vintagepc/MK404/SDCard/Readme.md

 Place gcode files in this folder and run the build_sd utility step in the CMake project to compile an SD card image for your printer!
