vintagepc/MK404/scripts/tests/snaps/parts/GFX3DVis01.png

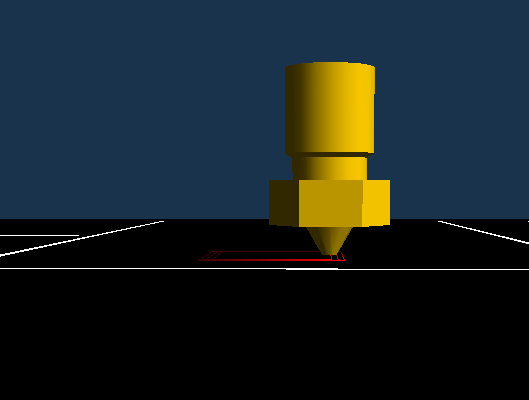
scripts/tests/snaps/parts/GFX3DVis01.png
