vintagepc/MK404/scripts/tests/snaps/parts/GFX3DVis04.png

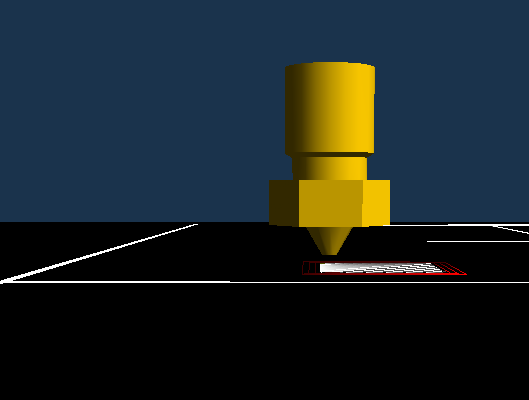
scripts/tests/snaps/parts/GFX3DVis04.png
