vintagepc/MK404/scripts/tests/snaps/parts/LCD01.png

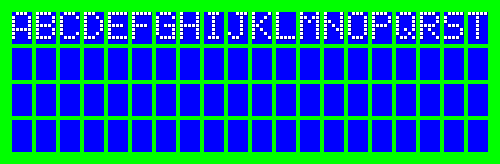
scripts/tests/snaps/parts/LCD01.png
