vintagepc/MK404/scripts/tests/snaps/parts/LCD02.png

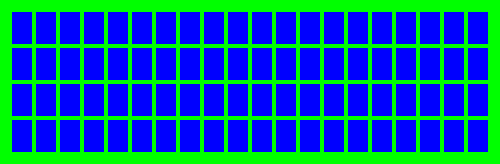
scripts/tests/snaps/parts/LCD02.png
