vintagepc/MK404/scripts/tests/snaps/parts/LCD03.png

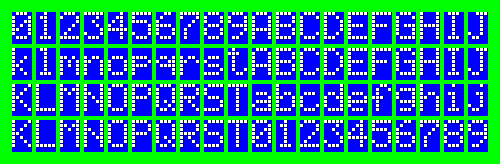
scripts/tests/snaps/parts/LCD03.png
