vintagepc/MK404/scripts/tests/snaps/parts/LCD04.png

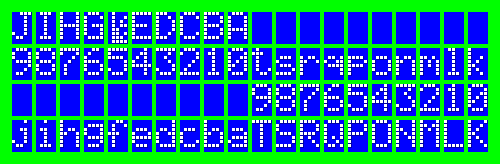
scripts/tests/snaps/parts/LCD04.png
