vintagepc/MK404/assets/Bear/bear21_mk3s_simulator_x-axis.obj

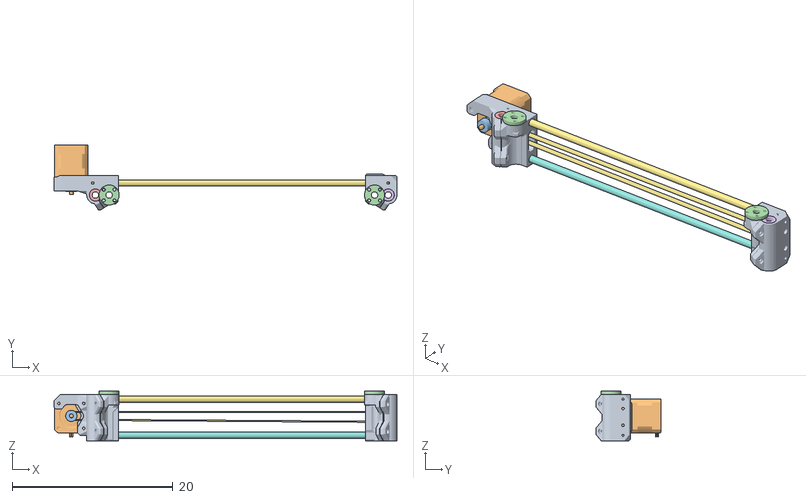
[picture p8: CAD file, 2020-08-02]
assets/Bear/bear21_mk3s_simulator_x-axis.obj
42.6 x 8.14 x 6.20
x_end_motor_mk3s:1
nema17_xye_ldo v1:1
2gt_pulley_16t v1:1
pom_nut v1:1
lm8uu v2:1
lm8uu v2:2
smooth_rod_x_axis v1:5
smooth_rod_x_axis v1:6
x_end_idler:1
x_end_idler_tensioner:1
2gt_idler_20t_6mmbelt v2:1
pom_nut v1:2
lm8uu v2:3
lm8uu v2:4
belt:1
