vintagepc/MK404/assets/CW1/CW1_Lid.obj

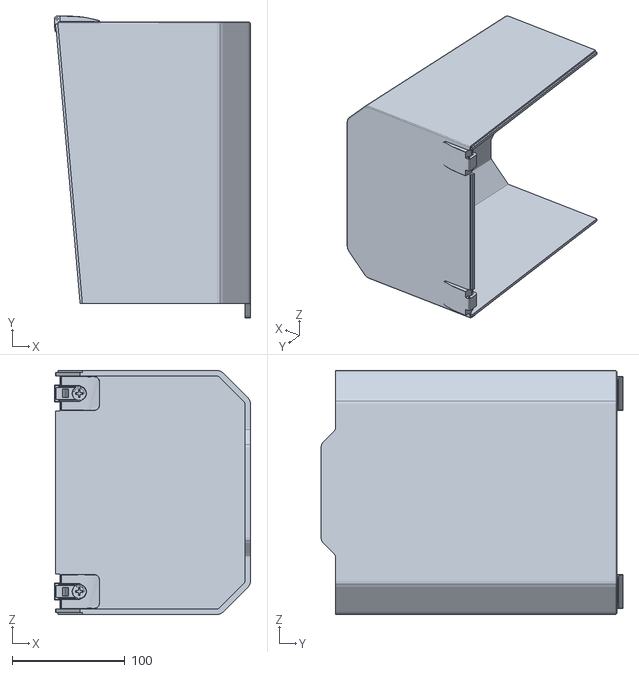
[picture p9: CAD file, 2021-11-05]
assets/CW1/CW1_Lid.obj
174.4 x 268.2 x 217.0
