vintagepc/MK404/assets/MK2/MK2_Y.obj

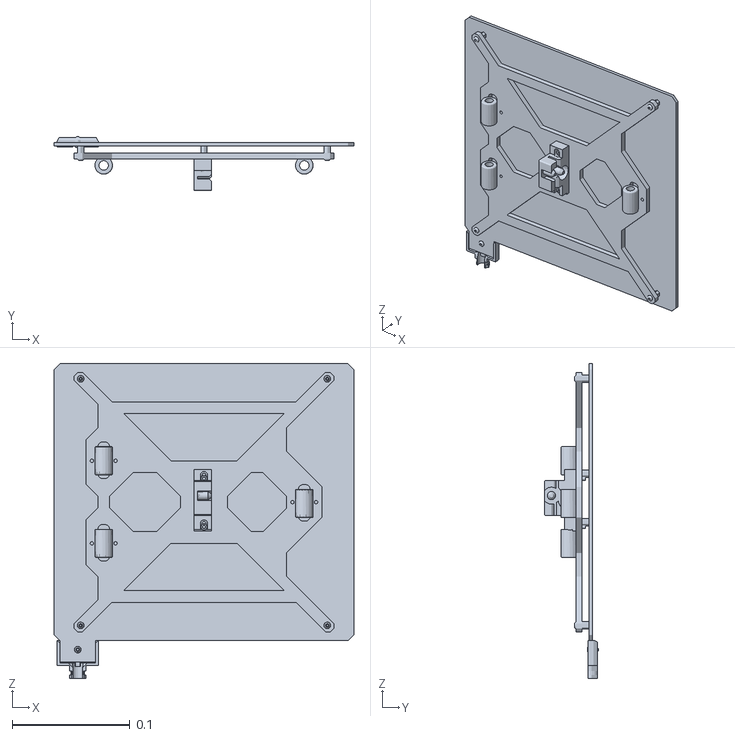
[picture p10: CAD file, 2020-10-29]
assets/MK2/MK2_Y.obj
0.254 x 0.046 x 0.267
