vintagepc/MK404/assets/Stock/Y_AXIS.obj

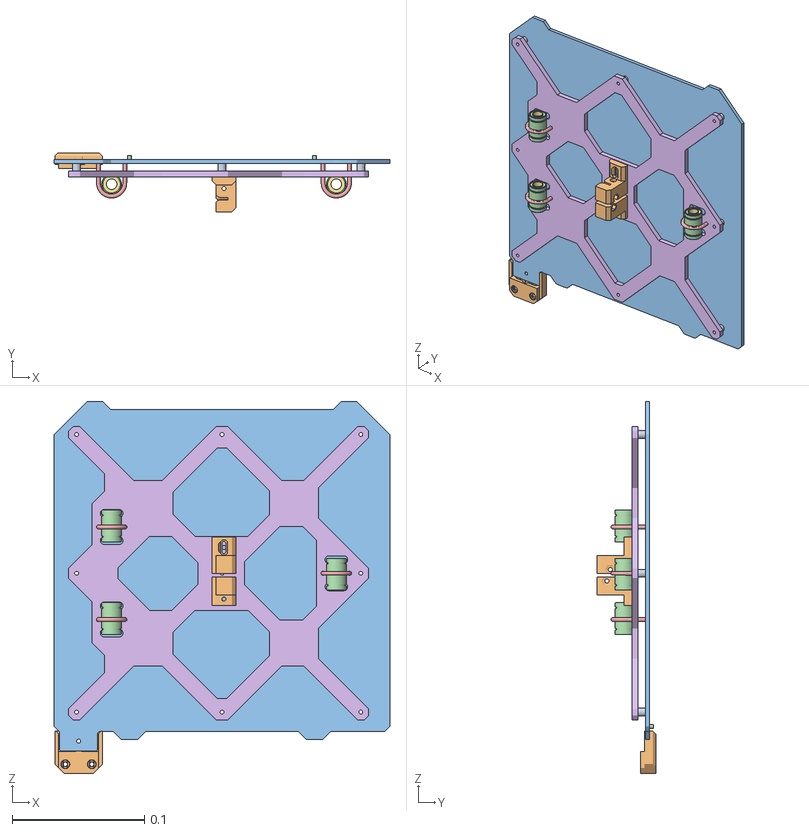
[picture p11: CAD file, 2020-05-23]
assets/Stock/Y_AXIS.obj
0.254 x 0.0443 x 0.281
mesh 1 Headbed Assembly-1/6x6x3t spacer-4
mesh 2 Headbed Assembly-1/6x6x3t spacer-1
mesh 3 Headbed Assembly-1/heatbed-cable-cover top-1
mesh 4 Headbed Assembly-1/6x6x3t spacer-3
mesh 5 Headbed Assembly-1/MK52 Bed-1
mesh 6 Boss-Extrude3
mesh 7 Headbed Assembly-1/6x6x3t spacer-2
