vintagepc/MK404/scripts/tests/snaps/parts/AvgT.ply

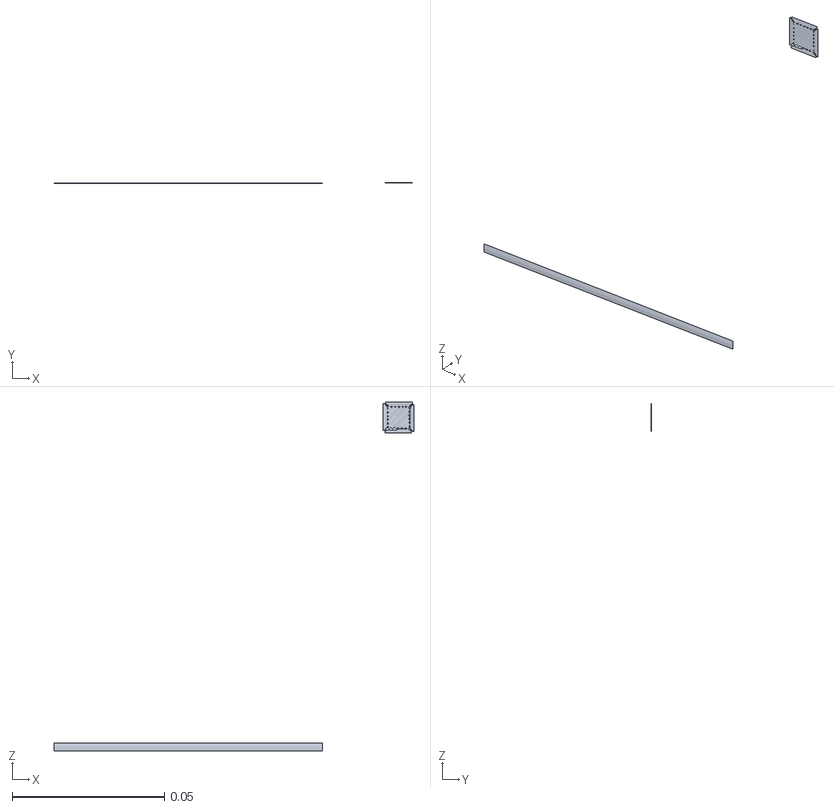
[picture p12: CAD file, 2020-10-20]
scripts/tests/snaps/parts/AvgT.ply
0.118 x 0.00025 x 0.114
