vintagepc/MK404/assets/Bear/bear21_mk3s_simulator_e-axis.obj

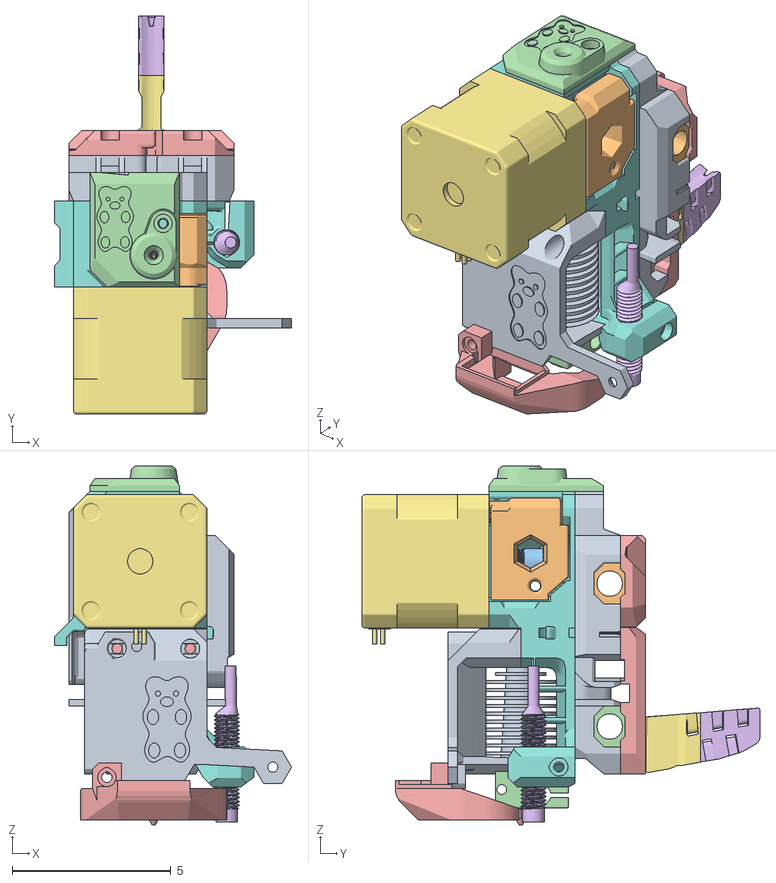
[picture p13: CAD file, 2020-08-02]
assets/Bear/bear21_mk3s_simulator_e-axis.obj
7.46 x 12.5 x 11.3
x_carriage:1
lm8uu v2:1
lm8uu v2:2
lm8uu v2:3
x_carriage_back_mk3s v2:1
cable_guide_back_b:1
cable_guide_back_a:1
sink:1
ptfe:1
break:1
block:1
nozzle:1
Spur Gear11:1
nema17_ldo_cool_power v1:1
hotend_collet_clip v1:1
cover:1
extruder_idler_bondtech:1
Spur Gear21:1
fs_cover v2:2
nozzle_fan_duct:1
pinda v1:2
