vintagepc/MK404/assets/CW1/CW1_RFan.obj

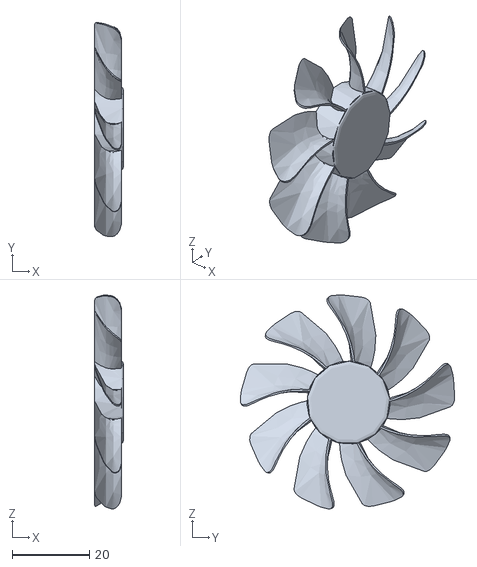
[picture p14: CAD file, 2021-11-05]
assets/CW1/CW1_RFan.obj
7.50 x 55.4 x 55.3
