vintagepc/MK404/assets/MK2/MK2MMU_E.obj

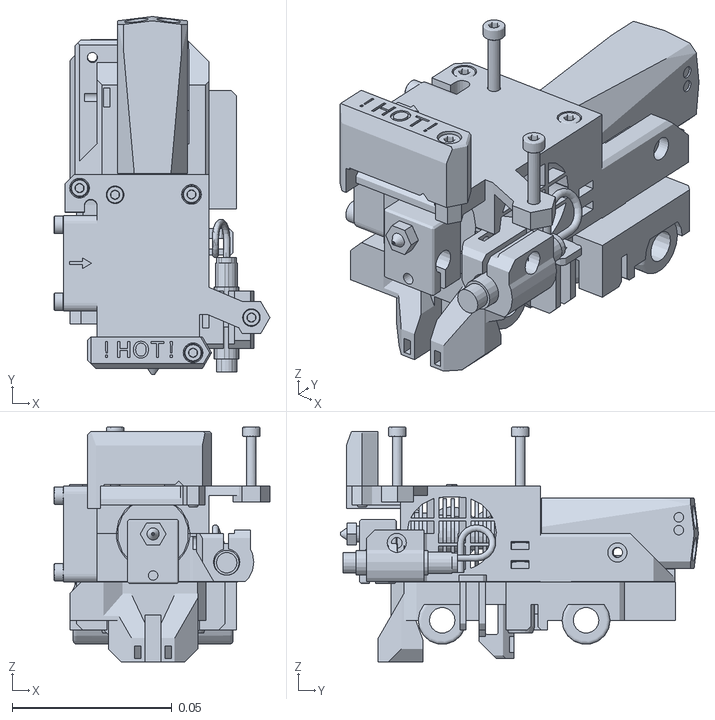
[picture p15: CAD file, 2020-10-29]
assets/MK2/MK2MMU_E.obj
0.0676 x 0.112 x 0.0734
