vintagepc/MK404/assets/Stock/E_STD.obj

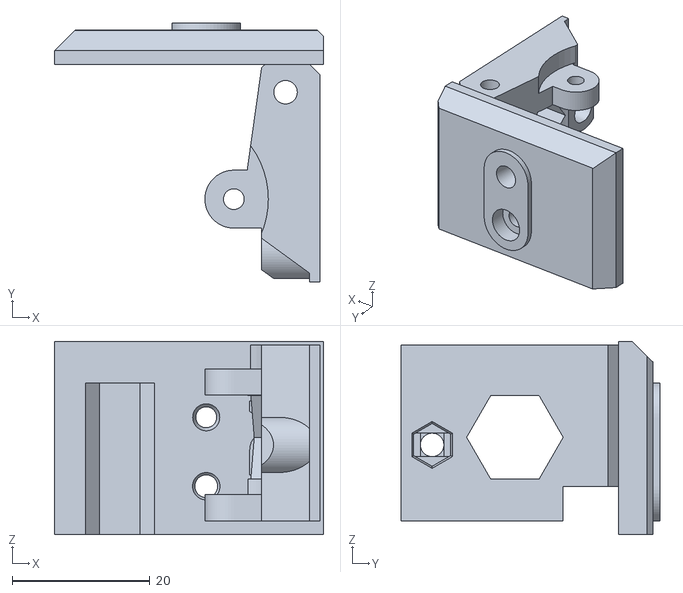
[picture p16: CAD file, 2020-05-23]
assets/Stock/E_STD.obj
39.0 x 37.5 x 28.0
