vintagepc/MK404/scripts/tests/snaps/parts/QuadHR.ply

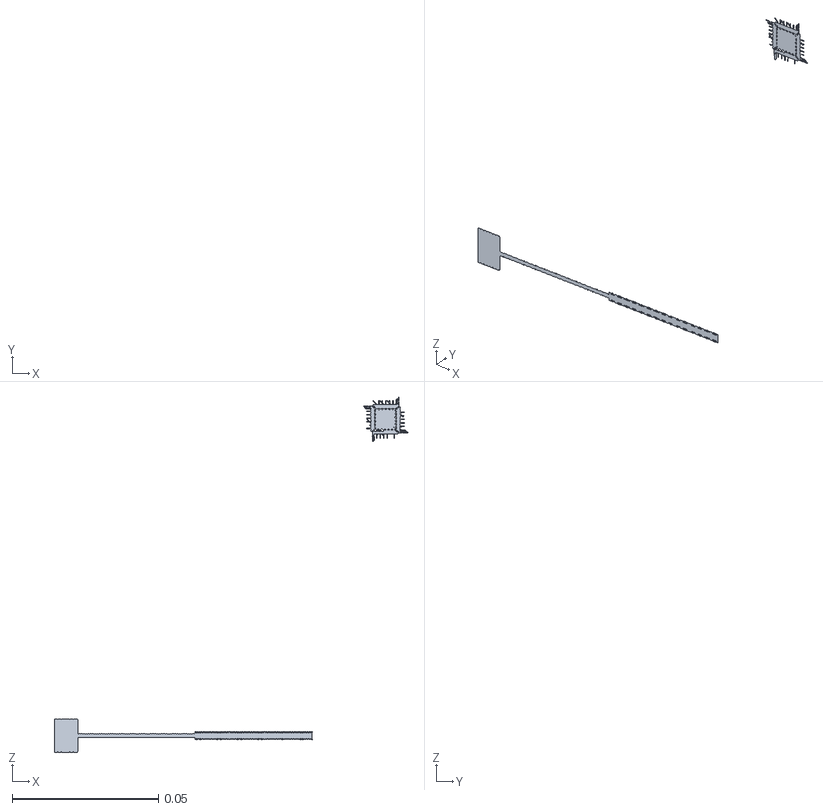
[picture p17: CAD file, 2020-10-20]
scripts/tests/snaps/parts/QuadHR.ply
0.121 x 5e-05 x 0.121
