vintagepc/MK404/assets/Bear/bear21_mk3s_simulator_lcd_knob.obj

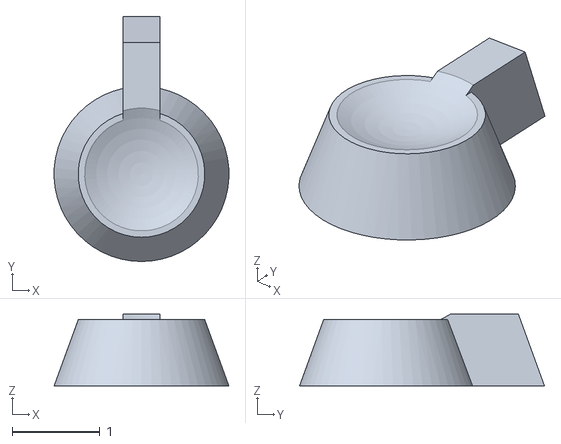
[picture p18: CAD file, 2020-08-02]
assets/Bear/bear21_mk3s_simulator_lcd_knob.obj
2.00 x 2.80 x 0.82
