vintagepc/MK404/assets/CW1/CW1_Tank.obj

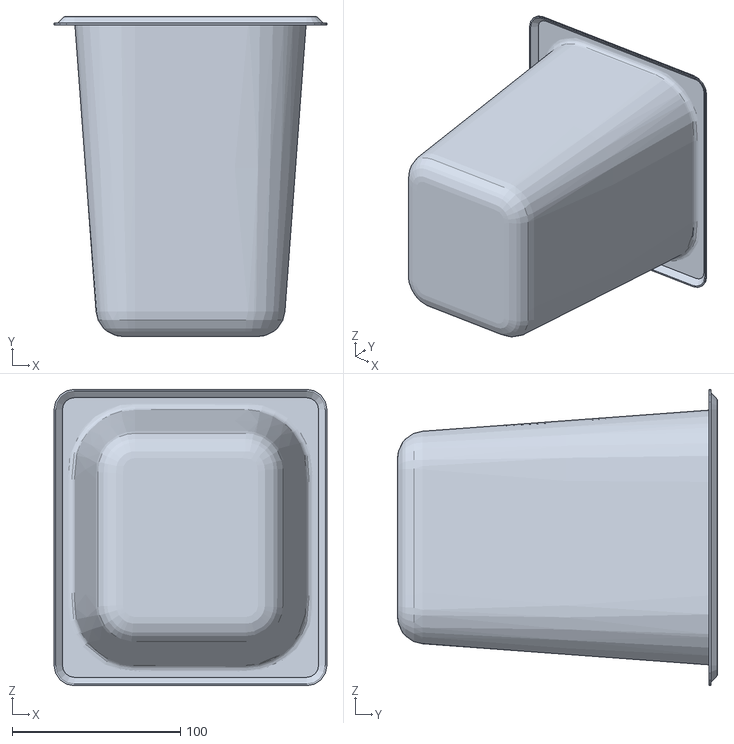
[picture p19: CAD file, 2021-11-05]
assets/CW1/CW1_Tank.obj
162.0 x 190.0 x 176.0
