vintagepc/MK404/assets/MK2/MK2_EFan.obj

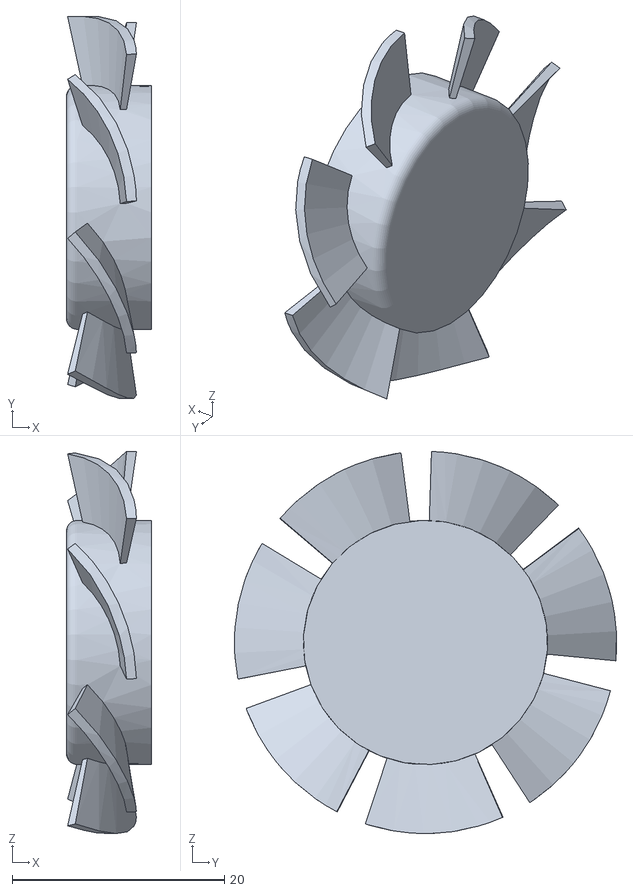
[picture p20: CAD file, 2020-10-29]
assets/MK2/MK2_EFan.obj
8.00 x 36.0 x 36.0
