vintagepc/MK404/assets/Stock/Triangles.obj

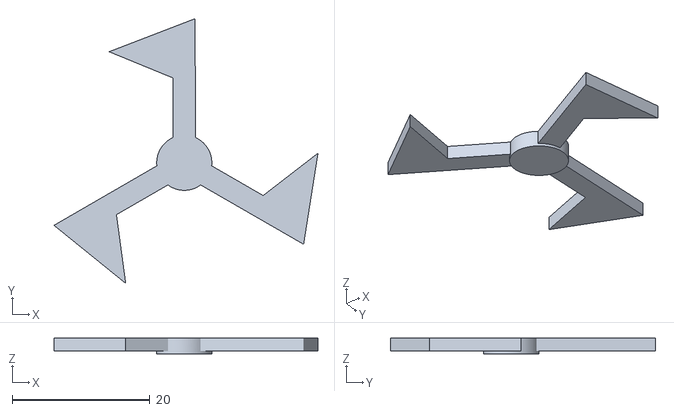
[picture p21: CAD file, 2020-05-23]
assets/Stock/Triangles.obj
38.3 x 38.4 x 2.30
