vintagepc/MK404/assets/MK2/MK2_Base.obj

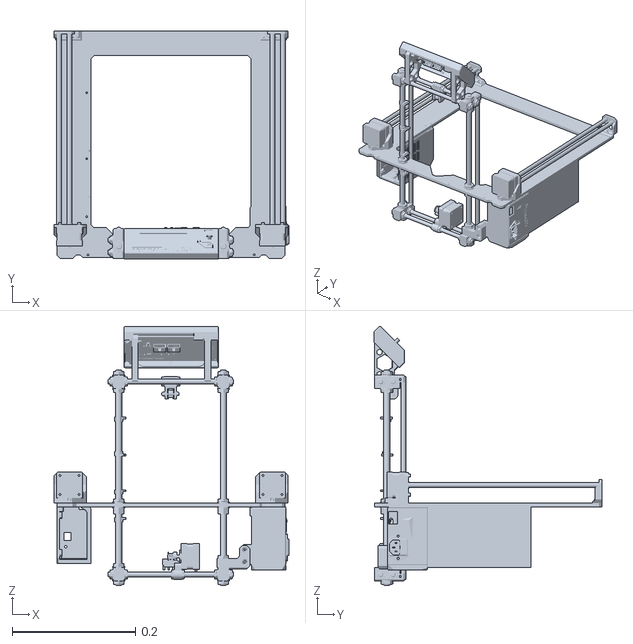
[picture p23: CAD file, 2020-10-29]
assets/MK2/MK2_Base.obj
0.382 x 0.371 x 0.421
