vintagepc/MK404/assets/Stock/SDCard.obj

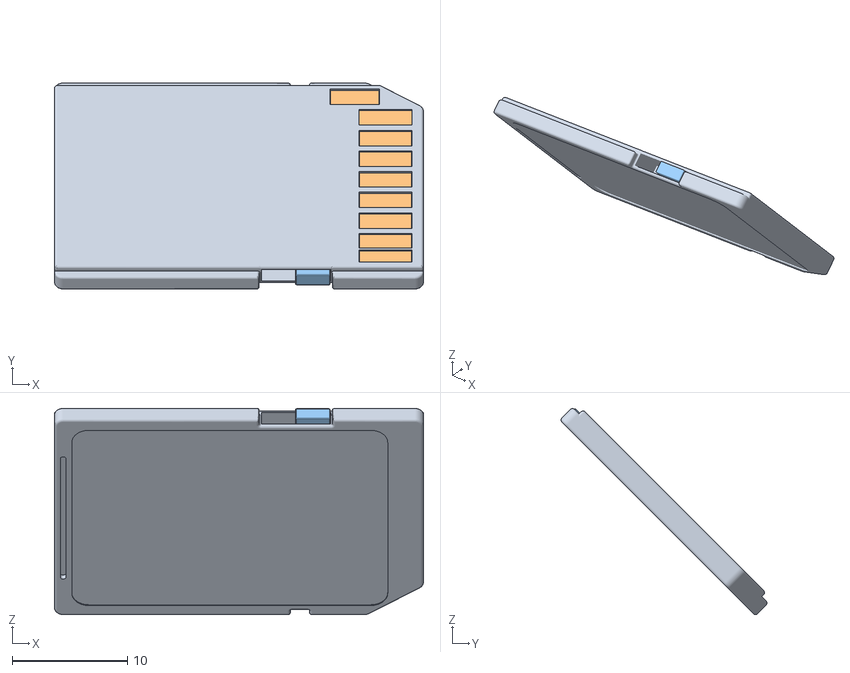
[picture p24: CAD file, 2020-05-23]
assets/Stock/SDCard.obj
32.0 x 17.9 x 17.9
patch0
patch1
patch2
