vintagepc/MK404/assets/Bear/bear21_mk3s_simulator_hotend-fan-blade.obj

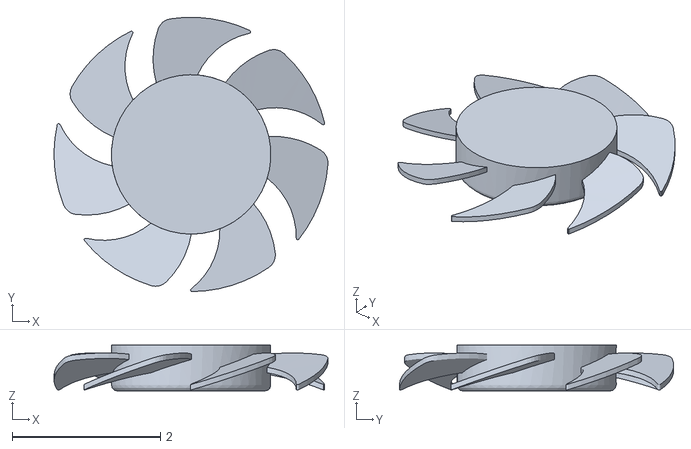
[picture p25: CAD file, 2020-08-02]
assets/Bear/bear21_mk3s_simulator_hotend-fan-blade.obj
3.70 x 3.70 x 0.62
