vintagepc/MK404/assets/CW1/CW1_LEDs.obj

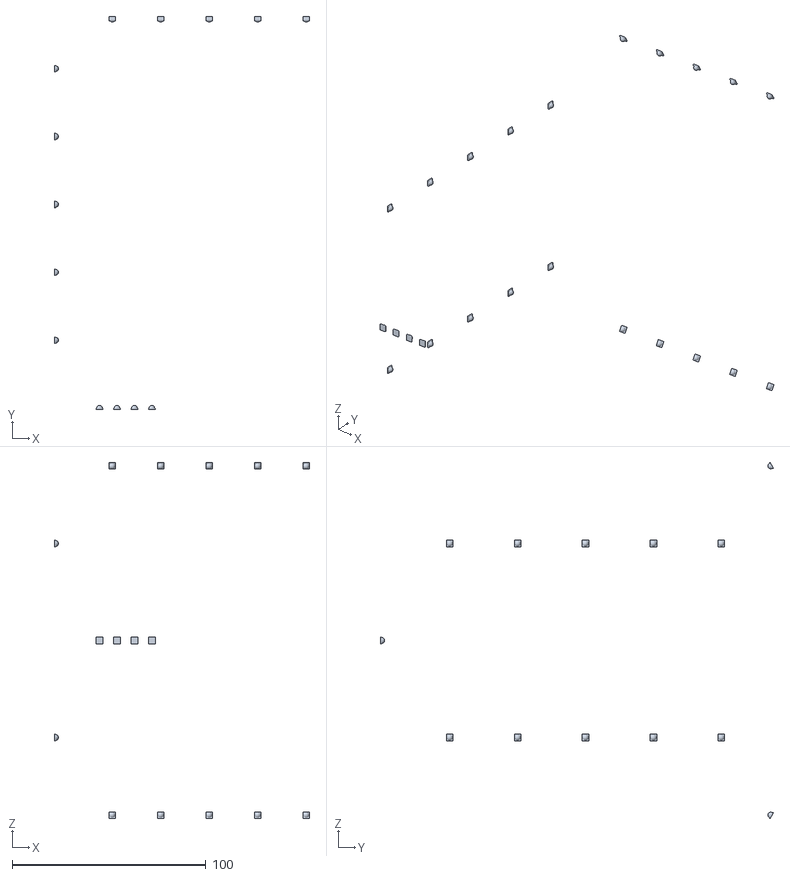
[picture p26: CAD file, 2021-11-05]
assets/CW1/CW1_LEDs.obj
131.6 x 202.6 x 183.5
