vintagepc/MK404/assets/MK2/MK2_E.obj

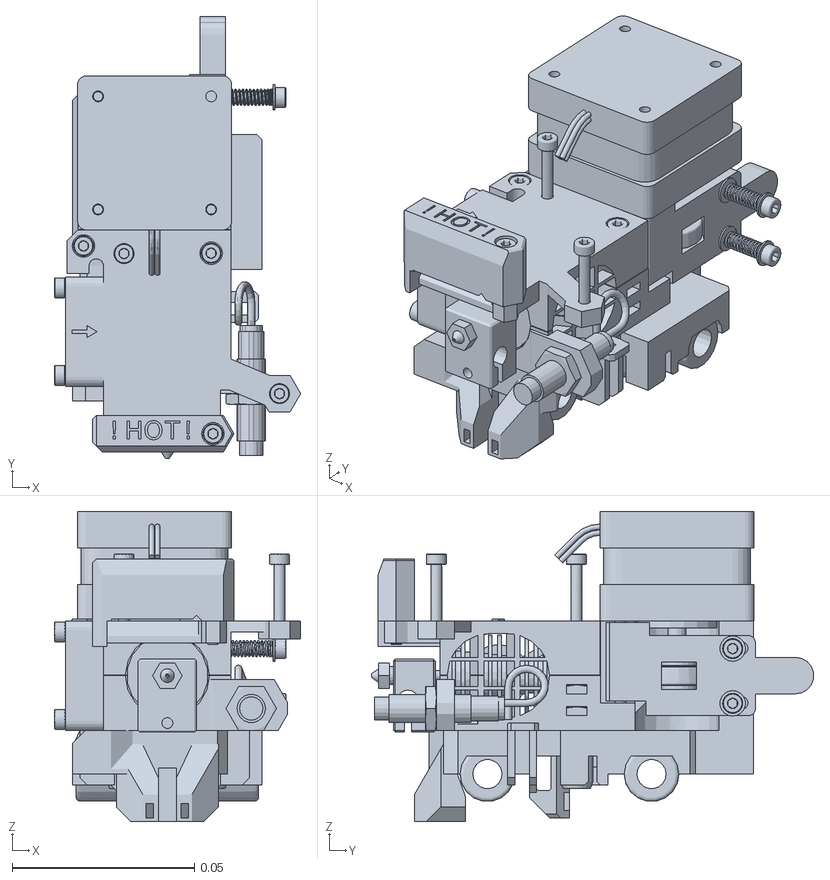
[picture p27: CAD file, 2020-10-29]
assets/MK2/MK2_E.obj
0.0676 x 0.121 x 0.085
