vintagepc/MK404/assets/Stock/Print-fan_rotor.obj

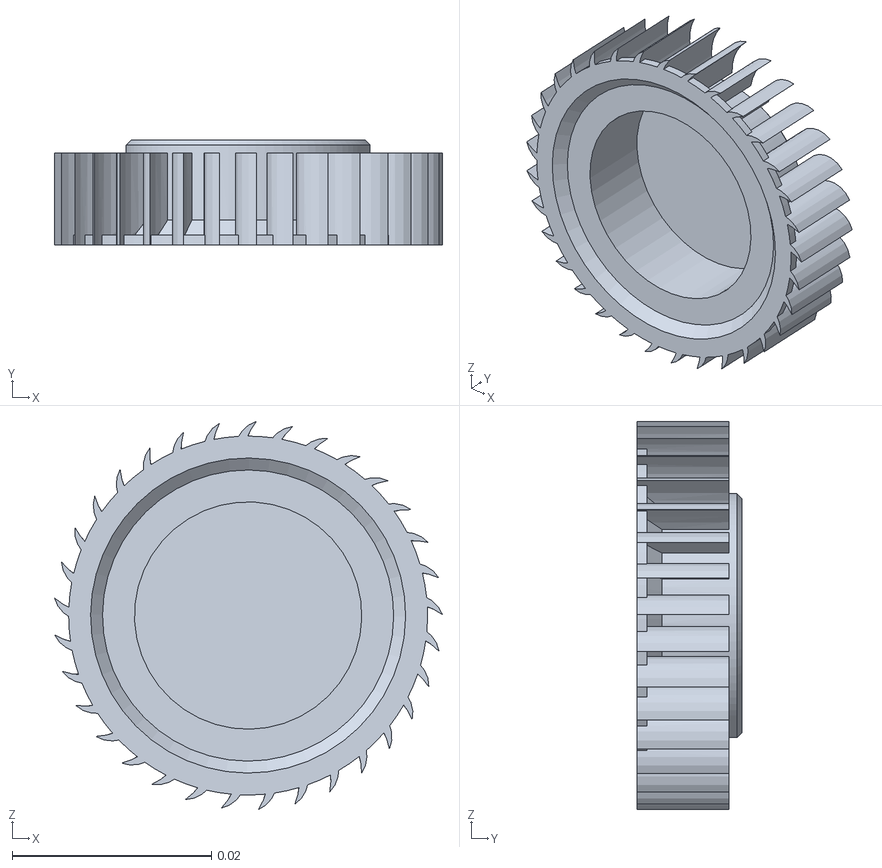
[picture p28: CAD file, 2020-05-23]
assets/Stock/Print-fan_rotor.obj
0.0389 x 0.0105 x 0.039
