vintagepc/MK404/assets/Bear/bear21_mk3s_simulator_y-axis.obj

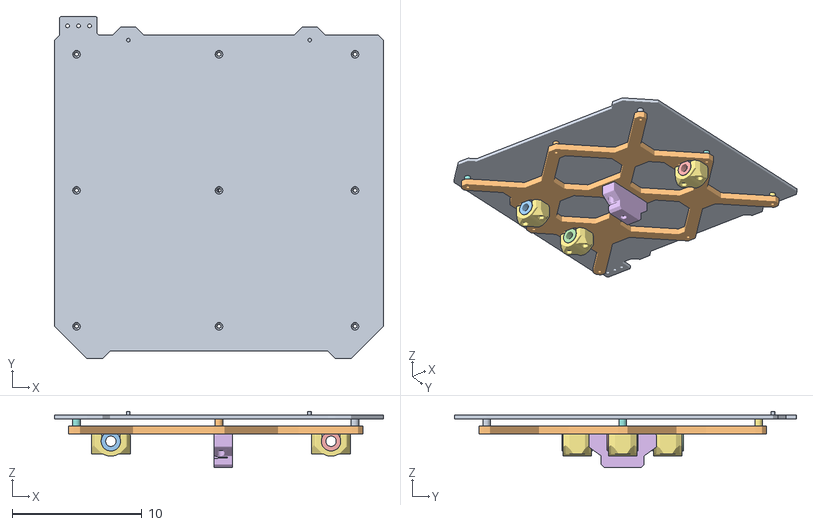
[picture p29: CAD file, 2020-08-02]
assets/Bear/bear21_mk3s_simulator_y-axis.obj
25.4 x 26.4 x 4.35
heatbed_mk52_24v v1:1
y_carriage_mk3 v2:1
lm8uu v2:1
lm8uu v2:2
lm8uu v2:3
y_belt_holder:1
y_bearing_holder:1
bed_standoff_mk3 v1:1
bed_standoff_mk3 v1:2
bed_standoff_mk3 v1:3
bed_standoff_mk3 v1:4
bed_standoff_mk3 v1:5
bed_standoff_mk3 v1:6
bed_standoff_mk3 v1:7
bed_standoff_mk3 v1:8
bed_standoff_mk3 v1:9
