vintagepc/MK404/assets/CW1/CW1S_Platform.obj

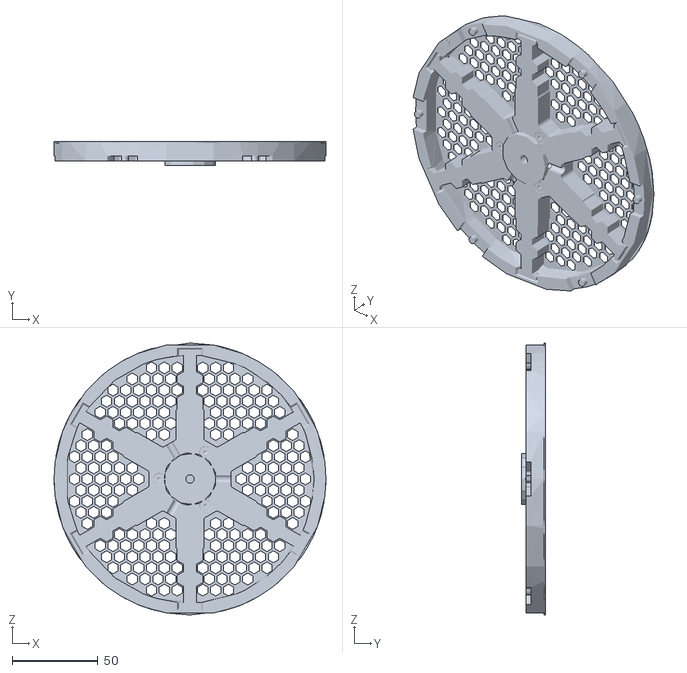
[picture p30: CAD file, 2021-11-05]
assets/CW1/CW1S_Platform.obj
159.0 x 14.0 x 159.0
