vintagepc/MK404/assets/MK2/MK2MMU_Base.obj

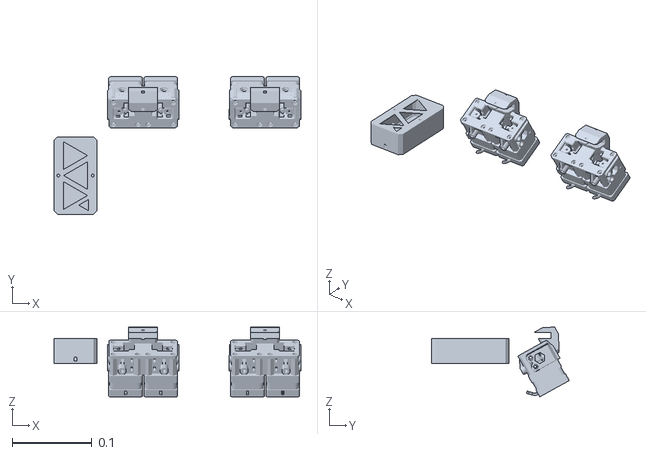
[picture p31: CAD file, 2020-10-29]
assets/MK2/MK2MMU_Base.obj
0.309 x 0.172 x 0.0873
