vintagepc/MK404/assets/Stock/E_MMU.obj

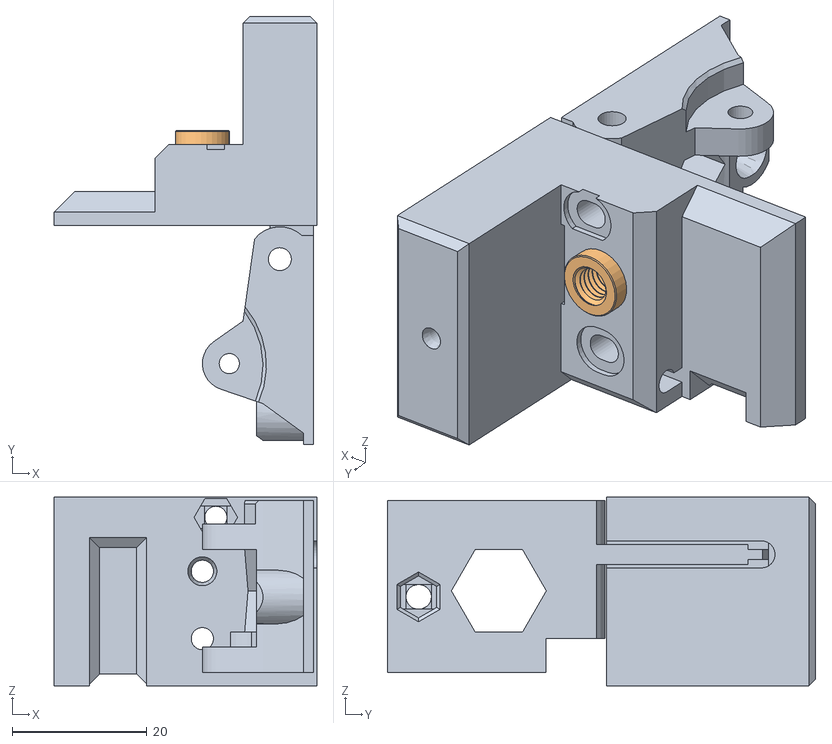
[picture p32: CAD file, 2020-05-23]
assets/Stock/E_MMU.obj
39.0 x 63.5 x 28.0
patch0
patch1
