vintagepc/MK404/assets/Bear/bear21_mk3s_simulator_print_fan.obj

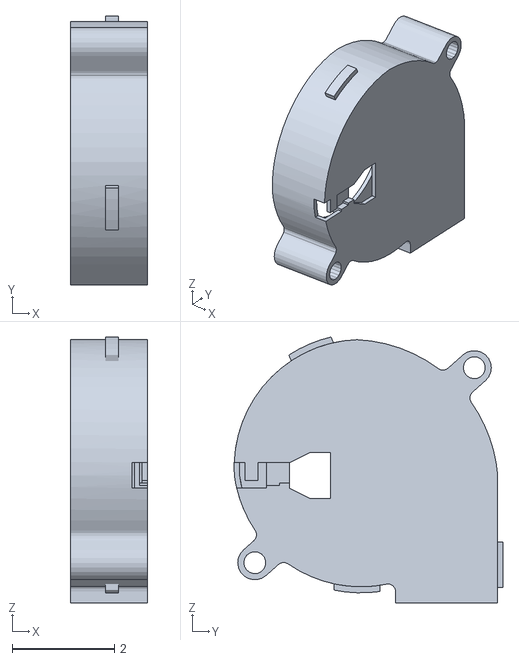
[picture p33: CAD file, 2020-08-02]
assets/Bear/bear21_mk3s_simulator_print_fan.obj
1.50 x 5.26 x 5.21
