vintagepc/MK404/assets/CW1/CW1_Knob.obj

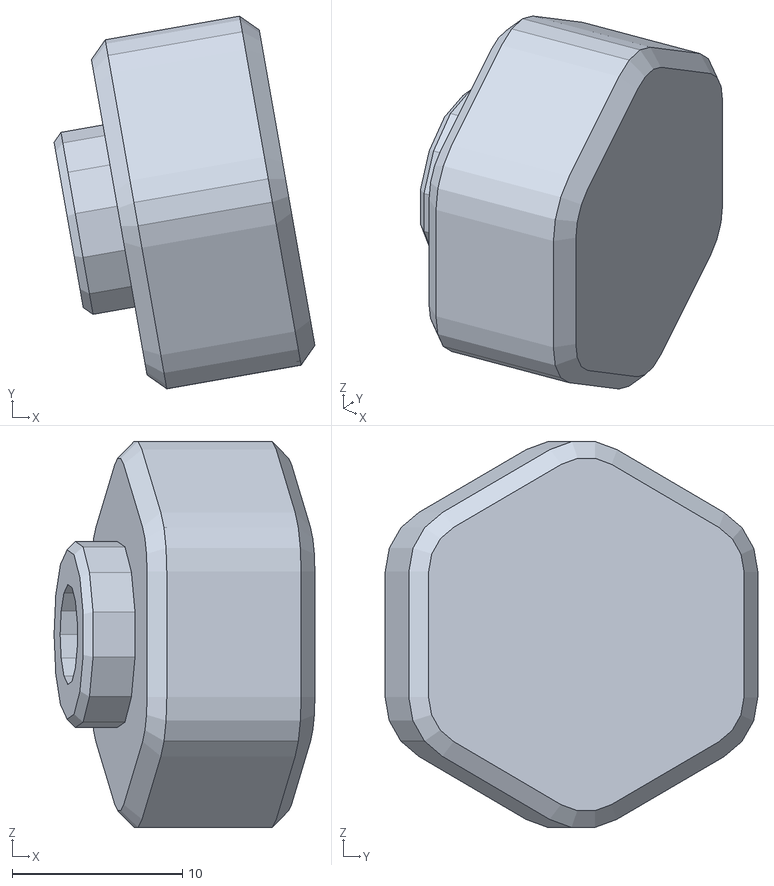
[picture p34: CAD file, 2021-11-05]
assets/CW1/CW1_Knob.obj
15.3 x 21.9 x 22.6
