vintagepc/MK404/assets/MK2/MK2_Z.obj

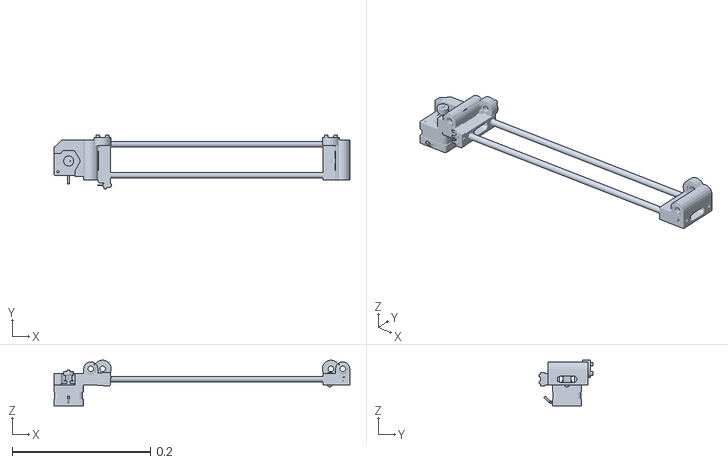
[picture p35: CAD file, 2020-10-29]
assets/MK2/MK2_Z.obj
0.428 x 0.0774 x 0.0661
