vintagepc/MK404/assets/Stock/LCD-knobR2.obj

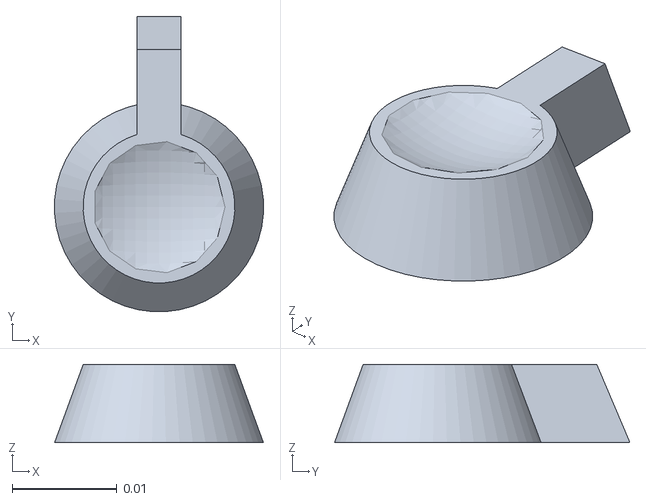
[picture p36: CAD file, 2020-05-23]
assets/Stock/LCD-knobR2.obj
0.02 x 0.0282 x 0.0075
