vintagepc/MK404/assets/Bear/bear21_mk3s_simulator_frame.obj

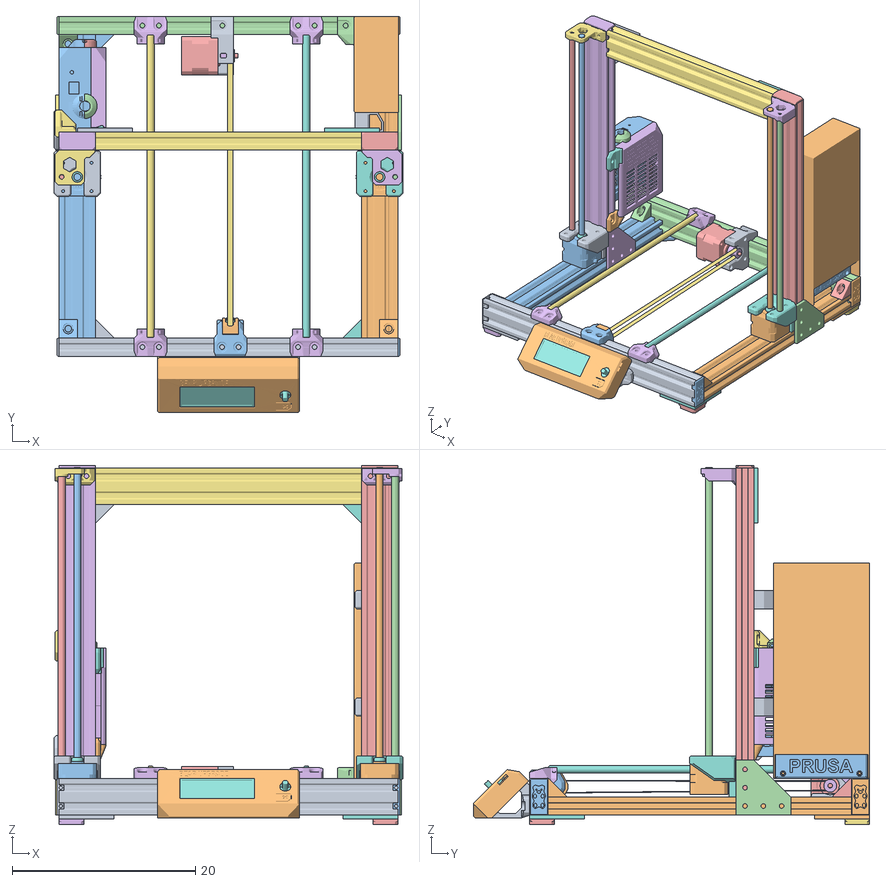
[picture p37: CAD file, 2020-08-02]
assets/Bear/bear21_mk3s_simulator_frame.obj
38.1 x 43.2 x 39.2
vslot_front_rear v2:1
vslot_y v2:1
vslot_y v2:2
vslot_front_rear v2:2
vslot_z v2:1
vslot_z v2:2
vslot_z_top v2:1
Joining Plate 90 Degree v2:1
Joining Plate 90 Degree v2:2
Joining Plate 90 Degree v2:3
Joining Plate 90 Degree v2:4
Joining Plate 90 Degree v2:5
Joining Plate 90 Degree v2:6
Joining Plate 90 Degree v2:7
Joining Plate 90 Degree v2:8
Joining Plate 90 Degree v2:9
Joining Plate 90 Degree v2:10
Black Angle Corner Connector v2:1
Black Angle Corner Connector v2:2
Black Angle Corner Connector v2:3
Black Angle Corner Connector v2:4
y_rod_holder:1
y_rod v1:1
y_rod v1:2
y_motor_mount:1
y_idler_tensioner:1
y_idler_mount:1
2gt_idler_20t_6mmbelt v2:1
nema17_ldo_xye v1:1
2gt_pulley_16t_6mmbelt v1:1
y_belt:1
z_motor_mount:1
z_motor_mount(Mirror) (1):1
nema17_ldo_z v1:1
nema17_ldo_z v1:2
z_rod v1:1
z_rod v1:2
z_top v1:1
z_top v1(Mirror):1
z_leadscrew_cap:1
rambo_base_lower_mount:1
rambo_hinge_lower:1
einsy-base v7:1
Extruder-cable-clip v2:1
Heatbed-cable-clip v2:1
rambo_door_mk3 v1:1
rambo_base_upper_mount:1
rambo_hinge_upper:1
psu_upper_mount_black:1
psu_mk3s_delta v1:1
psu-cover-DELTA v1:1
psu_lower_mount_black:1
foot v1:1
foot v1:2
foot v1:3
foot v1:4
y_end_cap v1:1
y_end_cap v1:2
end_cap v1(Mirror):1
end_cap v1(Mirror) (1):1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
