vintagepc/MK404/assets/Stock/SSSheet.obj

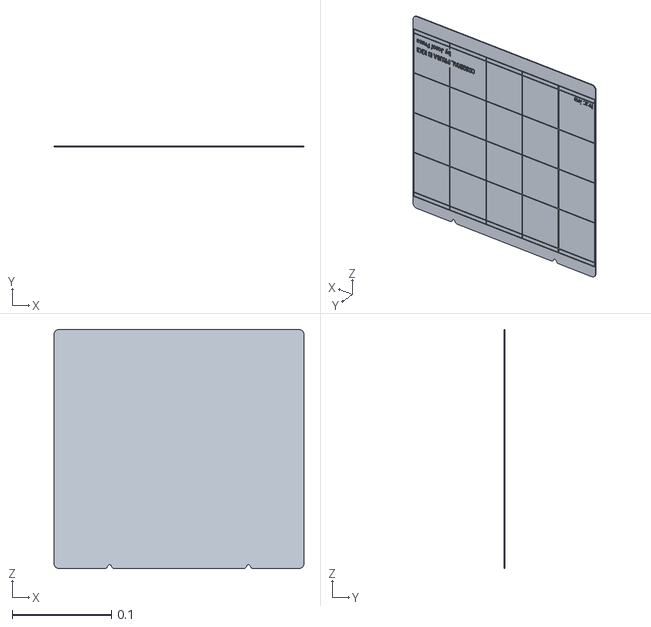
[picture p38: CAD file, 2020-05-23]
assets/Stock/SSSheet.obj
0.252 x 0.00101 x 0.241
mesh 1 SS Sheet
mesh 2 Boss-Extrude2
