vintagepc/MK404/(list of files, cad)

Other CAD files:
assets/CW1/CW1_HFan.obj
assets/Stock/E_Fan.obj
