vintagepc/MK404/scripts/test_E_maxtemp.txt

# This script tests the MAXTEMP error if a thermistor is shorted.
ScriptHost::SetQuitOnTimeout(1)
Board::WaitMs(5000)
ScriptHost::SetTimeoutMs(2000)
Thermistor::Short()
LCD::WaitForText(MAXTEMP,3)
Board::Quit()
