vintagepc/MK404/scripts/tests/snaps/ext1/CW1_cure.png

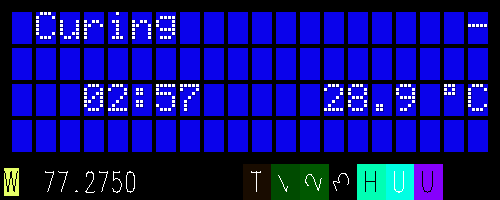
scripts/tests/snaps/ext1/CW1_cure.png
