vintagepc/MK404/scripts/tests/snaps/ext1/CW1_down.png

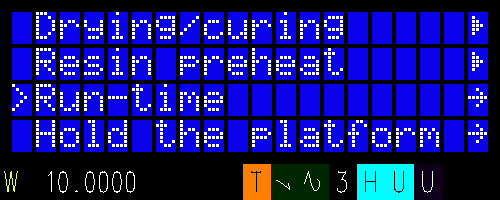
scripts/tests/snaps/ext1/CW1_down.png
