vintagepc/MK404/scripts/tests/snaps/ext1/CW1_full_led.png

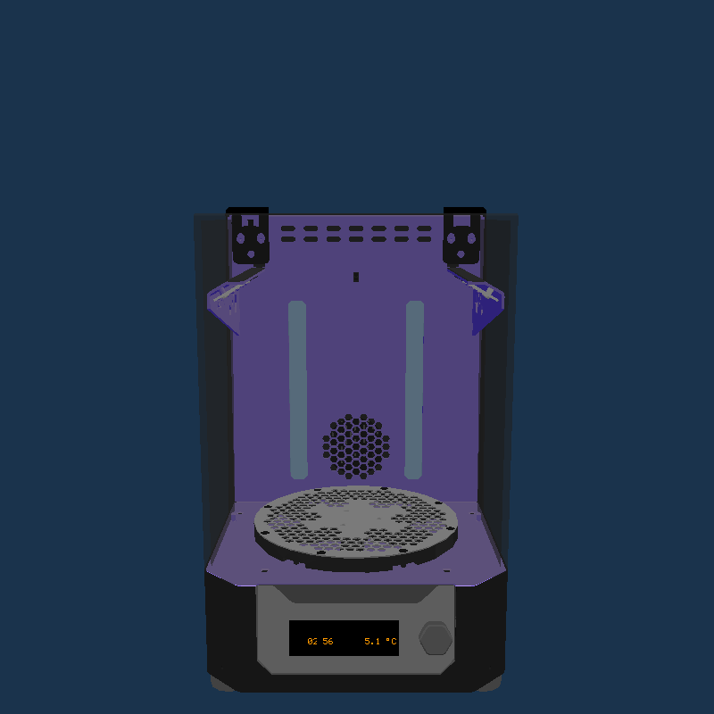
scripts/tests/snaps/ext1/CW1_full_led.png
