vintagepc/MK404/scripts/tests/snaps/ext1/CW1_full_start.png

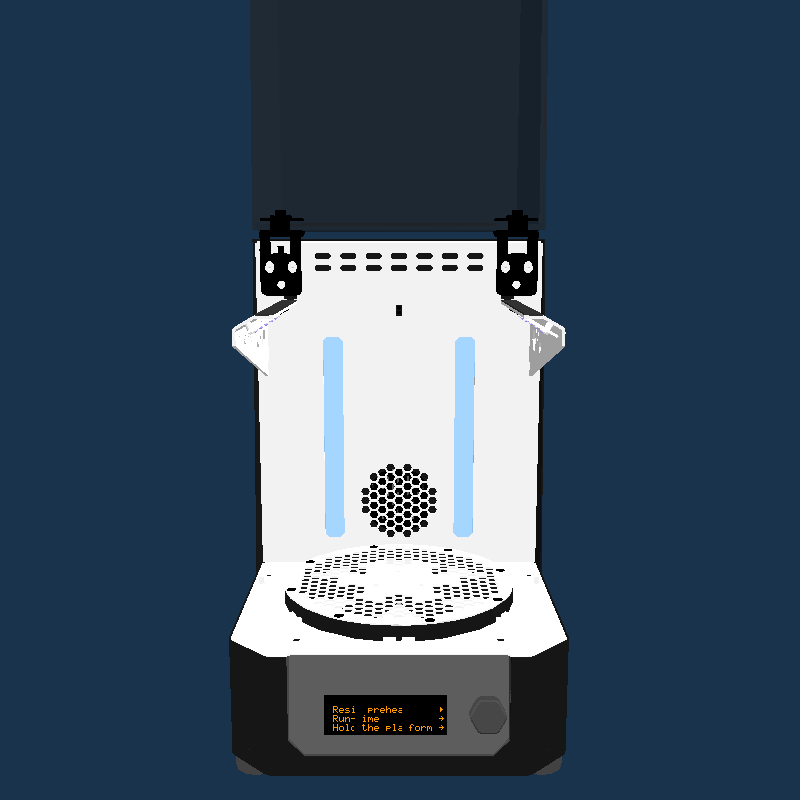
scripts/tests/snaps/ext1/CW1_full_start.png
