vintagepc/MK404/scripts/tests/snaps/ext1/CW1_lid.png

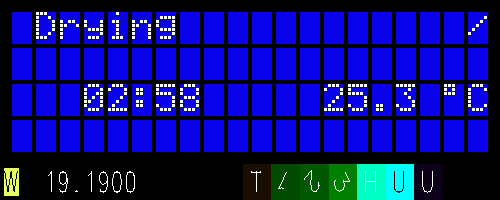
scripts/tests/snaps/ext1/CW1_lid.png
