vintagepc/MK404/scripts/tests/snaps/ext1/CW1_lite_knob1.png

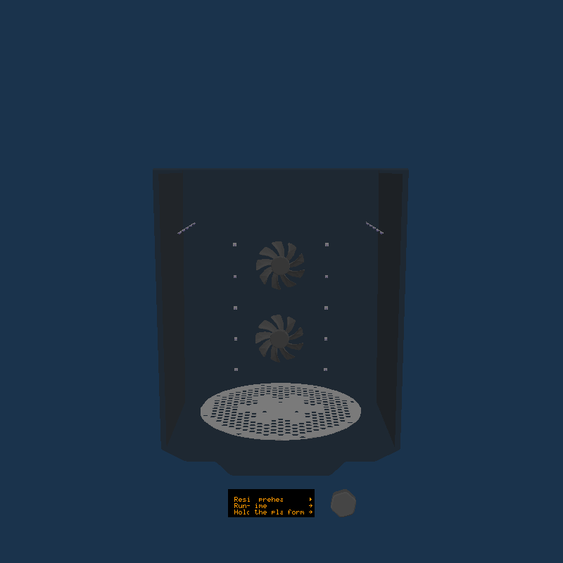
scripts/tests/snaps/ext1/CW1_lite_knob1.png
