vintagepc/MK404/scripts/tests/snaps/ext1/CW1_press.png

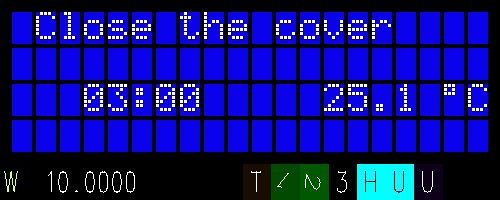
scripts/tests/snaps/ext1/CW1_press.png
