vintagepc/MK404/scripts/tests/snaps/ext1/CW1S_mouseup.png

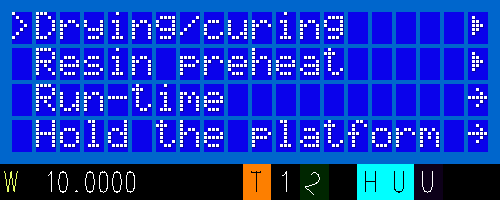
scripts/tests/snaps/ext1/CW1S_mouseup.png
