vintagepc/MK404/scripts/tests/snaps/ext1/GFXBear01.png

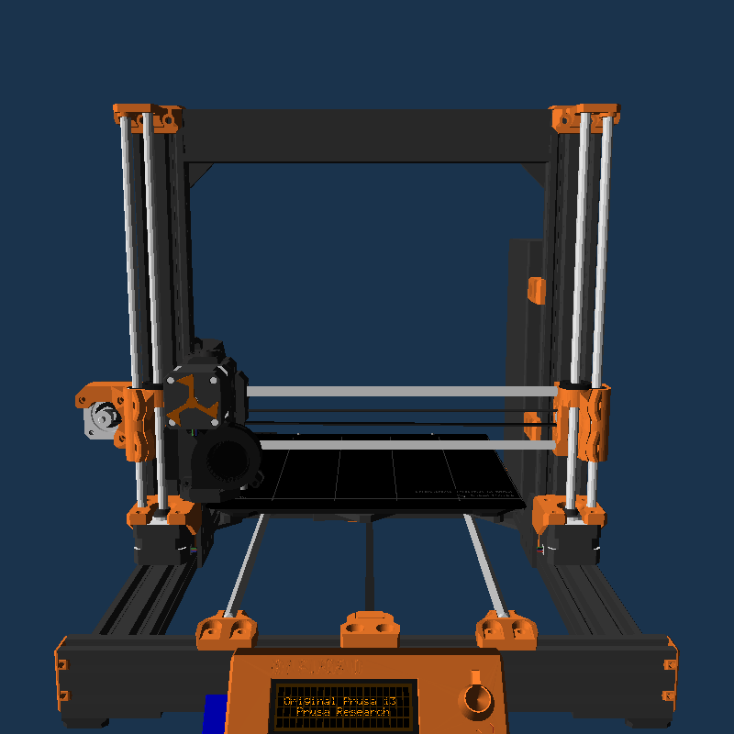
scripts/tests/snaps/ext1/GFXBear01.png
