vintagepc/MK404/scripts/tests/snaps/ext1/GFXBear02.png

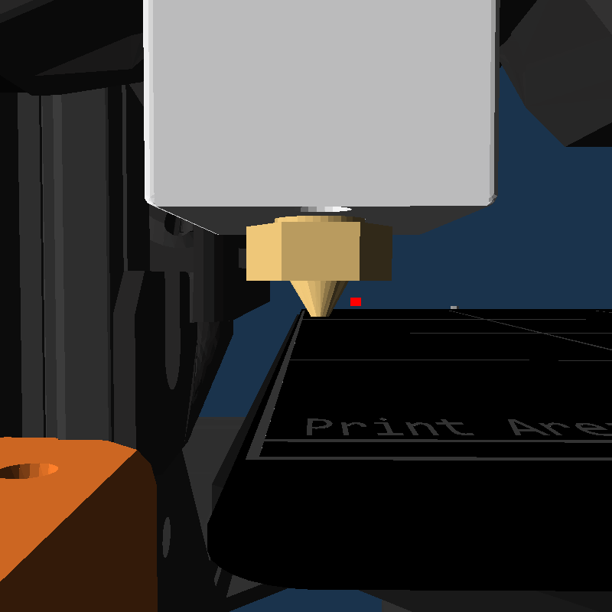
scripts/tests/snaps/ext1/GFXBear02.png
