vintagepc/MK404/scripts/tests/snaps/ext1/GFXFancy01.png

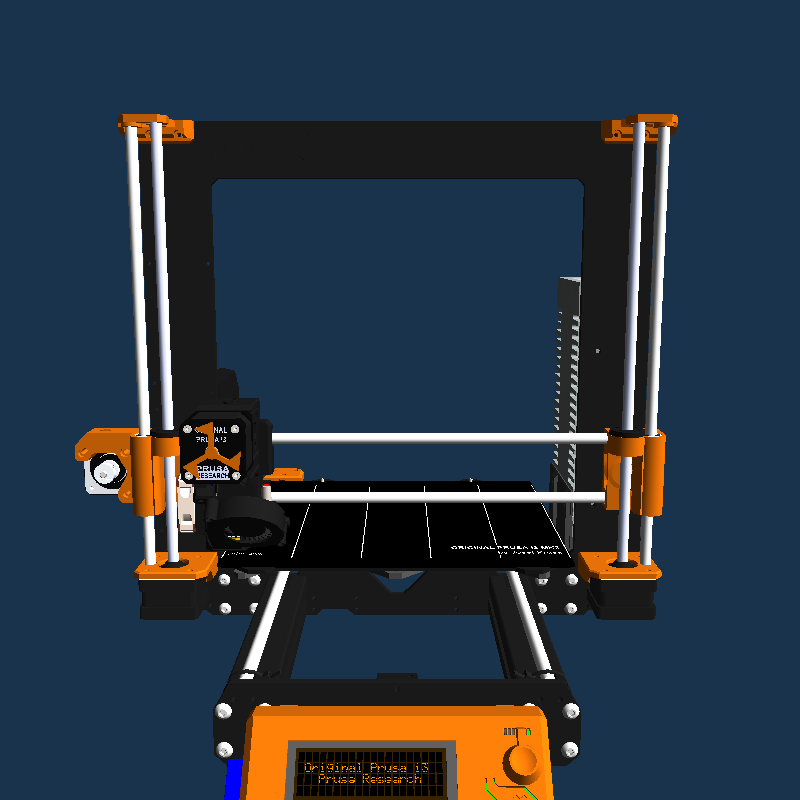
scripts/tests/snaps/ext1/GFXFancy01.png
