vintagepc/MK404/scripts/tests/snaps/ext1/GFXFancy03.png

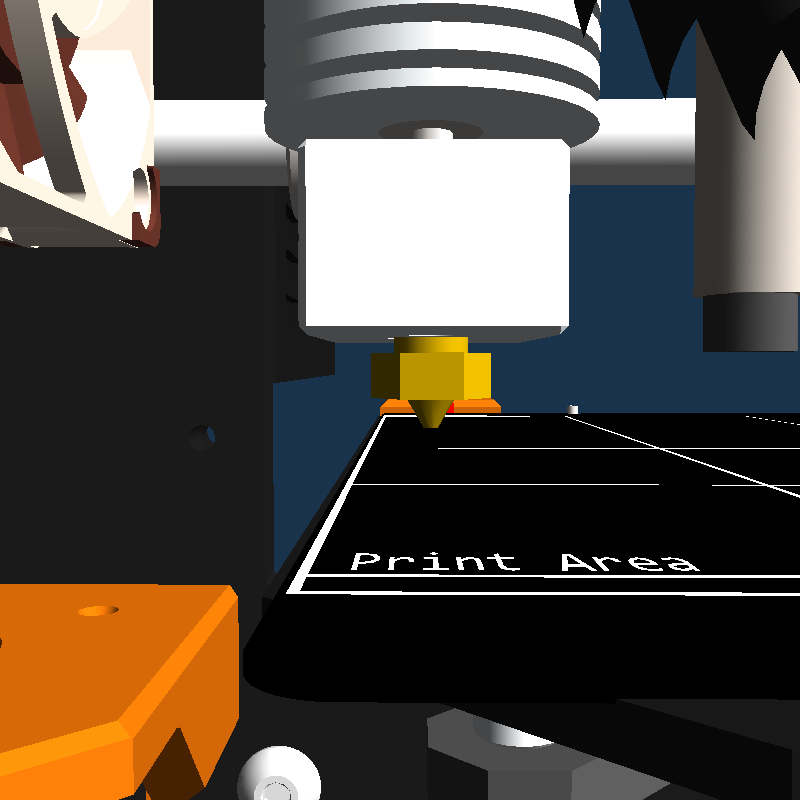
scripts/tests/snaps/ext1/GFXFancy03.png
