vintagepc/MK404/scripts/tests/snaps/ext1/GFXLite01.png

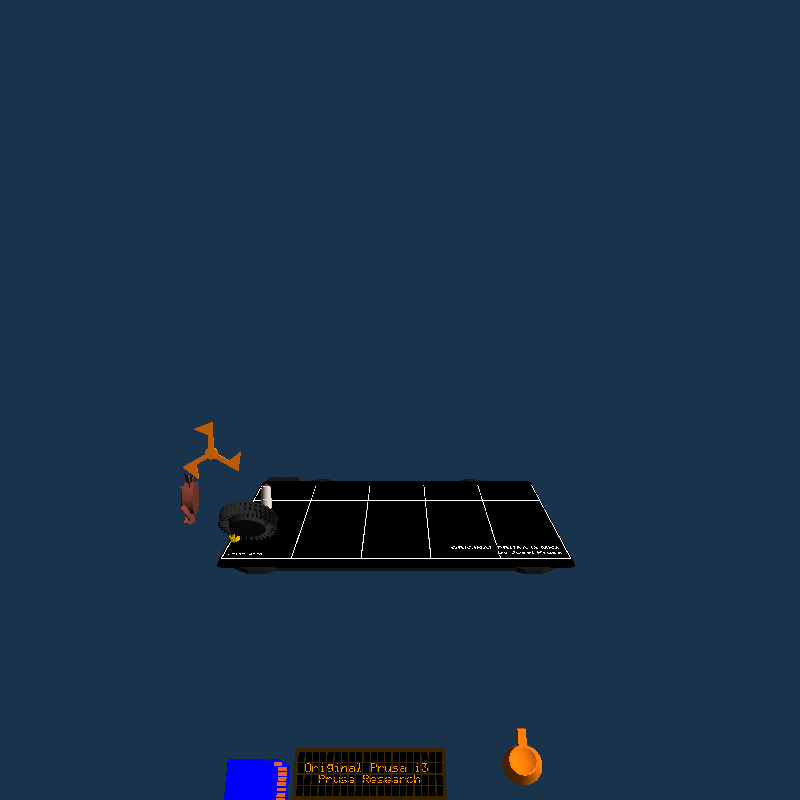
scripts/tests/snaps/ext1/GFXLite01.png
