vintagepc/MK404/scripts/tests/snaps/ext1/GFXLite03.png

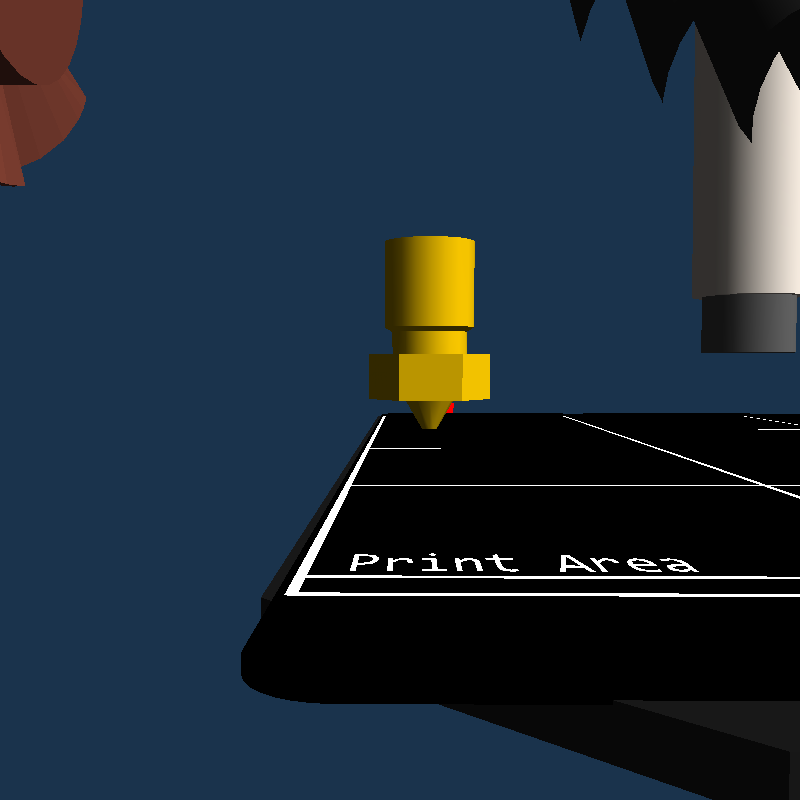
scripts/tests/snaps/ext1/GFXLite03.png
