vintagepc/MK404/scripts/tests/snaps/ext1/GFXLiteKey06.png

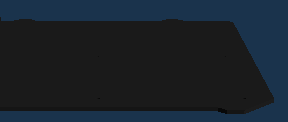
scripts/tests/snaps/ext1/GFXLiteKey06.png
