vintagepc/MK404/scripts/tests/snaps/ext1/GFXLiteKey08a.png

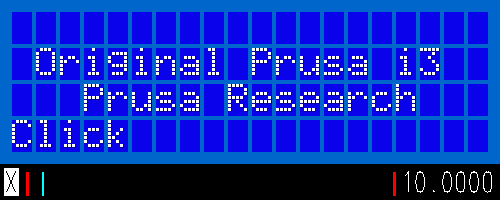
scripts/tests/snaps/ext1/GFXLiteKey08a.png
