vintagepc/MK404/scripts/tests/snaps/ext1/GFXLiteMouseCamOrb.png

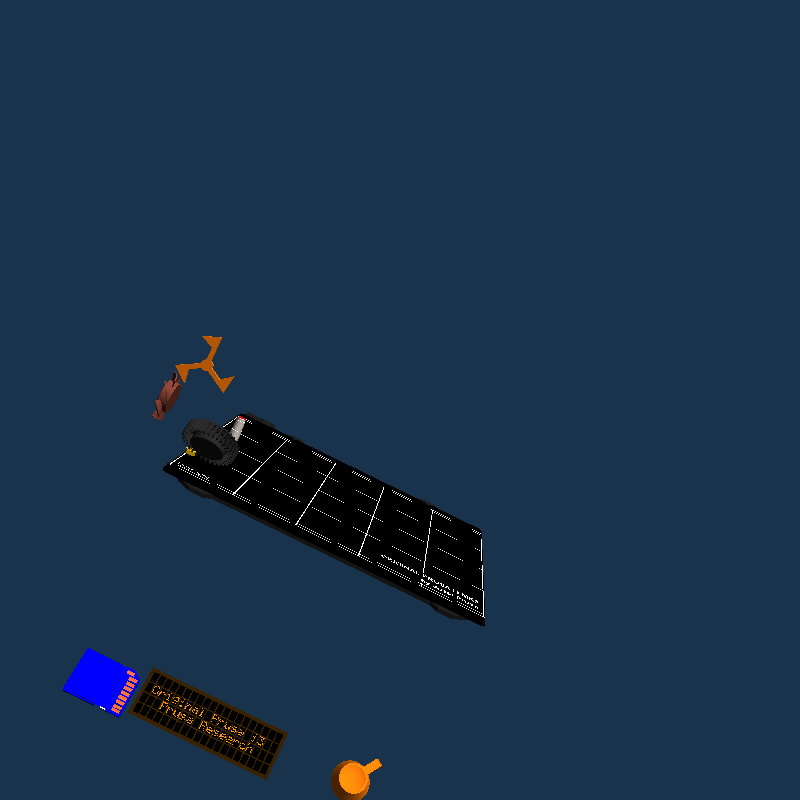
scripts/tests/snaps/ext1/GFXLiteMouseCamOrb.png
