vintagepc/MK404/scripts/tests/snaps/ext1/GFXLiteMouseCamPan.png

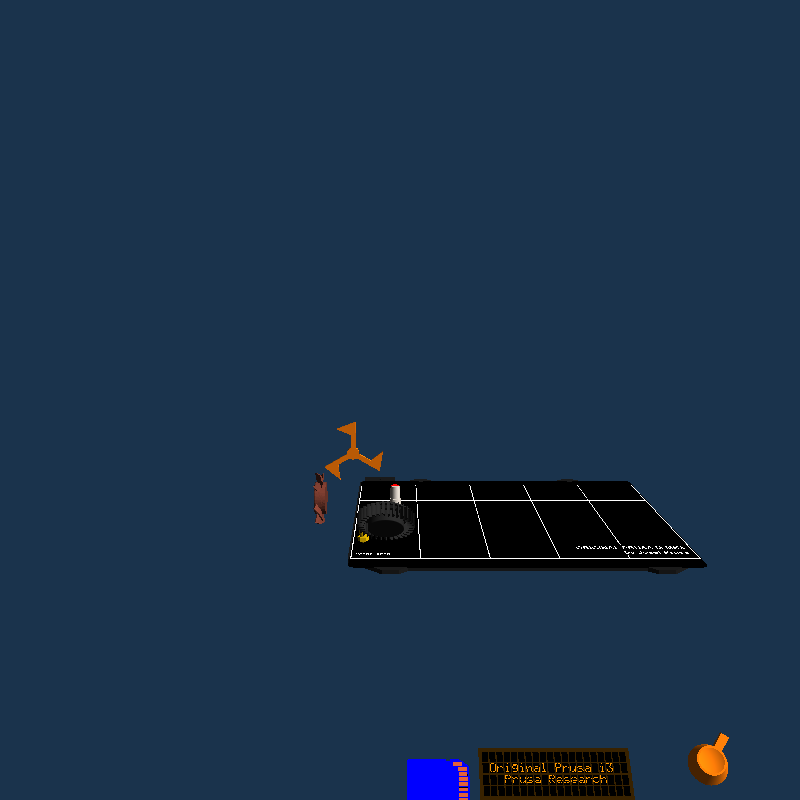
scripts/tests/snaps/ext1/GFXLiteMouseCamPan.png
