vintagepc/MK404/scripts/tests/snaps/ext1/IPCMMU2_lite.png

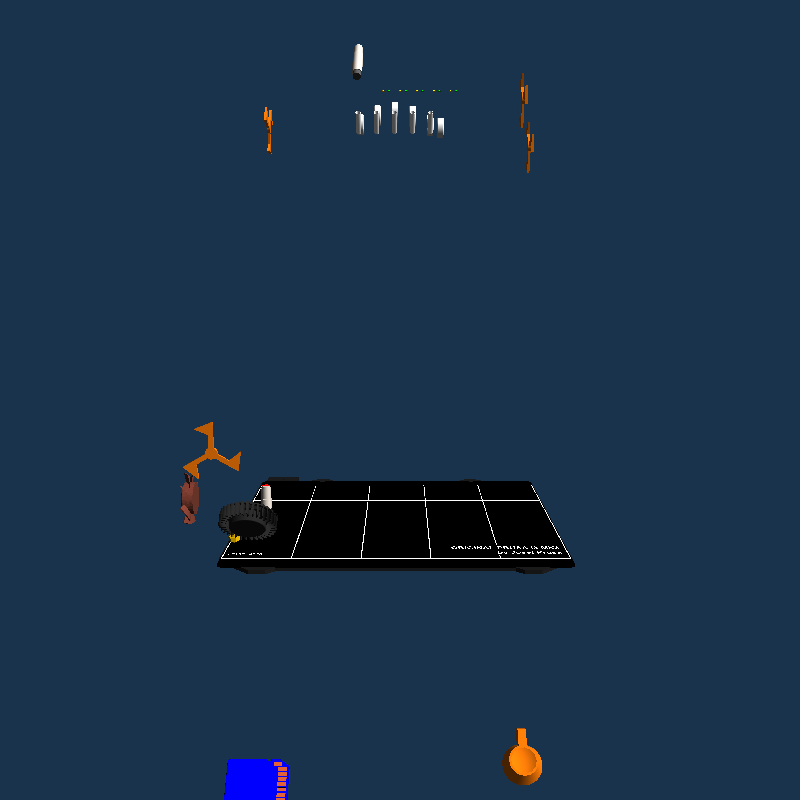
scripts/tests/snaps/ext1/IPCMMU2_lite.png
