vintagepc/MK404/scripts/tests/snaps/ext1/IPCMMU2_start.png

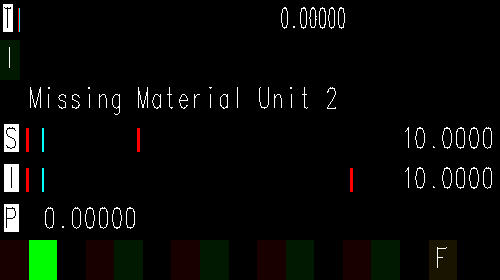
scripts/tests/snaps/ext1/IPCMMU2_start.png
