vintagepc/MK404/scripts/tests/snaps/ext1/MK2Fancy01.png

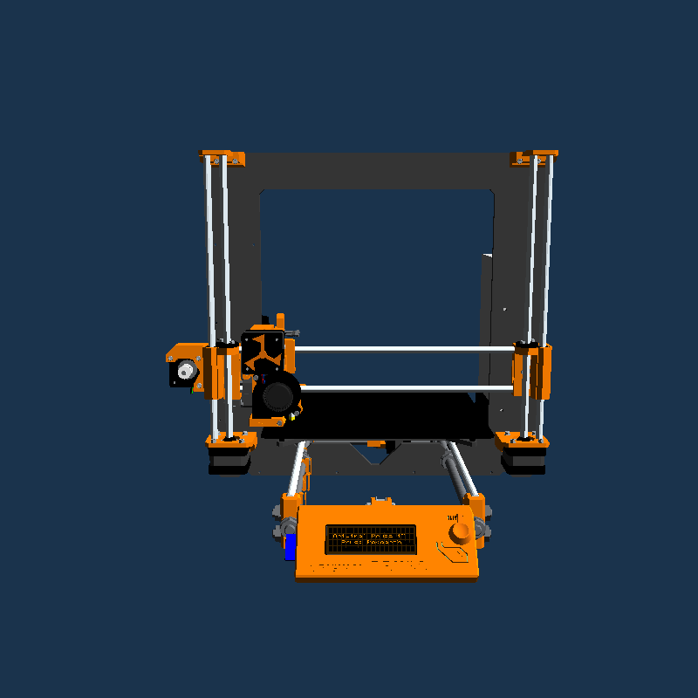
scripts/tests/snaps/ext1/MK2Fancy01.png
