vintagepc/MK404/scripts/tests/snaps/ext1/MK2Fancy02.png

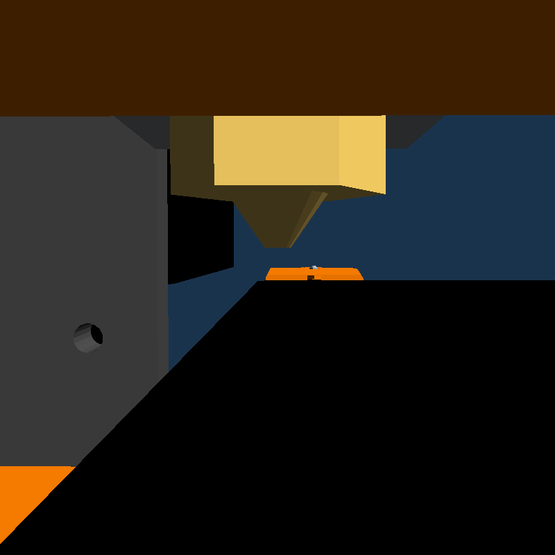
scripts/tests/snaps/ext1/MK2Fancy02.png
