vintagepc/MK404/scripts/tests/snaps/ext1/MK2LiteKeyT.png

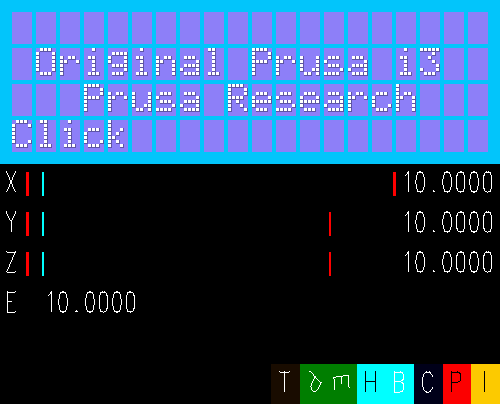
scripts/tests/snaps/ext1/MK2LiteKeyT.png
