vintagepc/MK404/scripts/tests/snaps/ext1/MK2MM02.png

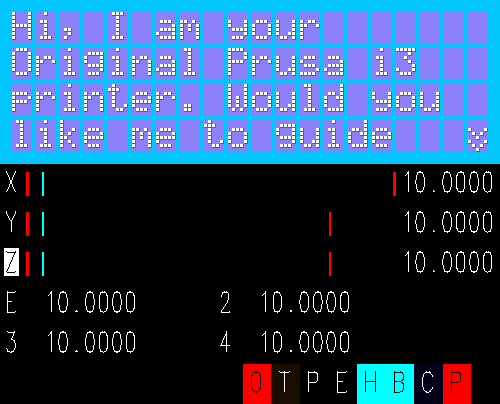
scripts/tests/snaps/ext1/MK2MM02.png
