vintagepc/MK404/scripts/tests/snaps/ext1/MK3MMU202.png

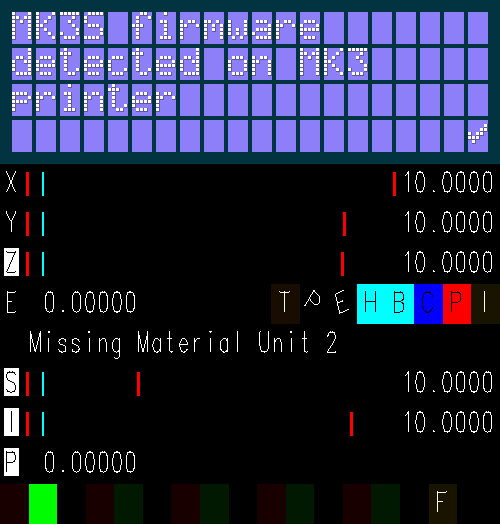
scripts/tests/snaps/ext1/MK3MMU202.png
