vintagepc/MK404/scripts/tests/snaps/ext1/MK3S01.png

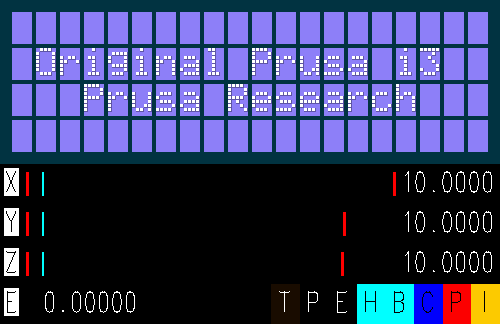
scripts/tests/snaps/ext1/MK3S01.png
