vintagepc/MK404/scripts/tests/snaps/ext1/MK3S02.png

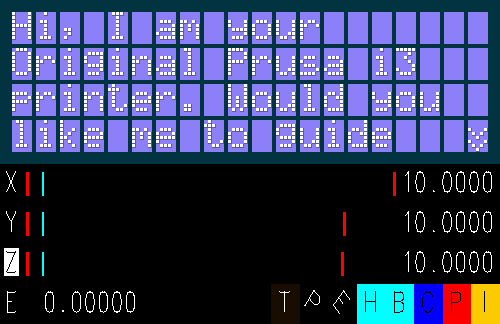
scripts/tests/snaps/ext1/MK3S02.png
