vintagepc/MK404/scripts/tests/snaps/ext1/MK3SMMU203.png

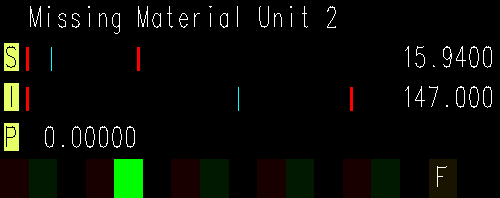
scripts/tests/snaps/ext1/MK3SMMU203.png
