vintagepc/MK404/scripts/tests/snaps/ext1/MK3SMMU204.png

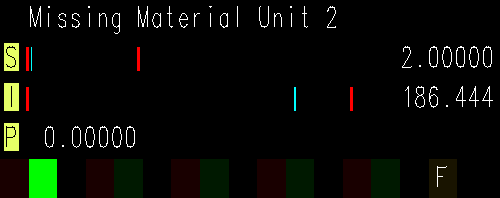
scripts/tests/snaps/ext1/MK3SMMU204.png
