vintagepc/MK404/scripts/tests/snaps/ext1/MK25Fancy02.png

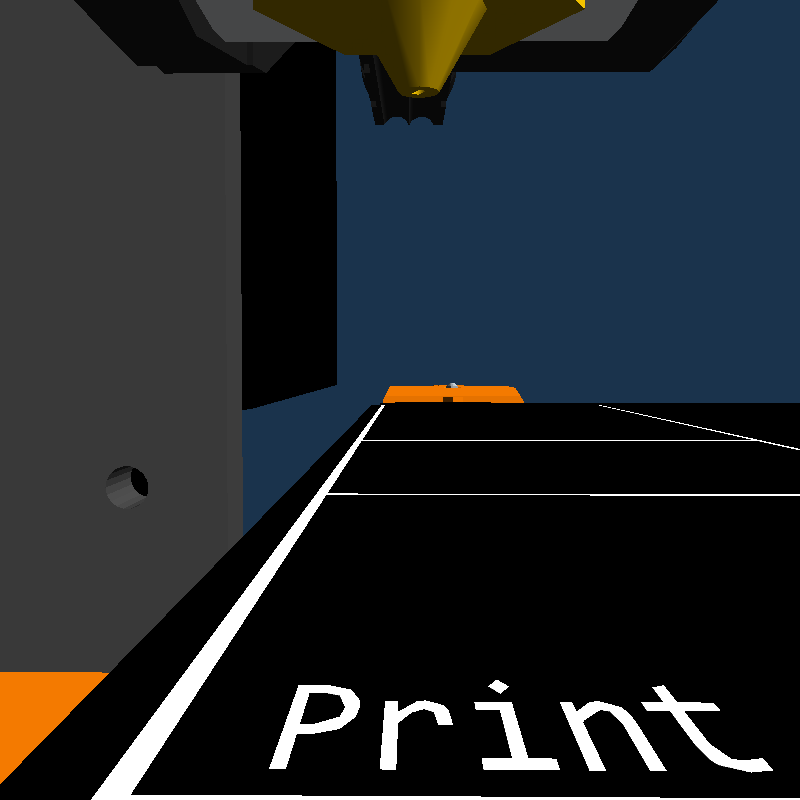
scripts/tests/snaps/ext1/MK25Fancy02.png
