vintagepc/MK404/scripts/tests/snaps/ext1/MK101.png

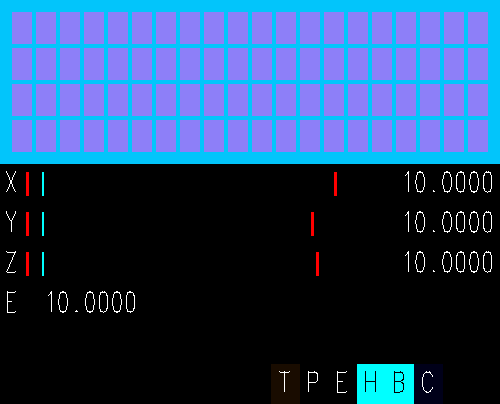
scripts/tests/snaps/ext1/MK101.png
