vintagepc/MK404/scripts/tests/snaps/ext1/MK102.png

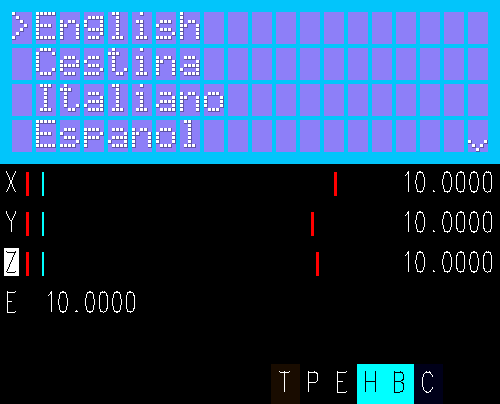
scripts/tests/snaps/ext1/MK102.png
