vintagepc/MK404/scripts/tests/snaps/ext1/MK103.png

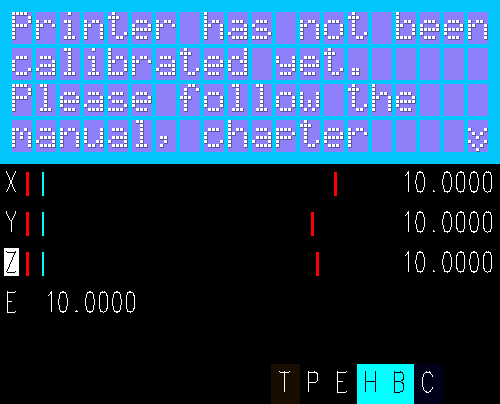
scripts/tests/snaps/ext1/MK103.png
