vintagepc/MK404/scripts/tests/snaps/ext1/MK201.png

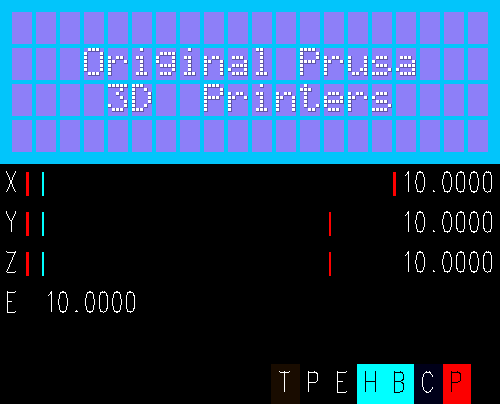
scripts/tests/snaps/ext1/MK201.png
