vintagepc/MK404/scripts/tests/snaps/ext1/MMU2_start.png

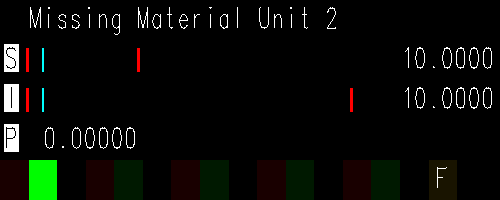
scripts/tests/snaps/ext1/MMU2_start.png
