vintagepc/MK404/(threads)

Thread 12 (2020-04-07):

Questions and chit-chat

leptun, 2020-04-07:
Hi @vintagepc
Thank you for inviting me to this project. I've read what you wrote so far in readme.md. I have a few questions:
How do you propose that we communicate after you push the first usable source code?
Are there others involved in the project?

vintagepc, 2020-07-25:
We are public!

Note this decoupled the previous fork(s) you may have had to private repos, so you will need to create a new fork and/or rebase your changes onto the current repo.

leptun, 2020-07-25:
Wonderful news! Where are you planning to make a post about the project?

vintagepc, 2020-07-25:
I haven't thought that far ahead, I figure I might just let it gain its own momentum. I might post about it in the PR forums.

(I don't do social media like reddit etc, so my exposure avenues are somewhat limited).

Who knows, maybe someday we'll get featured on a Prusa livestream or blog post... :rofl:

DRracer, 2020-07-26:
@vintagepc great news! I'll talk to our Content team about the (now public) MK3SIM, in fact I already got some questions about its state and whether it will get public one day.
The best timing to promote your huge effort is with FW 3.9.1 and largely repaired Linear Advance 1.5, which wouldn't be possible without the SIM and direct insight into what is going on in the algorithms during printing. @wavexx , what do you think?

DRracer, 2020-07-26:
@vintagepc - a short notice:
- cloned with submodules
- apt install libelf-dev libsdl-dev freeglut3-dev
- opened CMakeLists.txt in QtCreator 4.13b1
- compiled like a charm with gcc-10.1.0 ;)
It runs, however I'm still having problems with the boot process taking about a minute. The "P" and "E" letters are rotating, but nothing is happening. It is standing at `pBoard->WaitForFinish();` and some other threads are possibly waiting for UART. At least I can debug it nicely with full comfort in QtCreator ;) . I'll let you know if I discover something (if @leptun isn't faster as always :) ).

vintagepc, 2020-07-26:
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

Interesting, please feel free to start a separate issue thread so we can debug this without other messages getting interleaved.

(You did load a firmware to flash at least once with a -f flag or PS/avrdude, right? Otherwise you might just be bootlooping the bootloader.)

The wait state sounds about as expected, WaitForFinish() is basically a thread_join that returns when the AVR shuts down. Most of the other threads are indeed just serial helpers.

It might be useful in this case to inspect the avr->pc value while it's bootlooping and reference that back to an objdump of the .afx file to see in what function it's stuck.

DRracer, 2020-07-26:
@vintagepc sorry, my bad, no firmware (parameter -f). Now it runs well, thanks for your hint.

vintagepc, 2020-07-26:
No worries. I added a note to the README to that extent, you weren't the first, and won't be the last ;)

wavexx, 2020-07-27:
On Sun, Jul 26 2020, DRracer wrote:
> @wavexx , what do you think?

I think it would be awesome if possible!

3d-gussner, 2020-07-27:
https://twitter.com/MarlinFirmware/status/1287259911303442432

vintagepc, 2020-07-27:
Heh, that explains the giant spike in traffic yesterday 😁

vintagepc, 2020-07-30:
I've enabled a wiki for the project, seems like a useful addition as a place to document technical info as required.

Feel free to add/edit as you see fit, hopefully it will morph into something with a clearer direction as we find uses for it. :)

vintagepc, 2020-09-13:
Welp, I posted about it in the forums.
Time to brace for the masses :rofl:

Closed 2021-03-07.

Thread 75 (2020-04-24):

Actually implement phase correct pwm

vintagepc, 2020-04-24:
The reason that the system is clocking at about 2x the speed it should on delays is that we are cheating and running "frequency correct" pwm on timer2.

Fix this, I suspect doing so will also resolve the need for the TIMSK2 hack.

Closed 2020-08-05.

Thread 114 (2020-05-23):

Feature request: visualize extrusion

3d-gussner, 2020-05-23:
Do you think it could be possible to visualize an extrusion?
Here an idea with magnifying x10
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
Constant extruder move while hotend begins slow and get faster and slow again.

3d-gussner, 2020-09-17:
It would be great if we could also simulate the extrusion width like gcode.ws or PrusaSlicer 2.3-devel does.
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

@DRracer quote:
yes please do and make it work after 0.1mm segments - I'm sure we are causing the ghosting effect in the FW in the acceleration segments.
Be sure to add a multiplier to visualize the thickness e.g. 10x thicker so that we can see on single lines if the FW is computing the acceleration and deceleration correctly

3d-gussner, 2020-09-17:
Here a link https://github.com/hudbrog/gCodeViewer

vintagepc, 2020-09-17:
Yes, that's the entire reason this issue is still open. I definitely want to do it and the time is probably soon now that most other major functional development has slowed.

It's not a straightforward openGL thing to draw a "pipe" to create a 3d line. I think the best option for doing this is a geometry shader of some kind to turn raw line segments into a 3D entity.

DRracer, 2020-09-21:
@vintagepc as a first approach, even if you do it like PrusaSlicer - draw a 8-triangle piece of tube simulating the mass of filament being extracted - would greatly help. We do not need to render millions of triangles for debugging, we need just a few.

vintagepc, 2020-09-21:
@DRracer I'll see what I can do.... :+1: :smile:

vintagepc, 2020-09-23:
oof.. my head hurts from the geometry calculations for this. gcode.ws doesn't have a functional example, it only uses line widths. But linewidths>1 pixel are not guaranteed in openGL, and of course we want "virtual mm" not pixels.
So I need to offset the line in the XY plane.

Seems trivial... but it's not.

I tried poking through the PS gcode but there's too much noise. Perhaps someone familiar with the code could point me to the functions of interest that turn gcode line segments into square tubes.

vintagepc, 2020-09-23:
https://github.com/linas/glextrusion might be useful

DRracer, 2020-09-23:
@vintagepc if I had to solve this problem, I'd take the line segment as a normal vector for planes at each of its ends. In these planes I'd compute the positions of 4 points which will serve as the box/cylinder's base/top. And then just render the 8 triangles inbetween...
I know there will be cracks - i.e. the cylinders/boxes's points will not follow each other in case of turn segments etc. But for our purposes this is enough ... tbh may be even better than a smooth surface, because we would like to find the inconsistencies of extrusion if there are any.

vintagepc, 2020-09-23:
Yes - though I'm trying to find a way to do a continuous tesselation rather than having to start/stop triangle strips for every extrusion. I'd actually gotten something working with an existing pipe extrusion sample, but it didn't handle the winding changes well; you'd get places where the default normal would flip to the other side of the polyline and the exrusion would go hourglass-shaped.

I have no idea as to the performance penalty, hopefully this implementation won't run like crap.

vintagepc, 2020-09-24:
Making progress... Now I just need to sort out the width calculations based on E movements...

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

vintagepc, 2020-09-25:
Starting to look pretty good!

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

Remaining TODOs:

- [ ] Known issue with corners and very short extrusions with high E impulses causing spikes.
- [ ] Variable width co-linear extrusions are not shown; they're treated as a single extrusion. (just need to include E rate as part of the co-linearity calculation to detect an E volume change mid-line.
- [ ] No automatic Z height detection. TBD, will have to make a guess based on previous layer Z. Currently hard-coded at 0.2mm
- [] No idea how this will perform with large prints in terms of performance

DRracer, 2020-09-25:
TODO issue #2 is the most important one - ideally chop the single extrusion segment into 0.1mm slices and visualize extrusion thickness in each piece separately. With enough scale (probably including some coloring) this will enable us to see, if the firmware stepping is correct. If yes, the vertical fine artefacts must be caused by the TMC and or HW.

If caused by TMC, we could simulate its behavior and tweak the timing in FW in such a way, that the print surface gets improved.

vintagepc, 2020-09-25:
That's one way; I'd planned to just add the E distance as a second triangle area calculation to determine if the volume:distance was changing. I don't think it'd be too hard to try both to see which is better.

Re: VFAs, I assume you're referring to the salmon-skin texture we see on the MK3 and discussed in that 50-page megathread? From what I recall the origin was concluded to be non-uniformity of the motor's step cycle; I can personally confirm they do go away if you change the motor. (but of course that doesn't mean it might not be possible to configure the driver in a way to mitigate it with the stock motors).

I agree it would be interesting to see if the problem exists here (or, if not) whether we could simulate and reproduce it by introducing a cyclic non-uniformity in the simulated motor.

DRracer, 2020-09-25:
@vintagepc EXACTLY ... if we even simulate a bad motor and see similar salmon-skin effect in the simulation, we can start preparing counter measures.

vintagepc, 2020-09-25:
That would be icing on a cake indeed!

Somewhat related: Funnily enough I've started seeing one on the E-cycle again on my own printer; I suspect it's because the 3d-printed gear in my extruder is actually flexing and off-center.... One of these days I'll get around to reprinting it out of ABS or something less flexible...

DRracer, 2020-09-25:
I'm really looking forward to this visualization, there have been so many theories around, but no-one (AFAIK) ever tried to verify, that the FW is sending the pulses correctly. If we can rule out FW, we may start tackling the TMC and the potentially bad motors.
Moreover - with LA15, the acceleration artefacts are stronger - that must be visible as well.

vintagepc, 2020-09-25:
Yes, it's easy to latch on to a plausible explanation with relatively minimal supporting evidence. A prime example was the common adage that the MK3's Einsy was "overloaded" and could not handle higher X/Y stepping rates and result in lost steps. And we know how that turned out with https://github.com/prusa3d/Prusa-Firmware/pull/2792 completely invalidating that. (I'm rocking 0.9 degree steppers at the default 16 XY microsteps now)

DRracer, 2020-09-25:
There is also a video showing a motor from MINI being driven by a Duet board - and while the motor is purring in the MINI, it is rotation absolutely smoothly with the Duet board ... we are doing something wrong and I'd love to find out what it is.

vintagepc, 2020-09-25:
Fascinating!

I think we'll be able to make good use of @wavexx 's colour interpolation to colour by E-width...

vintagepc, 2020-09-25:
well that was .... interesting. I think we may be hitting the discretization limit of the motion tracking though. And my framrate absolutely tanked after a single layer of a 25x25 square :rofl:

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

DRracer, 2020-09-25:
@vintagepc great progress - make longer segments (or configurable length of individual segments). For this to work we don't need a 20cm high object, a single line with acceleration and deceleration would be enough - just make sure the extrusion per millimeter is exact. I see some repeating patterns even now, but that's probably too early to judge.

vintagepc, 2020-09-26:
So after rewriting much of the print visualizer to work in absolute motor step units rather than floats, it turns out that pattern is not discretization of the positions/float error on my part. It's the actual stepper resolution we're seeing:

```
fERate:119.000000 dXY:3.000000 dE:357
fERate:178.500000 dXY:2.000000 dE:357
fERate:119.000000 dXY:3.000000 dE:357
fERate:178.500000 dXY:2.000000 dE:357
```

In other words, sometimes X gets in 3 steps, other times 2 for the same E volume.

_Arbitrary musings on the subject:_

That actually makes a lot of sense in the context of higher resolution steppers reducing VFAs (assuming this is the cause) since with a higher steps/mm you inherently get a better interleaving of operations.

The physics of the molten plastic helps smooth this out in reality, but if the pattern is regular enough or there are clumps of higher-volume steps then of course you're going to see it in the right lighting conditions.

In theory one could mitigate this more with advanced planning - you could vary the travel speed (within a small window so as not to invalidate LA and molten plastic physics) such that you get even interleaving of E steps to X/Y steps....

I'm cleaning up the code a bit and getting ready to push it up as a preview. High-res E mode is enabled with a new command line argument, `--highres-extrusion`. (Off by default, it just averages the entire E volume over the total length of the segment otherwise.)

It occurs to me that this sim can also potentially be useful for investigating if the same step handling is related to the infamous 602 "inconsistent extrusion".

Current TODOs:
- Z layer height detection for layer heights other than 0.2. I think this will be a wishlist item, MBL is going to mess with trying to get this straight from the Z value at which we're extruding and at this level we don't have access to the raw gcode to ID it from the settings.
- Colour-based width visualization.
- Fix positioning of the print in XY, it's off slightly.

wavexx, 2020-09-26:
Yeah, these are implicit with bresenham. The "correctly sampled" axis is always the fastest moving during the current move.

You can simulate the effect of higher sampling rates using higher microstep counts now that they work correctly (essentially giving you the same effect as ADAPTIVE_STEP_SMOOTHING) which will reduce the difference between the effective and real pulse speed.

I didn't see the same effect you get though by actually going with a 0.9 stepper :(

vintagepc, 2020-09-26:
> I didn't see the same effect you get though by actually going with a 0.9 stepper :(

Interesting... what motors did you go with?

wavexx, 2020-09-26:
On Sat, Sep 26 2020, vintagepc wrote:
>> I didn't see the same effect you get though by actually going with a 0.9 stepper :(
>
> Interesting... what motors did you go with?

I still kept stock 1.8 everywhere for greater torque/speed. I was using
a 0.9 (an LDO coolstep mounted on a BMG) on the extruder for a while,
but I also reverted that a month ago to the stock BMG with a random 1.8
(so from 824 to 412 e-steps) to get greater acceleration when I noticed
that retractions were a limiting factor. E-jerk is also something I need
to retest, but I couldn't get beyond 3.5 with the old setup and that is
also to consider as it's a big limit in speed when using LA.

I was never able so far to get my hands on a low-inductance motor like
the fabled "Moons" or the newer LDO ones...

leptun, 2020-09-26:
Why would you want a low inductance motor? Doesn’t it have lower torque (especially at speed)?
I also noticed that lower inductance motors play better with the tmc2209 drivers compared to the stock prusa ones, but it’s still not great.

wavexx, 2020-09-26:
The idea was really to get rid of the banding ignoring everything else. It's definitely not a choice I would do today ;)

vintagepc, 2020-09-26:
Interesting. I've got my 0.9s on X/Y. Stock firmware, no changes to limits/speeds. I have mostly run in power mode but as of the "high speed deceleration fix" I've done a few prints in stealth mode and also no longer had the layer shifting I observed there before. But it's a small sample size so not conclusive.

wavexx, 2020-09-26:
Now that we fixed the deceleration bug we can go pretty fast, but acceleration (torque) is everything to actually save some printing time. I'll plop this here:

https://www.thregr.org/~wavexx/tmp/VID_20200920_191805_r.mp4

vintagepc, 2020-09-26:
those poor stepper drivers :rofl:

Colour-by-width is live!
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

vintagepc, 2020-09-26:
I've pushed it all up to https://github.com/vintagepc/MK404/tree/114-Extrusion-visualization-take-2

I think the only thing still missing is the Z layer height detection.

vintagepc, 2020-09-26:
Added - Extreme MBL is likely to mess with it but it appears to get a reasonable guess of the layer Z height based on the segment average Z.

Also set the minimum segment size to 0.4mm for non-highres mode.

DRracer, 2020-09-27:
@vintagepc very interesting results! I'm thinking about plugging-in some microstepping curve like explained in this article:
https://hackaday.com/2016/08/29/how-accurate-is-microstepping-really/

Probably we can then see similar larger scale artefacts like we observe on physical prints.

vintagepc, 2020-09-27:
Interesting. We don't simulate/see sub-step positional changes since we operate at the native printer "step" resolution. But there should be ways to work around that either through modification of the values received or altering how things are drawn slightly to approximate such a curve.

DRracer, 2020-09-27:
@vintagepc we now can simply recompute the real movement through that curve, I wouldn't complicate it too much. Right now you assume the motor and stepper are behaving linearly and compute the extrusion amount based on the. Just plug in some curve like that and recalculate the extrusion amount (and/or real x-y position).

vintagepc, 2020-09-27:
I think we're saying the same thing, or at least something that has the same net effect :)

vintagepc, 2020-10-02:
Just pushed a "flat-quad" extrusion visual mode that's not has hard on the GPU... Two triangles per segment instead of 8.

Next-up: non-uniform E-cycles....

vintagepc, 2020-10-02:
Ummm. So. I think this takes true-to-life simulation to a whole new level. :rofl:

Non-uniform X cycle, with a non uniformity around the half-step position:
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

That pattern looks awfully familiar...

DRracer, 2020-10-03:
Damn, I hate being right.
@vintagepc excellent result, keep it up. As I can see, we have 2 types of artefacts - stepper interleave and non-linear curve of the TMC/motor.
@wavexx how can we fight stepper interleave?

DRracer, 2020-10-03:
@vintagepc "flat-quad" extrusion visual mode is completely sufficient - for our analytic purposes it looks even better than full 8-face "body" of the filament (the investigated effect is much more apparent).

wavexx, 2020-10-03:
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

I'd like to try this. Is it already in 112-*-take-2?
I guess I need to use --3d-extrusion along with --extrusion Quad_*?

vintagepc, 2020-10-03:
The only downside to flat quad being that it's completely invisible from the bottom :rofl:

I'm thinking that doing something about the interleave could be tricky since it's basically discretization at the resolution of the motion system. Geared extruders and smaller angle steppers (at higher microstep counts) will of course help with the problem since it gives you more choice as to when each tick needs to happen. The Einsy is certainly capable of 16 microsteps at 200 steps/mm on my 0.9s, so perhaps just a nudge to 32 microsteps on the stock motors could make that less prominent... or perhaps just the extruder.

I'm curious about what's been tried internally with X/Y linearity correction to deal with motor nonlinearity though - the feature is in the firmware and some people have found success with it for their VFAs and others have not. Was it actually added as a means to try to combat the problem previously, or is it just inherited from something else and we've never really done much with it?

Whether that means the range of adjustment isn't sufficient, or whether there's a large variability in motor characteristics (ew, I hope not!) remains to be seen. Perhaps the first thing to do there is find a way to characterize this nonlinearity under typical load. I wonder if one could somehow attach a high-resolution CNC axis scale to the bed and/or X carriage to take digital position measurements throughout the steps of the motor cycle.

> On Sat, Oct 03 2020, vintagepc wrote: Non-uniform X cycle, with a non uniformity around the half-step position:
> I'd like to try this. Is it already in 112-*-take-2? I guess I need to use --3d-extrusion along with --extrusion Quad_*?

`--3d-extrusion` is deprecated once I added flat-quad mode, the draw style (line/quad/tube) is now controlled purely by `--extrusion`. Quad-HR is what you want, regular Quad averages things for a lower triangle count.
My command-line was `./MK404 --extrusion Quad_HR -g lite --colour-extrusion`

The non-linearity on X is controlled by:

```
uint32_t GLPrint::GetAdjustedStep(uint32_t uiStep)
{

	return uiStep;

	auto cyclePos = uiStep%256;
	if (cyclePos<112 || cyclePos > 160) return uiStep;

	if (cyclePos>=144 || cyclePos<=128)
	{
		return uiStep-32; // lag behind 2 microstep;
	}
	else
	{
		return uiStep-64; // Lag 2 microsteps right at the midpoint.
	}
}
```

Right now it's disabled again - remove the instant return to re-enable it; and you can change this function to suit the nonlinearity you're trying to represent.  It's still present at -16 and -32, I just inflated the values for the images to distinguish it from the step interleave.

The TMC operates at "full" resolution (256 steps) internally, when the resolution changes we adjust how many of these we increment by (so the MK3S, at 16 microsteps) will increment/decrement by 16 as its normal "step" size.

I also pushed up my single-wall test G-code, VFA-Test.gcode. Cold extrusion and no MBL so less waiting to see the result.

3d-gussner, 2020-10-04:
Playing around and here an example of Marlin206_einsy printing VFA-Test.gcode
- lower part no changes in flow or LA K value
- mid section go with flow to 40
- Upper part changing flow and LA k value
- Top layers are printed with flow 100 and LA K0.00
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

It looks most consistent with flow 95%

3d-gussner, 2020-10-04:
@vintagepc What are these lines are showing?
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

3d-gussner, 2020-10-04:
It is still hard to navigate with the mouse to get a good shot. Any change we can use keys to navigate the camera, or out/input coordination?

vintagepc, 2020-10-04:
> @vintagepc What are these lines are showing?
> 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

Those are the initial de-retractions. They show up that way because they are a high extrusion delta but with very little horizontal movement.

> It is still hard to navigate with the mouse to get a good shot. Any chance we can use keys to navigate the camera, or out/input coordinates?
Yeah, the camera library is better than what we first had but still not great (or just misconfigured). I'll have another go at it.

vintagepc, 2020-10-04:
@3d-gussner Just pushed up a small tweak to camera handling. seems to be better and no longer "snaps back" to the starting position every time you try to do a move. Let me know if that's better.

3d-gussner, 2020-10-04:
Print 100x50x50 cube with 1 perimeter with Marlin206 Einsy firmware

- first layers stock flow 95 and LA K K0.5 pla
- 2nd part flow 90
- 3rd part flow 85
- 4th part flow 80

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

vintagepc, 2020-10-04:
Excellent - since this seems to be working nicely I'm going to prep some tests and merge this up to mater.

vintagepc, 2020-10-04:
Just an observation - I've noticed that the VFAs seem to show up much more strongly during an LA lead-in and then disappear once the extruder is up to speed on X. (This is not ringing as the frequency is too high for the mass of the Y axis) Will post a pic once the print completes.

wavexx, 2020-10-04:
Yup. Acceleration is especially bad (or let's say, less clean!) with LA. The acceleration frequency is shifted up with a fixed factor, but all additional E-steps are spread inbetween regular XYZ steps. This causes the E frequency to change continuously during acceleration _around_ the target speed, since we sum the regular stepper aliasing with E aliasing as well.

This also existed with LA1.0, but given it was a quadratic decay, the length of which it was visible was much shorter.

Sadly, to remove this issue we would need to decouple the E stepper movement from the XYZ (that is, step using a separate acceleration curve for E).  Ironically this would also reduce aliasing overall. For the AVR though this is probably an overreach :/

vintagepc, 2020-10-04:
At that point you'd probably start getting task interleaving artifacts instead... who knows. Probably about all you could do to work around that is have some sort of external motion planner you could direct rather than controlling the steps directly.

vintagepc, 2020-10-05:
Picture, as promised. :-)
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

DRracer, 2020-10-05:
@vintagepc how did you manage to make such a clean print? My stock MK3S does awful straight lines just as @3d-gussner showed in the sim. I'm shocked how exact the simulation corresponds to reality (i.e. how the printer's HW replicates the errors in driving the motors).
I do see the tiny acceleration artefacts though, that was our primary idea/motivation for visualizing extrusion.

wavexx, 2020-10-05:
On Mon, Oct 05 2020, DRracer wrote:
> @vintagepc how did you manage to make such a clean print?

If I'm not mistaken he's using .9 steppers on XY

vintagepc, 2020-10-05:
> On Mon, Oct 05 2020, DRracer wrote: @vintagepc how did you manage to make such a clean print?
> If I'm not mistaken he's using .9 steppers on XY

Yep, that's one of 'em. It's a somewhat modified 3S with the following being the major mods relating to print quality:

OMC 0.9 degree steppers on X/Y, 16 microsteps @ 200 steps/mm
https://www.amazon.com/gp/product/B00W98OYE4/ref=ppx_yo_dt_b_search_asin_title?ie=UTF8&psc=1
They were drop in replacements, though I did add heatsinks to the TMC drivers out of caution. No customized firmware required, and sensorless homing works as expected. Last I checked the crash detection was flaky, but I haven't checked since the high-speed deceleration fix; my suspicion was that the skipped steps there could have been triggering it.

3.5:1 geared extruder (Skelestruder) with a pancake stepper (1.8 degree) - 490 steps/mm, 16 microsteps
https://www.amazon.com/gp/product/B01LESPDCQ/ref=ppx_yo_dt_b_search_asin_title?ie=UTF8&psc=1

Vesconite bushings on X/Y (Doesn't help VFAs but helps with bearing noise and artifacts)

Solid mounting on a marble slab to cut down on vibration artifacts, sturdier X/Y axis printed parts for better belt tensioning.

It occurs to me it'd be interesting to plug those steps/mm and microstep values into the simulator to see what the pattern looks like...

vintagepc, 2020-10-05:
It's also worth noting that print is a 0.3mm layer height. Layer volume also plays a role in how visible the step discretization artifacts are.

vintagepc, 2020-10-05:
Just tried it and the artifacts are (of course) still present but they are much finer - and I think on this scale they start to be "absorbed" into the flow characteristics of the molten plastic, which will have a natural smoothing effect:

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

That suggests that even without hardware modifiications, if we can manage to make the interleaving a little bit finer it might be possible to make them visually negligible. Maybe a combo of DEDGE and higher microstep counts could do it.

wavexx, 2020-10-05:
I've been running with the BMG with a .9 stepper (830 e-steps), and now half of that (mostly due to the speed limit). But you can just step faster (thus reducing XY error) by increasing e-microsteps up to 64.

The BMG extrudes much smoother overall, and this becomes much more obvious at low speeds, but I can't say I noticed a decrease of VFA in prints compared to a plain MK3.

vintagepc, 2020-10-05:
Keep in mind it depends which type of artifact you're seeing - additional microsteps doesn't help combat motor nonlinearity - only those artifacts caused by stepper interleave.

wavexx, 2020-10-05:
Yes, but stepper interleave is what we're seeing here. My point is that the motor and/or motion of the axis as a whole is what causes most of the problem sadly.

wavexx, 2020-10-05:
Ummh, sorry. Saw the edit too late :+1:

wavexx, 2020-10-05:
> Picture, as promised. :-)
> 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

Btw, .3 layers, with a .4 nozzle or bigger?

vintagepc, 2020-10-05:
Yes, 0.4 nozzle. 0.55 extrusion width to avoid gap fill and its print time penalty on certain features in that particular part. Don't know if it matters but I also have a plated copper heat block and a plated copper nozzle.

wavexx, 2020-10-05:
Ok, the 0.55 extrusion explains why I'm not seeing gaps between the layers. I consider .3 too high for a .4 nozzle with the default extrusion width. I'm also trying a copper block currently.

vintagepc, 2020-10-05:
This object was a wipe block for an MMU print, but the main part was done at the default width (0.45)

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

wavexx, 2020-10-05:
MMh, that looks quite ok. I don't have any .3 prints right here, but I generally have occasional imperfections (thin layer gaps) in long straight sections, something you definitely see immediately. It's also not unique to the MK3 (same issue with a .4 MK8 nozzle on a tevo).

vintagepc, 2020-10-05:
I think it requires well tuned extruder tension and temperatures; I could see it easily causing issues if you're not extruding hot enough or slightly under at the flow rates/volume you get with 0.3 layer height.

vintagepc, 2020-10-05:
Yes, I was using PLA (+-0.03mm if it matters). I normally print this stuff at 195 but had bumped it to 210 for MMU tip shaping.

vintagepc, 2020-10-06:
Merged. Nonlinearity is disabled by default but can be enabled by swapping comments on the X Position change calls in `util/GLPrint.h`

Closed 2020-10-06.

Thread 134 (2020-06-09):

Printer Factory cleanup

vintagepc, 2020-06-09:
As a result of #49, there is a printer factory object, but it is not very clean.

Fix it so printers can register themselves.

Also, it's probably going to be horribly broken if you try to instance multiple printers... I'm pretty sure it's going to leak memory.

It should be fine for single instances and I don't want to get bogged down making it perfect right now to the detriment of the other stuff it is blocking - but I'm leaving this ticket here for reference if we start doing more complex stuff involving multiple printers or dynamic load/close without quitting the main program.

Closed 2020-08-29.

Thread 182 (2020-07-24):

Print from SD WDR, take 2

vintagepc, 2020-07-24:
Seems this is still an issue with the file checking causing a WDR on certain files.

Once more into the breach... (Re-visit of #115)

vintagepc, 2020-08-03:
Interesting find... despite various attempts and debugging efforts, the command processing seems to stall at a certain point and not process (dequeue) any more lines from the command buffer - even if I extend the WDR cycle count.

For some reason, disabling the WDR, it will hang until after the WDR fires, and then resume processing the queue:
```
G1 .
G1 .
M10.
G1 .
M70.
<< waits for 2-3 seconds as I extended the WDR timer by 50% (4s -> 6s) >>
Would have WDRed
G4 .
M22.
M90.
M10.
M14.
M10.
G1 .
G0 .
M84.
G4 .
M30.
M73.
M73.
echo:enqueing "M23 5cubes~1.gco"..
echo:enqueing "M24"..
OnCmdReady activating 4 bits mode
```

I wonder if there's an issue somewhere in retrieving the last block of a file from the card or something...
Any immediate thoughts on this or areas I should look at extra carefully, @leptun?

Alas I don't have an SPI capable DSO, or I could sniff and compare the SD traffic to the VCD trace for the same file...

leptun, 2020-08-03:
@vintagepc As luck would have it, I've recently played with a hardware implementation of the SD emulation. I've used an STM32F4 at a reduced SPI clock frequency and I was able to "Print from USB" with small modifications to the SD automaton. There was only one edge case where the simulator had an impossible advantage as it was able to instantly respond with the right message on the same clock cycle (it should only be able to respond on the second request by the master).

This honestly stinks a lot like a firmware bug with the cmdqueue. I've recently found a gcode which seems to make the printer reset when printing it at a certain line. Maybe you can do a bit of debugging in the cmdqueue and maybe find out what happens. I tested it on:
- MK3 firmware + TMC2209 drivers
- MK2.5S firmware - test bench
- MK2.5S firmware - STM32 USB
- MK404 MK3S - SD print - resulted in random Inactivity shutdown
In all of these cases it crashed at some point. Maybe it would be a good starting point for an eventual cmdqueue corruption issue.
[imperial.zip](https://github.com/vintagepc/MK404/files/5017539/imperial.zip)

vintagepc, 2020-08-03:
iiiiiiiinteresting.I do know the queue is (somewhat) easily corruptbile - pronterface's temperature requests (M107) can get entered as M1s and make the printer pause if they come in just at the right time during MBL or another "busy" state.
This particular issue is also very sensitive to what line it is on, if you shorten the gcode slightly or extend it so M84 is in a different position in the SD block, it comes and goes away

vintagepc, 2020-08-03:
OK, I got somewhere further. Seems that the "delay" is not a pause, rather, the printer is busy chewing through the block of comments at the end of the gcode file while trying to refill the command queue - pre-empting it finding the already-enqueued M84 until it's too late.

vintagepc, 2020-08-03:
Leaving a breadcrumb... seems to be a large chunk of time between the final data byte from the file and the CRC being sent.
That could be adding up...
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

vintagepc, 2020-08-03:
I think we have a winner...
`		avr_cycle_timer_register_usec(avr, 100, avr_spi_raise, p); // should be speed dependent`
That's artificially throttling the SPI bus output to something slower than the board is used to - simavr ignores SPCR and SPSR entirely.

vintagepc, 2020-08-03:
Closing and creating a separate issue for the SPI sim.

vintagepc, 2020-08-04:
I did look at your file. Looks like something is causing an overflow and corrupting memory - note the output at the very end:
```
+G01 X105.5379954438 Y40.1633950622 F2540.8002046466..
-G01.
+G01 X96.3072354438 Y47.0786515787 F2540.8002046466..
-G01.
+G01 X87.0764754438 Y53.9939080952 F2540.8002046466..
-G01.
-G01.
-G01.
-G01.
-G01.
Done printing file..
echo:0 hours 1 minutes..
Done printing file..
echo:0 hours 1 minutes..
Done printing file..
echo:0 hours 1 minutes..
Done printing file..
echo:0 hours 1 minutes..
Done printing file..
echo:0 hours 1 minutes..
Done printing file..
echo:0 hours 1 minutes..
Done printing file..
echo:0 hours 1 minutes..
Done printing file..
echo:0 hours 1 minutes..
Done printing file..
echo:0 hours 1 minutes..
Done printing file..
echo:0 hours 1 minutes..
Done printing file..
echo:0 hours 1 minutes..
Done printing file..
echo:0 hours 1 minutes..
Done printing file..
echo:0 hours 1 minutes..
Done printing file..
echo:0 hours 1 minutes..
Done printing file..
echo:0 hours 1 minutes..
Done printing file..
echo:0 hours 1 minutes..
Done printing file..
echo:0 hours 1 minutes..
Done printing file..
echo:0 hours 1 minutes..
Done printing file..
echo:0 hours 1 minutes..
Done printing file..
echo:0 hours 1 minutes..
Done printing file..
echo:0 hours 1 minutes..
Done printing file..
echo:0 hours 1 minutes.....=��..
Done printing file..
echo:0 hours 1 miqvtes..
MCUSR: 08
RESET
```

vintagepc, 2020-08-04:
It is dequeueing every line in the file, so something weird is happening at the end when it runs past the last line.

leptun, 2020-08-04:
I’ll look into this file this week. I’m glad that the SD card implementation works correctly now. The only thing I might look into (not really decided at this point) is fixing the impossible advantage I saw in the real hardware. But that’s for later.

vintagepc, 2020-08-06:
Yes, it's relatively straightforward to toss a couple of  "hang on, busy" commands before the card is ready to supply data. (Research suggests the read latency for a typical SD card can be ~1ms. (I researched this when I was exploring the same, i.e. whether our card was "too good" and preempting the regular processing because it always had data ready)

Closed 2020-08-03.

Thread 187 (2020-07-27):

[FEATURE] Alternate visual options

vintagepc, 2020-07-27:
@gregsaun,expressed interest in alternate (:bear: ) visuals. Probably a feature we'll want to have in order to support other models of printer.

Start thinking about ways we can do this, maybe a model table with offsets rather than reimplementing the entire MK3SGL class for every model.

Maybe acquire a set of Bear visuals in order to facilitate this and see what problems come out of the woodwork during the process...

gregsaun, 2020-07-28:
Thank you for have noted my interested :)

I'll be happy to provide everything I can make to help you. You can already download the Bear 2.1 frame in Fusion 360 and STEP format from here: https://github.com/gregsaun/prusa_i3_bear_upgrade/tree/dev/src . The Bear extruder is available from here (same file formats): https://github.com/gregsaun/bear_extruder_and_x_axis/tree/master/source . Note the Bear frame repo does not contain the extruder because you can use the Prusa extruder on the Bear frame or Prusa frame with the Bear extruder.

leptun, 2020-07-28:
@vintagepc do you want me to make new OBJ files?

gregsaun, 2020-07-28:
If you use the STEP file to make OBJ files make sure to remove the "build helpers". There is one for Y axis and one for Z axis:
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

If building OBJ files is just an export from an STL (Meshmixer?) I can make those for you, no problem.

leptun, 2020-07-28:
For the time being I used Solidworks and a plugin to export as that is my main CAD software. I’m doing it like this just so that the output file is consistent.
Also, I had an assembly of the MK3 in Solidworks format and it was easier than using steps. Also, I could split the printer into subassemblies.

gregsaun, 2020-07-28:
Okay I see. Unfortunately I use Fusion 360 so STEP is probably best if you want to import to Solidworks.

However, I have just checked and Fusion 360 can export an OBJ. It takes a bit of time but I test it and share it here in case it looks to be good.

vintagepc, 2020-07-28:
Unfortunately we've been there before. Maybe you'll have better luck with a paid version if that's what you're using, but when I tried it with the maker license, the OBJs I got did not export materials, and you could not export multiple objects into one.

FreeCAD does support MTL exports but the resulting appearance of the export was dissapointing given the number of triangles. There is a discussion on this in #50 with plenty of screenshots; in the end we concluded that Solidworks was the final export tool of choice.

- You can use "GLC player" to examine the existing OBJs in the assets/ folder to see what I mean - each one contains multiple objects and materials, we've mostly broken them down by sub assemblies to swap them in/out as needed.

gregsaun, 2020-07-28:
I have the paid license but it looks like the material isn't exported.
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

vintagepc, 2020-07-28:
Darn - if you look at the 'Model' button on the left panel, are they all distinct components, or is it just one giant mesh? If the former, it may be possible to manually apply materials. But if it's all the same surface that's not possible. :disappointed:

gregsaun, 2020-07-28:
I have individual components yes. I cna share the OBJ and a prepared STEP file. The step file has the material (at least color).

vintagepc, 2020-07-28:
That's good - since it's just a text format I could just extract materials from the existing mtl files we have rather than manually migrate the data from the STEP. - the OBJ alone should be enough.

We'll have to see how it goes as a complete assembly, I think it's possible to rework things to handle that. But we might need to split things up into the separate moving components (X, Y, Z) for ease of handling within GL; depends how the object itself is structured.

We had to split them for the other models because SW joins objects with the same material together - so if you tried to move the extruder, all other black parts would move left and right as well :rofl: (There was also lite mode which saved a lot of file loading overhead by doing that. But there's not much point in a Bear lite mode as it'd look about the same as the regular lite.)

gregsaun, 2020-07-28:
Looks like he has grouped some stuffs together so not sure how it goes. If you like I can create an OBJ for each axis + frame. If that could make things easier.

vintagepc, 2020-07-28:
Ah, OK. Lets do that then.

Here are the assemblies we have for the existing model:
- Extruder, minus the two moving inner fan parts (already have separate objs for those to animate them)
- X axis (Z gantry)
- Y axis (minus steel sheet, already separate obj)
- Frame (minus LCD knob, separate obj already).

In order to cut down on the triangle count and file size, you can also hide any internal objects that are not visible - for example the internal IR sensor ball, lever mechanism, some screws, the balls, if the LM8UUs have them modeled, etc)

I'm sure we'll find more things as we go along, this is usually an iterative process to get right.

gregsaun, 2020-07-28:
Awesome, I'll prepare that. What about belts (mine have no teeth)?

vintagepc, 2020-07-28:
We don't have any for the existing model but if it has no teeth it would look fine just leaving it on in the fixed parent assembly.

gregsaun, 2020-07-28:
Here it is :)
[bear21_mk3s_simulator.zip](https://github.com/vintagepc/MK404/files/4988499/bear21_mk3s_simulator.zip)

Thanks for all the hard work, very much appreciated.

vintagepc, 2020-07-28:
Thanks, I'll poke at it a bit after work tonight.

vintagepc, 2020-07-28:
This is interesting, the objs do have MTL references:

`mtllib d2b749dc-85a2-4cde-b3fc-98cb260eb702.mtl`

...
`usemtl Aluminum_-_Satin`

Do you perhaps need to download or retrieve them separately? I can't imagine they'd go through all the trouble of handling it and not exposing the materials file.

3d-gussner, 2020-07-29:
I may have found a way to "export" Fusion 360 to obj + mtl.
1. Disable history
2. Convert Body "BRep to Mesh"
3. Save as OBJ

Result:
<name>.obj + <name>.mtl
[Cubes.zip](https://github.com/vintagepc/MK404/files/4993175/Cubes.zip)

Now have to try an assembly.

gregsaun, 2020-07-29:
@vintagepc Very happy you like the Bear. Contact me first if you like to build a Bear from scratch ;)

@vintagepc @3d-gussner Oh that is nice, let me redo the export then!

3d-gussner, 2020-07-29:
https://apps.autodesk.com/FUSION/en/Detail/Index?id=161925079138285899&appLang=en&os=Win64 Seams to work. Here an example of a Zaribo:
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

gregsaun, 2020-07-29:
Here are the OBJ, I used the proposed @3d-gussner plugin, it
[bear21_mk3s_simulator_02.zip](https://github.com/vintagepc/MK404/files/4994669/bear21_mk3s_simulator_02.zip)
seems to work well.

I made a complete assembly OBJ and also separated axis OBJs.

3d-gussner, 2020-07-29:
> I made a complete assembly OBJ and also separated axis OBJs.

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
Looks like some components don't have the correct material ;-)

gregsaun, 2020-07-29:
Yeah I save some time with not setting all the material. I have a print settings and BOM for that ;)

vintagepc, 2020-07-29:
Let's not get too caught up - the materials are trivial to manipulate, so it's relatively easy to swap one for the other. I can work with what we have, I think, so the time spent trying to get it to export perfectly is probably more than the time for me to just edit the file.  :+1:

I'm working on the model-swapping framework now, once that's in hopefully it's pretty trivial to add the models and take it from there.

gregsaun, 2020-07-29:
If I could avoid to change all materials and redoing a exports, pushing to github source files and so on I would appreciate :D . But if this become a too big work I can figure it out. Why is the type of material important? I mean what is important is to have different material, isn't it?

vintagepc, 2020-07-29:
The mtl files that are paired with the OBJ define how the object renders - that is why the material as a whole matters, not just the name. If you look in the .mtl file with a text editor, then you can see that each material has a set of properties that define things like colour, reflectiveness, etc. and these are used directly to set the appearance of the polygons during the render.

It would have been very nice to be able to export the obj+mtl together and use as-is without extra work, but as it is we'd either need to spend a bunch of time fiddling with the source CAD files to get it to export correctly via some ill-defined pathway, or I can spend an hour or so changing material names in the .obj/mtl file by hand. That only gets unpleasant if models have to be updated regularly.

Results are viewable with GLC_player. so if you'd like to try your hand at it, it is relatively straightforward, if a little tedious:
- Open the .obj file with a good text editor that can handle large files.
- If changing the .mtl file, edit the `mtllib` line to match the name of the new .mtl file. May or may not be needed depending on what we got from the export, I haven't looked at the new files yet. Materials can be transplanted from one .mtl file to another by copy-pasting their text blocks.
- Find the `usemtl` command for the body you wish to change, and edit the material name to the new one.
- Reload the obj in glc_player and observe the changes.
- Repeat. the previous two steps until satisfied. :grin:

gregsaun, 2020-07-29:
Okay that make sense, in this case I prefer to set properly everything in CAD (I don't like to redo stuffs). However, my parameters might be different than the other Prusa you already have in your simulator (but probably closer).

In Fusion 360 there is the appearance and the physical material. Looks like MTL take only the appearance into account, am I correct?

vintagepc, 2020-07-29:
Perhaps that is it - unfortunately I cannot say for sure as I haven't dived into the MTL exports from Fusion after our initial failure with the 3S model. We found it just worked from Solidworks so went with that, also since it was the format of the original source we used.

Should be easy to identify though with a simple test model that has two cubes, one with a material and one with an appearance set, and seeing which one comes out correctly.

It doesn't help that the term "material" is being used in different contexts in the different tools :roll_eyes:

gregsaun, 2020-07-29:
Okay after more testing it does not seem to have trace of physical material from Fusion 360, it only uses appearance. That makes my job a little easier then. Do you still want separated OBJ for all axis or doing a single one is enough for you now that I know how to set things correctly?

vintagepc, 2020-07-29:
That's excellent!

I would still prefer separate objects for each axis (essentially, collection of bodies that need to move together, independent of other bodies). It's probably possible to do it with a single OBJ, but I don't think that's very maintainable longer term - it would fall apart pretty quickly if the models changed.

vintagepc, 2020-07-30:
Lighting weirdness aside, making progress!

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

gregsaun, 2020-07-30:
Hu that is some progress! I should share the OBJ with proper material soon ;)

vintagepc, 2020-07-30:
I may end up editing the materials slightly at the end, it looks like Fusion only exports a Kd (diffuse) parameter.
This results in a very muted appearance in the object. For example, the knob and SD card (which also have ambient and specular parameters) vs the display housing:

I'll have to dive into the lighting again to see if that's truly the case since it doesn't render as poorly in GLC player. We'll see.

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

gregsaun, 2020-07-30:
Okay let me know if I can help you in a way. I used the plugin maybe I can try again from Fusion 360 directly if you like.

Here is the export:
[bear21_mk3s_simulator_03.zip](https://github.com/vintagepc/MK404/files/5002396/bear21_mk3s_simulator_03.zip)

I have included a full export in case you need some other parts like the know and fans. Note that the hotend fan in the full assembly has been designed by myself and looks like a Sunon. The LCD knob is a little different but very close. The print fan is also my own model and should be close.

gregsaun, 2020-07-30:
Wait, it looks like the extrusion does not have the correct rendering. Let me export it again.

vintagepc, 2020-07-30:
Ah, OK - if you are using different fan models/knobs, then feel free to export those models separately too. The outer "shell" of the fan can remain part of the E assembly, I would just need the rotor as a standalone piece because we spin it if the fan is on.

gregsaun, 2020-07-30:
Okay I will do that!

gregsaun, 2020-07-30:
Okay here you have everything:
[bear21_mk3s_simulator_04.zip](https://github.com/vintagepc/MK404/files/5002564/bear21_mk3s_simulator_04.zip)

I have included two version of the extruder, with and without the hotend fan "outer shell". If it is too much work for you go with the fan and knob you already use.

vintagepc, 2020-07-30:
Great. The added work to swap out the model is minimal, the bulk of it just comes from setting up the positioning relative to the model - and that's also fairly minor.

The real bear (heh) is the backend framework, but that's not really an impediment, we need it anyway since the intent is that we'll ultimately support completely different printer "models" which may not even look anything like a MK3, so a layer of abstraction between the drawing and the actual model components is a good thing to have. :+1:

gregsaun, 2020-07-30:
That all sounds very nice, looking forward to test this :)

vintagepc, 2020-07-30:
Whoops- looks like you left the print fan shroud hidden by accident in the E export.

gregsaun, 2020-07-31:
This is normal, the shroud is completely different than the Prusa one.

vintagepc, 2020-07-31:
Sorry, maybe I'm misunderstanding - I'm referring to the outer housing of the part cooling fan, the 5150 blower.

The hot-end cooling fan shroud is present and accounted for :+1:

Getting close, I now just need to fix the lighting and un-break all the things I broke in the "standard" 3d models 😁

gregsaun, 2020-07-31:
Ha sorry, you can reuse the complete print fan you have for Original Prusa for that :). Looking forward to see it!

vintagepc, 2020-08-01:
Getting closer, I think I've sorted the lighting.

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

The motors looking weird is a WIP, I've filed a bug/info request with https://github.com/tinyobjloader/tinyobjloader/issues/279

Part fan shroud is still missing, I need to extract the model from the 3S extruder first.

Hopefully I can wrap this up tomorrow!

gregsaun, 2020-08-01:
It start to look good! I was wondering how the motors would render due to the material set on faces...

Do you want the print fan shroud without the blades? Mine is one piece normally and has no blade but I can try to remove them for you if you like.

Quick question, I saw you are using a different color for the LCD screen, is there a reason for that? I am asking because I have made an Inkscape SVG project for writing the menu in my assembly guides so it would be nice to use the simulator for that. Just a nice to have, nothing urgent or mandatory ;)

vintagepc, 2020-08-01:
That particular color combo is easier to read in the 3d graphics. the 2D display/control panel view is blue and white by default:

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

Also, I'm partial because that's what my real display looks like... :grin:

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

gregsaun, 2020-08-01:
Ok I see, hard to read I agree. I was suspecting you did upgrade the real LCD screen haha :D

vintagepc, 2020-08-01:
If you can easily export the shroud sans the center blade, that would save me some time - thanks.

gregsaun, 2020-08-01:
I'll do it now

vintagepc, 2020-08-01:
I posted a guide on the display mod here:
https://forum.prusaprinters.org/forum/original-prusa-i3-mk3s-mk3-user-mods-octoprint-enclosures-nozzles-.../a-very-much-needed-improvement/

It's not an off-the shelf part or LCD module.

gregsaun, 2020-08-01:
Oh that was you, nice!

gregsaun, 2020-08-01:
I know I have seen your nickname few times :D

Here is the print fan:
[bear21_mk3s_simulator_print_fan.zip](https://github.com/vintagepc/MK404/files/5010518/bear21_mk3s_simulator_print_fan.zip)

vintagepc, 2020-08-01:
It is dangerous to be a man of many skills and with far too much free time... :rofl:

Thanks, will get that shroud in at some point.

gregsaun, 2020-08-01:
Oh yeah I know very well what you mean hahaha

vintagepc, 2020-08-01:
I think I've got all the issues ironed out, though I turned the per-face material issue into a separate bug.
`./MK404 -g bear`

gregsaun, 2020-08-02:
Thank you very much!

I tried to launch your latest release and I get this error:
```
$ ./MK404 -h
./MK404: error while loading shared libraries: libGLEW.so.2.0: cannot open shared object file: No such file or directory
```

I have compiled master branch and I can launch it. To compile it successfully I had to add few libraries including the one linked in the error message. However, I have a "printer not found" message on the LCD emulator window.

For information, I am on a VM through virtualbox with fresh Ubuntu installation (minimal).

vintagepc, 2020-08-02:
hmm... what glew version does the system have? I'm using 2.1.0

gregsaun, 2020-08-02:
I have 2.1.0 as well. The symbolic links worked: `ln -s /usr/lib/x86_64-linux-gnu/libGLEW.so.2.1.0 /usr/lib/libGLEW.so.2.0` .

vintagepc, 2020-08-02:
awesome! :tada:

vintagepc, 2020-08-05:
Just an FYI @gregsaun - no affiliation/association with Marlin (re your tweet). We were just fortunate to get featured because we'd invited one of the Marlin devs as an early beta tester. :+1:

gregsaun, 2020-08-05:
I was thinking that I was wrong so thanks for clarification, will add a note to the tweet. 👍

Closed 2020-08-02.

Thread 188 (2020-07-27):

[BUG] Does not render with nVidia GL drivers.

sl1pkn07, 2020-07-27:
**Describe the bug**
A clear and concise description of what the bug is. Please make sure you've searched for existing bug reports before creating a new one.

run fail when launch MK404

**To Reproduce**
Steps to reproduce the behavior:
1. Go to '...'
2. Click on '....'
3. Scroll down to '....'
4. See error

Build project with:

cmake 3.18.0
gcc 10.1.0
glew 2.2.0
glu 9.0.1
sdl 1.2.15 (i'm not sure if use this one or sdl2)
sdl2 2.0.12 (i'm not sure if use this one or sdl1)
xorg 1.20.8
2060RTX (Nvidia vulkan drivers 440.66.17)
KDE 5.19.3
picocom 3.1

**Expected behavior**
run

**Screenshots**

~~~
┌─┤[$]|[sl1pkn07]|[sL1pKn07]|[/tmp/makepkg/mk404-git/src/MK404/build]|
└───╼  ./MK404
ScriptHost: NOTE: Duplicate context name (Thermistor) with different pointer. Incrementing ID...
ScriptHost: NOTE: Duplicate context name (Thermistor) with different pointer. Incrementing ID...
ScriptHost: NOTE: Duplicate context name (Thermistor) with different pointer. Incrementing ID...
ScriptHost: NOTE: Duplicate context name (Fan) with different pointer. Incrementing ID...
Creating pinspec for atmega2560
Loading 262144 bytes of XFLASH
Read 262145 bytes
Loading 4096 bytes of EEPROM
Read 4096 bytes
NOTE: No firmware load requested, Einsy executing purely from flash memory.
read_ihex_chunks: stk500boot_v2_mega2560.hex, unsupported check type 03
Loaded 4202 bytes from HEX file: stk500boot_v2_mega2560.hex
Initialized VCD file Einsy_atmega2560_VCD.vcd
uart_pty_init bridge on port *** /dev/pts/4 ***
Connect: /tmp/simavr-uart2 now points to /dev/pts/4
note: export SIMAVR_UART_XTERM=1 and install picocom to get a terminal
uart_pty_init bridge on port *** /dev/pts/5 ***
Autodetected SD image size as 256 Mb
Init on ADC 0 start 25.00
Init on ADC 2 start 25.00
Init on ADC 3 start 25.00
Init on ADC 6 start 25.00
LCD: 37uS is 592 cycles for your AVR
LCD: 1uS is 16 cycles for your AVR
MK3S - adding IR sensor.
Validating script...
Script validation finished.
Starting atmega2560 execution...
MCUSR: 01
RESET
Button released after 16 usec
MCUSR: 00
OnCmdReady activating 4 bits mode
X Error of failed request:  GLXBadContextTag
  Major opcode of failed request:  151 (GLX)
  Minor opcode of failed request:  26 (X_GLXMakeContextCurrent)
  Serial number of failed request:  623
  Current serial number in output stream:  623
~~~

**Desktop (please complete the following information):**
 - OS: [e.g. iOS]
 - Version [e.g. 22]

Archlinux

**Additional context**
Add any other context about the problem here - printer model, what firmware file you are running, etc.

build with:

~~~
  cmake -S MK404 -B MK404/build \
    -DCMAKE_BUILD_TYPE=None \
    -DCMAKE_INSTALL_PREFIX=/usr

  make -C MK404/build VERBOSE=1 Einsy_atmega2560_SDcard.bin UpdateDocs
~~~

the gcode file in SDCard is a simply 3DBenchi gcoded by prusa-slicer

vintagepc, 2020-07-27:
Hm, this looks like an issue with NV-GLX.  I get weirdness using primus/optirun on my hybrid machine too, but mesa is fine.

sl1pkn07, 2020-07-27:
same with 450.56.02

vintagepc, 2020-07-27:
🤔 Unfortunately I don't get GLXBadContext, but I get a black window for the LCD section and a weirdly scaled one for the 3d visuals. But the underlying cause is probably the same. I'll dig in tonight.

vintagepc, 2020-07-27:
I'm still not sure what's going on here. I'm by no means a GL person, so my best guess is something about the nvidia GL extension or drivers is unhappy. Unfortunately that means figuring this out is going to likely take a good chunk of time

I can't reproduce your exact problem even on a machine with a dedicated 1050 (430) the closest I get is black/blank windows under the nvidia driver. I'm hopeful if I resolve one it will resolve the other.

Does it start working correctly if you temporarily change to nouveau as your video driver?

sl1pkn07, 2020-07-27:
nouveau is no-op for me. i preefer wait

greetings

vintagepc, 2020-07-28:
@leptun @3d-gussner @wavexx could you chime in with what video drivers are on the system you've been using with MK404? Curious to see what data points we have and whether anyone has tried ATI/fglrx or a working nvidia setup.

3d-gussner, 2020-07-28:
I run hyper-v Ubuntu VM not sure what gpu is used. Have a look tomorrow

vintagepc, 2020-07-28:
OK, most likely Mesa/software GL then.

wavexx, 2020-07-28:
I'm using linux on the iHD Kabylake Intel drivers (kms). This is mesa with dri3 acceleration.

But truth be told, I remember early on I also had similar issues when starting without the fancy graphics triggering a bad context too. There's some timing issue IMHO.

vintagepc, 2020-07-28:
OK, sounds like you're probably also using the Mesa stack.

Yeah, in the early stages there was definitely a bad init/setup that got fixed after I did a GL cleanup merge.

But you have a good suggestion that may offer some insight - @sl1pkn07 what happens if you launch with `MK404 -f <firmware file> -g fancy`? Does it still choke?

sl1pkn07, 2020-07-28:
do more things, but finaly crash with same error

~~~
└───╼  ./MK404 -f MK3S.afx -g fancy
ScriptHost: NOTE: Duplicate context name (Thermistor) with different pointer. Incrementing ID...
ScriptHost: NOTE: Duplicate context name (Thermistor) with different pointer. Incrementing ID...
ScriptHost: NOTE: Duplicate context name (Thermistor) with different pointer. Incrementing ID...
ScriptHost: NOTE: Duplicate context name (Fan) with different pointer. Incrementing ID...
Creating pinspec for atmega2560
Loading 262144 bytes of XFLASH
Read 262145 bytes
Loading 4096 bytes of EEPROM
Read 4096 bytes
Loaded 227176 .text at address 0x0
Loaded 1120 .data
Loaded 228296 bytes from ELF file: MK3S.afx
read_ihex_chunks: stk500boot_v2_mega2560.hex, unsupported check type 03
Loaded 4202 bytes from HEX file: stk500boot_v2_mega2560.hex
Initialized VCD file Einsy_atmega2560_VCD.vcd
uart_pty_init bridge on port *** /dev/pts/3 ***
Connect: /tmp/simavr-uart2 now points to /dev/pts/3
note: export SIMAVR_UART_XTERM=1 and install picocom to get a terminal
uart_pty_init bridge on port *** /dev/pts/4 ***
Autodetected SD image size as 256 Mb
Init on ADC 0 start 25.00
Init on ADC 2 start 25.00
Init on ADC 3 start 25.00
Init on ADC 6 start 25.00
LCD: 37uS is 592 cycles for your AVR
LCD: 1uS is 16 cycles for your AVR
MK3S - adding IR sensor.
# of vertices  = 19840
# of normals   = 19840
# of texcoords = 19840
# of materials = 7
# of shapes    = 7
shape[0] # of triangles = 3780
shape[1] # of triangles = 3456
shape[2] # of triangles = 1158
shape[3] # of triangles = 4110
shape[4] # of triangles = 3654
shape[5] # of triangles = 2724
shape[6] # of triangles = 1446
m_extMin = 0.023854, 0.043530, 0.155235
m_extMax = 0.277659, 0.087820, 0.436635
# of vertices  = 5188
# of normals   = 10226
# of texcoords = 0
# of materials = 3
# of shapes    = 3
shape[0] # of triangles = 9212
shape[1] # of triangles = 82
shape[2] # of triangles = 932
m_extMin = 65.015419, 26.029099, 482.844208
m_extMax = 97.015419, 43.888569, 500.724396
# of vertices  = 6163
# of normals   = 6163
# of texcoords = 6163
# of materials = 2
# of shapes    = 2
shape[0] # of triangles = 1724
shape[1] # of triangles = 3208
m_extMin = 0.000146, 0.000000, -0.241146
m_extMax = 0.252145, 0.001010, -0.000145
# of vertices  = 1047
# of normals   = 1047
# of texcoords = 1047
# of materials = 1
# of shapes    = 1
shape[0] # of triangles = 1112
m_extMin = -0.009985, -0.009978, -0.000000
m_extMax = 0.009985, 0.018222, 0.007500
# of vertices  = 200
# of normals   = 396
# of texcoords = 0
# of materials = 1
# of shapes    = 1
shape[0] # of triangles = 396
m_extMin = 46.079296, 354.172272, 329.399445
m_extMax = 84.364838, 392.561951, 331.699463
# of vertices  = 523
# of normals   = 1042
# of texcoords = 0
# of materials = 22
# of shapes    = 1
shape[0] # of triangles = 1042
m_extMin = 35.197029, 310.214874, 263.804108
m_extMax = 43.197029, 346.190918, 299.794464
# of vertices  = 3418
# of normals   = 3418
# of texcoords = 3418
# of materials = 1
# of shapes    = 1
shape[0] # of triangles = 3020
m_extMin = -0.019420, 0.003200, -0.019473
m_extMax = 0.019500, 0.013700, 0.019482
# of vertices  = 61547
# of normals   = 61547
# of texcoords = 61547
# of materials = 22
# of shapes    = 22
shape[0] # of triangles = 29370
shape[1] # of triangles = 355
shape[2] # of triangles = 81
shape[3] # of triangles = 6032
shape[4] # of triangles = 3229
shape[5] # of triangles = 84
shape[6] # of triangles = 2
shape[7] # of triangles = 1709
shape[8] # of triangles = 688
shape[9] # of triangles = 915
shape[10] # of triangles = 38
shape[11] # of triangles = 33
shape[12] # of triangles = 33
shape[13] # of triangles = 33
shape[14] # of triangles = 72
shape[15] # of triangles = 232
shape[16] # of triangles = 4822
shape[17] # of triangles = 672
shape[18] # of triangles = 4026
shape[19] # of triangles = 408
shape[20] # of triangles = 4592
shape[21] # of triangles = 568
m_extMin = 0.034474, 0.294235, 0.199199
m_extMax = 0.111464, 0.396185, 0.344493
# of vertices  = 33710
# of normals   = 33710
# of texcoords = 33710
# of materials = 19
# of shapes    = 19
shape[0] # of triangles = 5368
shape[1] # of triangles = 4636
shape[2] # of triangles = 2470
shape[3] # of triangles = 672
shape[4] # of triangles = 5682
shape[5] # of triangles = 6032
shape[6] # of triangles = 3229
shape[7] # of triangles = 84
shape[8] # of triangles = 2
shape[9] # of triangles = 1709
shape[10] # of triangles = 688
shape[11] # of triangles = 915
shape[12] # of triangles = 38
shape[13] # of triangles = 33
shape[14] # of triangles = 33
shape[15] # of triangles = 33
shape[16] # of triangles = 72
shape[17] # of triangles = 232
shape[18] # of triangles = 704
m_extMin = -0.082891, 0.310235, 0.201549
m_extMax = 0.344759, 0.374685, 0.277674
# of vertices  = 151575
# of normals   = 151575
# of texcoords = 151575
# of materials = 54
# of shapes    = 54
shape[0] # of triangles = 13603
shape[1] # of triangles = 1248
shape[2] # of triangles = 8204
shape[3] # of triangles = 14726
shape[4] # of triangles = 2722
shape[5] # of triangles = 9512
shape[6] # of triangles = 25728
shape[7] # of triangles = 704
shape[8] # of triangles = 6032
shape[9] # of triangles = 3229
shape[10] # of triangles = 84
shape[11] # of triangles = 2
shape[12] # of triangles = 688
shape[13] # of triangles = 915
shape[14] # of triangles = 38
shape[15] # of triangles = 33
shape[16] # of triangles = 33
shape[17] # of triangles = 33
shape[18] # of triangles = 72
shape[19] # of triangles = 232
shape[20] # of triangles = 1328
shape[21] # of triangles = 3779
shape[22] # of triangles = 3307
shape[23] # of triangles = 122
shape[24] # of triangles = 380
shape[25] # of triangles = 2678
shape[26] # of triangles = 228
shape[27] # of triangles = 2325
shape[28] # of triangles = 1261
shape[29] # of triangles = 803
shape[30] # of triangles = 2874
shape[31] # of triangles = 726
shape[32] # of triangles = 124
shape[33] # of triangles = 8206
shape[34] # of triangles = 5067
shape[35] # of triangles = 118
shape[36] # of triangles = 1165
shape[37] # of triangles = 44
shape[38] # of triangles = 556
shape[39] # of triangles = 34
shape[40] # of triangles = 194
shape[41] # of triangles = 308
shape[42] # of triangles = 767
shape[43] # of triangles = 344
shape[44] # of triangles = 142
shape[45] # of triangles = 100
shape[46] # of triangles = 74
shape[47] # of triangles = 38
shape[48] # of triangles = 778
shape[49] # of triangles = 12
shape[50] # of triangles = 24
shape[51] # of triangles = 5212
shape[52] # of triangles = 54
shape[53] # of triangles = 6490
m_extMin = -0.037741, 0.015460, 0.102499
m_extMax = 0.345554, 0.392379, 0.524248
# of vertices  = 2280
# of normals   = 4588
# of texcoords = 0
# of materials = 2
# of shapes    = 1
shape[0] # of triangles = 4588
m_extMin = 46.971825, 359.662842, 261.699463
m_extMax = 85.971825, 397.184845, 289.699463
Validating script...
Script validation finished.
Starting atmega2560 execution...
MCUSR: 01
RESET
Button released after 16 usec
X Error of failed request:  GLXBadContextTag
  Major opcode of failed request:  151 (GLX)
  Minor opcode of failed request:  26 (X_GLXMakeContextCurrent)
  Serial number of failed request:  729
  Current serial number in output stream:  729
~~~

vintagepc, 2020-08-02:
For my own reference, MVE with the same issue. Works with MESA, black screen with nvidia.
(rename to .cpp)
[example.txt](https://github.com/vintagepc/MK404/files/5012432/example.txt)

vintagepc, 2020-08-02:
I think I may have found the cause. Apparently freeglut does not like being pushed to a background thread, and doing so causes all kinds of interesting issues.

@sl1pkn07  can you check out and try this branch?
https://github.com/vintagepc/MK404/tree/188-freeglut-threading

if it fixes the issue for you I'll clean it up and merge.

sl1pkn07, 2020-08-02:
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

weee

sl1pkn07, 2020-08-02:
also, i have some changes in the CMake Scripts for use SDL2 instead SDL(1) and chech GL, GLUT and GLEW througth CMake
(also use speces instead of tabs)

~~~patch
diff --git a/CMakeLists.txt b/CMakeLists.txt
index 15e6929..28c2897 100644
--- a/CMakeLists.txt
+++ b/CMakeLists.txt
@@ -22,115 +24,115 @@ set (FIRMWARE
     )

 set(H_FILES
-	parts/ADCPeripheral.h
-	parts/PinNames.h
-	parts/BasePeripheral.h
-	parts/boards/EinsyRambo.h
-	parts/boards/MM_Control_01.h
-	parts/PrinterFactory.h
-	parts/wiring/Einsy_1_1a.h
-	parts/wiring/MM_Control_01.h
-	parts/wiring/Einsy_1_0a.h
-	parts/ScriptHost.h
-	parts/pinspecs/PinSpec_2560.h
-	parts/pinspecs/PinSpec_32u4.h
-	parts/PinSpec.h
-	parts/SoftPWMable.h
-	parts/TelemetryHost.h
-	parts/Printer.h
-	parts/SPIPeripheral.h
-	parts/Scriptable.h
-	parts/Board.h
-	parts/components/LED.h
-	parts/components/PINDA.h
-	parts/components/HD44780GL.h
-	parts/components/SDCard.h
-	parts/components/uart_pty.h
-	parts/components/hd44780_charROM.h
-	parts/components/UART_Logger.h
-	parts/components/RotaryEncoder.h
-	parts/components/EEPROM.h
-	parts/components/Thermistor.h
-	parts/components/Fan.h
-	parts/components/ADC_Buttons.h
-	parts/components/VoltageSrc.h
-	parts/components/w25x20cl.h
-	parts/components/Beeper.h
-	parts/components/HD44780.h
-	parts/components/SerialLineMonitor.h
-	parts/components/HC595.h
-	parts/components/Button.h
-	parts/components/MMU2.h
-	parts/components/PAT9125.h
-	parts/components/GCodeSniffer.h
-	parts/components/TMC2130.h
-	parts/components/IRSensor.h
-	parts/components/Heater.h
-	parts/IScriptable.h
-	parts/PinSpec_Helper.h
-	parts/Wiring.h
-#	parts/IRQHelper.h  Can't be checked/used standalone.
-	parts/printers/Prusa_MK3S.h
-	parts/printers/Prusa_MK3SMMU2.h
-	parts/printers/Prusa_MK3MMU2.h
-	utility/Color.h
-	utility/GLPrint.h
-	utility/FatImage.h
-	utility/MK3SGL.h
-	utility/GLObj.h
-	utility/OBJCollection.h
-	utility/SerialPipe.h
-	utility/Macros.h
-	utility/thermistortables.h
-	utility/MK3/Configuration_prusa.h
-	utility/MK3/eeprom.h
-	utility/Util.h
-	3rdParty/arcball/Camera.hpp
-	3rdParty/arcball/Matrix.hpp
-	3rdParty/arcball/Vectors.hpp
-	3rdParty/arcball/ArcBall.hpp
-	3rdParty/arcball/Quaternion.hpp
+    parts/ADCPeripheral.h
+    parts/PinNames.h
+    parts/BasePeripheral.h
+    parts/boards/EinsyRambo.h
+    parts/boards/MM_Control_01.h
+    parts/PrinterFactory.h
+    parts/wiring/Einsy_1_1a.h
+    parts/wiring/MM_Control_01.h
+    parts/wiring/Einsy_1_0a.h
+    parts/ScriptHost.h
+    parts/pinspecs/PinSpec_2560.h
+    parts/pinspecs/PinSpec_32u4.h
+    parts/PinSpec.h
+    parts/SoftPWMable.h
+    parts/TelemetryHost.h
+    parts/Printer.h
+    parts/SPIPeripheral.h
+    parts/Scriptable.h
+    parts/Board.h
+    parts/components/LED.h
+    parts/components/PINDA.h
+    parts/components/HD44780GL.h
+    parts/components/SDCard.h
+    parts/components/uart_pty.h
+    parts/components/hd44780_charROM.h
+    parts/components/UART_Logger.h
+    parts/components/RotaryEncoder.h
+    parts/components/EEPROM.h
+    parts/components/Thermistor.h
+    parts/components/Fan.h
+    parts/components/ADC_Buttons.h
+    parts/components/VoltageSrc.h
+    parts/components/w25x20cl.h
+    parts/components/Beeper.h
+    parts/components/HD44780.h
+    parts/components/SerialLineMonitor.h
+    parts/components/HC595.h
+    parts/components/Button.h
+    parts/components/MMU2.h
+    parts/components/PAT9125.h
+    parts/components/GCodeSniffer.h
+    parts/components/TMC2130.h
+    parts/components/IRSensor.h
+    parts/components/Heater.h
+    parts/IScriptable.h
+    parts/PinSpec_Helper.h
+    parts/Wiring.h
+#    parts/IRQHelper.h  Can't be checked/used standalone.
+    parts/printers/Prusa_MK3S.h
+    parts/printers/Prusa_MK3SMMU2.h
+    parts/printers/Prusa_MK3MMU2.h
+    utility/Color.h
+    utility/GLPrint.h
+    utility/FatImage.h
+    utility/MK3SGL.h
+    utility/GLObj.h
+    utility/OBJCollection.h
+    utility/SerialPipe.h
+    utility/Macros.h
+    utility/thermistortables.h
+    utility/MK3/Configuration_prusa.h
+    utility/MK3/eeprom.h
+    utility/Util.h
+    3rdParty/arcball/Camera.hpp
+    3rdParty/arcball/Matrix.hpp
+    3rdParty/arcball/Vectors.hpp
+    3rdParty/arcball/ArcBall.hpp
+    3rdParty/arcball/Quaternion.hpp
 )

 set(MK404_SOURCES
-	parts/Board.cpp
-	parts/boards/MM_Control_01.cpp
-	parts/boards/EinsyRambo.cpp
-	parts/ScriptHost.cpp
-	parts/TelemetryHost.cpp
-	parts/components/GCodeSniffer.cpp
-	parts/components/Beeper.cpp
-	parts/components/HD44780GL.cpp
-	parts/components/VoltageSrc.cpp
-	parts/components/ADC_Buttons.cpp
-	parts/components/Heater.cpp
-	parts/components/EEPROM.cpp
-	parts/components/IRSensor.cpp
-	parts/components/w25x20cl.cpp
-	parts/components/HD44780.cpp
-	parts/components/UART_Logger.cpp
-	parts/components/SDCard.cpp
-	parts/components/MMU2.cpp
-	parts/components/PINDA.cpp
-	parts/components/TMC2130.cpp
-	parts/components/SerialLineMonitor.cpp
-	parts/components/LED.cpp
-	parts/components/HC595.cpp
-	parts/components/RotaryEncoder.cpp
-	parts/components/uart_pty.cpp
-	parts/components/Thermistor.cpp
-	parts/components/Fan.cpp
-	parts/components/Button.cpp
-	parts/printers/Prusa_MK3S.cpp
-	parts/printers/Prusa_MK3SMMU2.cpp
-	utility/MK3SGL.cpp
-	utility/GLObj.cpp
-	utility/FatImage.cpp
-	utility/GLPrint.cpp
-	utility/Color.cpp
-	utility/SerialPipe.cpp
-	3rdParty/arcball/Camera.cpp
+    parts/Board.cpp
+    parts/boards/MM_Control_01.cpp
+    parts/boards/EinsyRambo.cpp
+    parts/ScriptHost.cpp
+    parts/TelemetryHost.cpp
+    parts/components/GCodeSniffer.cpp
+    parts/components/Beeper.cpp
+    parts/components/HD44780GL.cpp
+    parts/components/VoltageSrc.cpp
+    parts/components/ADC_Buttons.cpp
+    parts/components/Heater.cpp
+    parts/components/EEPROM.cpp
+    parts/components/IRSensor.cpp
+    parts/components/w25x20cl.cpp
+    parts/components/HD44780.cpp
+    parts/components/UART_Logger.cpp
+    parts/components/SDCard.cpp
+    parts/components/MMU2.cpp
+    parts/components/PINDA.cpp
+    parts/components/TMC2130.cpp
+    parts/components/SerialLineMonitor.cpp
+    parts/components/LED.cpp
+    parts/components/HC595.cpp
+    parts/components/RotaryEncoder.cpp
+    parts/components/uart_pty.cpp
+    parts/components/Thermistor.cpp
+    parts/components/Fan.cpp
+    parts/components/Button.cpp
+    parts/printers/Prusa_MK3S.cpp
+    parts/printers/Prusa_MK3SMMU2.cpp
+    utility/MK3SGL.cpp
+    utility/GLObj.cpp
+    utility/FatImage.cpp
+    utility/GLPrint.cpp
+    utility/Color.cpp
+    utility/SerialPipe.cpp
+    3rdParty/arcball/Camera.cpp
 )

 add_executable(MK404 MK404.cpp ${MK404_SOURCES} ${H_FILES} ${FIRMWARE})
@@ -141,11 +143,11 @@ target_compile_options(MK404 PRIVATE -Wall)
 option(BUILD_WERROR "Build with Warnings as Errors" 1)

 if (BUILD_WERROR)
-	target_compile_options(MK404 PRIVATE -Werror)
+    target_compile_options(MK404 PRIVATE -Werror)
 endif()

 if (ENABLE_THREAD_SANITY)
-	target_compile_options(MK404 PRIVATE -fsanitize=thread)
+    target_compile_options(MK404 PRIVATE -fsanitize=thread)
 endif()

 execute_process(COMMAND ${CMAKE_C_COMPILER} -dumpmachine OUTPUT_VARIABLE SIMAVR_BIN_DIR OUTPUT_STRIP_TRAILING_WHITESPACE)
@@ -173,9 +175,9 @@ message("Defining simavr location as ${LIBSIMAVR}")
 target_include_directories (MK404 PUBLIC
                             "${PROJECT_BINARY_DIR}"
                             "${PROJECT_SOURCE_DIR}/3rdParty/simavr/simavr/sim/"
-							"${PROJECT_SOURCE_DIR}/3rdParty/TCLAP/include/"
+                            "${PROJECT_SOURCE_DIR}/3rdParty/TCLAP/include/"
                             "${PROJECT_SOURCE_DIR}/include"
-							"${PROJECT_SOURCE_DIR}/"
+                            "${PROJECT_SOURCE_DIR}/"
                             "${PROJECT_SOURCE_DIR}/parts"
                             "${PROJECT_SOURCE_DIR}/parts/boards"
                             "${PROJECT_SOURCE_DIR}/parts/components"
@@ -190,13 +192,18 @@ include_directories("${PROJECT_SOURCE_DIR}/3rdParty/tinyobjloader/")

 find_package(LibElf REQUIRED)
-include_directories(${LIBELF_INCLUDE_DIRS})
+find_package(OpenGL REQUIRED)
+find_package(GLUT REQUIRED)
+find_package(GLEW REQUIRED)
+include(FindPkgConfig)
+PKG_SEARCH_MODULE(SDL2 REQUIRED sdl2)
+include_directories(${LIBELF_INCLUDE_DIRS} ${OPENGL_INCLUDE_DIRS} ${GLUT_INCLUDE_DIRS} ${GLEW_INCLUDE_DIRS} ${SDL2_INCLUDE_DIRS})

 if (ENABLE_THREAD_SANITY)
-	target_link_libraries(MK404 -fsanitize=thread)
+    target_link_libraries(MK404 -fsanitize=thread)
 endif()

-target_link_libraries(MK404 pthread util glut GL GLU GLEW m SDL tinyobjloader ${LIBSIMAVR} ${LIBELF_LIBRARIES})
+target_link_libraries(MK404 pthread util ${OPENGL_LIBRARIES} ${GLUT_LIBRARIES} ${GLEW_LIBRARIES} m ${SDL2_LIBRARIES} tinyobjloader ${LIBSIMAVR} ${LIBELF_LIBRARIES})

 add_custom_command(TARGET MK404 POST_BUILD
                     COMMAND ${CMAKE_COMMAND} -E copy_if_different
@@ -214,8 +221,8 @@ add_custom_command(TARGET MK404 POST_BUILD
 # Copies the models/materials:

 file(GLOB_RECURSE MODEL_FILES
-	"assets/*.obj"
-	"assets/*.mtl"
+    "assets/*.obj"
+    "assets/*.mtl"
 )

 add_custom_command(TARGET MK404 POST_BUILD
@@ -227,7 +234,7 @@ add_custom_command(TARGET MK404 POST_BUILD

 add_custom_target(CPPCheck COMMAND cppcheck --error-exitcode=2 --std=c++11 --language=c++ ${MK404_SOURCES} ${H_FILES}
-	WORKING_DIRECTORY ${PROJECT_SOURCE_DIR})
+    WORKING_DIRECTORY ${PROJECT_SOURCE_DIR})

 add_custom_target(Build_Run COMMAND cd ${PROJECT_BINARY_DIR} && ./MK404 &)
 add_dependencies(Build_Run MK404)
@@ -245,34 +252,34 @@ add_custom_target(Einsy_atmega2560_SDcard.bin COMMAND mcopy -vsi FAT32.img ${PRO
 add_dependencies(Einsy_atmega2560_SDcard.bin FAT32.img)

 add_custom_target(UpdateDocs
-	COMMAND cd ${PROJECT_BINARY_DIR} && ./MK404 -g none --scripthelp --markdown | grep -A500 "Scripting options" > ${PROJECT_SOURCE_DIR}/ref/Scripting_MK3S.md
-	COMMAND cd ${PROJECT_BINARY_DIR} && ./MK404 -g none --scripthelp --markdown Prusa_MK3SMMU2 | grep -A500 "Scripting options" > ${PROJECT_SOURCE_DIR}/ref/Scripting_MK3SMMU2.md
-	COMMAND cd ${PROJECT_BINARY_DIR} && ./MK404 -g none --scripthelp --markdown Prusa_MK3MMU2 | grep -A500 "Scripting options" > ${PROJECT_SOURCE_DIR}/ref/Scripting_MK3MMU2.md
-	COMMAND cd ${PROJECT_BINARY_DIR} && ./MK404 -g none --scripthelp --markdown Prusa_MK3 | grep -A500 "Scripting options" > ${PROJECT_SOURCE_DIR}/ref/Scripting_MK3.md
-	COMMAND echo '```' > ${PROJECT_SOURCE_DIR}/ref/CommandLine.md
-	COMMAND cd ${PROJECT_BINARY_DIR} && ./MK404 --help >> ${PROJECT_SOURCE_DIR}/ref/CommandLine.md
-	COMMAND echo '```' >> ${PROJECT_SOURCE_DIR}/ref/CommandLine.md
-	COMMAND cd ${PROJECT_BINARY_DIR} && ./MK404 -g none --markdown --trace ? | grep -A500 "telemetry" > ${PROJECT_SOURCE_DIR}/ref/TraceOptions_MK3S.md
-	COMMAND cd ${PROJECT_BINARY_DIR} && ./MK404 -g none --markdown --trace ? Prusa_MK3SMMU2| grep -A500 "telemetry" > ${PROJECT_SOURCE_DIR}/ref/TraceOptions_MK3SMMU2.md
-	COMMAND cd ${PROJECT_BINARY_DIR} && ./MK404 -g none --markdown --trace ? Prusa_MK3MMU2| grep -A500 "telemetry" > ${PROJECT_SOURCE_DIR}/ref/TraceOptions_MK3MMU2.md
-	COMMAND cd ${PROJECT_BINARY_DIR} && ./MK404 -g none --markdown --trace ? Prusa_MK3| grep -A500 "telemetry" > ${PROJECT_SOURCE_DIR}/ref/TraceOptions_MK3.md
-	COMMAND cd ${PROJECT_SOURCE_DIR}/ref && sh ./updateTOC.sh
-	)
+    COMMAND cd ${PROJECT_BINARY_DIR} && ./MK404 -g none --scripthelp --markdown | grep -A500 "Scripting options" > ${PROJECT_SOURCE_DIR}/ref/Scripting_MK3S.md
+    COMMAND cd ${PROJECT_BINARY_DIR} && ./MK404 -g none --scripthelp --markdown Prusa_MK3SMMU2 | grep -A500 "Scripting options" > ${PROJECT_SOURCE_DIR}/ref/Scripting_MK3SMMU2.md
+    COMMAND cd ${PROJECT_BINARY_DIR} && ./MK404 -g none --scripthelp --markdown Prusa_MK3MMU2 | grep -A500 "Scripting options" > ${PROJECT_SOURCE_DIR}/ref/Scripting_MK3MMU2.md
+    COMMAND cd ${PROJECT_BINARY_DIR} && ./MK404 -g none --scripthelp --markdown Prusa_MK3 | grep -A500 "Scripting options" > ${PROJECT_SOURCE_DIR}/ref/Scripting_MK3.md
+    COMMAND echo '```' > ${PROJECT_SOURCE_DIR}/ref/CommandLine.md
+    COMMAND cd ${PROJECT_BINARY_DIR} && ./MK404 --help >> ${PROJECT_SOURCE_DIR}/ref/CommandLine.md
+    COMMAND echo '```' >> ${PROJECT_SOURCE_DIR}/ref/CommandLine.md
+    COMMAND cd ${PROJECT_BINARY_DIR} && ./MK404 -g none --markdown --trace ? | grep -A500 "telemetry" > ${PROJECT_SOURCE_DIR}/ref/TraceOptions_MK3S.md
+    COMMAND cd ${PROJECT_BINARY_DIR} && ./MK404 -g none --markdown --trace ? Prusa_MK3SMMU2| grep -A500 "telemetry" > ${PROJECT_SOURCE_DIR}/ref/TraceOptions_MK3SMMU2.md
+    COMMAND cd ${PROJECT_BINARY_DIR} && ./MK404 -g none --markdown --trace ? Prusa_MK3MMU2| grep -A500 "telemetry" > ${PROJECT_SOURCE_DIR}/ref/TraceOptions_MK3MMU2.md
+    COMMAND cd ${PROJECT_BINARY_DIR} && ./MK404 -g none --markdown --trace ? Prusa_MK3| grep -A500 "telemetry" > ${PROJECT_SOURCE_DIR}/ref/TraceOptions_MK3.md
+    COMMAND cd ${PROJECT_SOURCE_DIR}/ref && sh ./updateTOC.sh
+    )
 add_dependencies(UpdateDocs MK404)

 add_custom_target(Release_Package

-	COMMAND ${CMAKE_COMMAND} -E make_directory "${PROJECT_BINARY_DIR}/MK404-dev"
-	COMMAND ${CMAKE_COMMAND} -E copy_if_different MK404 "${PROJECT_BINARY_DIR}/MK404-dev/"
-	COMMAND ${CMAKE_COMMAND} -E make_directory "${PROJECT_BINARY_DIR}/MK404-dev/assets"
-	COMMAND ${CMAKE_COMMAND} -E copy_if_different "${PROJECT_BINARY_DIR}/assets/*.mtl" "${PROJECT_BINARY_DIR}/MK404-dev/assets/"
-	COMMAND ${CMAKE_COMMAND} -E copy_if_different "${PROJECT_BINARY_DIR}/assets/*.obj" "${PROJECT_BINARY_DIR}/MK404-dev/assets/"
-	COMMAND ${CMAKE_COMMAND} -E copy_if_different "${PROJECT_SOURCE_DIR}/README.md" "${PROJECT_BINARY_DIR}/MK404-dev/"
-	COMMAND ${CMAKE_COMMAND} -E copy_if_different "${PROJECT_SOURCE_DIR}/COPYING" "${PROJECT_BINARY_DIR}/MK404-dev/"
-	COMMAND ${CMAKE_COMMAND} -E make_directory "${PROJECT_BINARY_DIR}/MK404-dev/ref"
-	COMMAND ${CMAKE_COMMAND} -E copy_if_different "${PROJECT_SOURCE_DIR}/ref/*" "${PROJECT_BINARY_DIR}/MK404-dev/ref/"
-	COMMAND cd ${PROJECT_BINARY_DIR}
-	COMMAND tar -jcvf "${PROJECT_BINARY_DIR}/MK404-development-build.tar.bz2" "MK404-dev"
-	)
+    COMMAND ${CMAKE_COMMAND} -E make_directory "${PROJECT_BINARY_DIR}/MK404-dev"
+    COMMAND ${CMAKE_COMMAND} -E copy_if_different MK404 "${PROJECT_BINARY_DIR}/MK404-dev/"
+    COMMAND ${CMAKE_COMMAND} -E make_directory "${PROJECT_BINARY_DIR}/MK404-dev/assets"
+    COMMAND ${CMAKE_COMMAND} -E copy_if_different "${PROJECT_BINARY_DIR}/assets/*.mtl" "${PROJECT_BINARY_DIR}/MK404-dev/assets/"
+    COMMAND ${CMAKE_COMMAND} -E copy_if_different "${PROJECT_BINARY_DIR}/assets/*.obj" "${PROJECT_BINARY_DIR}/MK404-dev/assets/"
+    COMMAND ${CMAKE_COMMAND} -E copy_if_different "${PROJECT_SOURCE_DIR}/README.md" "${PROJECT_BINARY_DIR}/MK404-dev/"
+    COMMAND ${CMAKE_COMMAND} -E copy_if_different "${PROJECT_SOURCE_DIR}/COPYING" "${PROJECT_BINARY_DIR}/MK404-dev/"
+    COMMAND ${CMAKE_COMMAND} -E make_directory "${PROJECT_BINARY_DIR}/MK404-dev/ref"
+    COMMAND ${CMAKE_COMMAND} -E copy_if_different "${PROJECT_SOURCE_DIR}/ref/*" "${PROJECT_BINARY_DIR}/MK404-dev/ref/"
+    COMMAND cd ${PROJECT_BINARY_DIR}
+    COMMAND tar -jcvf "${PROJECT_BINARY_DIR}/MK404-development-build.tar.bz2" "MK404-dev"
+    )
 add_dependencies(Release_Package MK404)
diff --git a/parts/components/Beeper.cpp b/parts/components/Beeper.cpp
index dcf90f0..4a2f962 100644
--- a/parts/components/Beeper.cpp
+++ b/parts/components/Beeper.cpp
@@ -22,10 +22,10 @@
 #include "Beeper.h"
 #include <GL/freeglut_std.h>  // for glutStrokeCharacter, GLUT_STROKE_MONO_R...
 #include <GL/gl.h>            // for glVertex2f, glPopMatrix, glPushMatrix
-#include <SDL/SDL.h>          // for SDL_Init, SDL_INIT_AUDIO
-#include <SDL/SDL_audio.h>    // for SDL_PauseAudio, SDL_AudioSpec, SDL_Clos...
-#include <SDL/SDL_error.h>    // for SDL_GetError
-#include <SDL/SDL_stdinc.h>   // for Sint16
+#include <SDL2/SDL.h>         // for SDL_Init, SDL_INIT_AUDIO
+#include <SDL2/SDL_audio.h>   // for SDL_PauseAudio, SDL_AudioSpec, SDL_Clos...
+#include <SDL2/SDL_error.h>   // for SDL_GetError
+#include <SDL2/SDL_stdinc.h>  // for Sint16
 #include <stdio.h>            // for fprintf, printf, stderr
 #include "BasePeripheral.h"   // for MAKE_C_CALLBACK
 #include "TelemetryHost.h"
diff --git a/parts/components/Beeper.h
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

Thread 190 (2020-08-01):

[BUG]  OBJ loader does not handle per face materials

vintagepc, 2020-08-01:
**Describe the bug**
Since we use lighting and not vertex colours, per-face materials are not working in the 3d visuals.

**To Reproduce**
Look at the bear stepper motors in GLC player vs MK404.

**Screenshots**
see #187

Closed 2020-08-02.

Thread 193 (2020-08-02):

[FEATURE] Handle window resizing properly

vintagepc, 2020-08-02:
Yeah... currently it just stretches... either prevent resize or do an aspect ratio scale.

Closed 2020-08-02.

Thread 199 (2020-08-03):

[BUG]  Simulated SPI ignores SPSR and SPCR

vintagepc, 2020-08-03:
**Describe the bug**
Per title. This means the SPI runs slower than expected, and therefore we get WDRs on some SD card reads...
#182 #115

**Additional context**
Fix in SimAVR and submit a pull request to upstream.

vintagepc, 2020-08-04:
Upstream PR filed:
https://github.com/buserror/simavr/pull/392

Closed 2020-08-04.

Thread 201 (2020-08-04):

[BUG] Vanilla Marlin for Einsy Rambo not working in MK404 sim.

3d-gussner, 2020-08-04:
**Describe the bug**
Got vanilla Marlin for Einsy Rambo kind of working and it can be flashed on a physical printer.
Trying to load the same `hex` file in MK404 doesn't do anything.

**To Reproduce**
Steps to reproduce the behavior:
1. Compile https://github.com/3d-gussner/Marlin/tree/MK3s_2.0.x
2. Copy `\.pio\build\rambo\firmware.hex` to your MK404 build folder
3. Start MK404 `/build/MK404 -f firmware.hex`
4. MK404 starts but no output on LCD on terminal

**Expected behavior**
It would behave like the real Einsy board.

**Desktop (please complete the following information):**
- Hyper-V VM
 - OS: [Ubuntu]
 - Version [18.04.1]

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

vintagepc, 2020-08-04:
Have you tried running with `-n` (aka `--no-hacks`)? This is necessary because the TIMSK tweak we need to get the firmware to boot has the opposite effect on stock Marlin.

3d-gussner, 2020-08-04:
Sorry didn't find this issue #117

Solved

vintagepc, 2020-08-04:
Not a problem :)

Maybe when I figure out #75 this workaround can go away and both work without it

vintagepc, 2020-08-05:
Good news (also @leptun ) - `--no-hacks` is no longer necessary for Marlin thanks to closing #75.

Closed 2020-08-04.

Thread 202 (2020-08-05):

[BUG] Altfan uses unsupported timer mode

vintagepc, 2020-08-05:
**Describe the bug**
Altfan uses mode 9 on timer 4. This is unsupported by SimAVR.

**To Reproduce**
Steps to reproduce the behavior:
Run altfan firmware with `-vvv`
Observe: `TIMER: avr_timer_write_ocr-4 mode 0 UNSUPPORTED`

**Expected behavior**
A functional mode 9

**Additional context**
Maybe roll this in with a fix for the missing PC PWM mode...?? (#75 )

vintagepc, 2020-08-06:
Casually poking at this, it looks like the implementation should be fairly straightforward with existing timer code as reference.
The only thing I'm struggling to understand is how the specific updating of TOV or OCRs is controlled. It's a little clearer in the external clocking function but I can't make heads nor tails of the internal clock configuration for a timer.

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

Thread 212 (2020-08-08):

Fix tag builds

vintagepc, 2020-08-08:
Tag builds currently check out master instead of the tag. (Oops). Fix that.

Closed 2020-08-08.

Thread 218 (2020-08-10):

[BUG] Broken graphics

leptun, 2020-08-10:
**Describe the bug**
The graphics seem to be broken in the latest master branch. I'm using Prusa_MK3SMMU2 fancy graphics.
Stuff that I can see is broken:
- The bed LED is floating mid-air, but it's working
- One of the MMU motors seems to blink with green graphics on startup sometimes
- The extruder visualizer is turning much too little.

**To Reproduce**
Steps to reproduce the behavior:
`./MK404 -s Prusa_MK3SMMU2 -g fancy -m`

**Expected behavior**
It should work :)

**Screenshots**
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

**Desktop (please complete the following information):**
Ubuntu 18.04.4 LTS - VMware

vintagepc, 2020-08-10:
whoops! probably some side effects from the Bear visuals rework.

leptun, 2020-08-10:
Also, just noticed this as well: The backlight is stuck on 100% brightness

vintagepc, 2020-08-10:
oh, good. I thought I broke that during my cleanup in #217 ... was scratching my head why.

vintagepc, 2020-08-10:
I didn't think the MK3 OBJ files had any per-face colours, but what probably happened is #190 changed the indexing for the objects we show and hide.

vintagepc, 2020-08-12:
Just noticed we're also no longer showing the correct E variant (MMU/std)

vintagepc, 2020-08-12:
Looks like the brightness was broken by https://github.com/vintagepc/simavr/commit/e838af1472e8402f4260e6432cbbe6d6a6fe6a85

Investigating...

Closed 2020-08-13.

Thread 219 (2020-08-11):

[Q+A] How to add new printer with new board?

3d-gussner, 2020-08-11:
I would like to add the Prusa MK2, MK2.5 and MK2.5S to MK404.
Here is what I think i have to do:

- [x] - add miniRAMBo10a to parts/wiring
- [x] - add miniRAMBo13a with overwrites to parts/wiring
- [x] - add miniRAMBO to parts/boards
- [x] - add A4982 to parts parts/components
- [x] - add Prusa MK2, MK2.5 and MK2.5s to parts/printers
- [ ] - add MK2 frame as obj
- [ ] - add MK2 extruder as obj
- [ ] - add MK2.5/s extruder as obj
- [ ] - add other MK2/MK2.5/s objs
- [x] - add MK2... to CMakeLists.txt
- [x] - add MK2... to MK404.cpp
- [x] - add MK2... to PrinterFactory.h
- [ ] - add MK2... to launch.json
- [x] - add MK2... to CommandLine.md

I am not sure how to get the A4982 working correctly, the rest I can try.

Do we need extra endstop switches in components? Very similar to IR except analog voltage reading.

How would you begin with this to create a PR?

Also saw that the parts/wiring/Einsy_1_?a.h files don't use the schematics pin names instead the connected component or in printer defined names.
Example:
Einsy schematics PJ2 on P2 pin8 is called BTN_EN1 pin 72
For the Prusa MK3/s makes sense, but what if somebody decides to use an I2C display or something else on EXT2/P2 connector?

vintagepc, 2020-08-11:
I think you have  most of the outline right (no need to update the various .md files - those are autogenerated. You only need to add entries to the document generation section to have it create any printer-specific telemetry or scripting documentation.

- You should not need to add anything to MK404.cpp, printer type is all abstracted away into other classes.
- Endstops: I think you could probably even get away with re-using either ADCButtons or the standard Button component.
- Wiring is an abstraction layer between the AVR pins and the board's outputs/convenience names. It's arbitrary, you could easily add a new (`MY_LCD_MISO`) pinname entry  and map it to a P2 pin for use in a custom board.

Since you're a collaborator you should have write access to the repo - feel free to create a branch and push it up so we can collaborate easily and incrementally.

Let's walk through it step-by-step in the following order. I am happy to contribute or review at each step. (I'm hoping to get #216 wrapped soon, but it's a lot of work... ;))
1.  Add pinspec for the AVR, if necessary.  (Likely not needed, miniRambo is a 2560)
2. Define a wiring with accessory names to MCU pin numbers.
3. Define a board with the given wiring/pinspec.
4. Add hardware to the board.
5. Create the printer object.
6. Add to PrinterFactory
7. 3D assets and visual work. (Defining an Obj collection with the appropriate OBJs, wiring up to the printer).

Does that help clear up the process?

3d-gussner, 2020-08-15:
Created new branch https://github.com/vintagepc/MK404/tree/miniRAMBo_MK2_MK25_S

vintagepc, 2020-08-15:
I had a peek at the A4982 datasheet, seems pretty straightforward to implement. Would you like me to do that? I can start templating out the board and printer too.

3d-gussner, 2020-08-15:
It would be great if you could do the stepper driver.

vintagepc, 2020-08-15:
Sure thing!
I pushed up a barebones 2.5 1.3 MiniRambo printer, it boots but of course there's not much else in the way of hardware yet:

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

but that should serve as a starting point for additional variants and expanding the hardware.

vintagepc, 2020-08-15:
BTW- I'll add endstop outputs to the driver sim, makes the most sense to have them there.

3d-gussner, 2020-08-15:
Wow you are fast

3d-gussner, 2020-08-15:
I use muniRAMBo_1_0a instead of 1.1b as this is the base in Prusa Firmware.
I couldn't find any schematics for the 1.0a version so I stuck with the Prusa Firmware pins file.

3d-gussner, 2020-08-15:
Does it makes sense to add the MK42 and MK52 beds as components as these are different.
- MK42 is 12V and has 9 calibration points at slightly different locations compared to the MK52
- MK52 is available in 12 and 24V

vintagepc, 2020-08-15:
> I use muniRAMBo_1_0a instead of 1.1b as this is the base in Prusa Firmware.
> I couldn't find any schematics for the 1.0a version so I stuck with the Prusa Firmware pins file.

Ah, ok. I just renamed the header because the internal class name differed from the filename, and d I saw the notes about 1.0 not having LCD headers. (so I assumed the filename was what was incorrect). Feel free to correct.

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

I don't think the bed voltages impact the simulation and necessitates separate parts - but we would want to account for this in the PINDA, where the calibration magic happens. I believe it already has over-loadable functions and input arguments to configure how the calibration mapping happens. Only change is that for these beds, the sheet is permanently "off", since they are just PEI straight on the PCB.

Working on the stepper driver now :+1:  This thing is so much simpler than the TMC :rofl:

vintagepc, 2020-08-15:
One driver sim pushed :tada:

vintagepc, 2020-08-15:
... Or not, just added the thermistors and it doesn't step. womp womp :rofl:

3d-gussner, 2020-08-15:
The existing PINDA could be renamed to PINDAv2 and for the MK2 PINDAv1 we just exclude the thermistor, or not?

vintagepc, 2020-08-15:
You could just use the existing one as-is, the thermistor isn't built into the fake PINDA

3d-gussner, 2020-08-15:
SIM PINDA is better than fake😉

vintagepc, 2020-08-15:
sounds like you've had to deal with some fake ones in the wild :smile:

vintagepc, 2020-08-15:
d'oh... I have the pins backwards... driver inputs were connected as outputs.

You're right, fake parts are terrible! :stuck_out_tongue_closed_eyes:

vintagepc, 2020-08-29:
I've pulled in improvements from master.

... How does the mk2.5 fan check work? The fans are two wire, yet the firmware has a TACH pin defined that runs to pin 30 (X MAX)

3d-gussner, 2020-08-30:
Sorry, was busy with other things and you found it.

vintagepc, 2020-08-30:
Seems to work for the most part but XYZ cal fails with no obvious error (progresses through all 4 points)

vintagepc, 2020-09-14:
Fixed XY cal, added buzzer and PINDA thermistor.

I believe the updates/models are as follows, correct?

MK2/S->MK2.5: Heatbed, noctua fans, PAT laser sensor, PINDA upgrade.
MK2.5->S: Extruder parts + IR sensor

Alas there doesn't seem to be historical info as to the MK2->/S variant.

leptun, 2020-09-15:
Mk2 to S upgrade I think was just with better rods and U-bolts for the bed instead of zip-ties

vintagepc, 2020-09-15:
That would explain why I couldn't find anything on the electronics changes :)

vintagepc, 2020-09-15:
Apparently the 360 views on the site can be exported to F360 (and from there to obj/mtl). I don't think it's the case, but were there ever such pages for the MK2 line?

vintagepc, 2020-09-16:
I got a little too deep into this last night... :rofl:

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

Pushed up initial files for the full compliment of miniRambo 1.3a based printers. Yes, that includes the MK1 and MK2MMU.

I know the MMU is not quite right because it doesn't handle the E motors turning in opposite directions; I think everything else is at least wired correctly (in theory). MK2 XY cal is also still janky (fails correction) but it finds all the points.

From the virtual hardware perspective:
- MK1 Z steps/mm = 4000
- MK2 = MK1 but with proper leadscrew motors. 9-point bed, no sheet.
- MK2.5 -> Connects PAT, E-fan tach, PINDA temp, sheet, 4 point bed.
- MK2.5S -> Swaps PAT for IR sensor.

leptun, 2020-09-16:
I think the MK1 has the old red bed with glass on top. Not sure about dimensions, but they might be different

vintagepc, 2020-09-16:
They are, I just didn't note that above :+1:

vintagepc, 2020-09-17:
MK2 XYcal fixed, MMU1 implemented better.

vintagepc, 2020-09-19:
I think I'm going to merge these printers in as-is and leave the 3D visuals for a separate issue, they're far enough along I don't think we want to hold them back for that.

Going to start working on tests for the new components and printers with a draft PR to follow.

vintagepc, 2020-09-26:
New follow-on issue for the 3d components is #243

Closed 2020-09-26.

Thread 223 (2020-08-12):

[BUG] MMU motors moving too fast

vintagepc, 2020-08-12:
**Describe the bug**

The selector (and possibly other motors) on the MMU are moving too fast. Git bisect shows this is result of changes for #198

```
git bisect bad
d3f6cc44fcb10f93e671f52c30d03b0d614195da is the first bad commit
```

commit d3f6cc44fcb10f93e671f52c30d03b0d614195da
Author: @wavexx
Date:   Tue Aug 4 13:28:49 2020 +0200

    Implement TMC2130 variable resolution support (#198)

    - Also handle CHOPCONF.mres.
    - Introduce helpers to convert from/to step/position
    - Update limits as CHOPCONF is updated.

**To Reproduce**

1. Run with MMU
2. Choose 'load all filaments to make it home the selector
3. Observe selector motion

**Expected behavior**
Selector should not move nearly as quickly (looks like it's taking steps/mm as lower than it should be)

wavexx, 2020-08-13:
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

I assigned the default resolution to 16 usteps to match xyz on the MK3,
which is probably wrong for the others.

I'll have a look later on.

leptun, 2020-08-13:
@wavexx
```
	case AX_PUL: return tmc2130_usteps2mres((uint16_t)2);
	case AX_SEL: return tmc2130_usteps2mres((uint16_t)2);
	case AX_IDL: return tmc2130_usteps2mres((uint16_t)16);
```

vintagepc, 2020-08-13:
yep, looks like that would explain it ;) Idler behaves fine, Id suspect the pulley also feeds super quickly now too :rofl:
I guess that's one way to speed up your toolchanges....

wavexx, 2020-08-29:
On Sat, Aug 29 2020, vintagepc wrote:
> Closed #223 via #228.

Damn, feel bad for not having worked on this!
But the fix is better than what I had in mind =)

vintagepc, 2020-08-29:
NP, it happens :)

I took some inspiration from the way we handle this for the A4982s.

Closed 2020-08-29.

Thread 227 (2020-08-21):

[BUG] PWM2 on OCxC is janky

vintagepc, 2020-08-21:
**Describe the bug**
Setting PWM on a PWM2 IRQ (OCxC) seems to cause the digital pin to constantly get toggled instead of just the PWM value being reported from OCRx.

**To Reproduce**
Steps to reproduce the behavior:
Use the fan tests in the automated test branch, and wire it to OC4C (Pin 8). Update test code accordingly.
Enable debug output for the fan and observe when PWM is set to 128:

```

New PWM(2000)/RPM/cyc: 255 / 2000 / 7500
New PWM(2000)/RPM/cyc: 255 / 2000 / 7500
New PWM(2000)/RPM/cyc: 128 / 1003 / 14955
New PWM(2000)/RPM/cyc: 0 / 0 / 0
New PWM(2000)/RPM/cyc: 255 / 2000 / 7500
New PWM(2000)/RPM/cyc: 0 / 0 / 0
New PWM(2000)/RPM/cyc: 255 / 2000 / 7500
```
This does not happen with OCxA/B.

**Expected behavior**
Should behave the same as PWMA/B- just trigger the PWM IRQ, and don't flip the  DIRQ like a mad-lad.

**Additional context**
- This is probably why the soft-pwm hack was necessary for one of the fans on the Einsy board.
- Clean that up when it's fixed!

vintagepc, 2020-08-29:
Non-issue, there was a stray SBI call that configured the timer to set/clear on compare causing this.

Closed 2020-08-29.

Thread 233 (2020-09-07):

Failing XYZ calibration[BUG?]

pkg2000, 2020-09-07:
Good day, and thank you for reading. Awesome project, but I am having some issues. After getting it up and running, clearing the Selftest, the XYZ calibrations are consistently failing on the 1 of 4. After a little bit of spiraling, I get the following lines (screenshot below) saying something about the buffer, and then it starts feeding me very specific nonsense (4848484848484848.....). Been looking around the wiki if there is some config for buffer or whatever, but can't find anything regarding this.

Steps to reproduce the behavior:
Clean VM install of MXLinux or Ubuntu
Find them deps.
compile
run

**Expected behavior**
Successful calibration.

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

**Machine:**
 - Windows 10 running both MXlinux and Ubuntu through VMware Player 15, non-commercial.
 - Intel core i5 laptop and fx-8350 R9-270 rig.

Tried different ways of starting it, but this is basically what I execute with. Nohack (-n) just in that case.
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

Following your instructions and the struggle I had doing so, tells me that you guys are a few levels beyond me, but I am not a complete noob. I think you guys have done an amazing job with this and I would greatly appreciate any feedback you could provide on this issue. I imagine (and hoping) that there is something obvious I am missing here. I'd also be happy to write something up for your documentation, once I get going properly.

Thank you!

vintagepc, 2020-09-07:
Hi here!

Sounds like a simple oversight - it looks like you forgot to "remove" the virtual steel sheet before doing the calibration.

You can do this by pushing the `y` key, or using the middle-click context menu.

(The wall of `48`s is a visual representation of what the PINDA is seeing, when the sheet is on it's going to be mostly level, but if the sheet is off, it should be mostly zeros with a circular group of higher values in the center that represent the bed's calibration point).

Hope that helps!

leptun, 2020-09-07:
The `sizeof()` are not important. It's simply debug info that in my opinion is absolutely useless...

As for the 484848484848.... That is the level at which the probe triggered when it was scanning for the bed point.
It can mean 2 things:
- You forgot to "remove the sheet from the bed", hence why it's so level and without the point to find. Keybind is `Y`
- Some regression in code

vintagepc, 2020-09-07:
Not ruling out a regression entirely, but I do know it was working recently while I was busy on the MK2.5 implementation :)

leptun, 2020-09-07:
That's why I put the "forgot to remove sheet" first. :)
The timing of your comment was perfect. I commented and then yours appeared on top of mine

vintagepc, 2020-09-07:
And now you know why my avatar is a ninja tux :rofl:

pkg2000, 2020-09-07:
Aaah. Thank you for all of your responses. That makes very much sense from my experience with the IRL machine. Hit "no" when it asked, but I of course have to take it off as well;) Currently not using the fancy graphics either as it ate the little cpu I could give the VM. Thank you. Will confirm in a bit.

vintagepc, 2020-09-07:
You might have more luck with `-g lite` which renders only the minimal functional parts - bed + sheet, nozzle, fans,  and a few other components.
It shouldn't perform too badly with even minimal software rendering - but you might want to double check the graphics settings. Many VM tools offer the ability to assign graphics memory and limited 3d acceleration support.

While not actively maintained, it should compile and run on cygwin, which would get you the ability to run on your native graphics hardware.

pkg2000, 2020-09-07:
Yeah, was indeed the sheet. Thank you! I will give -g lite a go, and also try to tick of 3d hardware (was an option), but this laptop is part potato anyhow. Will give cygwin a try, but wanted to run it in what you guys were running and read your disclaimer regarding other platforms. Again, thanks a bunch!

vintagepc, 2020-09-07:
Excellent, good to hear you're all set.

(FWIW I'm on a laptop from 2013 and using the integrated graphics for my dev activities)

Closed 2020-09-07.

Thread 234 (2020-09-11):

[BUG] Serial is broken

leptun, 2020-09-11:
In the latest master branch you can't use the -s option anymore. It starts the /dev/pts/2|3 as usual, but the /tmp/simavr-uart* symlink is incorrect.
Differences I noticed: Instead of simavr-uart0|2, you get simavr-uart48|50. These symlinks also are not deleted after the ports are closed. Reverting to v0.9.3 fixed the issue.

vintagepc, 2020-09-11:
crap, I'll take a look after work.

vintagepc, 2020-09-11:
There was a malformed link name. Looking at the code, it's never cleaned it up after quitting.

Fixing the symlink name appears to have fixed the communication, I can connect to /tmp/simavr-uart0 without issue.

Closed 2020-09-11.

Thread 236 (2020-09-13):

[BUG] Backlight regression

leptun, 2020-09-13:
**Describe the bug**
The backlight colouring is broken. Not sure if it is a rendering issue or if the wrong values are extracted from the timer output.
Was there any recent change to the timers? I think you added an unsupported mode recently.

**To Reproduce**
Steps to reproduce the behavior:
Set backlight in firmware to different values and enhoy the show

**Screenshots**
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
video with many more values: https://photos.app.goo.gl/4K3ra2awqQ7THUhs7

**Desktop (please complete the following information):**
 - OS: Ubuntu desktop 20.04 - amd64
- MK404: latest master as of writing (commit fa555a28d72390399381b9508c2db46ac0a0b08f)

**Additional context**
Not sure if it is firmware, but I'm confident it should never be a shade of green :)

vintagepc, 2020-09-13:
Huh, that's a weird one. This backlight breaking seems to be becoming rather trite in this project :laughing:

I remember seeing something similar but with red after I had been changing the glClearColor to debug the "black screen on nVidia cards" issue. So I think it's a transparency/alpha problem and we're just showing whatever happens to be behind the display.

leptun, 2020-09-13:
This is on a different computer than with my previous setup. It’s very possible to be an nvidia only issue. This is the only card in the system.
On the other one I have both integrted graphics (main) and dedicated nvidia.

Not sure if it influences anything, but I also use a different ubuntu version than on the other setup.

vintagepc, 2020-09-13:
Nope, I found the issue, I messed up the colour scaling calculation and was dividing by the PWM (0-1.0f) instead of multiplying by it to get the new RGBA quad.

You get a very interesting occurrence if you increment it by values of one and it changes drastically from screen to screen XD

Closed 2020-09-13.

Thread 237 (2020-09-14):

[IMPROVEMENT] No more code in .h files

vintagepc, 2020-09-14:
**Is your feature request related to a problem? Please describe.**

Move code out of .h files

**Describe the solution you'd like**
Some base class .h files have grown and have a lot of actual code in them, which means  everything recompiles when you edit them. Move all the functions into proper .cpp files.

This will probably also increase compile speed slightly.

- [x] parts/I2CPeripheral.h
- [x] parts/ADCPeripheral.h
- [x] parts/TelemetryHost.h
- [x] parts/PinNames.h
- [x] parts/BasePeripheral.h
- [x] parts/boards/EinsyRambo.h
- [x] parts/boards/MM_Control_01.h
- [x] parts/boards/MiniRambo.h
- [x] parts/boards/Test_Board.h
- [x] parts/PrinterFactory.h
- [x] parts/wiring/miniRAMBo_1_3a.h
- [x] parts/wiring/miniRAMBo_1_1b.h
- [x] parts/wiring/Test_Wiring.h
- [x] parts/wiring/Einsy_1_1a.h
- [x] parts/wiring/MM_Control_01.h
- [x] parts/wiring/Einsy_1_0a.h
- [x] parts/ScriptHost.h
- [x] parts/pinspecs/PinSpec_2560.h
- [x] parts/pinspecs/PinSpec_32u4.h
- [x] parts/PinSpec.h
- [x] parts/IKeyClient.h
- [x] parts/SoftPWMable.h
- [x] parts/Printer.h
- [x] parts/SPIPeripheral.h
- [x] parts/Scriptable.h
- [x] parts/Board.h
- [x] parts/components/LED.h
- [x] parts/components/PINDA.h
- [x] parts/components/HD44780GL.h
- [x] parts/components/SDCard.h
- [x] parts/components/uart_pty.h
- [x] parts/components/hd44780_charROM.h
- [x] parts/components/GLHelper.h
- [x] parts/components/UART_Logger.h
- [x] parts/components/PAT9125.h
- [x] parts/components/MMU2.h
- [x] parts/components/MMU1.h
- [x] parts/components/RotaryEncoder.h
- [x] parts/components/EEPROM.h
- [x] parts/components/Thermistor.h
- [x] parts/components/Fan.h
- [x] parts/components/ADC_Buttons.h
- [x] parts/components/VoltageSrc.h
- [x] parts/components/w25x20cl.h
- [x] parts/components/Beeper.h
- [x] parts/components/HD44780.h
- [x] parts/components/SerialLineMonitor.h
- [x] parts/components/A4982.h
- [x] parts/components/HC595.h
- [x] parts/components/Button.h
- [x] parts/components/GCodeSniffer.h
- [x] parts/components/TMC2130.h
- [x] parts/components/IRSensor.h
- [x] parts/components/Heater.h
- [x] parts/IScriptable.h
- [x] parts/PinSpec_Helper.h
- [x] parts/Wiring.h
- [x] parts/KeyController.h
- [x] parts/IRQHelper.h
- [x] parts/printers/Test_Printer.h
- [x] parts/printers/Prusa_MK3S.h
- [x] parts/printers/Prusa_MK25S_13.h
- [x] parts/printers/Prusa_MK3.h
- [x] parts/printers/Prusa_MK1_13.h
- [x] parts/printers/Prusa_MK2_13.h
- [x] parts/printers/Prusa_MK3SMMU2.h
- [x] parts/printers/Prusa_MK25_13.h
- [x] parts/printers/Prusa_MK2MMU_13.h
- [x] parts/printers/Prusa_MK3MMU2.h
- [x] utility/SerialPipe.h
- [x] utility/Color.h
- [x] utility/GLPrint.h
- [x] utility/Macros.h
- [x] utility/FatImage.h
- [x] utility/MK3SGL.h
- [x] utility/MK3S_Full.h
- [x] utility/GLObj.h
- [x] utility/MK3S_Lite.h
- [x] utility/Util.h
- [x] utility/OBJCollection.h
- [x] utility/MK3S_Bear.h

Closed 2020-09-28.

Thread 238 (2020-09-16):

[IMPROVEMENT] Key handler registration

vintagepc, 2020-09-16:
**Is your feature request related to a problem? Please describe.**
Allow components to register a key handler with the board or printer. This will eliminate a lot of copy-paste code and branching due to e.g. toggling fsensors - each printer will automatically get the key interactions from the components it has, much like the way the context menu works.

**Additional notes:**
Add doc generation for the printers so that we can autogen the available keys for each printer.

Closed 2020-09-19.

Thread 239 (2020-09-17):

[FEATURE] Make the filament loaded on startup

leptun, 2020-09-17:
**Is your feature request related to a problem? Please describe.**
I always forget to load the filament on startup before starting a test print and more often than not I end up doing a filament swap at the beginning of the print.

**Describe the solution you'd like**
Please make the filament to be loaded on startup or add an extra flag for that.

vintagepc, 2020-09-17:
Can definitely do that.

leptun, 2020-09-17:
@vintagepc Thanks!

vintagepc, 2020-09-17:
You're welcome... it's bitten me a few time before too but I just never got around to doing something about it... ;-)

Closed 2020-09-17.

Thread 243 (2020-09-26):

[ENHANCEMENT] 3D visuals for miniRambo printers

vintagepc, 2020-09-26:
This is a continuation of #219.

Now that the base printers are in, we will need to source and add some models for them. We might end up needing to model them ourselves in a CAD Program using the part STLs and other components.

3d-gussner, 2020-10-18:
What do we need to get this finished?
As we are investigating the VFA it might be interesting to compare it to MK2 and MK2.5/s.

3d-gussner, 2020-10-18:
I have been trying to run the Wizard on:
- MK2 works fine and finishes
- MK2.5+S failed at XYZ cal ... have to to retest it again

vintagepc, 2020-10-18:
For the models we'd need something we can convert to OBJ via known tools. Essentially some sort of CAD assembly. I did not see any public ones out there like the one we used for the MK3.

We'd either need to build one ourselves from the part STLs and hardware or maybe Prusa has some assembly models they'd be willing to share - but I am not sure since the earlier ones were heavily designed in OpenSCAD and they only moved to Autodesk later.

I suppose there's no reason we couldn't use the MK3 models for the same if we just want the 3d visuals, it'd just look a little strange.

I did push up a fix for the 2.5S - the Z height hadn't been corrected to allow for the extra 5mm over the 2.5.

3d-gussner, 2020-10-18:
I have a look if I still have a MK2 and MK2.5/S in fusion

3d-gussner, 2020-10-19:
First test looking good. Thanks

vintagepc, 2020-10-20:
BTW if you post the STEP files or email them to me I may have some time to knock this out.

vintagepc, 2020-10-24:
FWIW I did find a MK2 STEP file online and can work with that instead if necessary.

vintagepc, 2020-10-27:
Just pushed up an initial commit.

TODOs:

- [ ] Add print bed for 2.5 & S variants
- [ ] Add MMU parts for MK2MMU variant.

vintagepc, 2020-10-27:
additional push for two of three. Doing the MMU parts is going to be trickier, I have the STLs, I just need to learn more about SolidEdge to manipulate them as parts and get them placed in the STEP file. I may make that a separate issue.

3d-gussner, 2020-10-28:
I will have at look for the MMUv1 parts.
BTW the MK2 fancy looks great.
The MK2.5 needs a different Extruder.

vintagepc, 2020-10-28:
Whoops, yes. I forgot about that >_<

TODO list edited ;)

3d-gussner, 2020-10-28:
Started to convert MMUv1 from SCAD to STEP and OBJ, MTL using FreeCad 0.19 and 3d-builder.
https://github.com/3d-gussner/Original-Prusa-i3/tree/Multi-Material-Upgrade/Printed-Parts
Please let me know if these are okay or I have to clean these a bit?
In the past the conversion from SCAD to STEP via FreeCad 0.1? and Fusion360 needed some cosmetic cleanup.

vintagepc, 2020-10-28:
Thanks! I'll have a look today.

vintagepc, 2020-10-28:
Yes, if you could do the switchbox v2 and cover v2 I think it'll be a nice touch.

STEP alone is fine, I can manipulate them into place and export as a single group rather than having to handle the individual OBJs in MK404 😄

This is forcing me to learn SolidEdge, and I'm starting to like it more and more, apart from the fact it doesn't run in Wine/Crossover.

3d-gussner, 2020-10-28:
Done https://github.com/3d-gussner/Original-Prusa-i3/tree/Multi-Material-Upgrade/Printed-Parts/STEP
Cleanest is the fusion step file

vintagepc, 2020-10-28:
Getting there! I have the MMU models in. I will still need to think about how to do visualizations for the E motors and prints though; the current MMU is somewhat baked in at a lower level so I'll have to decouple that somehow and route connections appropriately.

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

vintagepc, 2020-10-29:
Well that was a pleasant surprise! Just connecting up the motors (and fixing a colour bug with the additional virtual prints)... it seems to be working!

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

I think I'll get some tests written, and then merge this work in and leave the E visualizers for another day when someone actually needs them to debug something :smile:

Closed 2020-10-29.

Thread 246 (2020-09-27):

[FEATURE] GL Performance

vintagepc, 2020-09-27:
**Is your feature request related to a problem? Please describe.**

GL performance is acceptable, but I feel it could probably be better. Look into the framerate and see what could be done to improve it.

vintagepc, 2020-09-27:
This is a fairly complex issue. There are a few places we can eliminate unneeded glBegin/glEnd calls for performance (LCD is a big culprit...) but longer term these direct mode calls have been deprecated and we'd need to look towards more modern GL implementations using shaders, which is a complete drawing architecture redesign.

Closed 2020-10-18.

Thread 248 (2020-09-27):

[BUG] PAT9125 not detected in hardware I2C mode

wavexx, 2020-09-27:
**Describe the bug**
The SCL/SDA irqs do not seem to be generated when the PAT9125 is used with the HW TWI, causing the simulated PAT9125 to be non-responsive.

**To Reproduce**
Attaching an MK3 FW with https://github.com/prusa3d/Prusa-Firmware/pull/2814 merged:

[Firmware.ino.zip](https://github.com/vintagepc/MK404/files/5288227/Firmware.ino.zip)

vintagepc, 2020-09-27:
Derp. Someone even left me a nice TODO... :rofl:
```

	void _OnI2CTx(avr_irq_t */*irq*/, I2CMsg_t /*msg*/)
		{
			// TODO(vintagepc) - I don't have any real "hardware" i2c items to simulate at the moment.
		}
```

wavexx, 2020-09-27:
I noticed that, but I'm curious now. shouldn't the SDA/SCL pins still trigger an irq irregardless?
I guess the TWI module doesn't do that.

vintagepc, 2020-09-27:
Yeah, SimAVR doesn't do that for most cases - for example, the digital pin IRQ does not toggle if it is in PWM mode.

I just need to wire up the official I2C IRQs to the message receiver and call the shared get/set reg value methods.

vintagepc, 2020-09-27:
Hmm... not quite so simple. I've prototyped it in and get the message/send an ACK but it doesn't appear to make it through to the firmware - it never attempts to read the device register to get the PID/VID.

wavexx, 2020-09-27:
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

Is there something I can build for testing too?

vintagepc, 2020-09-27:
So far I see the TWI library in the Prusa FW is expecting to see TW_MT_SLA_ACK (0x18) but based on code inspection/stepping the status register is ending up at 0x28 (TW_MT_DATA_ACK). Not sure why yet. A build that dumps TWI status over serial might be useful to figure out what the firmware is seeing vs what it expects.

If you'd like to take a look or poke at this, I pushed up https://github.com/vintagepc/MK404/tree/248-Hardware-TWI that has the basic framework outlined in SPIPerpihheral.h for "real" hardware SPI.
Once we get the ACK to work and the firmware to actually query with a `TWI_COND_READ` or address set it should be just a matter of adding in some code to call the Set or GetRegVal functions.

Just let me know if you're interested in taking a crack; then I can focus on other tasks so we're not both doing the same work :+1:

wavexx, 2020-09-27:
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

So this stops already at the first read of the PID1 register when the FW
is about to transmit the register address.

> Just let me know if you're interested in taking a crack; then I can
> focus on other tasks so we're not both doing the same work :+1:

Although I'm running this on the real thing, I don't exclude FW quirks
here as well which is why I'm all ears :P

I don't think I can do this today anymore though

vintagepc, 2020-09-27:
Of course; I know we all have different amounts of time we can commit to the project.

I'll keep looking.

wavexx, 2020-09-27:
On Sun, Sep 27 2020, vintagepc wrote:
> Of course; I know we all have different amounts of time we can commit
> to the project.

Mostly because I'm chasing another bug already =)

vintagepc, 2020-09-27:
aha, it's a similar issue to what we had with the SD card's SPI bus.
The simulation doesn't handle faster clock rates, so by the time the status register is updated, we've already checked it in `pat_probe` and it's too late.

```
/*
 * This is supposed to trigger a timer whose duration is a multiple
 * of 'twi' clock cycles, which should be derived from the prescaler
 * (100khz, 400khz etc).
 * Right now it cheats and uses one twi cycle == one usec.
 */
```

wavexx, 2020-09-27:
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

Ha. So it should work if I reduce the twi clock speed to 100khz for
example? That's easy to test.

vintagepc, 2020-09-27:
In theory - but there also seems to be a read/write handling problem in the ACK types. I have some local modifications to do the same and while it now communicates something is still wrong with the writes.

vintagepc, 2020-09-27:
... so this doesn't make sense.
in PAT9125.c when doing a write:

```
#elif defined(PAT9125_I2C)
	if (twi_rw8(PAT9125_I2C_ADDR,TW_WRITE,&addr) ||
        twi_rw8(PAT9125_I2C_ADDR,TW_READ,&data))
```

.. you're not actually providing any data to be written.

vintagepc, 2020-09-28:
Can confirm HW TWI works if hacked around, but blocked pending a clean resolution in https://github.com/buserror/simavr/issues/137

(and the associated upstream PR, https://github.com/buserror/simavr/pull/401

vintagepc, 2020-09-29:
I'm picking in the changes that work for us; will re-visit once the upstream discussion is resolved or we have additional hardware TWI components that indicate the fix is flawed.

Closed 2020-09-30.

Thread 249 (2020-09-28):

[BUG] SD target broken

leptun, 2020-09-28:
I think the sd card target is currently broken in the latest master (or at the very least the latest master this morning). It generates an outdated output filename for the sd card image file.
Instead of Prusa_MK3S_SDcard.bin it generates Einsy_mega2560_sdcard.bin (or something like that. Writing these names from memory). I have to manually rename the generated file for the specific printer hardware config I’m using.

vintagepc, 2020-09-28:
Oops, yeah... forgot about that when I changed it so each printer has its own SD card and storage files.

vintagepc, 2020-09-29:
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

PR pending, I've got it auto-generating a list of printer SD card targets in CMake now.

3d-gussner, 2020-09-30:
Still broken as it builds the SD cards but with wrong name:
`SD card image (Prusa_MK25S_13_SDcard.bin) could not be mounted (error -1 ).`
but it created `Prusa_MK25S_mR13_SDcard.bin`

vintagepc, 2020-09-30:
shoot, the minirambo naming throws a wrench in the works there since the printer name does not reflect the c++ class name used to get the storage filenames.

I'll fix tonight.

leptun, 2020-10-05:
The saga continues.
Added a gcode file to SDCard named `Buton_umbrela_Florica_MKB_FAST.gcode`, ran the Prusa_MK3S_SDcard.bin target and got this in the build log:
```
[build] Wrote 134217728 bytes to SD image.Wrote /home/alex/Desktop/MK404/build/Prusa_MK3S_SDcard.bin. You can now use mcopy to copy gcode files into the image.
[build] Copying Test.gcode
[build] [100%] Built target Prusa_MK3S_SDcard.bin
[build] Build finished with exit code 0
```
As can be seen, only Test.gcode was copied.

leptun, 2020-10-05:
Ok. Good to know. Just did this and it works.
One more issue, though. Files that have "()" break the generated makefile. Something to look into.
```
[build] Wrote 134217728 bytes to SD image.Wrote /home/alex/Desktop/MK404/build/Prusa_MK3S_SDcard.bin. You can now use mcopy to copy gcode files into the image.
[build] /bin/sh: 1: Syntax error: "(" unexpected
[build] make[3]: *** [SDCard/CMakeFiles/Prusa_MK3S_SDcard.bin.dir/build.make:58: SDCard/CMakeFiles/Prusa_MK3S_SDcard.bin] Error 2
[build] make[2]: *** [CMakeFiles/Makefile2:2265: SDCard/CMakeFiles/Prusa_MK3S_SDcard.bin.dir/all] Error 2
[build] make[1]: *** [CMakeFiles/Makefile2:2272: SDCard/CMakeFiles/Prusa_MK3S_SDcard.bin.dir/rule] Error 2
[build] make: *** [Makefile:1137: Prusa_MK3S_SDcard.bin] Error 2
[build] Build finished with exit code 2
```
Used filename was `Test (2).gcode`

vintagepc, 2020-10-05:
Good find. I probably just missed putting quotes around a filename variable somewhere.

vintagepc, 2020-10-05:
OK, I have a fix for both of these, I think. I managed to make the wildcard for `*.gcode` work, which both pulls in the current state of the directory and fixes the issue with special chars in the filename.

Cmake convenience entries for gcode files are still dependent on re-running cmake to pick up new ones to list under a target though.

vintagepc, 2020-10-05:
Third time's the charm, I hope.

Closed 2020-10-05.

Thread 252 (2020-09-30):

[BUG] Prusa_MK25 and Prusa_MK25S bed temp rises without any reason

3d-gussner, 2020-09-30:
**Describe the bug**
After starting the MK25 or MK25S the bed temp starts rising without any reason.

**To Reproduce**
Steps to reproduce the behavior:
1. start./ MK404 Prusa_MK25_mR13 -f (3.9.1 hex file)
2. Watch the Bed temp on LCD
3. Starting the base model MK2 doesn't do that.

**Expected behavior**
Behave like the base MK2 or MK3/s

**Desktop (please complete the following information):**
 - OS: [Ubuntu VM]
 - Version [18.04]

**Additional context**
Tried to find the issue but can't find it.
Did `git reset --hard` and rebuild everything.

vintagepc, 2020-09-30:
This is the soft PWM bed code causing this. looks like the 2.5 variants need the bIsBed argument set to true to indicate we're doing softPWM trickery.

Closed 2020-10-01.

Thread 253 (2020-09-30):

[BUG] MK2 PINDA doesn't trigger

3d-gussner, 2020-09-30:
**Describe the bug**
Started Prusa_MK2 with latest official firmware and tried to run the wizard, but i fails in the selftest at z.
Tried G28W to home and the PINDA doesn't trigger.

**To Reproduce**
Steps to reproduce the behavior:
1. Start ./MK404 Prusa_MK2_mR13 -s -f (MK2 hex file)
2. Run selftest or `G28W`
3. Selftest fails and PINDA doesn't trigger

**Expected behavior**
Should trigger above the MK42 cal points.

**Desktop (please complete the following information):**
 - OS: [Ubuntu VM]
 - Version [18.04]

**Additional context**
Saw that you added the MK42 cal points but looks like it doesn't work.

vintagepc, 2020-09-30:
Interesting; I know I had the self test completing at one point. I wonder what changed...

vintagepc, 2020-09-30:
This is a weird one,  the microstep count (and therefore position tracking) doesn't seem to be working right.

I can see the firmware is setting the driver MS1/2 to H/H (MS 16), correct according to the source.

But when I try a move axis/step, it's only stepping about 1/16th of what it should. Are the MS outputs inverted? Doesn't look that way on the schematic.

vintagepc, 2020-10-02:
Any chance @wavexx  or @leptun has some insight on the miniRambo line with regards to this? From what I can see it looks like the FW is stepping as though it's in full-step mode but the driver is configured for 16ths.

Steps/mm should be configured correctly as well.

wavexx, 2020-10-02:
No direct experience with the miniRambo

Closed 2020-10-09.

Thread 256 (2020-10-04):

[FEATURE] Save-states

wavexx, 2020-10-04:
Just throwing this absurd idea in here =)

It would be nice to implement save-states, with Ctrl+[index] saving the state to slot [i] and Alt+[i] to restore it (btw, this is *not* inspired *at all* by console emulators ;)).

simavr doesn't implement a way to serialize the avr structure out of the box, but you definitely played now with simavr internals quite a bit so maybe it's not completely out of reach. I guess the internal AVR state is not that hard to save, but the interface to the timers might be tricky to restore.

It doesn't even need to be persistent on disk to be useful either. My main idea was to save the current state, issue a gcode command, restore the original state, try another one to compare the result.

vintagepc, 2020-10-04:
Interesting idea... though I am not sure how well this would work in practice. Part of the issue is the way SimAVR handles the callbacks. It's not impossible, but probably even more complex than PrusaSlicer undo/redo to get right ;-). There are a lot of independent stateful parts, each of which would need to be serialized correctly.

That said... GDB might natively support doing this through its snapshots feature, perhaps that's worth a try - and if it works I don't have to do anything :rofl: :

https://sourceware.org/gdb/current/onlinedocs/gdb/Checkpoint_002fRestart.html

especially considering it is in a much better position to grab the program state than we are down in the execution code.

wavexx, 2020-10-04:
On Sun, Oct 04 2020, vintagepc wrote:
> That said... GDB might natively support doing this through its
> snapshots feature, perhaps that's worth a try - and if it works I
> don't have to do anything :rofl: :

I somehow doubt, gdb support in simavr is pretty decent, but not ultra
comprehensive :).

It doesn't support reverse execution for example, along with several
forms of hw breakpoints/watchpoints (don't remember which ones right
now). But at least those can be worked around with sw ones.

avr-gdb 8 in debian doesn't have "checkpoint" yet (but maybe I just need
to see if gdb 9 supports avr out of the box already).

Checkpoints also probably need the same kind of support required for
saved states to work in a somewhat useful way. One simple example, you'd
need to restore the axis positions according to the checkpointed
position.

vintagepc, 2020-10-04:
Well, you wouldn't be able to use AVR-gdb, you'd need to use regular GDB on the full MK404 executable. (this wouldn't work trying to snapshot just the running AVR code).

I'd imagine the way it works is just snapshotting the entire program register and memory state - which, in theory, should work just fine. Alas, I just tried it and it doesn't work because we have multiple threads. (AVR, GUI, serial...). There's no real way to make this a single-threaded application if we want any sort of external input or UI... so there goes that idea.

wavexx, 2020-10-04:
On Sun, Oct 04 2020, vintagepc wrote:
> Well, you wouldn't be able to use AVR-gdb, you'd need to use regular
> GDB on the full MK404 executable. (this wouldn't work trying to
> snapshot just the running AVR code).

Uuuh ok, I didn't think of doing _that_ ;)

> threads. (AVR, GUI, serial...). There's no real way to make this a
> single-threaded application if we want any sort of external input or
> UI... so there goes that idea.

Even "plain" reverse execution has such a limited use-case scenario that
I can count on my fingers the number of times I could make use of it :)

vintagepc, 2020-10-04:
Fair enough - I only did think of it because I probably spend more time debugging the simulator code, whereas you use avr-gdb to debug the firmware :wink:

vintagepc, 2020-10-07:
I've contemplated this a bit; I think the right (and lowest-overhead) way to do it (in addition to the SimAVR core state) is to define stream operators for the various components.

It would be session-only; I'm not going to deal with storing this to file and reading back an arbitrary version in the future when the stored contents might no longer represent the contents of the fake device, or storing the state of all the callbacks and connections.

Then we can just `<<` the object into a temporary buffer, and `>>` it when we want to restore.

I have no idea how well this will work in practice, but I suppose I'll take a crack at it.

Thread 263 (2020-10-08):

[FEATURE] Klipper support

leptun, 2020-10-08:
@vintagepc I'd like to get Klipper working in the SIM as I need to do some comparison to PrusaFirmware. Only problem is that it currently doesn't quite work. The connection to the host software times out. I checked in uart_pty.cpp and data is received and sometimes even read by the code, but at some point the XOFF hook is engaged and the firmware gives up entirely. I'm quite unsure where to start looking at this issue. I suspect that there might be some unimplemented function that Klipper uses and Marlin/Prusa-Firmware doesn't, but I would expect some kind of warning for that. There might also be a deadlock in the firmware, but I don't know how to test for that. Before we had the "D" key for getting the PC, but now that option is gone and you have to use GDB (no idea how to do this) to get the position in the code where it locks up.

To get klipper running I followed the following tutorial: https://github.com/KevinOConnor/klipper/blob/master/docs/Installation.md
I also had to do some python2 trickery since I was using Ubuntu 20.04 and had to use some renamed packages.

MK404 run command: `./MK404 Prusa_MK3S -m -s -f ~/klipper/out/klipper.elf.hex`. `-n` didn't help.
Configuration file that I use on my MK3S: [printer.cfg.zip](https://github.com/vintagepc/MK404/files/5348626/printer.cfg.zip)

I hope that you will find some free time to help me with this issue/request

vintagepc, 2020-10-08:
I can take a look at this - can you post the ELF you built? That will potentially save me some initial setup time figuring out how to build it.

I'll trade you - if you have some time to look at #253 and verify the Allegro behaviour against hardware behaviour for me it would be much appreciated and I can close out that too - I seem to remember you do have a MK2.

vintagepc, 2020-10-08:
Also, I drafted this quick how-to on debugging AVR firmware with gdb:
https://github.com/vintagepc/MK404/wiki/Debugging-Printer-Firmware-with-MK404

leptun, 2020-10-08:
Here you go. Not sure how helpful this will be since you also need the host software for it to work properly (and maybe octoprint as well if you actually want to test anything). Building it is quite easy especially since the host software and avr firmware are bundled together. Fot the AVR firmware, the default configuration in `make menuconfig` is ok.
[klipper.elf.zip](https://github.com/vintagepc/MK404/files/5348772/klipper.elf.zip)

Eh... I do have a mostly stock MK2.5S on which I can do some testing, but it will take a bit till I have access to it since my high school got closed for 2 weeks because of corona. I can look at what went wrong though and maybe I'll find the issue.

I'll try to follow the Debugging instructions and maybe I'll find something interesting/useful

vintagepc, 2020-10-08:
Looks like the Klipper FW is stuck in a WDR loop for me - If you run MK404 with `-vvv` you get endless
```
WATCHDOG: timer fired.
WATCHDOG: timer fired.
WATCHDOG: timer fired.
WATCHDOG: timer fired.
WATCHDOG: timer fired.
WATCHDOG: timer fired.
```

That might explain why it won't start... :)

vintagepc, 2020-10-09:
I did some more digging... looks like klipper isn't responding properly. I don't see any "uart_pty_in_hook" log messages that indicate the AVR is sending serial data. Only incoming data from the host.

leptun, 2020-10-09:
It’s not sending data back, but at least it’s reading it up to some point.
Doesn’t klipper actually use the wdt? That would be interesting.

leptun, 2020-10-09:
@vintagepc Interesting detail that might help you: klipper actually uses also the ReadyToSend interrupt, not only the DataReceived interrupt. Maybe that one is broken.

vintagepc, 2020-10-09:
unfortunately that may doom this from the start.

I'm hoping it might be possible to just bypass that (since the PTY is essentially always able to receive data) but that won't work if klipper expects to be able to use that signal as a means of controlling the device.

RTS/CTS are hardware control lines, and much like DTR cannot be simulated with a PTY.  We'd have to write a fake serial
port device driver with those IOCTL calls, and that would immediately break our compatibility with anything but Linux.

Another possibility would be to find a way to bind the sim to a real serial port and set up some sort of serial loopback connection (which would require two ports and physical hardware)

Option 3 is hacking up both projects to implement some sort of out-of-band flow control to mimic RTS/CTS.

leptun, 2020-10-09:
Wait... I think I sent you on a wrong path. I accidentally used the Serial equivalent names instead of the actual interrupt vector names.
`USARTx_RX_vect` is used for receiving data.
`USARTx_UDRE_vect` is used for transmitting data.
Sorry for causing confusion. The atmega2560 doesn't even have RTS/CTS support. The only chip I know that supports this is the atmega32u4 and similar.

vintagepc, 2020-10-09:
hmmm.. I may need to look at that in depth then. I know for the MK3 I had to implement a workaround because the UDRE bit was not cleared after changing the serial port config - and it would hang on boot. I wonder if there is a similar occurrence here and it gets stuck high too.

The other thing I noticed is it expects the baud rate to  be much higher than default. It shouldn't cause any issues with PTYs, but could be that it's not handled correctly somewhere.

leptun, 2020-10-09:
Klipper has a workaround for this UDRE issue:
```
// Tx interrupt - data can be written to serial.
ISR(USARTx_UDRE_vect)
{
    uint8_t data;
    int ret = serial_get_tx_byte(&data);
    if (ret)
        UCSRxB &= ~(1<<UDRIEx);
    else
        UDRx = data;
}
```
Btw, the MK3 firmware doesn't actually use the UDRE interrupt. Instead it just does the polling method and blocks the main loop

vintagepc, 2020-10-09:
Makes sense - though whether we are polling or using the interrupt to wait for it to go low... the problem is the same if it never does :rofl:

leptun, 2020-10-09:
[printer.cfg.zip](https://github.com/vintagepc/MK404/files/5355109/printer.cfg.zip)
Updated config that adds the ambient sensor on the einsy (according to latest push to master)

leptun, 2020-10-09:
Just tried writing some basic arduino code with which I could test the serial.c from klipper.
I am disappointed to report back that it works as it should, so there might be something else that breaks the firmware.

vintagepc, 2020-10-09:
yes, that's both good news and bad news.

When I inspected it yesterday, the place the firmware was looping was in sched.c

```
                do {
                    irq_wait();
                } while (tasks_status != TS_REQUESTED);
```

vintagepc, 2020-10-09:
I recall reading something about there being a built-in 2 instruction delay surrounding interrupt enable/disable.... The other thing that comes to mind is the way SimAVR terminates; there's a special case where if you sleep with interrupts disabled, it will exit the AVR run routine. So perhaps this is in some way falling afoul of that.

The crash sounds like we hit an assertion failure and/or an over/underflow somewhere. But definitely a starting point for figuring out what is up.

Sounds like there might be an opportunity for an upstream simavr patch out of this too.

vintagepc, 2020-10-09:
found it
https://github.com/buserror/simavr/issues/376

leptun, 2020-10-09:
Btw, simavr crashes after the connection is established. The LCD is initialized and the steppers are disabled and the fans spin a bit. I suspect that the simulator crashes while enabling some functionality of the MCU. The elf file provided is more or less generic. The firmware only knows it's pinout once the connection is established

vintagepc, 2020-10-09:
:+1:

the `-vvvv` argument may prove useful there; that will print some internal logging channels that can indicate whether it's on our end or a SimAVR thing.

leptun, 2020-10-09:
[klippy.log](https://github.com/vintagepc/MK404/files/5355896/klippy.log)
Just for reference

leptun, 2020-10-09:
@vintagepc How can I make the GL information stop being reported when using -vvvv? Even if I ignore the GL stuff, nothing extra is printed when simavr crashes

vintagepc, 2020-10-09:
There's an if() in MK404.cpp that checks for the verbosity and calls GLDebugcallback to get notified on GL logging events. You can just comment that out temporarily.

leptun, 2020-10-09:
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
I was not expecting that this will be an error in the LCD code. I'll try disabling the LCD in klipper and see if it fixes itself

vintagepc, 2020-10-09:
That looks like an OOB on the vRAM on the LCD.

`m_vRam[m_uiCursor] = ...` -> m_uiCursor seems to have been set to a value > 104.

leptun, 2020-10-09:
And we have another issue...
```
Send: Status
Recv: // MCU 'mcu' shutdown: Rescheduled timer in the past
Recv: // This generally occurs when the micro-controller has been
Recv: // requested to step at a rate higher than it is capable of
Recv: // obtaining.
Recv: // Once the underlying issue is corrected, use the
Recv: // "FIRMWARE_RESTART" command to reset the firmware, reload the
Recv: // config, and restart the host software.
Recv: // Printer is shutdown
Recv: // Klipper state: Not ready
Recv: !! MCU 'mcu' shutdown: Rescheduled timer in the past
Recv: ok
```

leptun, 2020-10-09:
Initializing code for timer1
```
// Activate timer dispatch as soon as possible
void timer_kick(void)
{
    timer_set(timer_get() + 50);
    TIFR1 = 1<<OCF1A;
}

static inline void timer_repeat_set(uint16_t next)
{
    // Timer1B is used to limit the number of timers run from a timer1A irq
    OCR1B = next;
    // This is "TIFR1 = 1<<OCF1B" - gcc handles that poorly, so it's hand coded
    uint8_t dummy;
    asm volatile("ldi %0, %2\n    out %1, %0"
                 : "=d"(dummy) : "i"(&TIFR1 - 0x20), "i"(1<<OCF1B));
}

static inline uint16_t timer_get(void)
{
    return TCNT1;
}

void timer_init(void)
{
    irqstatus_t flag = irq_save();
    // no outputs
    TCCR1A = 0;
    // Normal Mode
    TCCR1B = 1<<CS10;
    // Setup for first irq
    TCNT1 = 0;
    timer_kick();
    timer_repeat_set(timer_get() + 50);
    timer_reset();
    TIFR1 = 1<<TOV1;
    // enable interrupt
    TIMSK1 = 1<<OCIE1A;
    irq_restore(flag);
}
```

I'm actually a bit confused why they don't use the CTC mode, but I digress.

leptun, 2020-10-09:
Aaaand the cursor position where it attempts to write is 117 decimal. So outside the screen. The commands it sends to the LCD are very suspicious. Wondering if the timer issue is linked to this (no idea how the lcd is implemented in klipper).
This looks suspicious:
```
ProcessWrite command 0write when still BUSY
```

vintagepc, 2020-10-09:
IIRC that's just a warning that it's writing to the display faster than the real thing can handle.

Does klipper read back data from the LCD at any point? it might not be wired up to support that as the factory firmware only ever writes.

leptun, 2020-10-09:
RW line is not implemented on the einsy/ultralcd, so it shouldn’t ever try something like this.

vintagepc, 2020-10-09:
Yes, something seems very wrong with the LCD config or I/O... I tested it by expanding the ram to 128 and got this:
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

vintagepc, 2020-10-10:
It almost looks like all the LCD bytes are off by a nibble.

I wonder if it's worth opening a request for help on their github; at the very least they might be able to interpret the klipper logs for us to help pinpoint the issue.

vintagepc, 2020-10-10:
I should note that I recompiled locally and tweaked the irq_wait() function ASM line to have two `nop` calls. Now it behaves similarly to the one you provided - but they both still sometimes get in a state where it won't seem to connect at all.

leptun, 2020-10-10:
The LCD issue is not really related to the timer in the past issue as even if the LCD is disabled in the config, the timer still executes in the past.

I also noticed that it fails to connect sometimes. When that happens I just restart the klipper service and also the printer and then it “works”

vintagepc, 2020-10-10:
Yes - I don't think the display itself is the cause - I think it is just a sign that something is going wrong earlier in the startup and causing problems downstream.

vintagepc, 2020-10-11:
Did a bit more poking, have the following notes to add:
 - changing the SEI code to -1 instead of -2 does indeed appear to resolve the hang; it boots as expected with the stock build then.

- I can confirm the problem appears to be the combo of klipper and simavr. I modified the simduino example on a stock simavr checkout and it exhibits the same "timer scheduled in past" issue.

vintagepc, 2020-10-12:
Made some more progress today. Display issue is due to bad init and our virtual display not tossing out writes while busy.

I hacked around the timer stuff temporarily and need to dive in more.

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

leptun, 2020-10-12:
Did you push these changes anywhere?

vintagepc, 2020-10-12:
Just pushed to 263-klipper-support. git submodule update required for simavr tweak.

I temporarily worked around the timer in past by commenting it out in the klipper source until I can dive in deeper.

vintagepc, 2020-10-12:
Just pushed up a fix for the initial bootup issue (submodule update required).

We get further now but attempting to do anything results in "timer too close", so that is the next problem to debug.

leptun, 2020-10-13:
Issues left to fix:
- [ ] Bed heater is always enabled. Probably need to revert some of the hacks from PrusaFirmware with the timers
- [ ] Axes hit the endstops immediately. This is not consistent as sometimes the Z will try to home, otherwise it homes instantly. X/Y always home instantly.
- [ ] Fans seem to work, but we get the timer too close error sometimes.
- [ ] Hotend heater seems to work, but the timer issue didn't let me pass ~40C
- [ ] `Timer too close` error

vintagepc, 2020-10-13:
Knocked off the first one; `-n` now disables the bed softpwm hack that causes this.

vintagepc, 2020-10-13:
Hmm... I'm seeing this in the logs. Might have to artificially slow down the sim a bit...
`freq=41679345`

vintagepc, 2020-10-13:
hot damn, that seems to have worked!

Looks like the endstops need to be inverted in the printer config, they're tagged with a `!` for active low but DIAG is active high as we use it with the official firmware.Fixing that causes X/Y to home as expected.

Not sure what's up with Z; that doesn't seem happy. Digging in.

It now throws a "not heating at expected rate" error - good sign, means I think we're close to just fine-tuning the config!
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

Pushed up the speed hack - in Board.c RunAVR():
```

		if (m_pAVR->cycle > cnt+2000)
		{
			usleep(10);
			cnt = m_pAVR->cycle;
		}

```

it's likely machine specific, for now just play with the cnt+ [value] to find something that klippy.py reports `freq=` as close to 16MHz. Longer term I'll look at a way of constraining that dynamically and/or figuring out why this firmware clocks at 41MHz whereas the stock one seems to be more true-to-life. Could very much just be the emulation load.

leptun, 2020-10-13:
@vintagepc Please check the config. I think they are using the other DIAG pin mode of functioning where it's active low only, not push-pull

vintagepc, 2020-10-13:
Ah, ok - in that case we'll need to implement the config register in the TMC2130. I forgot about that possibility and will implement it. In any case it's a minor tweak that can get you underway while I polish things :+1:

I'm sure @KevinOConnor will be interested in the progress here :smile:

vintagepc, 2020-10-13:
Pushed up a proper diag_pushpull implementation.

KevinOConnor, 2020-10-13:
> Longer term I'll look at a way of constraining that dynamically and/or figuring out why this firmware clocks at 41MHz whereas the stock one seems to be more true-to-life.

FWIW, I implemented the code at: https://github.com/KevinOConnor/klipper/blob/cef9cc29b8f150681cd24ca6f051fc9f03fc924b/scripts/avrsim.py#L102 to do something similar for simulavr.  (Basic idea is to alter the sleep amount based on how much the clock rate differs from the system time, while also preventing an unfortunate "slow emulation" from incurring a future "fast emulation to catch up" - as that would just make things worse.)

-Kevin

vintagepc, 2020-10-13:
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

Yes - simAVR has similar code internally to avoid sim and wall time divergence. I do not know why it doesn't seem to be working here (for either firmware - stock f/w also seems to be clocking much faster).

vintagepc, 2020-10-14:
Simulator's PID parameters:

// PID parameters: pid_Kp=63.285 pid_Ki=12.785 pid_Kd=78.316

I know it seems to stall out as it gets close to the target with the defaults.

vintagepc, 2020-10-14:
Teaser... Still fragile but I managed to get it to home, heat up, and run a VFA print:

The fuzzy section towards the bottom is with X nonlinearity on, the rest is with it off.

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

What's very interesting... is the artifacts do not line up vertically. This would be *very* interesting to compare with a real print.

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

wavexx, 2020-10-14:
mmh, there's always the E axis involved right? (to get the width).

vintagepc, 2020-10-14:
ooooh, true; if the E behaviour is very different it would change where the excess and under-extrusion happens

wavexx, 2020-10-14:
I mean, XYZ cannot drift, so the only motor that can shift here is E (unless we have a bug somewhere of course ;))

vintagepc, 2020-10-14:
A bug is always possible but would be very strange given the way the positioning works.

wavexx, 2020-10-14:
Looks about right to me BTW. The different level of artifacts might suggest the klipper config has a different e-step/mm spacing perhaps?

vintagepc, 2020-10-14:
I just pushed up some code with `--skew-correct` which attempts to correct clock skew in the fast direction (it can't help if the system is too slow, of course).

It seems to make the frequency a lot more stable which in turn stabilizes Klippy.

I'm attempting to run a print with pronterface now to see if it is effective at preventing "timer too soon"s.

DRracer, 2020-10-15:
@vintagepc was your print aligned with X or Y axis? If not that might be the cause of those non-aligned artefacts. We can see them on our FW as well, but so far they have been perfectly aligned. Another possibility is MBL kicking in

vintagepc, 2020-10-15:
Yes - this was my X-only single-wall VFA test gcode that I have checked in.

vintagepc, 2020-10-15:
@leptun I reworked the skew correction a bit and on my machine the Klipper freq parameter is now very close to 16 MHz. I have not yet seen a "timer too close" after this change. I do get a "timer in the past" but it happens at the exact same point in the gcode so I suspect it is badly sliced with too high a travel speed.

Also, pushing the pause key will now print out stats, e.g.:

```
Sim is behind by164us!
Pause:
Sim is ahead by2966us!
```

A few things that may help with your VM speed, too:
- Make sure you run cmake with `-DCMAKE_BUILD_TYPE=Release`. That enables compiler optimizations and removes debugging symbols from the code.
- If you haven't already, double check your VM has at least three virtual CPUs, if not more, since there are at least three threads running  - UI, AVR core, and serial.

Let me know if this fixes the issues for you too.

leptun, 2020-10-15:
I’ll try it later today. 👍

leptun, 2020-10-17:
I just pushed a small patch to a mistake (probably forgot to stage this change). Switching to Release did the trick for me in the VM. Now with the speed patch I get 33Mhz so I actually need to slow down :). When pausing I am waaaay ahead. I assigned 4 virtual CPUs to the VM from the beginning. 4GB of RAM is probably more than enough especially when not rendering extrusion. Is the current code supposed to ensure 16MHz regardless of (excess) system performance? Because if yes, then it is not working for me. Not yet anyway

leptun, 2020-10-17:
I tracked the issue. Forgot to add `--skew-correct` when running MK404. Now it works perfectly. Just a bit under 16Mhz, which is fine. Thank you again for implementing support for klipper. Now I wonder, how are we going to make this part of the main program and not just a list of hacks to enable for klipper? I'd guess that we could have something like `--fw <PrusaFirmware/klipper/Marlin/generic(aka. nohacks)>` so that we don't have to remember what hacks to enable every time. If no `--fw` is specified, then we use the standard hacks for PrusaFirmware, or we use no hacks at all. The decision is yours to make.

vintagepc, 2020-10-17:
I've been pondering something similar; I don't see any reason we couldn't do that if I can find a way to poke the incoming arguments, e.g. if `--fw klipper` is set it automatically enables `--skew-correct` and `-n`. Should be fairly easy to maintain.

Glad to hear it's working for you! I'll review/polish the changes we made in the klipper branch and work at merging it up to master.

vintagepc, 2020-10-17:
Alas TCLAP has no nice way to handle convenience args; if we start needing more of them I'll look at forking the project and adding some sort of support to deal with them dynamically.

But for now I've just added --klipper and --marlin as shorthand for their respective -n and skew flags.

KevinOConnor, 2020-10-17:
What was the verdict on the "fine artifacts" result reported at: https://github.com/vintagepc/MK404/issues/263#issuecomment-708543765 .  I'm not familiar enough with the test to understand if the results were something with Klipper or something with the simulation.

-Kevin

vintagepc, 2020-10-17:
We don't know for sure yet - investigating that stepping behaviour as compared to other firmware is part of the reason for this request to support Klipper. There's some more discussion on the details of the visualization in #114; The image is essentially turning the stepper steps into something we can easily interpret visually - it doesn't mean Klipper is doing anything "wrong" - just that it's different from what we've seen with stock firmware and we'll have to look a little deeper to understand it. :+1:

leptun, 2020-10-17:
This is what the VFA print looks like when printed using Klipper on a MK3S. The following 3 pictures are made using different flow rates (M221). Not sure if this diagonal pattern we are seeing is what was generated in MK404 or if it's some other issue (most likely TMC2130 related).
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
@vintagepc What settings did you use for the picture above with klipper diagonal lines?

vintagepc, 2020-10-17:
I did not do anything besides connect, load the file in Pronterface, and print (so default speeds etc as given in the gcode).

The fuzzy section in the middle was purely toggling X nonlinearity via the context menu.

Your pictures are very interesting; traditionally the diagonal lines are E nonlinearity since the E position is what is changing from layer to layer.

The uneven end is actually very interesting - I saw that in the simulation too but I chalked that up to LA.

vintagepc, 2020-10-17:
Just saw the edit - I bet if we ran a simulation with E nonlinearity you would see the same periodic underextrusion.

leptun, 2020-10-17:
The uneven end is caused most likely by poor adhesion on my printer. With higher flow rate I managed to make the parts stick more to the bed, but it's still not great. This really needs a brim for real prints.

leptun, 2020-10-17:
@vintagepc Actually, how uneven was the end of the part in MK404? I might have some minor issues with LA on actual prints with Klipper at very high speed and maybe this is related.

KevinOConnor, 2020-10-17:
I'm not all that familiar with this topic, so it's hard for me to comment.  (VFA is "very fine artifact"? What's "LA"?)

I can say that the order of Klipper step pulses is unlikely to match Marlin/Prusa.  Those firmware use the Bresenham algorithm which causes strict (and incorrect) ordering between step pulses.  Klipper calculates and schedules a precise time for every step pulse irrespective of the step pulses occurring on other stepper motors.  So, there wont be a clear ordering of step pulses between steppers - except as dictated by toolhead movement.  That said, Klipper does allow the final step times to move within a window of 25us to improve compression (think +-12.5us).  So, in summary, if the simulation is dependent on step pulse ordering than that may show up differently with Klipper.

As for non-linearity - I'm guessing you are referring to the fact that stepper motor coils may not be perfectly balanced, and are also referring to the tmc2130's ability to alter the sine wave to account for that?  If so, Klipper doesn't currently support that.  Though I understand that @Arksine has implemented that in one of his branches.  If I understand correctly, though, he didn't find much of an improvement with it on his printers.

-Kevin

vintagepc, 2020-10-17:
Yes - VFA = "vertical fine artifacts" - fine striations in the print surface that line up vertically. LA = linear advance.

We are indeed simulating the nonlinearity of the stepper coils for the goal of understanding its effects. Thanks for your insight on the stepping; it does explain some of what we are seeing; the visualization of MK404 is limited to the resolution of the E steps (since that is what we use to do the drawing). So if E does not "tick" consistently relative to X and Y ticks,  then it could make sense that the simulated VFAs do not line up at this time (but I suspect they would if we re-ran the simulation at a higher level of E microsteps.)

@leptun - I reran that print, more pictures:
Starting edge:
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

The big gashes are E-nonlinearity enabled - that looks a lot like your 95% picture!
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

Here's what the right edge of my print looks like:

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

Closeup of the nonlinear X section:
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

leptun, 2020-10-17:
LA is Linear Advance, I think it is called Pressure Advance in Klipper.
I actually have no idea right now if it's stepper inconsistency that is causing the lack of material or if it's some other mechanical issue (or maybe something related to the drivers).
The start of line wobble issue might be because of what you said above with VFA: Nothing will be drown unless E does a step. As a result, the start of the line might shift with up to a step in length every layer because of this. I think you can actually observe a pattern in that as well. So I don't think this has anything to do with LA.

KevinOConnor, 2020-10-17:
Okay, just so I understand, every time there is an E step pulse, the visualization draws a line from the XY position of the last E step pulse to the XY position at the current step pulse?

> Here's what the right edge of my print looks like:

I suspect that is an artifact of the simulation - I'd guess there is not a even number of E steps per linear movement.

To explain with an example, consider a line segment that requests 200 X steps with 87.654 E steps over 1s.  With the Bresenham algo, you'd get 200 X steps every 5ms, and 87 E steps sometimes spaced 10ms and sometimes spaced 15ms apart.  In contrast, Klipper would produce 200 X steps every 5ms and an E step every ~11.408492ms apart.  That is, Klipper produces both smooth E movement and it can effectively produce "fractional e-steps" by using proper tuning.  The timing of the E step pulse at the start of the next extrusion move is dependent on the fractional e-steps position.

So, in summary, I suspect you're seeing uneven corners on Klipper because the simulation is getting confused by the timing (wrt fractional e-steps) of the first step in the following movement.

> LA is Linear Advance, I think it is called Pressure Advance in Klipper.

Ah, okay.  They have
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

Thread 265 (2020-10-08):

[FEATURE] Simulation of real filament flow/springiness

DRracer, 2020-10-08:
**Is your feature request related to a problem? Please describe.**
My request is related to a problem, which is however not in MK404 :) .

**Describe the solution you'd like**
Right now we are able to make detailed visualization of extrusion thickness. We can even do nonlinear behavior of the TMC+motors. The functions responsible for doing this are:
```
void OnXStep(const uint32_t &value)
void OnYStep(const uint32_t &value)
...
```
@vintagepc do you see a possibility of passing some kind of simulation step or temporal difference? Imagine adding filament dynamics into the visualization. That may help tackling ghosting artefacts and Linear Advance issues which we think are still present even in FW 3.9.1

vintagepc, 2020-10-08:
Hmm.... I had no designs on it initially, but it's code, so anything is possible.

Are you just asking for a way to see the extrusion derivative with respect to distance or time? (Time would be trickier, but probably also possible) Or, are you asking about a very literal simulation of the plastic flow?

If the latter, what's tricky is figuring out the actual plastic simulation; I suppose an initial start could be a simple sliding window impulse filter on delta E (so  that spikes turn into "blobs").

That might be sufficient, but my concern here is that this is going to very quickly become a very deep rabbit hole because of the number of factors and complexity involved (temperature, melt volume, pressure, extrusion rate, ....) bottom line, it would be a very complex physics simulation, to the extent there are entire software packages for modelling such things...

DRracer, 2020-10-09:
@vintagepc I'd like to develop a very simple spring model of plastic flow to smoothen the extrusion visualization similarly as real plastic does. I'm looking for artefacts in Linear Advance (ghosting in acceleration segments to be exact - you have them on your print as well ;) ), which can be then mitigated by clever timing of LA pulses.
My initial idea was to get time (steady time stamp, temporal difference, whatever else) into the functions above and plug in some separate spring model of plastic just like we are using the motor nonlinearity right now. The rest would remain the same, nothing too complex.

vintagepc, 2020-10-09:
Hmm... that doesn't seem too wild. For time it would likely be best to use the delta in CPU cycles converted to seconds, as that should be fixed regardless of how fast or slow the simulation is running.

DRracer, 2020-10-09:
yes, that would be sufficient - I just need some time stamps to try it out ;)

vintagepc, 2020-10-09:
I'll see what I can plumb in, then I can just hand you a place to stick the equation ;-)

vintagepc, 2020-10-19:
I'm extending this a little; I'm working on some math to detect when we exceed the max volumetric rate of the hot-end. No idea how well it will work in practice but if I can get it working it would be good to help ID underextrusion artifacts caused by excessive travel speed or extrusion volumes.

Leaving it permanently on would probably suppress impulse artifacts so I think it will be most useful as an alternative to `--colour-extrusion` where we change the lerp to track the segment volumetric rate instead of the extrusion width. I don't think designating clamped values alone is going to be all that useful, seeing the colour variations as we get closer and move away from the (theoretical) limit is likely going to be more relatable to what we've seen in practice, if anything.

vintagepc, 2020-10-19:
I think I've got it working, I'll push up a branch with this feature shortly once I add a command line flag to enable it. I think it's obvious where any inspiration came from :stuck_out_tongue:

Gcode with perimeter speeds @ 50mm/s to start (volumetric rate 4.1mm^3/s) and increasing speed (M220) by 50% every 3 mm (so 150, 200, 250, 300) thereafter.

"Red" or "max" is calculated based on the published max capacity of 11.5mm^3/s, but of course this will vary depending on filament properties and nozzle temperature)

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

wavexx, 2020-10-19:
On Mon, Oct 19 2020, vintagepc wrote:
> I think I've got it working, I'll push up a branch with this feature
> shortly once I add a command line flag to enable it. I think it's
> obvious where any inspiration came from :stuck_out_tongue:

It would be nice to switch between colorization modes without having to
restart ;)

vintagepc, 2020-10-19:
Alas that's challenging with the current design. we don't retain the source data once the triangles have been pushed into the vertex vector. (Same reason toggling nonlinearity does not retroactively enable on things that have already been rendered) I suppose it's possible if we rearrange the originals but this particular bit of code is already fairly costly in terms of computation so I'm not sure it would be a good idea to run additional calculations that are not actively in use. In fact I need to look at it and see if it can be optimized a bit.

I suppose the cost of storing the path is << the triangles rendered though, so maybe a nice middleground is to support changing that on the fly but only on-demand. Perhaps it's even worth printing a greatly simplified rendering until the print is finished (plain lines which comprise the path) and then being able to shove all of the vertices into an actual graphics card vertex buffer for the final render in highres mode.

Thoughts? I don't have a good sense of the use case; is there a lot of benefit to seeing the realtime output or do we generally just look at the final result once it's "done" printing?

vintagepc, 2020-10-19:
Filed #277 to investigate this.

wavexx, 2020-10-19:
On Mon, Oct 19 2020, vintagepc wrote:
> Thoughts? I don't have a good sense of the use case; is there a lot of
> benefit to seeing the realtime output or do we generally just look at
> the final result once it's "done" printing?

I didn't actually mean to change the existing path, just to switch to a
different mode for the new vertexes as they're being pushed.

This is already more than helpful when printing objects which are
repeated in Z. If I see suspicious behavior I can always clear the
buffer and start anew for a more in-depth inspection.

vintagepc, 2020-10-19:
*looks at the entirety of MK404

I thought by now it's clear I either go big or go home... :rofl:

wavexx, 2020-10-19:
Muhahah ;). I wouldn't discard the option to switch mode without changing the existing path.
I still like the idea to look at a wall which has been colored in 2 different modes over time :stuck_out_tongue: across Z.
Much easier to compare than looking at two models side-by-side, even now that we have that ;)

DRracer, 2020-10-20:
@vintagepc  wow, I love it! This looks exactly like what is needed to fix (counteract) the ghosting artefacts in Linear Advance.

vintagepc, 2020-10-20:
:+1: I've pondered it and I think I'll do away with the separate command line arguments and just move both colourization options to the context menu so that one can be picked on the fly. I'll leave recalculating the existing content to a future endeavour.

vintagepc, 2020-10-20:
Pushed - I moved the colourization options to the menu.
Note - they will not show unless you have passed `--colour-extrusion` on the command line;  this is because we skip processing the colour entirely if we haven't been asked to do so and the colour vector would not be correctly aligned if one tries to go from "no colouring" to such an option it on mid print.

vintagepc, 2020-10-20:
Note I'm holding off merging this since when we do I'd like to have #276 merged in and be able to add some test coverage for these features. I also expect it to change/expand in the near future, so no point writing tests too early if they are going to be invalidated anyway.

vintagepc, 2020-10-24:
I stumbled upon a very interesting print today while experimenting. 5% gyroid at normal infill speeds seems to produce some very interesting patterns:

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

I suspect this rippling may be the burst-mode stepping that was previously mentioned

wavexx, 2020-10-24:
@DRracer found a case earlier this week where a low-poly circle would significantly increase LA due to the jerk limit being hit (due to a bogus jerk calculation really).

I guess you generated this using the latest PS right? I submitted a patch earlier this ear to perform aggressive simplification which likely hits the case/resolution combo.

Please don't trash the settings ;), this is speed/height dependent

vintagepc, 2020-10-24:
Correct :smile:

DRracer, 2020-10-24:
Yes, this is one thing we have to fix - this is entirely an error in the FW breaking several types of "smooth" print paths.

vintagepc, 2020-10-24:
Yup.

What I find very interesting (and completely unrelated) is how some of these prints look a lot like those ChromaDepth 3d images that you often see for geography and topographic displays.. :laughing:

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

Thread 266 (2020-10-09):

[BUG] MBL map does not appear to work for print simulation

vintagepc, 2020-10-09:
**Describe the bug**

Per the discussion on #264, it looks like the printer MBL map isn't working right. Investigate.

DRracer, 2020-10-09:
Update - the white print line follows the bed (had to make a really bad heatbed with 1.5mm peaks), but the highres extrusion visualization doesn't (this lays flat onto the bed).

DRracer, 2020-10-09:
Screenshot from the sim:
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
notice the white line going up on the right side

vintagepc, 2020-10-09:
Ah, this may just be a simple oversight. It looks like AddSegment() uses the same Z start/end values for the extrusion chunk.

3d-gussner, 2020-10-09:
> Update - the white print line follows the bed (had to make a really bad heatbed with 1.5mm peaks), but the highres extrusion visualization doesn't (this lays flat onto the bed).

You should contact Support if you have that kind of bent bed 😁 and ask for replacement

vintagepc, 2020-10-09:
Sounds like the complaint is "my bed isn't broken enough, it prints too level!" to me :rofl:

DRracer, 2020-10-09:
@vintagepc I'm afraid this may get a little more complicated, because we need to take the Z-motor nonlinearity into consideration while processing the printed segment

vintagepc, 2020-10-09:
And the backlog gets longer.... :stuck_out_tongue:

Are we thinking part of the cause of 602 is non-linearity coupled with MBL?

vintagepc, 2020-10-09:
I pushed up a print-sim-enhancements branch which has a partial for what I bashed out this morning.

It brings a dT (delta cpu cycles) through to OnEStep and fixes the Z endpoint of print segments. Didn't have time to check it though so it might be horribly broken.

DRracer, 2020-10-09:
Nope, issue 602 is purely caused by nonlinearity of the E-motor.
But for the sake of completness, Z-axis and MBL related issues (line segmentation) are missing in our analysis so far.

Delta CPU cycles: that should be enough, I'll look into it.

vintagepc, 2020-10-09:
I'm hoping just fixing the segment start/end Z might actually be enough to make issues visible given the x/y segment sizes tend to be very small in HR modes anyway. But if not we can improve the calculations.

I suspect it might be necessary to carry the deltaT down through to the addSegment function, but I'm not 100% sure. It might be perfectly satisfactory to calculate an adjusted E value based on that during the main onEStep calculations as well.

vintagepc, 2020-10-10:
OK - can confirm that the simulated print now follows the MBL curve as expected:

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

Z nonlinearity can be enabled and with the quads being so small I expect that it should reveal any issues as a gap between adjacent ones as opposed to a smooth transition.

Is there anything else do do on this particular issue or is this satisfactory for now?

Closed 2020-10-15.

Thread 269 (2020-10-10):

[CI] Break up automated tests

vintagepc, 2020-10-10:
The automated tests are kinda lengthy compared to build times. Maybe split them into two or three sets that can run in parallel.

Will need to merge the resulting .info coverage files before issuing the report; shouldn't be an issue since they will be compiled the same way... I hope.

Will also need to split the snapshot images by test group as well.

Maybe one set as the core component tests and the other set as the actual printer sanity tests.

Comment-on-PR doesn't work for forks, maybe find an alternate way of getting that coverage report posted. (codecov.io?)

Closed 2020-10-10.

Thread 280 (2020-10-29):

[IMPROVEMENT] - Shorten some of the graphics tests.

vintagepc, 2020-10-29:
**Is your feature request related to a problem? Please describe.**

The MK3 3d graphics tests can be cut down. Right now they sit idle for a lot because they wait for the printer to boot so we don't screenshot while other things are going on.

**Describe the solution you'd like**

Fix this with a custom firmware that just activates the things we need to avoid the long boot wait time, or no FW at all, like the MK2 3D tests.

Closed 2020-10-31.

Thread 284 (2020-11-12):

[FEATURE] PINDA Image implementation

vintagepc, 2020-11-12:
**Is your feature request related to a problem? Please describe.**
Add support for the simulated PINDA to replicate an "image" as output by a MK3S over serial.

vintagepc, 2020-11-12:
@DRracer - Just pushed up a preliminary implementation.
https://github.com/vintagepc/MK404/tree/PINDA-image-option

It's not complete/not quite right, but that is more to do with understanding the search algorithm and correcting the "magic numbers" that make it work than anything functional; That is something I expect would be far more expedient for someone familiar with the algorithm as opposed to my reverse engineering it. It's also entirely possible my issues are due to using an "image" from the simulated PINDA so it doesn't look quite enough like the real thing; it's very sensitive to Z height and this is the bit where I am "stuck" with a magic number. 

In any case, the core is there so you can paste in a text string "image" and it is parsed into a 32x32 array which is then used to determine the trigger height over a range that is +/-1024 steps from the defined center of the calibration point - the math happens in the CheckTriggerNoSheet function in PINDA.cpp.

Old behaviour can be restored by undefining ENABLE_PINDA_IMAGE in PINDA.h.

Note that because the image is parsed based on PINDA position, it should be the "corrected" one with alternate lines flipped to correct for travel direction.

Let me know if you can work with this or if you'd prefer I dig in more first.

Thread 287 (2020-11-25):

[Q+A] Running in Windows subsystem for Linux

espr14, 2020-11-25:
I can build MK404 on Ubuntu 20 on WSL on ext4. WSL (compared to WSL2) does not have display:0 but I used VNC so I ran it on display:1. It has some problem with OpenGL. I'll try WSL2.

vintagepc, 2020-11-25:
What sort of issue are you encountering? (error messages, console output etc)?

Have you tried with the "native" cygwin build?

3d-gussner, 2020-11-26:
@espr14 I had MK404 running in WSL2 and it kind of worked. Changed to Dual boot due to my "old" PC wasn't performing that well with MK404 in WSL2.
Also to install MK404 on "fresh" Ubuntu this might help:
```
sudo apt install -y libelf-dev gcc-7 gcc-avr libglew-dev freeglut3-dev libsdl-sound1.2-dev libpng-dev cmake build-essential lcov mtools
```

espr14, 2020-11-26:
sudo apt install git

vintagepc, 2020-11-26:
That should be fine for most purposes, though the VM likely will not have enough GPU grunt for `-g fancy` or any of the 3d extrusion options.

espr14, 2020-11-28:
`-g lite` runs ~8 fps.

vintagepc, 2020-11-28:
Have you enabled 2d/3d acceleration in Virtualbox and installed the drivers in the ubuntu guest?

vintagepc, 2020-11-28:
https://blogs.oracle.com/scoter/oracle-vm-virtualbox-6-3d-acceleration-for-ubuntu-1804-guest

Closed 2021-03-07.

Thread 288 (2020-12-09):

[FEATURE] Consolidate new pipe-frontend code with existing devices

vintagepc, 2020-12-09:
**Is your feature request related to a problem? Please describe.**
When the IPC frontend is more complete, consolidate the components (e.g., have the Allegro and TMC drivers derive from GLMotor for their graphics, and have LED-type devices derive from IPCIndicator).

Closed 2021-08-10.

Thread 289 (2021-01-22):

[BUG] cmake variable incorrect

yash-fn, 2021-01-22:
Simple Build Error.

MK404 target requires
set (LIBSIMAVR ${PROJECT_SOURCE_DIR}/3rdParty/simavr/simavr/obj-${SIMAVR_BIN_DIR}/libsimavr.a)
to be changed to
set (LIBSIMAVR ${PROJECT_SOURCE_DIR}/3rdParty/simavr/simavr/obj-${SIMAVR_BIN_DIR}.2.0/libsimavr.a)

in order for it to build.

I don't know cmake so I don't know how to change that .2.0 expression into a wildcard or regex.

My system: Latest MacOS running on macbook pro. All dependencies installed using homebrew.
MacOS Big Sure 11.1

vintagepc, 2021-01-22:
Not sure where that is coming from, we use the same syntax as simavr to determine what the build obj directory is.

What compiler are you using and what is the output of `[compiler] -dumpmachine`?

yash-fn, 2021-01-22:
gcc-10 (Homebrew GCC 10.2.0_2) 10.2.0

I do not know how to determine [compiler] -dumpmachine.

All I know is that the project wouldn't compile until I added the .2.0 part. But perhaps I did something wrong. If you are sure it works on your system then we can close the issue as there is no problem for me now either as the project ultimately compiled successfully! I was just bringing to your attention that this was what I had to do to get it to work.

vintagepc, 2021-01-22:
Yes, we've not encountered this before (and the git CI system builds every commit) so there must be something strange about this particular instance.  If you're using gcc, it should just be `gcc -dumpmachine` in the command line

yysh12, 2021-01-23:
x86_64-apple-darwin20

Well that’s weird.

yysh12, 2021-01-23:
x86_64-apple-darwin20

Well that’s weird. And right now just playing around, but eventually going to attempt to use this to test an new stepper ISR I’ve been working on.

vintagepc, 2021-01-23:
Hmm... strange indeed. the only thing I can think of is the simavr module might be defaulting to a different compiler if not explicitly specified with, e.g. `cmake -DCMAKE_C_COMPILER=....`

Hope your project works out - that's exactly the reason I made this! No more guessing what might be going on in the code when something doesn't work :)

yysh12, 2021-01-23:
Yeah. Possibly something isn’t vanilla on my system. I’ve been installing a lot of random crap including all sorts of mcu toolkits and system extensions. But, as they say, if it ain’t broke.
And thanks! Yeah this system you’ve created is pretty damn amazing. I’ll be sure the spread the word! <3

yash-fn, 2021-01-23:
Yeah. Possibly something isn’t vanilla on my system. I’ve been installing a lot of random crap including all sorts of mcu toolkits and system extensions. But, as they say, if it ain’t broke.
And thanks! Yeah this system you’ve created is pretty damn amazing. I’ll be sure the spread the word! <3

Closed 2021-01-22.

Thread 291 (2021-02-03):

[BUG] MK404 always enters factory reset after reboot or WDR

vintagepc, 2021-02-03:
**Describe the bug**
When resetting the printer or due to WDR, it will get stuck in factory reset because the encoder button is in the wrong state.

Find out why the code that is supposed to handle this after a delay isn't working.

Closed 2021-02-07.

Thread 311 (2021-06-19):

[FEATURE] Allow mounting SD images in R/O mode

wavexx, 2021-06-19:
**Is your feature request related to a problem? Please describe.**
I'm looking at some test SD images which I made intentionally R/O. These fail to mount, since in SDCard.cpp:571 we explicitly open them with O_RDWR with no fallback.

**Describe the solution you'd like**
If open() fails, we should attempt to reopen the file with O_RDONLY or probe using access(2).

If O_RDONLY succeeds, for a proper simulation, mmap shouldn't have PROT_WRITE and we should also mark the CSD's PERM_WRITE_PROTECT bit and return errors during writes.

**Describe alternatives you've considered**
For now I just attempt to reopen with O_RDONLY to ensure I don't change testing images, but that's not a PR I would submit ;)

Closed 2021-06-19.

Thread 313 (2021-06-20):

[BUG] Crash on PINDA when probing outside the bed range

wavexx, 2021-06-20:
**Describe the bug**
Attempt to perform MBL on a MK2.5S results in a crash:

```
#0  __GI_raise (sig=sig@entry=6) at ../sysdeps/unix/sysv/linux/raise.c:50
#1  0x00007ffff7798537 in __GI_abort () at abort.c:79
#2  0x00007ffff7b327ec in ?? () from /lib/x86_64-linux-gnu/libstdc++.so.6
#3  0x00007ffff7b3d966 in ?? () from /lib/x86_64-linux-gnu/libstdc++.so.6
#4  0x00007ffff7b3d9d1 in std::terminate() () from /lib/x86_64-linux-gnu/libstdc++.so.6
#5  0x000055555558db37 in gsl::detail::fail_fast_terminate () at /home/ydelia/prusa/MK404/3rdParty/gsl/gsl-lite.hpp:1272
#6  0x00005555555be7e3 in gsl::at<float, 49ul> (arr=..., pos=255) at /home/ydelia/prusa/MK404/3rdParty/gsl/gsl-lite.hpp:1735
#7  0x00005555555bd090 in PINDA::CheckTrigger (this=0x555555798790) at /home/ydelia/prusa/MK404/parts/components/PINDA.cpp:136
#8  0x00005555555bd255 in PINDA::OnZChanged (this=0x555555798790, value=1086324736) at /home/ydelia/prusa/MK404/parts/components/PINDA.cpp:227
```

The calculated iX is 255, because the m_fOffset[0] = 25, m_fPos[0] = 10, so it results in a negative number. Note that this is happening while homing, not during MBL.

Maybe the XY offset is not entirely correct at that point? There's a good argument that PINDA shouldn't trigger when far away from the bed (although it should still work within a ~5mm boundary), but it shouldn't crash.

**To Reproduce**
Start with a MK2.5S FW, perform G28.

**Expected behavior**
No crash.

Closed 2021-06-20.

Thread 315 (2021-06-23):

[FEATURE] ScriptHost: Board::WaitForReset()

wavexx, 2021-06-23:
**Is your feature request related to a problem? Please describe.**
I'd like a way to explicitly wait for a reset instead of having to match some output from the serial to tell if the board just rebooted.

**Describe the solution you'd like**
Board::WaitForReset() sounds good to me :)

**Describe alternatives you've considered**
Searching through the various commands, I didn't see anything I could reuse.
As stated above, I'm currently just waiting for some generic startup output from the serial.

wavexx, 2021-06-27:
Working as intended!

Closed 2021-06-27.

Thread 317 (2021-06-24):

[BUG] --test flag should hide the UI in more cases

wavexx, 2021-06-24:
**Describe the bug**
I had a few scripting scenarios where I just needed to communicate with the printer by serial, or to debug it. For this reason I didn't want any UI, so I tried to use "--test -s", but it still shows the LCD emulation.

Likewise, a similar scenario is "--test --gdb", where I might be scripting gdb and thus have no need for the UI as well.
Looks like the only scenario where --test hides the UI at the moment is "--test --script".

**To Reproduce**
Start with "--test -s" or "--test --gdb".

**Expected behavior**
No extra windows being shown in these scenarios.
I almost think --test should refuse to operate if not given a compatible option (--script, -s, --gdb, or something that gives the user a way to control the board without the lcd).

vintagepc, 2021-06-24:
The "no graphics" part of that is probably wrong now as I believe in some cases we use --test with graphics for the automated testing components that take screenshots to verify the GL behaviour.

I think what you're looking for that is more suitable to your use case is also using `-g none` as an argument. That should suppress all graphics.

wavexx, 2021-06-24:
Oh, well then, works good enough for me using --test in combination with -g none :)
Maybe it just needs a better description, or yeah removing it completely, so that graphics control is explicitly handled via -g.

wavexx, 2021-06-24:
On the other side, is there an explicit way to request the "2D ui only" via -g? I know it's default, but I think it should be listed as an explicit choice.

vintagepc, 2021-06-24:
Not currently but it should be possible to add one and just have it no-op

Closed 2021-06-27.

Thread 323 (2021-08-13):

[BUG] Crash on SD card handling when rapid-firing 'c'

wavexx, 2021-08-13:
**Describe the bug**
MK404 crashes when holding 'c' (mount/unmount SD card)

**To Reproduce**
- Start MK404 with a MK3/S FW.
- Press and hold 'c' to mount/unmount the SD card quickly (I was trying to reproduce a FW issue.. believe me ;))
- Eventually MK404 itself will crash:

```
#0  0x000055a3b50c6486 in SDCard::OnSPIIn(avr_irq_t*, unsigned int) ()
[Current thread is 1 (Thread 0x7f1cb66fc700 (LWP 171312))]
(gdb) where
#0  0x000055a3b50c6486 in SDCard::OnSPIIn(avr_irq_t*, unsigned int) ()
#1  0x000055a3b50e95f8 in SPIPeripheral::OnPostInit(avr_t*, unsigned int)::{lambda(avr_irq_t*, unsigned int, void*)#1}::_FUN(avr_irq_t*, unsigned int, void*) [clone .lto_priv.0] ()
#2  0x000055a3b5115574 in avr_raise_irq_float ()
#3  0x000055a3b51163e7 in avr_spi_raise ()
#4  0x000055a3b510f9e7 in avr_cycle_timer_process ()
#5  0x000055a3b5104e3c in avr_callback_run_raw ()
#6  0x000055a3b50acbf0 in Boards::Board::RunAVR() ()
```

**Expected behavior**
No crash, I suppose :)

**Screenshots**
☠

**Desktop (please complete the following information):**
 - OS: linux

**Additional context**
Not a critical problem, as you can imagine :)

vintagepc, 2021-08-13:
Good find, this is a nasty one.

Looks like we forgot to guard against the memory-mapped data "going away" in the middle of a block read:

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

wavexx, 2021-08-13:
I had to laugh at the "let's never speak of this again" label :P

Closed 2021-08-21.

Thread 324 (2021-08-16):

[FEATURE] Handle "?" to display keyboard shortcuts while running

wavexx, 2021-08-16:
**Is your feature request related to a problem? Please describe.**
I keep forgetting all the nice keyboard shortcuts, so I have to run with 'MK404 -k' to get the list of supported keys.

**Describe the solution you'd like**
It would be nice to handle '?' as a special key in all boards to display (even just on the console) the list of available shortcuts we can use.

**Describe alternatives you've considered**
I suppose I could go for memento-like tattoos ;)

**Additional context**
N/A

Closed 2021-08-21.

Thread 345 (2021-12-03):

[FEATURE] Commandline option for soft PWM

GilesBathgate, 2021-12-03:
**Is your feature request related to a problem? Please describe.**
When testing 3.10.x firmware on MK2 simulated hardware, I'd like the option to enable software PWM.

**Describe the solution you'd like**
 `./MK404 Prusa_MK2_mR13 --soft-pwm=enable -f ...`

If not specified, and for other printer types, this will default to how its set to currently.

**Describe alternatives you've considered**
Maybe a new printer type specifically for this firmware? `Prusa_MK2_mR13_patched`?

**Additional context**
This fixes the selftest bed check when running 3.10.x firmware on the MK2 sim. I can probably do the PR, if the idea makes sense.

vintagepc, 2021-12-03:
hmm, this is a more "generic" style feature so a command line flag is probably best rather than splitting off more board configurations that are 99% the same.

My approach would probably be to add it as an item in `Config::` with a ternary state - not set, on, off and then check and use that accordingly during `Board::SetupHardware()`.

If you have some time and would like to take a crack at a PR, please feel free! :)

vintagepc, 2021-12-04:
Closed by #346

Closed 2021-12-04.

Thread 347 (2021-12-04):

[FEATURE] Gimbal rotation

GilesBathgate, 2021-12-04:
**Is your feature request related to a problem? Please describe.**
Arcball rotation solves the issue of gimbal lock, but it's not really very "nice" for moving the printer around. Essentially the camera roll isn't locked, so you easily end up with a printer that isn't level to the horizon.

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

**Describe the solution you'd like**
Gimbal based rotation is quite simple, here is my implementation: https://github.com/GilesBathgate/RapCAD/blob/master/src/ui/glview.cpp#L463 (shameless plug)
Yes, you can get into a gimbal lock situation, but it's not common in practice.

**Describe alternatives you've considered**
Make it optional/user preference?

vintagepc, 2021-12-04:
I would support this, there's no real reason we went with Arcball other than that it was convenient and had a nice ready-to-go third party implementation we could just drop in.

Thread 352 (2022-01-15):

[BUG] Won't start on MacOSX?

TheEvilDev, 2022-01-15:
**Describe the bug**
I'm not sure if this is a bug, or more just because I am a noob when it comes to C++, but I followed the brew instructions for MacOSX platform support, and recompiled it from source with cmake and make install. No issues with any of this, but when I run the program, I get the following output. I expect I'm missing some dependencies in the right places.

Here's the log output when I run the `MK404` cli:

```
~/w/e/MK404 ❯❯❯ ./MK404                                                                                                                                                                                      ⏎ master ✱ ◼
***************************************
*                        dev-modified *
* This is a DEV version. Features may *
* behave unexpectedly, or not at all. *
***************************************
No bootloader specified, using default: stk500boot_v2_mega2560.hex
ScriptHost: NOTE: Duplicate context name (Thermistor) with different pointer. Incrementing ID...
ScriptHost: NOTE: Duplicate context name (Thermistor) with different pointer. Incrementing ID...
ScriptHost: NOTE: Duplicate context name (Thermistor) with different pointer. Incrementing ID...
ScriptHost: NOTE: Duplicate context name (Fan) with different pointer. Incrementing ID...
Creating pinspec for atmega2560
ERROR: Could not open flash file. Flash contents will NOT persist.
ERROR: Could not open SPI flash file. Flash contents were NOT restored
ERROR: Could not open flash file. Flash contents were NOT restored
NOTE: No firmware load requested, Executing purely from flash memory: Einsy
read_ihex_chunks: stk500boot_v2_mega2560.hex, unsupported check type 03
Loaded 4202 bytes from HEX file: stk500boot_v2_mega2560.hex
Initialized VCD file Prusa_MK3S_VCD.vcd
uart_pty_init bridge on port *** /dev/ttys006 ***
/tmp/simavr-uart2 now points to: /dev/ttys006
note: export SIMAVR_UART_XTERM=1 and install picocom to get a terminal
uart_pty_init bridge on port *** /dev/ttys007 ***
uart_pty_init bridge on port *** /dev/ttys008 ***
SD file Prusa_MK3S_SDcard.bin does not exist. Will not create it.
SD card image (Prusa_MK3S_SDcard.bin) could not be mounted (error -1 ).
Init on ADC 0 start temp: 25
Init on ADC 2 start temp: 25
Init on ADC 3 start temp: 25
Init on ADC 6 start temp: 25
ScriptHost: NOTE: Duplicate context name (VSrc) with different pointer. Incrementing ID...
MK3S - adding IR sensor.
freeglut (./MK404): failed to open display ''
```

Seems like it's almost there, and my issue might just be the last line, and something isn't quite right with my freeglut setup, but I just don't have much to go on, so am hoping for some guidance.

**Desktop (please complete the following information):**
 - OS: MacOS Catalina
 - Version: 10.15.7

**Additional context**
Add any other context about the problem here - printer model, what firmware file you are running, etc.

vintagepc, 2022-01-15:
This sounds like it cannot find a display server to connect to.

If memory serves, you need to manually start an instance of XQuartz before trying to launch MK404. If it still gives you the same error, you may need to explicitly tell it the display name to use, e.g. if the XQuartz output says something about Display :0 then the syntax is `DISPLAY=:0 ./MK404 ...`

Let me know if that fixes it, if so I'll update the documentation.

TheEvilDev, 2022-01-15:
Actually, thanks for the quick response, turns out all I needed to do was reboot, it's working now, thanks for the great work on this project!

vintagepc, 2022-01-15:
Ah, fantastic! I'll add a note to the wiki.

Closed 2022-01-15.

Thread 356 (2022-03-03):

[BUG] Always disable AVR_UART_FLAG_POLL_SLEEP

vintagepc, 2022-03-03:
Someone tried to be clever and detect AVR code spinlooping on UART reads.

This is the cause of the bootloader being stupidly slow.

Just disable the `AVR_UART_FLAG_POLL_SLEEP` flag on all UARTs for sim printers.

Closed 2022-03-04.

Thread 364 (2022-06-17):

[FEATURE] Fuzz interrupt timings

vintagepc, 2022-06-17:
For attempting to reproduce strange/rare bugs... see if there's a way to fuzz timing of interrupts by a cycle or two.

Should be reproducible with a seed value for the RNG
