vintagepc/MK404/parts/components/IRSensor.cpp

/*
	IRSensor.cpp

	Copyright 2020 VintagePC <https://github.com/vintagepc/>

 	This file is part of MK404.

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
	You should have received a copy of the GNU General Public License
	along with MK404.  If not, see <http://www.gnu.org/licenses/>.
 */

#include "IRSensor.h"
#include "IKeyClient.h"
#include "Scriptable.h"
#include <iostream>  // for printf

// ADC read trigger.
uint32_t IRSensor::OnADCRead(struct avr_irq_t *, uint32_t)
{
	m_bADCRunning = true;
	return GetCurrentValue();
}

uint32_t IRSensor::GetCurrentValue()
{
	float fVal;
    if (m_eCurrent != IR_AUTO)
	{
        fVal = m_mIRVals[m_eCurrent];
	}
    else if (m_bExternal)
	{
        fVal = m_mIRVals[IR_v4_FILAMENT_PRESENT];
	}
    else
	{
        fVal = m_mIRVals[IR_v4_NO_FILAMENT];
	}

	uint32_t iVOut =  (fVal)*1000;

	return iVOut;
}

IRSensor::IRSensor():VoltageSrc(),IKeyClient()
{
	SetName("IRSensor");
	RegisterActionAndMenu("Toggle","Toggles the IR sensor state",ActToggle);
	RegisterAction("Set","Sets the sensor state to a specific enum entry. (int value)",ActSet,{ArgType::Int});
	RegisterAction("SetExtVal","Sets external imput value",ActSetExtVal, {ArgType::Bool});
	RegisterMenu("v0.4 Set Filament", ActSetV4Filament);
	RegisterMenu("v0.4 No Filament", ActSetV4NoFilament);
	RegisterMenu("v0.3 Set Filament", ActSetV3Filament);
	RegisterMenu("v0.3 No Filament", ActSetV3NoFilament);
	RegisterMenu("Set Unknown", ActSetUnknown);
	RegisterActionAndMenu("SetAuto", "Resumes auto (MMU) operation", ActSetAuto);

	RegisterKeyHandler('f',"Toggles IR sensor Filament presence");
	RegisterKeyHandler('A',""); // Full auto resume for FINDA/MMU
}

void IRSensor::OnKeyPress(const Key& key)
{
	switch (key)
	{
		case 'f':
			Toggle();
			break;
		case 'A':
		 	Set(IRSensor::IR_AUTO);
			 break;
	}
}

Scriptable::LineStatus IRSensor::ProcessAction(unsigned int iAct, const std::vector<std::string> &vArgs)
{
	using std::to_string;
	switch (iAct)
	{
		case ActToggle:
			Toggle();
			return LineStatus::Finished;
		case ActSet:
		{
			int iVal = stoi(vArgs.at(0));
			if (iVal<=IR_MIN || iVal >= IR_MAX)
			{
				return IssueLineError(std::string("Set value ") + to_string(iVal) + " is out of the range [" + to_string(IR_MIN+1) + "," + to_string(IR_MAX-1) + "]" );
			}
			Set(static_cast<IRState>(iVal));
			return LineStatus::Finished;
		}
		case ActSetExtVal:
		{
			Auto_Input(stoul(vArgs.at(0)));
			return LineStatus::Finished;
		}
		case ActSetV3Filament:
		case ActSetV4Filament:
		case ActSetV3NoFilament:
		case ActSetV4NoFilament:
		case ActSetUnknown:
		case ActSetAuto:
			Set(static_cast<IRState>(iAct-3));
			return LineStatus::Finished;
	}
	return LineStatus::Unhandled;
}

// Default behaviour is V4
void IRSensor::Toggle()
{
	if (m_eCurrent == IR_AUTO)
	{
		std::cout << "NOTE: Overriding IR Auto setting!" << '\n';
	}
	IRSensor::IRState eNew = IR_UNKNOWN;
	if (m_eCurrent == IR_v4_NO_FILAMENT ||
		m_eCurrent == IR_v3_NO_FILAMENT)
	{
		std::cout << "IRSensor: Filament present!" << '\n';
		eNew = (m_eCurrent == IR_v4_NO_FILAMENT ? IR_v4_FILAMENT_PRESENT : IR_v3_FILAMENT_PRESENT);
	}
	else
	{
		std::cout << "IRSensor: No filament present!" << '\n';
		eNew = (m_eCurrent == IR_v3_FILAMENT_PRESENT ? IR_v3_NO_FILAMENT : IR_v4_NO_FILAMENT);
	}
	Set(eNew);
}

void IRSensor::Set(IRState val)
{
	m_eCurrent = val;
	if (!m_bADCRunning && IsConnected())
	{
		_SyncDigitalIRQ<VoltageSrc>(GetCurrentValue());
	}
}

void IRSensor::Auto_Input(uint32_t val)
{
	if (IsConnected() && m_bExternal != (val>0))
	{
		m_bExternal = val>0;
		_SyncDigitalIRQ<VoltageSrc>(GetCurrentValue());
	}
}
