vintagepc/MK404/parts/KeyController.cpp

/*
	KeyController.cpp - Wrangler for dispatching keypresses to KeyClients.

	Copyright 2020 VintagePC <https://github.com/vintagepc/>

 	This file is part of MK404.

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
	You should have received a copy of the GNU General Public License
	along with MK404.  If not, see <http://www.gnu.org/licenses/>.
 */

#include "KeyController.h"
#include "IKeyClient.h"
#include "IScriptable.h"
#include <GL/glut.h>
#include <iostream>
#include <memory>         // for allocator_traits<>::value_type
#include <string>
#include <vector>

KeyController& KeyController::GetController()
{
	static KeyController k {};
	return k;
}


KeyController::KeyController():Scriptable("KeyCtl")
{
	RegisterAction("Key","Simulates a keypress",0, {ArgType::String});
}

IScriptable::LineStatus KeyController::ProcessAction(unsigned int /*iAction*/, const std::vector<std::string> &vArgs)
{
	Key key = vArgs.at(0).at(0);
	if (vArgs.at(0)=="enter")
	{
		key = 0xd;
	}
	else if (vArgs.at(0) == "up")
	{
		key = GLUT_KEY_UP | SPECIAL_KEY_MASK;
	}
	else if (vArgs.at(0) == "down")
	{
		key = GLUT_KEY_DOWN | SPECIAL_KEY_MASK;
	}
	OnKeyPressed(key);
	return LineStatus::Finished;
}

void KeyController::AddKeyClient(IKeyClient *pClient, const unsigned char key, const std::string &strDesc)
{
	m_mClients[key].push_back(pClient);
	if (!strDesc.empty())
	{
		m_mDescrs[key].append(strDesc + " ");
	}
}

void KeyController::PrintKeys(bool bMarkdown)
{
	std::cout << "Available Key Controls:\n";
	for (auto it : m_mDescrs)
	{
		std::cout << (bMarkdown?"- `":"\t");
		PutNiceKeyName(it.first);
		std::cout << (bMarkdown?"` - ":":\t") << it.second << '\n';
	}

}

void KeyController::PutNiceKeyName(unsigned char key)
{
	switch(key)
	{
		case 0xd:
			std::cout << "Enter";
			break;
		case GLUT_KEY_UP | SPECIAL_KEY_MASK:
			std::cout << "Up Arrow";
			break;
		case GLUT_KEY_DOWN | SPECIAL_KEY_MASK:
			std::cout << "Down Arrow";
			break;
		default:
			std::cout << key;
			break;
	}
}

void KeyController::OnAVRCycle()
{
	auto key = m_key.load();

	if (key==0)
	{
		return;
	}

	m_key.store(0);

	if (key == '?') {
		PrintKeys(false);
		return;
	}

	if (m_mClients.count(key)>0)
	{
		std::vector<IKeyClient*>& vClients = m_mClients.at(key);
		for (auto c: vClients)
		{
			c->OnKeyPress(key);
		}
	}
}
