vintagepc/MK404/parts/printers/Prusa_MK2_13.cpp

/*
	Prusa_MK2_13.cpp - Printer definition for the Prusa MK2 (mR1.3)
	Copyright 2020 VintagePC <https://github.com/vintagepc/>

 	This file is part of MK404.

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
	You should have received a copy of the GNU General Public License
	along with MK404.  If not, see <http://www.gnu.org/licenses/>.
 */

#include "Prusa_MK2_13.h"
#include "A4982.h"            // for A4982, A4982::IRQ::POSITION_OUT, PINDA:...
#include "Beeper.h"           // for Beeper
#include "Fan.h"              // for Fan
#include "GLHelper.h"
#include "HD44780GL.h"        // for HD44780GL
#include "Heater.h"           // for Heater
#include "LED.h"              // for LED
#include "MMU1.h"             // for MMU1
#include "PINDA.h"            // for PINDA
#include "PinNames.h"         // for Pin::Z_MIN_PIN
#include "RotaryEncoder.h"    // for RotaryEncoder, RotaryEncoder::::CCW_CLICK
#include "SDCard.h"           // for SDCard
#include "sim_io.h"           // for avr_register_io_write
#include "uart_pty.h"         // for uart_pty
#include <GL/glew.h>          // NOLINT for glTranslatef, glLoadIdentity, glPopMatrix
#include <GL/freeglut_std.h>  // for GLUT_DOWN, GLUT_LEFT_BUTTON, GLUT_RIGHT...
#include <iostream>           // for operator<<, cout, ostream, basic_ostream

Prusa_MK2_13::Prusa_MK2_13():MiniRambo(),Printer()
{
}

void Prusa_MK2_13::OnVisualTypeSet(const std::string &type)
{
	if (type=="lite")
	{
		m_pVis.reset(new MK3SGL(type,GetHasMMU(),this)); //NOLINT - suggestion is c++14.
	}
	else if (type=="fancy")
	{
		m_pVis.reset(new MK3SGL(  //NOLINT - suggestion is c++14.
			GetHasSheet()?"mk25":"mk2",
			GetHasMMU(),this)
		);

		// This printer is positioned differently from the MK3, hence this correction for the MMU2 hybrid.
		if (GetHasMMU() == MMUType::MMUv2)
		{
			m_pVis->AdjustMMUPos(0.034f, -0.023f, -0.235f);
		}
	}
	else
	{
		return;
	}


	AddHardware(*m_pVis);

	m_pVis->ConnectFrom(X.GetIRQ(A4982::POSITION_OUT),MK3SGL::X_IN);
	m_pVis->ConnectFrom(Y.GetIRQ(A4982::POSITION_OUT),MK3SGL::Y_IN);
	m_pVis->ConnectFrom(Z.GetIRQ(A4982::POSITION_OUT),MK3SGL::Z_IN);
	m_pVis->ConnectFrom(E.GetIRQ(A4982::POSITION_OUT),MK3SGL::E_IN);
	m_pVis->ConnectFrom(X.GetIRQ(A4982::STEP_POS_OUT),MK3SGL::X_STEP_IN);
	m_pVis->ConnectFrom(Y.GetIRQ(A4982::STEP_POS_OUT),MK3SGL::Y_STEP_IN);
	m_pVis->ConnectFrom(Z.GetIRQ(A4982::STEP_POS_OUT),MK3SGL::Z_STEP_IN);
	m_pVis->ConnectFrom(E.GetIRQ(A4982::STEP_POS_OUT),MK3SGL::E_STEP_IN);
	m_pVis->ConnectFrom(pinda.GetIRQ(PINDA::SHEET_OUT), MK3SGL::SHEET_IN);
	m_pVis->ConnectFrom(fExtruder.GetIRQ(Fan::ROTATION_OUT), MK3SGL::EFAN_IN);
	m_pVis->ConnectFrom(fPrint.GetIRQ(Fan::ROTATION_OUT), MK3SGL::PFAN_IN);
	m_pVis->ConnectFrom(hBed.GetIRQ(Heater::ON_OUT), MK3SGL::BED_IN);
	m_pVis->ConnectFrom(sd_card.GetIRQ(SDCard::CARD_PRESENT), MK3SGL::SD_IN);
	m_pVis->ConnectFrom(pinda.GetIRQ(PINDA::TRIGGER_OUT), MK3SGL::PINDA_IN);
	if (GetHasMMU() == MMUType::MMUv1)
	{
		m_pVis->ConnectFrom(m_mmu.GetIRQ(MMU1::TOOL_OUT),MK3SGL::TOOL_IN);
		m_pVis->ConnectFrom(E1.GetIRQ(A4982::STEP_POS_OUT),MK3SGL::E_STEP_IN);
		m_pVis->ConnectFrom(E2.GetIRQ(A4982::STEP_POS_OUT),MK3SGL::E_STEP_IN);
		m_pVis->ConnectFrom(E3.GetIRQ(A4982::STEP_POS_OUT),MK3SGL::E_STEP_IN);
	}
	else
	{
		// N.B. MMU2 is handled separately in a derived class.
	}
	m_pVis->SetLCD(&lcd);

	m_pVis->SetStepsPerMM(
		X.GetConfig().uiStepsPerMM,
		Y.GetConfig().uiStepsPerMM,
		Z.GetConfig().uiStepsPerMM,
		E.GetConfig().uiStepsPerMM
	);

	E.SetSimple(true);
}

void Prusa_MK2_13::Draw()
{
		glPushMatrix();
		glLoadIdentity(); // Start with an identity matrix
			glScalef(4, 4, 1);
			lcd.Draw();
		glPopMatrix();
		// Do something for the motors...
		float fX = (5 + lcd.GetWidth()* 6)*4;
		float fY = (5 + lcd.GetHeight() * 9);
		glLoadIdentity();
		glScalef(fX/350,4,1);
		glPushMatrix();
			glTranslatef(0, fY,0);
			X.Draw();
			glTranslatef(0,10,0);
			Y.Draw();
			glTranslatef(0,10,0);
			Z.Draw();
			glTranslatef(0,10,0);
			glPushMatrix();
				E.Draw();
				glTranslatef(150.f,0,0);
				E1.Draw();
			glPopMatrix();
			glTranslatef(0,10,0);
			glPushMatrix();
				E2.Draw();
				glTranslatef(150.f,0,0);
				E3.Draw();
			glPopMatrix();
			glTranslatef(0,10,0);
			glTranslatef(170,0,0);
			m_mmu.Draw();
			glTranslatef(20,0,0);
			m_buzzer.Draw();
			glTranslatef(20,0,0);
			fPrint.Draw();
			glTranslatef(20,0,0);
			fExtruder.Draw();
			glTranslatef(20,0,0);
			hExtruder.Draw();
			glTranslatef(20,0,0);
			hBed.Draw();
			glTranslatef(20,0,0);
			lSD.Draw();
			glTranslatef(20,0,0);
			lPINDA.Draw();
			glTranslatef(20,0,0);
			lIR.Draw();
		glPopMatrix();
		// GL snapshot helper
		m_gl.OnDraw();
		if ((GetVisualType()!="none") && m_pVis)
		{
			m_pVis->FlagForRedraw();
		}
}

std::pair<int,int> Prusa_MK2_13::GetWindowSize(){
	std::pair<int,int> prSize = { 5 + lcd.GetWidth() * 6, 60 + 5 + lcd.GetHeight() * 9};
	return prSize;
}

void Prusa_MK2_13:: SetupPINDA()
{
	AddHardware(pinda, X.GetIRQ(A4982::POSITION_OUT),  Y.GetIRQ(A4982::POSITION_OUT),  Z.GetIRQ(A4982::POSITION_OUT));
	TryConnect(&pinda, PINDA::TRIGGER_OUT ,Z_MIN_PIN);
	AddHardware(lPINDA);
	lPINDA.ConnectFrom(pinda.GetIRQ(PINDA::TRIGGER_OUT), LED::LED_IN);
}

void Prusa_MK2_13::SetupHardware()
{
	MiniRambo::SetupHardware();

	SetupPINDA();

	switch (Config::Get().GetSoftPWM())
	{
		case EnabledType::Type_t::Enabled:
			hBed.SetSoftPWM(true);
			break;
		case EnabledType::Type_t::Disabled:
			hBed.SetSoftPWM(false);
			break;
		default:
			break;
	}
	if (GetConnectSerial())
	{
		UART0.Connect('0');
	}
}

void Prusa_MK2_13::OnAVRCycle()
{
	int mouseBtn = m_mouseBtn;                  // copy atomic to local
	if (mouseBtn)
	{
		switch (mouseBtn){
			case 1:
				encoder.MousePush();
				break;
			case 2:
				encoder.Release();
				break;
			case 3:
				encoder.Twist(RotaryEncoder::CCW_CLICK);
				if (m_pVis) m_pVis->TwistKnob(true);
				break;
			case 4:
				encoder.Twist(RotaryEncoder::CW_CLICK);
				if (m_pVis) m_pVis->TwistKnob(false);
				break;
		}
		m_mouseBtn = 0;
	}
}


// pragma: LCOV_EXCL_START
void Prusa_MK2_13::OnMouseMove(int /*x*/,int /*y*/)
{
}
// pragma: LCOV_EXCL_STOP

void Prusa_MK2_13::OnMousePress(int button, int action, int /*x*/, int /*y*/)
{
	if (button == GLUT_LEFT_BUTTON || button == GLUT_RIGHT_BUTTON) {
		if (action == GLUT_DOWN) {
			m_mouseBtn = 1;
		} else if (action == GLUT_UP) {
			m_mouseBtn = 2;
		}
	}
	if ((button==3 || button==4) && action == GLUT_DOWN) // wheel
	{
		m_mouseBtn = button;
	}
}
