vintagepc/MK404/parts/components/hd44780_charROM.h

/*
	HD44780_charROM.h - A00 character ROM data for the HD44780 LCD.

  Copyright 2020, VintagePC <https://github.com/vintagepc/>

 	This file is part of MK404.

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
	You should have received a copy of the GNU General Public License
	along with MK404.  If not, see <http://www.gnu.org/licenses/>.
 */

#pragma once

#include "gsl-lite.hpp"

static const struct {
  unsigned int w {5};
  unsigned int h {7};
  uint8_t _data[1792]
  {
    0x00,
    0x00,
    0x00,
    0x00,
    0x00,
    0x00,
    0x00,
    0x00,
    0x00,
    0x00,
    0x00,
    0x00,
    0x00,
    0x00,
    0x00,
    0x00,
    0x00,
    0x00,
    0x00,
    0x00,
    0x00,
    0x00,
    0x00,
    0x00,
    0x00,
    0x00,
    0x00,
    0x00,
    0x00,
    0x00,
    0x00,
    0x00,
    0x00,
    0x00,
    0x00,
    0x00,
    0x00,
    0x00,
    0x00,
    0x00,
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
	gsl::span<uint8_t> data {_data};
  } hd44780_ROM_AOO;
