vintagepc/MK404/parts/boards/EinsyRambo.cpp

/*
	EinsyRambo.cpp - Board definition for the Prusa EinsyRambo
	Copyright 2020 VintagePC <https://github.com/vintagepc/>

 	This file is part of MK404

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
	You should have received a copy of the GNU General Public License
	along with MK404. If not, see <http://www.gnu.org/licenses/>.
 */

#include "3rdParty/MK3/thermistortables.h"  // for OVERSAMPLENR, temptable_1, temptable_2000
#include "EinsyRambo.h"
#include "Einsy_1_1a.h"        // for Einsy_1_1a
#include "HD44780.h"           // for HD44780
#include "PinNames.h"          // for Pin, Pin::BTN_ENC, Pin::W25X20CL_PIN_CS
#include <algorithm>                        // for copy
#include <iostream>             // for fprintf, printf, stderr
#include <string>
#include <vector>

#define TEMP_SENSOR_0 5
#define TEMP_SENSOR_BED 1
#define TEMP_SENSOR_AMBIENT 2000

#define _TERMISTOR_TABLE(num) \
		temptable_##num
#define TERMISTOR_TABLE(num) \
		_TERMISTOR_TABLE(num)


namespace Boards
{
	EinsyRambo::EinsyRambo(uint32_t uiFreq):IKeyClient(),Board(m_wiring,uiFreq)
	{
		SetBoardName("Einsy");
		RegisterKeyHandler('t', "Triggers a factory reset (reset + hold encoder");
	};

	void EinsyRambo::SetupHardware()
	{
		DisableInterruptLevelPoll(8);

		AddSerialPty(&UART2,'2');
		AddHardware(UART0, '0');
		AddHardware(UART1, '1');

		AddHardware(m_Mon0,'0');
		AddHardware(m_Mon1,'1');

		// SD card
		std::string strSD = GetSDCardFile();
		sd_card.SetImage(strSD);
		AddHardware(sd_card);
		TryConnect(PinNames::Pin::SDSS, &sd_card, SDCard::SPI_CSEL);

		// wire up the SD present signal.
		TryConnect(&sd_card, SDCard::CARD_PRESENT, SDCARDDETECT);

		// Add indicator first so it captures the mount IRQ
		AddHardware(lSD);
		TryConnect(SDCARDDETECT, &lSD, LED::LED_IN);

		int mount_error = sd_card.Mount();

		if (mount_error != 0) {
			std::cerr << "SD card image (" << strSD << ") could not be mounted (error " << mount_error << " ).\n";
		}

		// Heaters
		AddHardware(tExtruder,GetPinNumber(TEMP_0_PIN));
		//NOLINTNEXTLINE - so we can keep using thermistortables.h as-is.
		tExtruder.SetTable({(int16_t*)TERMISTOR_TABLE(TEMP_SENSOR_0),
								sizeof(TERMISTOR_TABLE(TEMP_SENSOR_0)) / sizeof(int16_t)},
								OVERSAMPLENR);

		AddHardware(tBed,GetPinNumber(TEMP_BED_PIN));
		//NOLINTNEXTLINE - so we can keep using thermistortables.h as-is.
		tBed.SetTable({(int16_t*)TERMISTOR_TABLE(TEMP_SENSOR_BED),
							sizeof(TERMISTOR_TABLE(TEMP_SENSOR_BED)) / sizeof(int16_t)},
							OVERSAMPLENR);

		// same table as bed.
		AddHardware(tPinda, GetPinNumber(TEMP_PINDA_PIN));
		//NOLINTNEXTLINE - so we can keep using thermistortables.h as-is.
		tPinda.SetTable({(int16_t*)TERMISTOR_TABLE(TEMP_SENSOR_BED),
							sizeof(TERMISTOR_TABLE(TEMP_SENSOR_BED)) / sizeof(int16_t)},
							OVERSAMPLENR);

		AddHardware(tAmbient,  GetPinNumber(TEMP_AMBIENT_PIN));
		//NOLINTNEXTLINE - so we can keep using thermistortables.h as-is.
		tAmbient.SetTable({(int16_t*)TERMISTOR_TABLE(TEMP_SENSOR_AMBIENT),
		 						sizeof(TERMISTOR_TABLE(TEMP_SENSOR_AMBIENT)) / sizeof(int16_t)},
		 						OVERSAMPLENR);

		AddHardware(fExtruder, GetDIRQ(TACH_0), GetDIRQ(E0_FAN), GetPWMIRQ(E0_FAN));
		AddHardware(fPrint, GetDIRQ(TACH_1), GetDIRQ(FAN_PIN), GetPWMIRQ(FAN_PIN));

		AddHardware(hBed, nullptr, GetDIRQ(HEATER_BED_PIN));
		hBed.ConnectTo(Heater::TEMP_OUT, tBed.GetIRQ(Thermistor::TEMP_IN));

		if ( m_bNoHacks )
		{
			hBed.SetSoftPWM(false);
		}

		AddHardware(hExtruder, nullptr, GetDIRQ(HEATER_0_PIN));
		hExtruder.ConnectTo(Heater::TEMP_OUT, tExtruder.GetIRQ(Thermistor::TEMP_IN));

		AddHardware(m_buzzer);
		m_buzzer.ConnectFrom(GetDIRQ(BEEPER),Beeper::DIGITAL_IN);

		AddHardware(lcd);
		// D4-D7,
		std::vector<PinNames::Pin> vePins = {LCD_PINS_D4,LCD_PINS_D5,LCD_PINS_D6,LCD_PINS_D7};
		for (int i = 0; i < 4; i++) {
			TryConnect(vePins.at(i),&lcd, HD44780::D4+i);
			TryConnect(&lcd, HD44780::D4+i,vePins.at(i));
		}
		TryConnect(LCD_PINS_RS,&lcd, HD44780::RS);
		TryConnect(LCD_PINS_ENABLE, &lcd,HD44780::E);
		TryConnect(LCD_BL_PIN, &lcd, HD44780::BRIGHTNESS_IN);
		lcd.ConnectFrom(GetPWMIRQ(LCD_BL_PIN), HD44780::BRIGHTNESS_PWM_IN);

		AddHardware(encoder);
		TryConnect(&encoder, RotaryEncoder::OUT_A, BTN_EN2);
		TryConnect(&encoder, RotaryEncoder::OUT_B, BTN_EN1);
		TryConnect(&encoder, RotaryEncoder::OUT_BUTTON, BTN_ENC);

		TMC2130::TMC2130_cfg_t cfg;
		cfg.iMaxMM = 255;

		X.SetConfig(cfg);
		AddHardware(X);
		TryConnect(X_TMC2130_CS, &X, TMC2130::SPI_CSEL);
		TryConnect(X_DIR_PIN,	&X, TMC2130::DIR_IN);
		TryConnect(X_STEP_PIN,	&X, TMC2130::STEP_IN);
		TryConnect(X_ENABLE_PIN,	&X, TMC2130::ENABLE_IN);
		TryConnect(&X,TMC2130::DIAG_OUT, X_TMC2130_DIAG);

		cfg.uiFullStepsPerMM = 400*16;
		cfg.iMaxMM = 219;

		Z.SetConfig(cfg);
		AddHardware(Z);
		TryConnect(Z_TMC2130_CS , 	&Z, TMC2130::SPI_CSEL);
		TryConnect(Z_DIR_PIN ,		&Z, TMC2130::DIR_IN);
		TryConnect(Z_STEP_PIN ,		&Z, TMC2130::STEP_IN);
		TryConnect(Z_ENABLE_PIN ,	&Z, TMC2130::ENABLE_IN);
		TryConnect(&Z, TMC2130::DIAG_OUT, Z_TMC2130_DIAG);

		cfg.bInverted = true;
		cfg.uiFullStepsPerMM = 100*16;
		cfg.iMaxMM = 220;

		Y.SetConfig(cfg);
		AddHardware(Y);
		TryConnect(Y_TMC2130_CS, 	&Y,TMC2130::SPI_CSEL);
		TryConnect(Y_DIR_PIN,		&Y,TMC2130::DIR_IN);
		TryConnect(Y_STEP_PIN,		&Y,TMC2130::STEP_IN);
		TryConnect(Y_ENABLE_PIN,	&Y,TMC2130::ENABLE_IN);
		TryConnect(&Y,TMC2130::DIAG_OUT,Y_TMC2130_DIAG);

		cfg.bHasNoEndStops = true;
		cfg.fStartPos = 0;
		cfg.uiFullStepsPerMM = 280*8;

		E.SetConfig(cfg);
		E.SetSimple(true);
		AddHardware(E);
		TryConnect(E0_TMC2130_CS, 	&E, TMC2130::SPI_CSEL);
		TryConnect(E0_DIR_PIN,		&E, TMC2130::DIR_IN);
		TryConnect(E0_STEP_PIN,		&E, TMC2130::STEP_IN);
		TryConnect(E0_ENABLE_PIN,	&E, TMC2130::ENABLE_IN);
		TryConnect(&E, TMC2130::DIAG_OUT, E0_TMC2130_DIAG);

		AddHardware(pinda, X.GetIRQ(TMC2130::POSITION_OUT),  Y.GetIRQ(TMC2130::POSITION_OUT),  Z.GetIRQ(TMC2130::POSITION_OUT));
		TryConnect(&pinda, PINDA::TRIGGER_OUT ,Z_MIN_PIN);
		AddHardware(lPINDA);
		lPINDA.ConnectFrom(pinda.GetIRQ(PINDA::TRIGGER_OUT), LED::LED_IN);
		AddHardware(lIR);

		AddHardware(vBed, GetPinNumber(VOLT_BED_PIN));
		AddHardware(vMain, GetPinNumber(VOLT_PWR_PIN));

		AddHardware(PowerPanic);
		TryConnect(&PowerPanic, Button::BUTTON_OUT, UVLO_PIN);

		if (m_wiring.IsPin(W25X20CL_PIN_CS))
		{
			AddHardware(spiFlash,GetDIRQ(W25X20CL_PIN_CS));
		}

		AddUARTTrace('0'); // External
		AddUARTTrace('1'); // RPi port
		AddUARTTrace('2'); // MMU/internal/P3

		//avr_irq_register_notify(GetDIRQ(PAT_INT_PIN), MAKE_C_CALLBACK(EinsyRambo, DebugPin),this);

	}

	// Convenience function for debug printing a particular pin. pragma: LCOV_EXCL_START
	void EinsyRambo::DebugPin(avr_irq_t *, uint32_t value)
	{
		std::cout << "Pin DBG: change to " << value << '\n';
	}
	// pragma: LCOV_EXCL_STOP

	void EinsyRambo::OnKeyPress(const Key& key)
	{
		switch(key)
		{
			case 't':
				std::cout << "FACTORY_RESET\n";
				m_bFactoryReset =true;
				// Hold the button during boot to get factory reset menu
				SetResetFlag();
				break;
			default:
				Board::OnKeyPress(key); // Pass up because we overrode.
		}
	}

	void EinsyRambo::OnAVRInit()
	{
		std::string strSPI = GetStorageFileName("xflash");
		spiFlash.Load(strSPI.c_str());
	}

	void EinsyRambo::OnAVRDeinit()
	{
		spiFlash.Save();
		sd_card.Unmount();
	}

	void EinsyRambo::OnExtraHexChunk(gsl::span<uint8_t> chunk, uint32_t uiBase)
	{
		spiFlash.Load(chunk, uiBase);
	}

	void EinsyRambo::OnAVRReset()
	{
		std::cout << "RESET\n";
		DisableInterruptLevelPoll(8);

		// Restore powerpanic to high
		PowerPanic.Press(1);

		UART0.Reset();

		//depress encoder knob
		if (!m_bFactoryReset)
		{
			encoder.Push();
		}
		else
		{
			encoder.MousePush();
		}

		m_bFactoryReset = false;

		// TIMSK2 hack for stock prusa firmware.
		if (!GetDisableWorkarounds())
		{
			// Sweet, this is no longer necessary, it seems!
			//avr_regbit_t rb = AVR_IO_REGBITS(0x70, 0, 0b111);
			//	avr_regbit_setto(m_pAVR,rb,0x01);
		}

		//Reset all SPI SS lines
		SetPin(W25X20CL_PIN_CS,1);
		SetPin(SDSS,1);
		SetPin(X_TMC2130_CS,1);
		SetPin(Y_TMC2130_CS,1);
		SetPin(Z_TMC2130_CS,1);
		SetPin(E0_TMC2130_CS,1);

		hExtruder.Reset();
	}

}; // namespace Boards
