vintagepc/MK404/parts/I2CPeripheral.cpp

/*
	I2CPeripheral.cpp - Generalization helper for I2C-based peripherals.
    This header auto-wires the bus and deals with some of the copypasta.
    Currently only supports bit-banged mode as I haven't needed to deal
	with "real" i2c hardware yet.

	Copyright 2020 VintagePC <https://github.com/vintagepc/>

 	This file is part of MK404.

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
	You should have received a copy of the GNU General Public License
	along with MK404.  If not, see <http://www.gnu.org/licenses/>.
 */


#include "I2CPeripheral.h"
#include "avr_twi.h"  // for avr_twi_irq_msg, ::TWI_COND_ACK, ::TWI_COND_READ
#include "sim_avr.h"  // for avr_t
#include "sim_io.h"   // for avr_io_getirq
#include "sim_irq.h"  // for avr_raise_irq, avr_irq_register_notify, avr_irq_t
#include <cstdint>            // for uint8_t, uint32_t, int32_t, uint16_t
#include <iostream>   // for operator<<, cout, ostream

I2CPeripheral::I2CPeripheral(uint8_t uiAddress):m_uiDevAddr(uiAddress)
{

}

void I2CPeripheral::OnPostInit(avr_t *avr, avr_irq_t *irqSDA, avr_irq_t *irqSCL) {
	std::cout << "Note: Hardwae I2C in use. If you see quirks it may be fallout from hacks related to #248\n";
	avr_irq_register_notify(avr_io_getirq(avr, AVR_IOCTL_TWI_GETIRQ(0),TWI_IRQ_OUTPUT), MAKE_C_CALLBACK(I2CPeripheral,_OnI2CTx),this); //NOLINT - complaint in external macro
	m_pI2CReply = avr_io_getirq(avr,AVR_IOCTL_TWI_GETIRQ(0), TWI_IRQ_INPUT); //NOLINT - complaint in external macro
	if (irqSCL && irqSDA)
	{
		m_pSCL = irqSCL;
		m_pSDA = irqSDA;
		avr_irq_register_notify(irqSCL, MAKE_C_CALLBACK(I2CPeripheral,_OnSCL),this);
		avr_irq_register_notify(irqSDA, MAKE_C_CALLBACK(I2CPeripheral,_OnSDA),this);
	}
}


bool I2CPeripheral::ProcessByte(const uint8_t &value)
{
	bool bReturn = false;
	switch (m_state)
	{
		case State::AddrIn:
		{
			msgIn.bytes[2] = value;
			if (msgIn.address != m_uiDevAddr)
			{
				m_SCLState = SCLS::Idle;
				m_state = State::Idle;
				break;
			}
			bReturn = true;
			if (msgIn.isAddrRead)
			{
				m_SCLState = SCLS::WaitForWrite; // Wait for next clock
			}
			else
			{
				m_state = State::RegIn;
			}
		}
		break;
		case State::RegIn:
		{
			msgIn.bytes[1] = value;
			m_state = State::DataIn;
			bReturn = true;
			// NOTE - this doesn't handle OOB regs.
		}
		break;
		case State::DataIn:
		{
			msgIn.bytes[0] = value;
			bReturn = SetRegVal(msgIn.writeRegAddr++,msgIn.data);
		}
		break;
		default:
		break;
	}
	//printf("I2C msg status: Addr: %02x Read: %u raw: %04x\n", msgIn.address, msgIn.isAddrRead, msgIn.raw);
	return bReturn;
}

void I2CPeripheral::_OnSCL(avr_irq_t *irq, uint32_t value)
{
	//if (value) printf("SCL: %u (%u)\n", value,m_uiBitCt);
	bool bClockRise = !(irq->value) && value;
	bool bClockFall = (irq->value) && !value;
	if  (m_SCLState ==SCLS::Idle || (bClockRise==bClockFall))
	{
		return;
	}
	switch (m_SCLState)
	{
		default:
			break;
		case SCLS::Reading:
			if (bClockRise)
			{
				if (m_uiBitCt == 8) // Byte done, do we ACK or NACK?
				{
					if (ProcessByte(m_uiByte))
					{
						//printf("ACK\n");
						avr_raise_irq(m_pSDA,0);
					}
					// else
					// 	printf("NACK\n");
					m_uiByte = m_uiBitCt = 0;
				}
				else
				{
					m_uiByte <<= 1; // Shift up.
					m_uiByte |= (m_pSDA->value & 1u);
					m_uiBitCt++;
				}
			}
			break;
		case SCLS::WaitForWrite:
			if (bClockFall)
			{
				m_SCLState = SCLS::Writing;
			}
			break;
		case SCLS::Writing:
			{
				if (bClockRise)
				{
					if (m_uiBitCt == 0)
					{
						m_uiBitCt = 8;
						m_uiByte = GetRegVal(msgIn.writeRegAddr);
						//printf("Sending %02x\n",m_uiByte);
					}
					avr_raise_irq(m_pSDA, static_cast<unsigned>(m_uiByte)>>(--m_uiBitCt) &1u);
				}
				else
				{
					if (m_uiBitCt == 0)
					{
						m_SCLState = SCLS::WaitForACK;
					}
				}
			}
			break;
		case SCLS::WaitForACK:
			{
				if (bClockRise)
				{
					//printf("%cACK rec'd\n",m_pSDA->value? ' ':'N');
				}
				else
				{
					m_SCLState = SCLS::Writing; // Back to writing.
				}
			}
			break;
	}
}

void I2CPeripheral::_OnSDA(avr_irq_t */*irq*/, uint32_t value)
{
	if (m_pSCL->value)
	{
		if (value)
		{
			m_SCLState = SCLS::Idle;
		}
		else
		{
			m_SCLState = SCLS::Reading;
			m_state = State::AddrIn;
			m_uiBitCt = 0;
			m_uiByte = 0;
		}
		//printf("I2C TX %s\n",value?"Stop" : "Start");
	}
}

void I2CPeripheral::_OnI2CTx(avr_irq_t */*irq*/, uint32_t value)
{
//	std::cout << "TX_IN:" << std::setw(8) << std::setfill('0') << std::hex << value << '\n';
	NativeI2CMsg_t msg{value};

	if (msg.cond & TWI_COND_STOP)
	{
//		std::cout << "STOP\n";
		m_state = State::Idle;
		msgIn.address = 0;
	}
	else if (msg.cond & TWI_COND_START)
	{
		//std::cout << "START\n";
		if (msg.address == m_uiDevAddr)
		{
			m_state = State::AddrIn;
			avr_raise_irq(m_pI2CReply, avr_twi_irq_msg(TWI_COND_ACK, msg.address, 1));
		}
	}

	if (m_state == State::Idle)
	{
		return;
	}

	if (msg.cond & TWI_COND_WRITE)
	{
		// This should end up calling SetRegVal() and ACK.
		if (msgIn.address!=m_uiDevAddr)
		{
			//std::cout << "ADDRESS " << std::to_string(msg.data) <<"\n";// << std::to_string(uiReply) << '\n';
			msgIn.address = m_uiDevAddr; // used as a flag.
			msgIn.writeRegAddr = msg.data;
		}
		else // Continuing a write.
		{
			//std::cout << "Set " << std::to_string(msgIn.writeRegAddr) << " to " << std::to_string(msg.data) <<"\n";// << std::to_string(uiReply) << '\n';
			SetRegVal(msgIn.writeRegAddr++, msg.data);
		}
		avr_raise_irq(m_pI2CReply, avr_twi_irq_msg(TWI_COND_ACK, msg.address, 1));

	}
	if (msg.cond & TWI_COND_READ)
	{
		//std::cout << "READ " << std::to_string(msgIn.writeRegAddr) <<"\n";
		avr_raise_irq(m_pI2CReply, avr_twi_irq_msg(TWI_COND_READ, m_uiDevAddr, GetRegVal(msgIn.writeRegAddr++)));
	}
}
