vintagepc/MK404/parts/components/MMU2.cpp

/*
	MMU2.cpp - A Missing-materials-unit for MK404

	Copyright 2020 VintagePC <https://github.com/vintagepc/>

 	This file is part of MK404.

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
	You should have received a copy of the GNU General Public License
	along with MK404.  If not, see <http://www.gnu.org/licenses/>.
 */

#include "MMU2.h"
#include "Config.h"
#include "HC595.h"            // for HC595, TMC2130::IRQ::POSITION_OUT, MMU2...
#include "IKeyClient.h"
#include "LED.h"              // for LED
#include "MM_Control_01.h"    // for MM_Control_01
#include "MMUSideband.h"
#include "PinNames.h"         // for Pin::FINDA_PIN
#include "TMC2130.h"          // for TMC2130
#include "gsl-lite.hpp"
#include "uart_pty.h"         // for uart_pty
#include <cstdlib>           // for exit
#include <cstring>
#include <iostream>            // for fprintf, size_t, stderr


// Yes yes, globals are bad. But we don't have any choice because freeglut calls
// don't have parameter void pointers to retain the c++ class pointer. :-/
MMU2 *MMU2::g_pMMU = nullptr;

using Boards::MM_Control_01;

MMU2::MMU2(bool bCreate, bool bSetupSB):IKeyClient(),MM_Control_01(),m_bSidebandEnabled(bSetupSB)
{
	if (g_pMMU)
	{
		std::cerr << "Error: Cannot have multiple MMU instances due to freeglut limitations\n";
		exit(1);
	}
	g_pMMU = this;
	SetBoardName("MMU2");
	if (bCreate)
	{
		CreateBoard(Config::Get().GetFW2(),0, Config::Get().GetGDB2(), 100, Config::Get().GetSecondaryBootloader());
	}
	RegisterKeyHandler('F',"Toggle the FINDA");
	RegisterKeyHandler('A', "Resumes full-auto MMU mode.");
	RegisterActionAndMenu("ToggleFINDA","Toggles the FINDA", ActToggleFINDA);
	RegisterActionAndMenu("SetFINDAAuto", "Returns FINDA operation to automatic", ActSetFINDAAuto);
	RegisterAction("SetFINDA", "Sets FINDA state", ActSetFINDA, {ArgType::Bool});
}

void MMU2::OnKeyPress(const Key& key)
{
	switch (key)
	{
		case 'F':
		{
			std::cout << "FINDA toggled (in manual control)\n";
			m_bAutoFINDA = false;
			ToggleFINDA();
		}
		break;
		case 'A':
		{
			std::cout << "FINDA in Auto control\n";
			m_bAutoFINDA = true;
			//FSensorResumeAuto(); // Also restore IR auto handling.
			break;
		}
	}
}

IScriptable::LineStatus MMU2::ProcessAction(unsigned int iAction, const std::vector<std::string> &vArgs)
{
	switch (iAction)
	{
		case ActToggleFINDA:
			m_bAutoFINDA = false;
			ToggleFINDA();
			return LineStatus::Finished;
		case ActSetFINDA:
		{
			m_bAutoFINDA = false;
			bool bState = std::stoi(vArgs.at(0))!=0;
			if (m_bFINDAManual != bState)
			{
				ToggleFINDA();
			}
			return LineStatus::Finished;
		}
		case ActSetFINDAAuto:
			m_bAutoFINDA = true;
			return LineStatus::Finished;
		default:
			return Board::ProcessAction(iAction, vArgs);
	}
}


const std::string MMU2::GetSerialPort()
{
	return m_UART.GetSlaveName();
}

void MMU2::SetupHardware()
{

	Boards::MM_Control_01::SetupHardware();

	_Init(GetAVR(), this);

	RegisterNotify(RESET,MAKE_C_CALLBACK(MMU2,OnResetIn),this);
	RegisterNotify(PULLEY_IN, MAKE_C_CALLBACK(MMU2,OnPulleyFeedIn),this);
	RegisterNotify(SHIFT_IN, MAKE_C_CALLBACK(MMU2,LEDHandler),this);

	m_Sel.ConnectTo(TMC2130::POSITION_OUT,GetIRQ(SELECTOR_OUT));
	m_Idl.ConnectTo(TMC2130::POSITION_OUT,GetIRQ(IDLER_OUT));
	m_Extr.ConnectTo(TMC2130::POSITION_OUT,GetIRQ(PULLEY_IN));
	m_shift.ConnectTo(HC595::SHIFT_OUT, GetIRQ(SHIFT_IN));

	if (m_bSidebandEnabled)
	{
		SetupSidebandControl();
	}
}


void MMU2::OnResetIn(struct avr_irq_t *irq, uint32_t value)
{
	if (!value && !IsStarted())
	{
		StartAVR();
	}
    else if (irq->value && !value)
	{
        SetResetFlag();
	}
}

void MMU2::ToggleFINDA()
{
		m_bFINDAManual = !m_bFINDAManual;
		std::cout << "FINDA (manual) toggled: " << (m_bFINDAManual?1U:0U) << '\n';
		SetPin(FINDA_PIN, m_bFINDAManual? 1:0);
		RaiseIRQ(FINDA_OUT,m_bFINDAManual? 1 : 0);
}

void MMU2::SetupSidebandControl()
{
	MM_Control_01::SetupSideband();
	RegisterNotify(SB_BYTE_IN, MAKE_C_CALLBACK(MMU2, OnSidebandByteIn), this);
	ConnectTo(SB_FS, m_USideband.GetIRQ(uart_pty::BYTE_IN));
	ConnectFrom(m_USideband.GetIRQ(uart_pty::BYTE_OUT), SB_BYTE_IN);
}

void MMU2::OnSidebandByteIn(struct avr_irq_t * ,uint32_t value)
{
	switch (value)
	{
		case MMUSideband::RESET:
			std::cout << "MMU Received sideband RESET signal\n";
			RaiseIRQ(RESET,1);
			RaiseIRQ(RESET,0);
			break;
		default:
			std::cerr << "Unrecognized sideband control character:" << (char)value << "\n";
			break;
	}
}

void MMU2::OnPulleyFeedIn(struct avr_irq_t * ,uint32_t value)
{
	float posOut;
	std::memcpy(&posOut, &value,4);

	if (m_bAutoFINDA)
	{
   		SetPin(FINDA_PIN, posOut > FINDA_TRIGGER_DISTANCE);
		// Reflect the distance out for IR sensor triggering.
		RaiseIRQ(FEED_DISTANCE, value);
		RaiseIRQ(FINDA_OUT, posOut > FINDA_TRIGGER_DISTANCE);

		if (m_bSidebandEnabled)
		{
			if (m_fLastPosOut < FSENSOR_TRIGGER_DISTANCE && posOut >= FSENSOR_TRIGGER_DISTANCE)
			{
				RaiseIRQ(SB_FS, MMUSideband::FS_AUTO_SET);
			}
			else if (m_fLastPosOut >= FSENSOR_TRIGGER_DISTANCE && posOut < FSENSOR_TRIGGER_DISTANCE)
			{
				RaiseIRQ(SB_FS, MMUSideband::FS_AUTO_CLEAR);
			}
			m_fLastPosOut = posOut;
		}
	}
	else
	{
		SetPin(FINDA_PIN, m_bFINDAManual? 1:0);
		RaiseIRQ(FINDA_OUT,m_bFINDAManual? 1 : 0);
	}

}

void MMU2::LEDHandler(avr_irq_t *, uint32_t value)
{
	uint32_t valOut = 0;
	valOut = (value >>6U) & 0b1111111111U; // Just the LEDs.
	if (GetIRQ(LEDS_OUT)->value != valOut)
	{
		RaiseIRQ(LEDS_OUT,valOut);
	}
}
