vintagepc/MK404/parts/printers/Prusa_MK25SMMU2.cpp

/*
	Prusa_MK25SMMU2.cpp - Printer definition for the Prusa MK25S w/MMU2
	Copyright 2025 VintagePC <https://github.com/vintagepc/>

 	This file is part of MK404.

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
	You should have received a copy of the GNU General Public License
	along with MK404.  If not, see <http://www.gnu.org/licenses/>.
 */


#include "Prusa_MK25SMMU2.h"
#include "BasePeripheral.h"       // for MAKE_C_CALLBACK
#include "GLHelper.h"
#include "IRSensor.h"             // for IRSensor, IRSensor::IRState::IR_AUTO
#include "MK3SGL.h"               // for MK3SGL
#include "PinNames.h"             // for Pin::MMU_HWRESET
#include "SerialPipe.h"           // for SerialPipe
#include "printers/Prusa_MK25S_13.h"  // for Prusa_MK3S
#include "uart_pty.h"             // for uart_pty
#include <GL/glew.h>
#include <cstring>
#include <memory>                 // for unique_ptr

void Prusa_MK25SMMU2::SetupHardware()
{
	Prusa_MK25S_13::SetupHardware();
	m_IR.Set(IRSensor::IR_AUTO);
	avr_irq_register_notify(m_MMU.GetIRQ(MMU2::FEED_DISTANCE), MAKE_C_CALLBACK(Prusa_MK25SMMU2,OnMMUFeed),this);

	// Note we can't directly connect the MMU or you'll get serial flow issues/lost bytes.
	// The serial_pipe thread lets us reuse the UART_PTY code and its internal xon/xoff/buffers
	// rather than having to roll our own internal FIFO. As an added bonus you can tap the ports for debugging.
	m_pipe.reset(new SerialPipe(UART2.GetSlaveName(), m_MMU.GetSerialPort())); //NOLINT suggestion is c++14 and higher
}

void Prusa_MK25SMMU2::OnVisualTypeSet(const std::string &type)
{
	if (type != "none")
	{
		Prusa_MK2_13::OnVisualTypeSet(type);
		// Wire up the additional MMU stuff.

		AddHardware(m_sniffer,'2');
		m_pVis->ConnectFrom(m_sniffer.GetIRQ(GCodeSniffer::CODEVAL_OUT),MK3SGL::TOOL_IN);
		m_pVis->ConnectFrom(m_MMU.GetIRQ(MMU2::SELECTOR_OUT), MK3SGL::SEL_IN);
		m_pVis->ConnectFrom(m_MMU.GetIRQ(MMU2::IDLER_OUT), MK3SGL::IDL_IN);
		m_pVis->ConnectFrom(m_MMU.GetIRQ(MMU2::LEDS_OUT),MK3SGL::MMU_LEDS_IN);
		m_pVis->ConnectFrom(m_MMU.GetIRQ(MMU2::FINDA_OUT),MK3SGL::FINDA_IN);
		m_pVis->ConnectFrom(m_MMU.GetIRQ(MMU2::FEED_DISTANCE), MK3SGL::FEED_IN);
	}
}

std::pair<int,int> Prusa_MK25SMMU2::GetWindowSize()
{
	auto prSize = Prusa_MK25S_13::GetWindowSize();
	prSize.second +=50;
	return prSize;
}

void Prusa_MK25SMMU2::Draw()
{
	glPushMatrix();
		Prusa_MK25S_13::Draw();
		m_MMU.Draw(static_cast<float>(GetWindowSize().second));
		m_gl.OnDraw();

	glPopMatrix();
}

// Helper for MMU IR sensor triggering.
void Prusa_MK25SMMU2::OnMMUFeed(struct avr_irq_t *, uint32_t value)
{
	float fVal;
	std::memcpy(&fVal,&value,4);
	m_IR.Auto_Input(fVal>400.f); // Trigger IR if MMU P pos > 400mm
}

void Prusa_MK25SMMU2::OnAVRReset()
{
	Prusa_MK25S_13::OnAVRReset();
	avr_raise_irq(m_MMU.GetIRQ(MMU2::RESET),0);
}
