vintagepc/MK404/parts/components/uart_pty.h

/*
	uart_pty.h

	Copyright 2012 Michel Pollet <buserror@gmail.com>

	Rewritten 2020 to C++ by VintagePC <https://github.com/vintagepc/>

 	This file is part of MK404.

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
	You should have received a copy of the GNU General Public License
	along with MK404.  If not, see <http://www.gnu.org/licenses/>.
 */


#pragma once

#include "BasePeripheral.h"    // for BasePeripheral, MAKE_C_TIMER_CALLBACK
#include "fifo_declare.h"      // for DECLARE_FIFO, DEFINE_FIFO
#include "sim_avr.h"           // for avr_t
#include "sim_avr_types.h"     // for avr_cycle_count_t
#include "sim_cycle_timers.h"  // for avr_cycle_timer_t
#include "sim_irq.h"           // for avr_irq_t
#include <atomic>
#include <cstddef>            // for size_t
#include <cstdint>            // for uint8_t, uint32_t
#include <mutex>
#include <pthread.h>           // for pthread_t
#include <string>              // for string

extern "C" {
    DECLARE_FIFO(uint8_t,uart_pty_fifo, 512); //NOLINT - complaint in external macro
}

class uart_pty: public BasePeripheral
{

	public:
		#define IRQPAIRS _IRQ(BYTE_IN,"8<uart_pty.in") _IRQ(BYTE_OUT,"8>uart_pty.out")
		#include "IRQHelper.h"

		uart_pty();

		uart_pty(const uart_pty&) = delete;


		// Destructor. Kills the thread, if it was started.
		~uart_pty();

		// Registers with SimAVR
		void Init(avr_t *avr, char uart);

		// Registers a dummy UART PTY that isn't connected to the AVR.
		void Init(avr_t *avr);

		// Actually connects to the UART.
		void Connect(char chrUART);

		// Sets up a PTY but does nothing else.
		void ConnectPTYOnly(const std::string& strLnk);

		// Used to disable XON for PTY-only connections.
		void BypassXON();

		// Resets the newline trap after a printer reset.
		inline void Reset() { m_chrLast = '\n';}

		// Gets the slave name (file). Used by the pipe thread.
		inline const std::string GetSlaveName() { return std::string(static_cast<char*>(pty.slavename)); };

	private:

		// Registers a dummy UART PTY that isn't connected to the AVR.
		void InitPrivate();

		void* Run();
		void OnByteIn(avr_irq_t * irq, uint32_t value);
		void OnXOnIn(avr_irq_t * irq, uint32_t value);
		void OnXOffIn(avr_irq_t * irq, uint32_t value);
		avr_cycle_count_t OnFlushTimer(struct avr_t * avr,avr_cycle_count_t when);
		avr_cycle_timer_t m_fcnFlush = MAKE_C_TIMER_CALLBACK(uart_pty,OnFlushTimer);

		void FlushData();

		pthread_t	m_thread = 0;
		bool		m_bXOn = false;
		std::atomic_bool m_bQuit = {false};

		unsigned char m_chrLast = '\n';

		std::mutex m_lock;

		using uart_pty_port_t = struct{
			unsigned int	tap : 1, crlf : 1;
			int 		s;			// socket we chat on
			char 		slavename[64];
			uart_pty_fifo_t in;
			uart_pty_fifo_t out;
			uint8_t		buffer[512];
			size_t		buffer_len, buffer_done;
		};

		union {
			struct {
				uart_pty_port_t		pty;
				uart_pty_port_t		tap;
			};
			uart_pty_port_t port[2] = {{},{}};
		};


};
