vintagepc/MK404/parts/I2CPeripheral.h

/*
	I2CPeripheral.h - Generalization helper for I2C-based peripherals.
    This header auto-wires the bus and deals with some of the copypasta.
    Currently only supports bit-banged mode as I haven't needed to deal
	with "real" i2c hardware yet.

	Copyright 2020 VintagePC <https://github.com/vintagepc/>

 	This file is part of MK404.

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
	You should have received a copy of the GNU General Public License
	along with MK404.  If not, see <http://www.gnu.org/licenses/>.
 */


#pragma once

#include "BasePeripheral.h"
#include <cstdint>            // for uint8_t, uint32_t, int32_t, uint16_t
#include <sim_avr.h>         // for avr_t
#include <sim_irq.h>         // for avr_irq_t, avr_irq_register_notify

class I2CPeripheral: public BasePeripheral
{
	friend BasePeripheral;

    protected:
		explicit I2CPeripheral(uint8_t uiAddress);
		~I2CPeripheral() = default;

        // Setup for automatic connections.
		// For bitbanged I2C connections, set the two IRQs. They are routed through standard read/write register requests so
		// your derived device doesn't have to care if it is on "real" I2C
        void OnPostInit(avr_t *avr,  avr_irq_t *irqSDA = nullptr, avr_irq_t *irqSCL = nullptr);

		// Override these for read and write operations on your device's registers.
		virtual uint8_t GetRegVal(uint8_t /*uiAddr*/){return 0;}; // pragma: LCOV_EXCL_LINE
		// Return T if success, F if failure. F results in NACK.
		virtual bool SetRegVal(uint8_t /*uiAddr*/, uint32_t /*uiData*/){return false;}; // pragma: LCOV_EXCL_LINE


    private:
		// This is the bitbanged message structure.
		// Native I2C uses one that's not directly compatible.
		using I2CMsg_t = union I2CMsg
		{
			void I2CMsg_t(uint32_t uiRaw = 0){ raw = uiRaw;}; // Convenience constructor
			void I2CMsg_t(const unsigned int &uiMsg, const unsigned &uiAddr, const unsigned &uiData){ raw = uiMsg<<16u | uiAddr << 8u | uiData;}
			uint32_t raw :24;
			uint8_t bytes[3] {0};
			struct {
				uint8_t data;
				uint8_t writeRegAddr;
				uint8_t isAddrRead :1; // Write bit on address. IDK if this is used given msgBits.isWrite.
				uint8_t address :7;
			} __attribute__((__packed__));
		};

		using NativeI2CMsg_t = union NativeI2CMsg {
			void NativeI2CMsg_t(uint32_t uiRaw = 0){ raw = uiRaw;}
			uint32_t raw;
			struct {
				uint8_t :8;
				uint8_t cond :8;
				uint8_t isWrite :1; // Write bit on address. IDK if this is used given msgBits.isWrite.
				uint8_t address :7;
				uint8_t data :8 ;
			} __attribute__((__packed__));
		};

		// I2C transaction handler.
		void _OnI2CTx(avr_irq_t */*irq*/, uint32_t value);

		// Called on a read request of uiReg. You don't need to worry about tracking/incrementing the address on multi-reads.
		bool ProcessByte(const uint8_t &value);
		void _OnSCL(avr_irq_t *irq, uint32_t value);
		void _OnSDA(avr_irq_t */*irq*/, uint32_t value);

		const uint8_t m_uiDevAddr = 0;

		avr_irq_t *m_pSCL = nullptr, *m_pSDA = nullptr;
		uint8_t m_uiByte = 0;

		I2CMsg_t msgIn;

		enum class State
		{
			Idle,
			AddrIn,
			RegIn,
			DataIn
		};

		enum class SCLS
		{
			Idle,
			Reading,
			Writing,
			WaitForWrite,
			WaitForACK
		};

		SCLS m_SCLState = SCLS::Idle;
		State m_state = State::Idle;

		avr_irq_t * m_pI2CReply = nullptr;

		uint8_t m_uiBitCt = 0;
};
