vintagepc/MK404/parts/IScriptable.cpp

/*
	IScriptable.h - Scriptable base interface. Needs to be separate from
	Scriptable because ScriptHost must also be scriptable, but would
	create a cyclic header if it was.
	So ScriptHost will be IScriptable but skips registering itself with itself
	 and needs to do that manually.

	Copyright 2020 VintagePC <https://github.com/vintagepc/>

 	This file is part of MK404.

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
	You should have received a copy of the GNU General Public License
	along with MK404.  If not, see <http://www.gnu.org/licenses/>.
 */

#include "IScriptable.h"

#include <iomanip>
#include <iostream>
#include <map>
#include <string>
#include <vector>

IScriptable::LineStatus IScriptable::IssueLineError(const std::string &msg)
{
	std::cerr << m_strName << "ERROR: " << msg << '\n';
	return LineStatus::Error;
}

IScriptable::LineStatus IScriptable::ProcessAction(unsigned int /*iAction*/, const std::vector<std::string> &/*args*/)
{
	return IssueLineError(" Has registered actions but does not have an action handler!");
}

// Processes the menu callback. By default, will try the script handler for no-arg actions.
// If this is NOT what you want, overload this in your class.
void IScriptable::ProcessMenu(unsigned iAction)
{
	//printf("m_Act: %u\n", (unsigned)m_ActionArgs.count(iAction));
	if (m_ActionArgs.count(iAction)==0 || m_ActionArgs.at(iAction).size()==0) // If no args needed or it wasn't registered, try the script handler.
	{
		auto LSResult = ProcessAction(iAction,{});
		if (LSResult != LineStatus::Error && LSResult != LineStatus::Unhandled)
		{
			return;
		}
	}
	std::cerr << "Programmer error: " << m_strName << " has registered menu items but no valid handler!\n";
}

void IScriptable::SetName(const std::string &strName)
{
	if (m_bRegistered)
	{
		std::cerr << "ERROR: Tried to change a Scriptable object's name after it has already registered.\n";
	}
	else
	{
		m_strName = strName;
	}
}

#ifdef TEST_MODE
IScriptable::LineStatus IScriptable::Test_ProcessActionIF(unsigned int iAction, const std::vector<std::string>& vArgs)
{
	return ProcessAction(iAction, vArgs);
}
#endif

// Prints help text for this Scriptable
void IScriptable::PrintRegisteredActions(bool bMarkdown)
{
	std::cout << (bMarkdown?"### ":"\t") << m_strName << "::\n";
	for (auto &ActID: m_ActionIDs)
	{
		unsigned int ID = ActID.second;
		std::string strArgFmt = ActID.first;
		strArgFmt.push_back('(');
		if (m_ActionArgs[ID].size()>0)
		{
			for (auto &Arg : m_ActionArgs[ID])
			{
				strArgFmt += GetArgTypeNames().at(Arg) + ", ";
			}
			strArgFmt[strArgFmt.size()-2] = ')';
		}
		else
		{
			strArgFmt.push_back(')');
		}
		if (bMarkdown)
		{
			std::cout << " - `" << std::setw(30) << std::left << strArgFmt << "` - `" << m_mHelp.at(ID) << "`\n";
		}
		else
		{
			std::cout << "\t\t" << std::setw(30) << std::left << strArgFmt << m_mHelp.at(ID) << '\n';
		}
	}
}
// Registers a new no-argument Scriptable action with the given function, description, and an ID that will be
// provided in ProcessAction. This lets you set up an internal enum and switch() on actions
// instead of needing to make a string-comparison if-else conditional.
bool IScriptable::RegisterAction(const std::string &strAct, const std::string& strDesc, unsigned int ID)
{
	if (m_ActionIDs.count(strAct)>0)
	{
		std::cerr << "ERROR: Attempted to register duplicate action handler " << m_strName << "::" << strAct;
		return false;
	}
	m_ActionIDs[strAct] = ID;
	m_mHelp[ID] = strDesc;
	m_ActionArgs[ID].clear();
	return true;
}

// Registers a scriptable action Name::strAct(), help description strDesc, internal ID, and a vector of argument types.
// The types are (currently) for display only but the count is used to sanity-check lines before passing them to you in ProcessAction.
void IScriptable::RegisterAction(const std::string &strAct, const std::string& strDesc, unsigned int ID, const std::vector<ArgType>& vTypes)
{
	if (RegisterAction(strAct,strDesc, ID))
	{
		m_ActionArgs[ID] = vTypes;
	}
}

const std::map<ArgType,std::string>& IScriptable::GetArgTypeNames()
{
	static const std::map<ArgType,std::string> m {
		{ArgType::Bool,"bool"},
		{ArgType::Float,"float"},
		{ArgType::Int,"int"},
		{ArgType::String,"string"},
		{ArgType::uint32,"uint32"}
	};
	return m;
}
