vintagepc/MK404/parts/components/EEPROM.cpp

/*
	EEPROM.cpp - helper to persist the AVR eeprom (and let us poke about in its internals...)

	Copyright 2020 VintagePC <https://github.com/vintagepc/>

 	This file is part of MK404

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
	You should have received a copy of the GNU General Public License
	along with MK404  If not, see <http://www.gnu.org/licenses/>.
 */

#include "EEPROM.h"
#include "avr_eeprom.h"  // for avr_eeprom_desc_t, AVR_IOCTL_EEPROM_GET, AVR...
#include "gsl-lite.hpp"
#include "sim_avr.h"     // for avr_t
#include "sim_io.h"      // for avr_ioctl
#include <algorithm>     // for copy, fill, max
#include <cstdlib>      // for malloc, exit, free, size_t
#include <fstream>       // IWYU pragma: keep
#include <iostream>       // for perror, printf, fprintf, stderr

using std::ifstream;
using std::ofstream;

EEPROM::EEPROM():Scriptable("EEPROM")
{
	RegisterAction("Poke","Pokes a value into the EEPROM. Args are (address,value)", ActPoke, {ArgType::Int, ArgType::Int});
	RegisterAction("PeekVerify","Checks and prints the value of (address,expected val)", ActPeekVerify, {ArgType::Int, ArgType::Int});
	RegisterActionAndMenu("Save", "Saves EEPROM contents to disk.", ActSave);
	RegisterActionAndMenu("Clear", "Clears EEPROM to 0xFF", ActClear);
	RegisterActionAndMenu("Load", "Loads the last-used file again", ActLoad);
};
// Loads EEPROM from a file or initializes the file for the first time.
EEPROM::EEPROM(struct avr_t * avr, const std::string &strFile):EEPROM()
{
	Load(avr, strFile);
};

void EEPROM::Load(struct avr_t *avr, const std::string &strFile)
{
	m_strFile = strFile;
	m_pAVR = avr;
	Load();
}

void EEPROM::Load()
{
	m_uiSize = m_pAVR->e2end + 1;

    ifstream fsIn(m_strFile, fsIn.binary | fsIn.ate);
	if (!fsIn.is_open() || fsIn.tellg() < m_pAVR->e2end) {
		std::cerr << "ERROR: Could not open flash file. Flash contents were NOT restored" << '\n';
	}
	else
	{
		std::cout << "Loading " << m_uiSize  <<" bytes of EEPROM\n";
		std::vector<uint8_t> vEE;
		vEE.resize(m_uiSize,0);
		avr_eeprom_desc_t io {.ee= vEE.data(), .offset = 0, .size = m_uiSize};
		fsIn.seekg(fsIn.beg);
		fsIn.read(reinterpret_cast<char*>(vEE.data()), m_uiSize); //NOLINT maybe if fstream supported unsigned chars...
		std::cout << "Read " << fsIn.tellg() << " bytes\n";
		if (fsIn.fail() || fsIn.gcount() != m_uiSize) {
			std::cerr << "Unable to load EEPROM\n";
			exit(1);
		}
		bool bEmpty = true;
		for (auto &b : vEE)
		{
			bEmpty &= b==0;
		}
		if (!bEmpty) // If the file was newly created (all null) this leaves the internal eeprom as full of 0xFFs.
		{
			avr_ioctl(m_pAVR, AVR_IOCTL_EEPROM_SET,&io); //NOLINT- complaint is external macro
		}
	}
	fsIn.close();
}

void EEPROM::Clear()
{
	std::vector<uint8_t> vE;
	vE.resize(m_uiSize,0xFF);
	avr_eeprom_desc_t io {.ee= vE.data(), .offset = 0, .size = m_uiSize};
	avr_ioctl(m_pAVR, AVR_IOCTL_EEPROM_SET,&io); //NOLINT- complaint is external macro
}

void EEPROM::Save()
{
	// Write out the EEPROM contents:
	ofstream fsOut(m_strFile, fsOut.binary | fsOut.out | fsOut.trunc);
	if (!fsOut.is_open())
	{
		std::cerr << "Failed to open EEPROM output file\n";
		return;
	}
	std::vector<uint8_t> vEE;
	vEE.resize(m_uiSize,0);
	avr_eeprom_desc_t io {.ee= vEE.data(), .offset = 0, .size = m_uiSize};
	//NOLINTNEXTLINE - complaint is external macro
	avr_ioctl(m_pAVR,AVR_IOCTL_EEPROM_GET,&io); // Should net a pointer to eeprom[0]
	fsOut.write(reinterpret_cast<char*>(vEE.data()),m_uiSize); //NOLINT maybe if fstream supported unsigned chars...
	std::cout << "Wrote "<< fsOut.tellp() <<" bytes of EEPROM to " << m_strFile <<'\n';
	if (fsOut.tellp() != m_uiSize) {
		std::cerr << "Unable to write EEPROM memory\n";
	}
	fsOut.close();
}

Scriptable::LineStatus EEPROM::ProcessAction(unsigned int uiAct, const std::vector<std::string> &vArgs)
{
	switch (uiAct)
	{
		case ActPoke:
		{
			unsigned int uiAddr = stoi(vArgs.at(0));
			uint8_t uiVal = stoi(vArgs.at(1));
			if (uiAddr>=m_uiSize)
			{
				return IssueLineError(std::string("Address ") + std::to_string(uiAddr) + " is out of range [0," + std::to_string(m_uiSize-1) + "]");
			}
			else
			{
				Poke(uiAddr, uiVal);
				return LineStatus::Finished;
			}
		}
		break;
		case ActPeekVerify:
		{
			unsigned int uiAddr = stoi(vArgs.at(0));
			uint8_t uiVal = stoi(vArgs.at(1));
			if (uiAddr>=m_uiSize)
			{
				return IssueLineError(std::string("Address ") + std::to_string(uiAddr) + " is out of range [0," + std::to_string(m_uiSize-1) + "]");
			}
			else
			{
				auto uiStored = Peek(uiAddr);
				if (uiStored == uiVal)
				{
					return LineStatus::Finished;
				}
				else
				{
					std::cout << "EEPROM Peek mismatch! stored value was: " << std::to_string(uiStored)  << '\n';
					return LineStatus::Timeout;
				}
			}
		}
		break;
		case ActClear:
		{
			Clear();
			return LineStatus::Finished;
		}
		break;
		case ActSave:
		{
			Save();
			return LineStatus::Finished;
		}
		break;
		case ActLoad:
		{
			Load();
			return LineStatus::Finished;
		}
		break;
	}
	return LineStatus::Unhandled;
}


void EEPROM::Poke(uint16_t address, uint8_t value)
{
	avr_eeprom_desc_t io {.ee = &value, .offset = address, .size = 1};
	Expects(address<m_uiSize);
	avr_ioctl(m_pAVR,AVR_IOCTL_EEPROM_SET,&io); //NOLINT - complaint is external macro
}

uint8_t EEPROM::Peek(uint16_t address)
{
	uint8_t uiRet = 0xFF;
	if (m_pAVR != nullptr) {
		avr_eeprom_desc_t io {.ee = &uiRet, .offset = address, .size = 1};
		Expects(address<m_uiSize);
		avr_ioctl(m_pAVR,AVR_IOCTL_EEPROM_GET,&io); //NOLINT - complaint is external macro
	}
	return uiRet;
}
