vintagepc/MK404/parts/components/Thermistor.cpp

/*
	Thermistor.cpp

	Based on thermistor.c (C) 2008-2012 Michel Pollet <buserror@gmail.com>

	Rewritten for C++ in 2020 by VintagePC <https://github.com/vintagepc/>

 	This file is part of MK404.

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
	You should have received a copy of the GNU General Public License
	along with MK404.  If not, see <http://www.gnu.org/licenses/>.
 */

#include "Thermistor.h"
#include "BasePeripheral.h"  // for MAKE_C_CALLBACK
#include "TelemetryHost.h"
#include <algorithm>         // for copy, max
#include <iostream>
#include <iterator>

Thermistor::Thermistor(float fStartTemp):Scriptable("Thermistor"),m_fCurrentTemp(fStartTemp)
{
	RegisterActionAndMenu("Disconnect","Disconnects the thermistor as though it has gone open circuit",Actions::OpenCircuit);
	RegisterActionAndMenu("Short","Short the thermistor out",Actions::Shorted);
	RegisterActionAndMenu("Reconnect","Restores the normal thermistor state",Actions::Connected);
	RegisterAction("Set", "Sets the temperature to the specified value", ActSetTemp, {ArgType::Float});
}


Scriptable::LineStatus Thermistor::ProcessAction(unsigned int iAction, const std::vector<std::string>& vArgs)
{
	switch (iAction)
	{
		case ActSetTemp:
		{
			Set(std::stof(vArgs.at(0)));
			return LineStatus::Finished;
		}
		case Shorted:
		case OpenCircuit:
		case Connected:
		{
			m_eState = static_cast<Actions>(iAction);
			return LineStatus::Finished;
		}
		default:
			return LineStatus::Unhandled;
	}
}

uint32_t Thermistor::OnADCRead(struct avr_irq_t*, uint32_t)
{
	if (m_eState == Shorted)
	{
		return 0;
	}
	else if (m_eState == OpenCircuit)
	{
		return 5000;
	}

	for (auto it = m_vTable.begin(); it!= m_vTable.end(); it++) {
		if (it->second <= m_fCurrentTemp) {
			int16_t tt = it->first;
			/* small linear regression between table samples */
			if (it!=m_vTable.begin() && it->second < m_fCurrentTemp) {
				int16_t d_adc = it->first - std::prev(it)->first;
				float d_temp = it->second - std::prev(it)->second;
				float delta = m_fCurrentTemp - it->second;
				tt = it->first + (d_adc * (delta / d_temp));
			}
			// if (m_adc_mux_number==-1)
			// 	printf("simAVR ADC out value: %u\n",((tt / m_oversampling) * 5000) / 0x3ff);
			uint32_t uiVal = (((tt / m_iOversampling) * 5000) / 0x3ff);
			return uiVal;
		}
	}
	std::cout << static_cast<const char*>(__FUNCTION__) << '(' << std::to_string(GetMuxNumber()) << ") temperature out of range: " << m_fCurrentTemp << '\n';
	return UINT32_MAX;
}

void Thermistor::OnTempIn(struct avr_irq_t *, uint32_t value)
{
	float fv = static_cast<float>(value) / 256.f;
	m_fCurrentTemp = fv;

	RaiseIRQ(TEMP_OUT, value);
}

void Thermistor::Init(struct avr_t * avr, uint8_t uiMux)
{

	_Init(avr, uiMux,this);
	RegisterNotify(TEMP_IN,MAKE_C_CALLBACK(Thermistor,OnTempIn),this);
	std::cout << static_cast<const char*>(__FUNCTION__) << " on ADC " << std::to_string(GetMuxNumber()) << " start temp: " <<m_fCurrentTemp << '\n';

	auto &TH = TelemetryHost::GetHost();
	TH.AddTrace(this, ADC_VALUE_OUT, {TC::ADC,TC::Thermistor}, 16);
	TH.AddTrace(this, TEMP_OUT, {TC::Thermistor,TC::Misc},16);
}

void Thermistor::SetTable(const gsl::span<const int16_t> table, int iOversamp)
{
	m_iOversampling = iOversamp;
	m_vTable.clear();
	for (auto it = table.begin(); it!= table.end(); it+=2)
	{
		m_vTable.push_back(std::make_pair(*it, *std::next(it)));
	}
}

void Thermistor::Set(float fTempC)
{
	uint32_t value = fTempC * 256;
	RaiseIRQ(TEMP_IN,value);
}
