vintagepc/MK404/parts/printers/IPCPrinter.h

/*
	IPCPrinter.h - Printer definition for the IPC dummy printer.
	Copyright 2020 VintagePC <https://github.com/vintagepc/>

 	This file is part of MK404.

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
	You should have received a copy of the GNU General Public License
	along with MK404.  If not, see <http://www.gnu.org/licenses/>.
 */

#pragma once

#include "BasePeripheral.h"
#include "IPCBoard.h"     		// for EinsyRambo
#include "MK3SGL.h"
#include "Printer.h"        // for Printer, Printer::VisualType
#include <array>             // for array
#include <cstdint>          // for uint32_t
#include <memory>            // for unique_ptr
#include <string>            // for string
#include <vector>            // for vector

#if ENABLE_PIPE || ENABLE_MQ || ENABLE_SHMQ
	#define ENABLED_ANY_IPC
#endif

#if ENABLE_SHMQ
extern "C" {
	#include "../../3rdParty/shmemq404/shmemq.h"
}
	#include <gsl-lite.hpp>
#elif ENABLE_MQ
	#include <mqueue.h>
#elif ENABLE_PIPE
	#include <fstream>
#endif
#include <utility>          // for pair

class IPCPrinter : public Boards::IPCBoard, public Printer, public BasePeripheral
{
	public:

		#define IRQPAIRS _IRQ(PINDA_OUT,">pinda.out") _IRQ(BED_OUT,">bed.out") \
			 _IRQ(X_STEP_OUT,"x_step_out") _IRQ(X_POSITION_OUT,">x.out") \
			 _IRQ(Y_STEP_OUT,"y_step_out") _IRQ(Y_POSITION_OUT,">y.out") \
			 _IRQ(Z_STEP_OUT,"z_step_out") _IRQ(Z_POSITION_OUT,">z.out") \
			 _IRQ(E_STEP_OUT,"e_step_out") _IRQ(E_POSITION_OUT,">e.out")
		#include "IRQHelper.h"


		IPCPrinter():IPCBoard(),Printer(){};

		~IPCPrinter() override;

		inline std::pair<int,int> GetWindowSize() override
		{
			auto height = 10*(m_vMotors.size()+1);
			return {125, height};
		}
		void OnVisualTypeSet(const std::string &type) override;

		void Draw() override;

		virtual inline bool GetHasMMU() {return false;}


	protected:
		void SetupHardware() override;

#ifdef ENABLE_ANY_IPC
		void OnAVRCycle() override;
		void UpdateMotor();
		void UpdateIndicator();
#endif

		std::unique_ptr<MK3SGL> m_pVis {nullptr};


#if ENABLE_SHMQ
		shmemq_t *m_queue = nullptr;
		shm404_msg_t _m_msg {0};
		gsl::span<char> m_msg {_m_msg};
		uint16_t m_len = 0;
#elif ENABLE_MQ
		mqd_t m_queue;
		struct mq_attr m_qAttr;
#elif ENABLE_PIPE
		std::ifstream m_ifIn;
		//void AddPart(const std::string& strIn);
#endif

		std::vector<unsigned int> m_vStepIRQs, m_vIndIRQs;

		std::array<uint32_t,4> m_vStepsPerMM = {{100,100,400,280}};


};
