vintagepc/MK404/parts/components/HC595.cpp

/*
	HC595.h - a shift register for the MMU.

	Original SPI portion Copyright 2008, 2009 Michel Pollet <buserror@gmail.com>

	Rewritten for C++ and a bitbanged connection in 2020, VintagePC <https://github.com/vintagepc/>

 	This file is part of MK404.

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
	You should have received a copy of the GNU General Public License
	along with MK404.  If not, see <http://www.gnu.org/licenses/>.
 */

#include "HC595.h"
#include "TelemetryHost.h"
#include <algorithm>        // for copy

/*
 * called when a SPI byte is sent
 */
// pragma: LCOV_EXCL_START -- Not used currently.
void HC595::OnSPIIn(struct avr_irq_t*, uint32_t value)
{
	// send "old value" to any chained one..
	RaiseIRQ(SPI_BYTE_OUT,m_uiValue);
	m_uiValue = m_uiValue<<8U | (value & 0xFFU);
}
// pragma: LCOV_EXCL_STOP

void HC595::OnDataIn(struct avr_irq_t*, uint32_t value)
{
	m_uiCurBit = value&1U;
}

void HC595::OnClockIn(struct avr_irq_t * irq, uint32_t value)
{
	if (irq->value && !value)
	{
		m_uiValue = m_uiValue<<1U | (m_uiCurBit);
	}
}

/*
 * called when a LATCH signal is sent
 */
void HC595::OnLatchIn(struct avr_irq_t * irq, uint32_t value)
{
	if (!irq->value && value)
	{	// rising edge
		uint32_t uiChanged = m_uiLatch ^ m_uiValue; // Grab the bits that have changed since last latch.
		m_uiLatch = m_uiValue;
		RaiseIRQ(SHIFT_OUT, m_uiLatch);
		for (unsigned int i=0; i<32; i++)
		{
			if (uiChanged & (1U<<i)) RaiseIRQ(BIT0+i,(m_uiLatch>>i) & 1U);
		}
	}
}

/*
 * called when a RESET signal is sent
 */
void HC595::OnResetIn(struct avr_irq_t * irq, uint32_t value)
{
	if (irq->value && !value) 	// falling edge
	{
		m_uiLatch = m_uiValue = 0;
		RaiseIRQ(SHIFT_OUT, m_uiLatch);
		for (int i=0; i<32; i++)
		{
				RaiseIRQ(BIT0+i,0);
		}
	}
}

void HC595::Init(struct avr_t * avr)
{
	_Init(avr, this);
	RegisterNotify(SPI_BYTE_IN, MAKE_C_CALLBACK(HC595,OnSPIIn), 	this);
	RegisterNotify(IN_LATCH, 	MAKE_C_CALLBACK(HC595,OnLatchIn), 	this);
	RegisterNotify(IN_RESET, 	MAKE_C_CALLBACK(HC595,OnResetIn), 	this);
	RegisterNotify(IN_CLOCK, 	MAKE_C_CALLBACK(HC595,OnClockIn), 	this);
	RegisterNotify(IN_DATA, 	MAKE_C_CALLBACK(HC595,OnDataIn), 	this);

	auto &TH = TelemetryHost::GetHost();
	TH.AddTrace(this, IN_LATCH,{TC::OutputPin, TC::Misc});
	TH.AddTrace(this, IN_RESET,{TC::OutputPin, TC::Misc});
	TH.AddTrace(this, IN_CLOCK,{TC::OutputPin, TC::Misc});
	TH.AddTrace(this, IN_DATA,{TC::OutputPin, TC::Misc});
	TH.AddTrace(this, SHIFT_OUT,{TC::Misc},32);
}
