vintagepc/MK404/parts/components/GLIndicator.cpp

/*
	GLIndicator.h - Simple GLIndicator visualizer.

	Copyright 2020 VintagePC <https://github.com/vintagepc/>

 	This file is part of MK404.

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
	You should have received a copy of the GNU General Public License
	along with MK404.  If not, see <http://www.gnu.org/licenses/>.
 */


#include "GLIndicator.h"
#include <GL/freeglut_std.h>          // for glutStrokeCharacter, GLUT_STROKE_MONO_R...
#if defined(__APPLE__)
# include <OpenGL/gl.h>       // for glVertex2f, glBegin, glColor3f, glEnd
#else
# include <GL/gl.h>           // for glVertex2f, glBegin, glColor3f, glEnd
#endif

GLIndicator::GLIndicator(char chrLabel, bool bInvert, bool bBlack):m_chrLabel(chrLabel),m_bInvert(bInvert),m_bBlackBG(bBlack)
{
	m_uiBrightness = 255*bInvert;
}

GLIndicator::GLIndicator(bool bInterp, char chrLabel):m_chrLabel(chrLabel),m_bInterp(bInterp)
{
	m_bInvert = true;
	m_uiBrightness = 255;
}

constexpr Color3fv GLIndicator::m_colColdTemp;
constexpr Color3fv GLIndicator::m_colHotTemp;

void GLIndicator::Draw()
{
	if (!m_bVisible)
	{
		return;
	}
	uint16_t uiBrt = m_uiBrightness;
	if (!m_bBlackBG)
	{
		uiBrt = ((uiBrt*9)/10)+25;
	}
	bool m_bOn = m_uiBrightness>0;
    glPushMatrix();
		if (m_bInterp)
		{
			Color3fv colFill;
			colorLerp(m_colColdTemp, m_colHotTemp, static_cast<float>(m_uiLerpVal.load())/255.F, colFill);
			glColor3fv(static_cast<float*>(colFill));
		}
        else if (m_bOn || m_bBlackBG)
		{
            glColor3us(m_Color.red*uiBrt, m_Color.green*uiBrt, m_Color.blue*uiBrt);
		}
        else
		{
            glColor3ub(m_Color.red/10, m_Color.green/10, m_Color.blue/10);
		}

        glBegin(GL_QUADS);
            glVertex2f(0,10);
            glVertex2f(20,10);
            glVertex2f(20,0);
            glVertex2f(0,0);
        glEnd();
		bool bWhite = m_uiBrightness<128;
        glColor3f(bWhite,bWhite,bWhite);
        glTranslatef(4,7,-1);
        glScalef(0.1,-0.05,1);
		glPushMatrix();
			auto uiRot = m_uiRot.load();
			if (uiRot)
			{
				glTranslatef(50,50,0);
				glRotatef(m_uiRot,0,0,-1);
				glTranslatef(-50,-50,0);
			}
			glPushMatrix();
				glutStrokeCharacter(GLUT_STROKE_MONO_ROMAN,m_chrLabel);
			glPopMatrix();
			if (m_bDisabled)
			{
				glutStrokeCharacter(GLUT_STROKE_MONO_ROMAN,'X');
			}
		glPopMatrix();
    glPopMatrix();
}

void GLIndicator::SetValue(uint8_t value) {
	if (m_bInvert)
	{
		m_uiBrightness = 255U-value;
	}
	else
	{
		m_uiBrightness = value;
	}
}
