vintagepc/MK404/parts/printers/Prusa_MK2MMU_13.cpp

/*
	Prusa_MK25_13.cpp - Printer definition for the Prusa MK2.5 (mR1.3)
	Copyright 2020 VintagePC <https://github.com/vintagepc/>

 	This file is part of MK404.

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
	You should have received a copy of the GNU General Public License
	along with MK404.  If not, see <http://www.gnu.org/licenses/>.
 */

#include "Prusa_MK2MMU_13.h"
#include "A4982.h"
#include "MMU1.h"                   // for MMU1, MMU1::IRQ::MUX0, MMU1::IRQ:...
#include "PinNames.h"               // for Pin::E_MUX0_PIN, Pin::E_MUX1_PIN
#include "printers/Prusa_MK2_13.h"  // for Prusa_MK2_13
#include "sim_irq.h"


void Prusa_MK2MMU_13::SetupHardware()
{
	Prusa_MK2_13::SetupHardware();

	AddHardware(m_mmu);
	TryConnect(E_MUX0_PIN, &m_mmu, MMU1::MUX0);
	TryConnect(E_MUX1_PIN, &m_mmu, MMU1::MUX1);
	TryConnect(E0_STEP_PIN, &m_mmu, MMU1::STEP_IN);

	// Disconnect EN from E0
	avr_unconnect_irq(GetDIRQ(E0_STEP_PIN),E.GetIRQ(A4982::STEP_IN));

	E.GetConfig().bInverted = true;
	E.ConnectFrom(m_mmu.GetIRQ(MMU1::STEP0), A4982::STEP_IN);

	E1.GetConfig().bHasNoEndStops = true;
	AddHardware(E1);
	TryConnect(E0_DIR_PIN, 		&E1, A4982::DIR_IN);
	E1.ConnectFrom(m_mmu.GetIRQ(MMU1::STEP1), A4982::STEP_IN);
	TryConnect(E0_ENABLE_PIN,	&E1, A4982::ENABLE_IN);
	TryConnect(E0_MS1_PIN, 		&E1, A4982::MS1_IN);
	TryConnect(E0_MS2_PIN, 		&E1, A4982::MS2_IN);

	E2.GetConfig().bHasNoEndStops = true;
	E2.GetConfig().bInverted = true;
	AddHardware(E2);
	TryConnect(E0_DIR_PIN, 		&E2, A4982::DIR_IN);
	E2.ConnectFrom(m_mmu.GetIRQ(MMU1::STEP2), A4982::STEP_IN);
	TryConnect(E0_ENABLE_PIN,	&E2, A4982::ENABLE_IN);
	TryConnect(E0_MS1_PIN, 		&E2, A4982::MS1_IN);
	TryConnect(E0_MS2_PIN, 		&E2, A4982::MS2_IN);


	E3.GetConfig().bHasNoEndStops = true;
	AddHardware(E3);
	TryConnect(E0_DIR_PIN, 		&E3, A4982::DIR_IN);
	E3.ConnectFrom(m_mmu.GetIRQ(MMU1::STEP3), A4982::STEP_IN);
	TryConnect(E0_ENABLE_PIN,	&E3, A4982::ENABLE_IN);
	TryConnect(E0_MS1_PIN, 		&E3, A4982::MS1_IN);
	TryConnect(E0_MS2_PIN, 		&E3, A4982::MS2_IN);
}
