vintagepc/MK404/parts/wiring/miniRAMBo_1_1b.h

 /*
	miniRAMBo_1_1b.h - Pin definition for an Ultimachine miniRAMBo 1.1b
	Copyright 2020 VintagePC <https://github.com/vintagepc/>

 	This file is part of MK404.

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
	Based on:
	https://github.com/prusa3d/Prusa-Firmware/blob/MK3/Firmware/pins_Rambo_1_0.h

    Version 0.1     15 Aug 2020     3d-gussner

    Change log:
    15 Aug 2020     3d-gussner      Init
*/
#pragma once

#include "PinSpec_2560.h"
#include "Wiring.h"

namespace Wirings
{
	class miniRAMBo_1_1b : public Wiring
	{
		public:
			miniRAMBo_1_1b():Wiring(m_miniRAMBoPins)
			{
				m_mPins = GetPinMap();
			};

		protected:
			std::map<Pin,MCUPin> GetPinMap()
			{
				return {
					{BEEPER,78},
					{BTN_EN1,80},
					{BTN_EN2,73},
					{BTN_ENC,21},
					{E0_DIR_PIN,43},
					{E0_ENABLE_PIN,26},
					{E0_STEP_PIN,34},
					{E0_MS1_PIN,65},
					{E0_MS2_PIN,66},
					{E0_FAN,8},
					{FAN_PIN,6}, 				// Print fan
					{HEATER_0_PIN,3},
					{HEATER_BED_PIN,4},
					{KILL_PIN,32},
					{LCD_PINS_D4,14},
					{LCD_PINS_D5,15},
					{LCD_PINS_D6,32},
					{LCD_PINS_D7,31},
					{LCD_PINS_ENABLE,5},
					{LCD_PINS_RS,38},
					{LED_PIN,13},
					{SDCARDDETECT,72},
					{SDSS,53},
					{SWI2C_SCL,84},
					{SWI2C_SDA,20},				//IR_SENSOR_PIN on MK2.5S
					{IR_SENSOR_PIN,20},
					{TEMP_0_PIN,0},
					{TEMP_1_PIN,1},				//TEMP_PINDA_PIN for MK2.5+MK2.5S
					{TEMP_PINDA_PIN,1},
					{TEMP_AMBIENT_PIN,6},
					{TEMP_BED_PIN,2},
					{X_DIR_PIN,48},
					{X_ENABLE_PIN,29},
					{X_MIN_PIN,12},
					{X_MAX_PIN,30},				//TACH_0 for MK2.5+MK2.5S
					{X_STEP_PIN,37},
					{X_MS1_PIN,40},
					{X_MS2_PIN,41},
					{Y_DIR_PIN,49},
					{Y_ENABLE_PIN,28},
					{Y_MIN_PIN,11},
					{Y_MAX_PIN,24},
					{Y_STEP_PIN,36},
					{Y_MS1_PIN,69},
					{Y_MS2_PIN,39},
					{Z_DIR_PIN,47},
					{Z_ENABLE_PIN,27},
					{Z_MIN_PIN,10},
					{Z_MAX_PIN,23},
					{Z_STEP_PIN,35},
					{Z_MS1_PIN,68},
					{Z_MS2_PIN,67},
					{TX2_PIN,17},				//E_MUX0_PIN for MMUv1
					{RX2_PIN,16},				//E_MUX1_PIN for MMUv1
					{E_MUX0_PIN,17},
					{E_MUX1_PIN,16},
					{X_REF_PIN,46},				//MOTOR_CURRENT_PWM_XY_PIN
					{Y_REF_PIN,46},				//MOTOR_CURRENT_PWM_XY_PIN
					{Z_REF_PIN,45},				//MOTOR_CURRENT_PWM_Z_PIN
					{E0_REF_PIN,44}				//MOTOR_CURRENT_PWM_E_PIN
				};
			};
		private:
			const PinSpec_2560 m_miniRAMBoPins = PinSpec_2560();
	};
}; // namespace Wirings
