vintagepc/MK404/scripts/tests/test_TMC2130.c

/*
	atmega88_uart_echo.c

	This test case enables uart RX interupts, does a "printf" and then receive characters
	via the interupt handler until it reaches a \r.

	This tests the uart reception fifo system. It relies on the uart "irq" input and output
	to be wired together (see simavr.c)
 */

#include <avr/io.h>
#include <stdio.h>
#include <avr/interrupt.h>
#include <avr/eeprom.h>
#include <avr/sleep.h>
#include <util/delay.h>

/*
 * This demonstrate how to use the avr_mcu_section.h file
 * The macro adds a section to the ELF file with useful
 * information for the simulator
 */
#include "avr_mcu_section.h"
AVR_MCU(16000000, "atmega2560");
// tell simavr to listen to commands written in this (unused) register
// AVR_MCU_SIMAVR_COMMAND(&GPIOR0);
// AVR_MCU_SIMAVR_CONSOLE(&GPIOR1);

/*
 * This small section tells simavr to generate a VCD trace dump with changes to these
 * registers.
 * Opening it with gtkwave will show you the data being pumped out into the data register
 * UDR0, and the UDRE0 bit being set, then cleared
 */
// const struct avr_mmcu_vcd_trace_t _mytrace[]  _MMCU_ = {
// 	{ AVR_MCU_VCD_SYMBOL("UDR3"), .what = (void*)&UDR3, },
// 	{ AVR_MCU_VCD_SYMBOL("UDRE3"), .mask = (1 << UDRE3), .what = (void*)&UCSR3A, },
// 	{ AVR_MCU_VCD_SYMBOL("GPIOR1"), .what = (void*)&GPIOR1, },
// };
// #ifdef USART3_RX_vect_num	// stupid ubuntu has antique avr-libc
// AVR_MCU_VCD_IRQ(USART3_RX);	// single bit trace
// #endif
// AVR_MCU_VCD_ALL_IRQ();		// also show ALL irqs running

#define PIN(x,y) PORT##x>>y & 1U

volatile uint8_t done = 0;

static int uart_putchar(char c, FILE *stream)
{
	loop_until_bit_is_set(UCSR0A, UDRE0);
	UDR0 = c;
	return 0;
}
static FILE mystdout = FDEV_SETUP_STREAM(uart_putchar, NULL,
                                         _FDEV_SETUP_WRITE);

uint8_t SPI_TX(uint8_t cData){

   SPDR = cData;
   while(!(SPSR & (1<<SPIF)))
      ;
   return SPDR;
}

uint8_t uiStatus;

union  {
	uint32_t raw;
	uint8_t bytes[4];
} reply;

volatile uint8_t print = 0;

void TMCTX(uint8_t uiAddr, unsigned long uiData)
{
	PORTA &= 0xFE;
	reply.raw =0;
	uiStatus = SPI_TX(uiAddr);
	for (unsigned int i=0; i<4; i++)
	{
		uint8_t out = (uiData >> (8U*(3U-i)) & 0xFF);
		out = SPI_TX(out);
		if (print) printf("%02x ",out);
		reply.bytes[3-i] = out;
		//uiReply |= out<<(8U*i);
	}
	PORTA|=1;
}

void step()
{
	PORTA |= 1u<<2;
	_delay_ms(1);
	PORTA&=~(1U<<2);
}

enum IOIN_BITS
{
	BIT_STEP = 0b1,
	BIT_DIR = 0b10,
	BIT_ENA = 0b10000,
};

int main()
{
	stdout = &mystdout;
	sei();

	DDRB = ((1<<DDB2)|(1<<DDB1)); //spi pins on port b MOSI SCK,SS outputs
  	SPCR = ((1<<SPE)|(1<<MSTR)|(1<<SPR0)|(1<<CPOL)|(1<<CPHA));  // SPI enable, Master, f/16
	DDRA = 0b00011101; // TMC control lines.

	printf("READY\n");

	TMCTX(0x6F,0);

	_delay_ms(5);

	TMCTX(0x01,0);

	printf("RP %02x %06lx\n",uiStatus, reply.raw);

	TMCTX(0x6F,0);

	printf("RP %02x %06lx\n",uiStatus, reply.raw);

	TMCTX(0x80,1U<<7U); // DIAG0_stall

	printf("DIAG %02x\n",PINA&0x02);

	TMCTX(0x80,1U<<7U | 1U << 12); // DIAG0_stall && pushpull

	printf("DIAG %02x\n",PINA&0x02);

	for(int i=0; i<160; i++)
	{
		step();
		if (PINA&0x2)
			printf("DIAG ERR\n");
	}

	step();

	printf("DIAGMAX %02x\n",PINA&0x02);

	// Reverse dir:
	PORTA|=(1U<<3);

	for(int i=0; i<320; i++)
	{
		step();
		if (PINA&0x2)
			printf("DIAG ERR\n");
	}

	step();

	printf("DIAGMIN %02x\n",PINA&0x02);

	// try DEDGE
	TMCTX(0x6C|0x80, 0x20000000);

	PORTA&=~(1U<<3);
	for(int i=0; i<160; i++)
	{
		step();
		if (PINA&0x2)
			printf("DIAG ERR\n");
	}

	PORTA |= 1u<<2;
	printf("DIAGDEDGE %02x\n",PINA&0x02);

	// ensure DIAG is cleared by moving off the endstop
	PORTA|=(1U<<3); // rev dir
	PORTA&=~(1U<<2); // step.
	PORTA&=~(1U<<3); // fwd again
	if (PINA&0x2)
			printf("DIAG NOT CLEARED\n");

	// check that DIAG is not raised when disabled
	PORTA|=(1U<<4);
	printf("DISABLED\n");

	for(int i=0; i<10; i++)
	{
		step();
		if (PINA&0x2)
			printf("ERR STEP WHILE DISABLED\n");
	}
	PORTA&=~(1U<<4);
	step();
	printf("DIAGDISABLE %02x\n",PINA&0x02);

	TMCTX(0x80,1U<<7U); // DIAG0_stall, Act low
	printf("DIAG %02x\n",PINA&0x02);

	// transition to standstill should clear DIAG
	_delay_ms(70); // 2^20clk ~ 65ms
	printf("DIAG %02x\n",PINA&0x02);

	// disabling should clear standstill as well
	step(); // trigger DIAG again
	if (PINA&0x2) // ensure it's active
		printf("DIAG ERR\n");
	PORTA|=(1U<<4);
	PORTA&=~(1U<<4);
	printf("DIAG %02x\n",PINA&0x02);

	printf("SCRIPTDIAG\n");
	_delay_ms(5);
	printf("DIAG %02x\n",PINA&0x02);
	_delay_ms(5);
	printf("DIAG %02x\n",PINA&0x02);
	PORTA|=(1U<<3); // rev dir
	step();
	printf("STEP\n");


	TMCTX(0x04, 0);
	TMCTX(0x04, 0);

	printf("IOIN STEP %u\n", (reply.raw & BIT_STEP)>0);

	PORTA |= 1u<<2;
	TMCTX(0x04, 0);
	TMCTX(0x04, 0);

	printf("IOIN STEP %u\n", (reply.raw & BIT_STEP)>0);



	PORTA&=~(3U<<2);
	TMCTX(0x04, 0);
	TMCTX(0x04, 0);
	printf("IOIN STEP %u\n", (reply.raw & BIT_STEP)>0);

	printf("IOIN DIR %u\n", (reply.raw & BIT_DIR)>0);


	PORTA|=(1U<<3);
	TMCTX(0x04, 0);
	TMCTX(0x04, 0);
	printf("IOIN DIR %u\n", (reply.raw & BIT_DIR)>0);

	PORTA&=~(1U<<3);
	PORTA&=~(1U<<4);
	TMCTX(0x04, 0);
	TMCTX(0x04, 0);
	printf("IOIN DIR %u\n", (reply.raw & BIT_DIR)>0);
	printf("IOIN ENA %u\n", (reply.raw & BIT_ENA)>0);

	PORTA|=(1U<<4);

	TMCTX(0x04, 0);
	TMCTX(0x04, 0);
	printf("IOIN ENA %u\n", (reply.raw & BIT_ENA)>0);

	PORTA&=~(1U<<4);

	TMCTX(0x04, 0);
	TMCTX(0x04, 0);
	printf("IOIN ENA %u\n", (reply.raw & BIT_ENA)>0);

	printf("FINISHED\n");

	cli();


	// this quits the simulator, since interupts are off
	// this is a "feature" that allows running tests cases and exit
	sleep_cpu();
}
