vintagepc/MK404/scripts/tests/Internal_tests.cpp

/*
	Einsy.cpp - MK404 printer simulator for the Prusa i3 MK2/3 range.
	Dubbed MK404 as a tribute to their web 404 page. ;-)

	Copyright 2020 VintagePC <https://github.com/vintagepc/>

 	This file is part of MK404.

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
	You should have received a copy of the GNU General Public License
	along with MK404.  If not, see <http://www.gnu.org/licenses/>.
 */

#define CATCH_CONFIG_MAIN
#include "3rdParty/catch2/catch.hpp"
#include "ADC_Buttons.h"
#include "Beeper.h"
#include "Board.h"
#include "EEPROM.h"
#include "Fan.h"
#include "GLHelper.h"
#include "Heater.h"
#include "HD44780.h"
#include "IRSensor.h"
#include "IScriptable.h"
#include "MMU2.h"
#include "MMUSideband.h"
#include "PAT9125.h"
#include "PINDA.h"
#include "SDCard.h"
#include "SerialLineMonitor.h"
#include "Test_Board.h"
#include "Thermistor.h"
#include "TMC2130.h"
#include "VoltageSrc.h"
#include "w25x20cl.h"
#include "Color.h"

#ifndef TEST_MODE
	#error "Internal_Tests requires TEST_MODE defined to access protected interface functions."
#endif

static constexpr unsigned int ACT_MAX = -1;

#define _INTERNAL_CASE(x,y) TEST_CASE(#x#y)

#define INTERNAL_CASE(name) _INTERNAL_CASE(Internal_Unhandled_,name)

using LineStatus = IScriptable::LineStatus;

#define UNHANDLED_TEST(object) INTERNAL_CASE(object) \
	{ \
		object o; \
		REQUIRE(o.Test_ProcessActionIF(ACT_MAX,{}) == LineStatus::Unhandled); \
	}

#define UNHANDLED_TEST_A(object, ...) INTERNAL_CASE(object) \
	{ \
		object o(__VA_ARGS__); \
		REQUIRE(o.Test_ProcessActionIF(ACT_MAX,{}) == LineStatus::Unhandled); \
	}


UNHANDLED_TEST_A(ADC_Buttons, "");
UNHANDLED_TEST(Beeper);
UNHANDLED_TEST(Boards::Test_Board);
UNHANDLED_TEST(EEPROM);
UNHANDLED_TEST_A(Fan,1000,'F');
UNHANDLED_TEST(GLHelper);
UNHANDLED_TEST(HD44780);
UNHANDLED_TEST_A(Heater, 1.F, 25.F, false, 'H', 30.F, 35.F)
UNHANDLED_TEST(IRSensor);
UNHANDLED_TEST(PAT9125);
UNHANDLED_TEST(PINDA);
UNHANDLED_TEST(SDCard);
UNHANDLED_TEST_A(SerialLineMonitor,"SLM");
UNHANDLED_TEST(Thermistor);
UNHANDLED_TEST_A(TMC2130, 'X');
UNHANDLED_TEST(VoltageSrc);
UNHANDLED_TEST(w25x20cl);

void Test_IRSensor_OOR() {
	IRSensor o;
	REQUIRE(o.Test_ProcessActionIF(IRSensor::ActSet, {std::to_string(IRSensor::IRState::IR_MIN)}) == LineStatus::Error);
	REQUIRE(o.Test_ProcessActionIF(IRSensor::ActSet, {std::to_string(IRSensor::IRState::IR_MIN -1)}) == LineStatus::Error);
	REQUIRE(o.Test_ProcessActionIF(IRSensor::ActSet, {std::to_string(IRSensor::IRState::IR_MAX +1)}) == LineStatus::Error);
	REQUIRE(o.Test_ProcessActionIF(IRSensor::ActSet, {std::to_string(IRSensor::IRState::IR_MAX)}) == LineStatus::Error);
};

// Out of range tests
TEST_CASE("Internal_IRSensor_OOR") {
	Test_IRSensor_OOR();
}

void Boards::Test_Board_Interface() {
	Boards::Test_Board b;
	REQUIRE(b.TryConnect(nullptr, Pin::INVALID_PIN) == false);
	REQUIRE(b.TryConnect(Pin::INVALID_PIN, nullptr, 0) == false);
	REQUIRE(b.TryConnect(nullptr, 0, Pin::INVALID_PIN) == false);
	REQUIRE(b.GetPWMIRQ(Pin::INVALID_PIN) == nullptr);
	REQUIRE(b.GetDIRQ(Pin::INVALID_PIN) == nullptr);
};

TEST_CASE("Internal_Board_Connect_Errors") {
	Boards::Test_Board_Interface();
}

void Test_HD44780_OOR() {
	HD44780 d;
	REQUIRE(d.Test_ProcessActionIF(HD44780::ActCheckCGRAM, {"A","64"}) == LineStatus::Error);
	REQUIRE(d.Test_ProcessActionIF(HD44780::ActCheckCGRAM, {"128","60"}) == LineStatus::Timeout);
	// Desync also indicates all lines have changed.
	REQUIRE(d.Test_ProcessActionIF(HD44780::ActDesync,{}) == LineStatus::Finished);
	// Line OOR
	REQUIRE(d.Test_ProcessActionIF(HD44780::ActWaitForText, {"A","10"}) == LineStatus::Error);
	REQUIRE(d.Test_ProcessActionIF(HD44780::ActWaitForText, {"A","-2"}) == LineStatus::Error);
};

// Out of range tests
TEST_CASE("Internal_HD44780_OOR") {
	Test_HD44780_OOR();
}

void Test_PAT9125_Toggle() {
	PAT9125 p;
	p.Set(PAT9125::FS_MIN);
	p.Toggle();
	REQUIRE(p.m_state == PAT9125::FS_MIN);
	// Check that writes are blocked to RO:
	auto uiOld = p.GetRegVal(0);
	REQUIRE(p.SetRegVal(0,~uiOld) == false);
	REQUIRE(p.GetRegVal(0) == uiOld);

	REQUIRE(p.Test_ProcessActionIF(PAT9125::ActSet, {std::to_string(PAT9125::FS_MAX)}) == LineStatus::Error);
	REQUIRE(p.Test_ProcessActionIF(PAT9125::ActSet, {std::to_string(PAT9125::FS_MIN)}) == LineStatus::Error);

};

// Out of range tests
TEST_CASE("Internal_PAT9125") {
	Test_PAT9125_Toggle();
}

void Test_PINDA_OOR() {
	PINDA p;
	REQUIRE(p.Test_ProcessActionIF(PINDA::ActSetMBLPoint, {"-1","1.0"}) == LineStatus::Error);
	REQUIRE(p.Test_ProcessActionIF(PINDA::ActSetMBLPoint, {"49","1.0"}) == LineStatus::Error);
	REQUIRE(p.Test_ProcessActionIF(PINDA::ActSetXYCalPont, {"-1","1.0","1.0"}) == LineStatus::Error);
	REQUIRE(p.Test_ProcessActionIF(PINDA::ActSetXYCalPont, {"4","1.0","1.0"}) == LineStatus::Error);
};

// Out of range tests
TEST_CASE("Internal_PINDA_OOR") {
	Test_PINDA_OOR();
}


void Test_w25x20cl_errors() {
	w25x20cl w;
	// Check behaviour for no filename given.
	REQUIRE(w.Test_ProcessActionIF(w25x20cl::ActLoad, {}) == LineStatus::Error);
	REQUIRE(w.Test_ProcessActionIF(w25x20cl::ActSave, {}) == LineStatus::Error);
};

TEST_CASE("Internal_w25x20cl_errors") {
	Test_w25x20cl_errors();
}

void Test_ADCButtons_errors() {
	ADC_Buttons b{"Buttons"};
	REQUIRE(b.Test_ProcessActionIF(ADC_Buttons::ActPress,{"0"}) == LineStatus::Error);
	REQUIRE(b.Test_ProcessActionIF(ADC_Buttons::ActPress,{"4"}) == LineStatus::Error);
}

TEST_CASE("Internal_ADCB_errors") {
	Test_ADCButtons_errors();
}

void Test_EEPROM_errors() {
	EEPROM e;
	// OOR
	REQUIRE(e.Test_ProcessActionIF(EEPROM::ActPoke,{"65535","10"}) == LineStatus::Error);
	REQUIRE(e.Test_ProcessActionIF(EEPROM::ActPeekVerify,{"65535","10"}) == LineStatus::Error);
	// Mismatch of value
	REQUIRE(e.Test_ProcessActionIF(EEPROM::ActPeekVerify,{"0","10"}) == LineStatus::Timeout);
}

TEST_CASE("Internal_EEPROM_errors") {
	Test_EEPROM_errors();
}

void Test_MMU2_internal() {
	MMU2 m(true, true);

	// Exercises some of the feed auto-actions like the FINDA and sideband/fsensor triggers...
	REQUIRE(m.GetIRQ(MMU2::IRQ::FEED_DISTANCE)->value == 0);
	REQUIRE(m.GetIRQ(MMU2::IRQ::FINDA_OUT)->value == 0);
	REQUIRE(m.GetIRQ(MMU2::IRQ::SB_FS)->value != MMUSideband::FS_AUTO_SET);

	float feed_value = MMU2::FINDA_TRIGGER_DISTANCE - 1.f;
	uint32_t value;
	std::memcpy(&value, &feed_value, sizeof(value));

	// Check behaviour shy of trigger
	m.RaiseIRQ(MMU2::IRQ::PULLEY_IN,value);
	REQUIRE(m.GetIRQ(MMU2::IRQ::FEED_DISTANCE)->value == value);
	REQUIRE(m.GetIRQ(MMU2::IRQ::FINDA_OUT)->value == 0);

	// Check finda triggers
	feed_value += 1.1f;
	std::memcpy(&value, &feed_value, sizeof(value));
	m.RaiseIRQ(MMU2::IRQ::PULLEY_IN,value);
	REQUIRE(m.GetIRQ(MMU2::IRQ::FEED_DISTANCE)->value == value);
	REQUIRE(m.GetIRQ(MMU2::IRQ::FINDA_OUT)->value == 1);

	// Check FINDA untriggers
	feed_value -= 1.1f;
	std::memcpy(&value, &feed_value, sizeof(value));
	m.RaiseIRQ(MMU2::IRQ::PULLEY_IN,value);
	REQUIRE(m.m_bAutoFINDA);
	REQUIRE(m.GetIRQ(MMU2::IRQ::FEED_DISTANCE)->value == value);
	REQUIRE(m.GetIRQ(MMU2::IRQ::FINDA_OUT)->value == 0);

	REQUIRE(m.GetIRQ(MMU2::IRQ::SB_FS)->value != MMUSideband::FS_AUTO_SET);

	feed_value = MMU2::FSENSOR_TRIGGER_DISTANCE - 0.1f;
	std::memcpy(&value, &feed_value, sizeof(value));
	m.RaiseIRQ(MMU2::IRQ::PULLEY_IN,value);
	REQUIRE(m.GetIRQ(MMU2::IRQ::FEED_DISTANCE)->value == value);
	REQUIRE(m.GetIRQ(MMU2::IRQ::SB_FS)->value != MMUSideband::FS_AUTO_SET);

	// Check that the sensor signal is set when we cross the threshold...
	feed_value += 0.2f;
	std::memcpy(&value, &feed_value, sizeof(value));
	m.RaiseIRQ(MMU2::IRQ::PULLEY_IN,value);
	REQUIRE(m.GetIRQ(MMU2::IRQ::FEED_DISTANCE)->value == value);
	REQUIRE(m.GetIRQ(MMU2::IRQ::FINDA_OUT)->value == 1);
	REQUIRE(m.GetIRQ(MMU2::IRQ::SB_FS)->value == MMUSideband::FS_AUTO_SET);

	// And cleared when we go back below.
	feed_value -= 0.2f;
	std::memcpy(&value, &feed_value, sizeof(value));
	m.RaiseIRQ(MMU2::IRQ::PULLEY_IN,value);
	REQUIRE(m.GetIRQ(MMU2::IRQ::FEED_DISTANCE)->value == value);
	REQUIRE(m.GetIRQ(MMU2::IRQ::FINDA_OUT)->value == 1);
	REQUIRE(m.GetIRQ(MMU2::IRQ::SB_FS)->value == MMUSideband::FS_AUTO_CLEAR);


	// Check the reset flag:
	REQUIRE(!m.GetResetFlag());

	m.RaiseIRQ(MMU2::IRQ::SB_BYTE_IN, MMUSideband::FS_AUTO_CLEAR); // Try garbage
	REQUIRE(!m.GetResetFlag()); // Should not reset
	m.RaiseIRQ(MMU2::IRQ::SB_BYTE_IN, MMUSideband::RESET); // Try reset character:
	REQUIRE(m.IsStarted()); // First release of reset line starts the CPU...

	m.RaiseIRQ(MMU2::IRQ::SB_BYTE_IN, MMUSideband::RESET); // Try reset character:
	REQUIRE(m.GetResetFlag()); // Second one should have set the flag.

}

TEST_CASE("Internal_MMU2_bridge") {
	Test_MMU2_internal();
}

TEST_CASE("Internal_Colour_conversion") {
	float white[] = {1.F,1.F,1.F};
	float black[] = {0.F,0.F,0.F};
	float red[] = {1.F,0.F,0.F};
	float green[] = {0.F,1.F,0.F};
	float blue[] = {0.F,0.F,1.F};
	float magenta[] = {0.75F,0.F,1.F};
	float magenta2[] = {1.F,0.F,1.F};



	float out[3] {0};

	colorLerp(black, white, 0, out);
	REQUIRE(out[0] == 0.F);
	REQUIRE(out[1] == 0.F);
	REQUIRE(out[2] == 0.F);

	colorLerp(black, white, 1, out);
	REQUIRE(out[0] == 1.F);
	REQUIRE(out[1] == 1.F);
	REQUIRE(out[2] == 1.F);

	colorLerp(black, blue, 0.75, out);
	REQUIRE(out[0] == 0.1875F);
	REQUIRE(out[1] == 0.75F);
	REQUIRE(out[2] == 0.75F);

	colorLerp(black, magenta, 1, out);
	REQUIRE(out[0] == magenta[0]);
	REQUIRE(out[1] == magenta[1]);
	REQUIRE(out[2] == magenta[2]);

	colorLerp(black, magenta2, 1, out);
	REQUIRE(out[0] == 0.F);
	REQUIRE(out[1] == magenta2[1]);
	REQUIRE(out[2] == 0.F);

}
