vintagepc/MK404/utility/GLPrint.cpp

/*
	GLPrint.cpp - Object responsible for print visualization

	Copyright 2020 VintagePC <https://github.com/vintagepc/>

 	This file is part of MK404.

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
	You should have received a copy of the GNU General Public License
	along with MK404.  If not, see <http://www.gnu.org/licenses/>.
 */

#include "Config.h"
#include "Color.h"
#include "GLPrint.h"
#include "PLYExport.h"
#include "gsl-lite.hpp"
#include <GL/glew.h>   // for glMaterialfv, GL_FRONT_AND_BACK, glDisableClie...
#include <algorithm>   // for transform
#include <cmath>		 // IWYU pragma: keep
#include <functional>  // for minus
#include <iostream>
#include <iterator>

static void CrossProduct(const std::array<float, 3>&fA, const std::array<float, 3>&fB, gsl::span<float>fOut)
{
	fOut[0] = (fA[1]*fB[2]) - (fA[2]*fB[1]);
	fOut[1] = (fA[2]*fB[0]) - (fA[0]*fB[2]);
	fOut[2] = (fA[0]*fB[1]) - (fA[1]*fB[0]);
};

static void Normalize(gsl::span<float>fA)
{
	float fNorm = std::sqrt((fA[0]*fA[0]) + (fA[1]*fA[1]) + (fA[2]*fA[2]));
	fA[0]/=fNorm;
	fA[1]/=fNorm;
	fA[2]/=fNorm;
}

GLPrint::GLPrint(float fR, float fG, float fB):m_fColR(fR),m_fColG(fG),m_fColB(fB)
{
	Clear();
	m_iVisType = Config::Get().GetExtrusionMode();
	m_bColExt = Config::Get().GetColourE();
	m_bHRE = m_iVisType == PrintVisualType::QUAD_HIGHRES || m_iVisType == PrintVisualType::TUBE_HIGHRES;
	m_iBaseMode = m_iVisType;
	if (m_bHRE) m_iBaseMode = m_iBaseMode-1;
}

void GLPrint::Clear()
{
	std::lock_guard<std::mutex> lock(m_lock); // Lock out GL while updating vectors
	m_uiExtrStart = m_uiExtrEnd = {{0,0,0,0}};

	// 3x float item vectors
	m_fvDraw.clear(); m_fvDraw.reserve(VectorPrealoc3);
	m_fvTriNorm.clear(); m_fvTriNorm.reserve(VectorPrealoc3);
	m_fvNorms.clear(); m_fvNorms.reserve(VectorPrealoc3);
	m_fvTri.clear(); m_fvTri.reserve(VectorPrealoc3);
	m_vfTriColor.clear(); m_vfTriColor.reserve(VectorPrealoc3);

	// 1x float item vectors
	m_ivStart.clear(); m_ivStart.reserve(VectorPrealoc);
	m_vPath.clear(); m_vPath.reserve(VectorPrealoc);
	m_ivCount.clear(); m_ivCount.reserve(VectorPrealoc);
	m_ivTCount.clear(); m_ivTCount.reserve(VectorPrealoc);
	m_ivTStart.clear(); m_ivTStart.reserve(VectorPrealoc);
	m_bExtruding = false;
	m_bFirst = true;
}

uint32_t GLPrint::GetAdjustedStep(uint32_t uiStep)
{

	auto cyclePos = uiStep%256;
	if (cyclePos<112 || cyclePos > 160) return uiStep;

	if (cyclePos>=144 || cyclePos<=128)
	{
		return uiStep-32; // lag behind 2 microstep;
	}
	else
	{
		return uiStep-64; // Lag 2 microsteps right at the midpoint.
	}

	// switch(uiStep%256)
	// {
	// 	case 0:
	// 	case 1:
	// 	case 2:
	// 	1
	// 	case 15:
	// 	case 16:
	// }
}

void GLPrint::OnEStep(const uint32_t& value, const uint32_t& /*deltaT*/)
{
	uint32_t uiE = m_bNLE ? GetAdjustedStep(value) : value;
	m_uiE = uiE;
	if (m_bFirst) // First cycle/extrusion.
	{
		m_bFirst = false;
		std::lock_guard<std::mutex> lock(m_lock); // Lock out GL while updating vectors
		m_iEMax = uiE;
		m_uiExtrEnd = m_uiExtrStart = {{m_uiX,m_uiZ,m_uiY,m_uiE}};
	}
	// Test if the new coordinate is still collinear with the existing segment.
	// Triangle area method. Slopes have risks of zero/inf/nan for very small deltas.
 	//Ax(By - Cy) + Bx(Cy - Ay) + Cx(Ay - By)
	 // We don't bother with div by 2/abs since we only care if the area is 0.
	int iArea = (m_uiExtrStart[0]* ( m_uiExtrEnd[2] - m_uiY)) + (m_uiExtrEnd[0]*(m_uiY - m_uiExtrStart[2])) + (m_uiX * (m_uiExtrStart[2] - m_uiExtrEnd[2]));

	bool bColinear = iArea == 0;
	bool bSamePos = (m_uiX == m_uiExtrEnd[0]) && (m_uiY == m_uiExtrEnd[2]);
	bool bExtruding; // Extruding if we are > than the highest E value previously observed
	if (m_iVisType == PrintVisualType::LINE)
	{
		bExtruding = (uiE+(m_iStepsPerMM[3]/10))>=(m_iEMax); // the 224 is 0.1mm in steps.
	}
	else
	{
		bExtruding = uiE>=m_iEMax;
	}


	auto idX = m_uiX - m_uiExtrEnd[0];
	auto idY = m_uiY - m_uiExtrEnd[2];
	auto idE = m_uiE - m_uiExtrEnd[3];
	float fDist = std::sqrt(static_cast<float>((idX*idX)+(idY*idY)));
	float fERate = 0;
	if (m_bHRE && fDist > 0)
	{
		fERate = static_cast<float>(idE)/fDist; // This is the extrusion distance to travel distance ratio.
		//std::cout << "fERate:" << std::to_string(fERate) << " dXY:" << std::to_string(fDist) << "dE:" << std::to_string(idE) << '\n';
		if (std::abs(m_fLastERate - fERate)>1e-5) // if dE is changing, mark it as non-colinear to force a segment add.
		{
			bColinear = false;
		}
	}


	if ((bSamePos && !bExtruding) || (bSamePos && (m_uiZ == m_uiExtrEnd[1]))) //SamePos doesn't inculde Z so we don't get inf/zero slopes on hops.
	{
		return;
	}
	if (uiE>m_iEMax)
	{
		m_iEMax = uiE;
	}
	else if (!m_bExtruding && !bExtruding)
	{
		// Just update segment end if we are mid non-extrusion (travel)
		// We don't need to track co-linearity if not extruding.
		bColinear = true;
	}
	const std::array<float, 3> fExtrEnd = {{
		static_cast<float>(m_uiExtrEnd[0])/static_cast<float>(m_iStepsPerMM[0]*1000),
		static_cast<float>(m_uiExtrEnd[1])/static_cast<float>(m_iStepsPerMM[2]*1000),
		static_cast<float>(m_uiExtrEnd[2])/static_cast<float>(m_iStepsPerMM[1]*1000),
		}};
	const std::array<float,3> vfPos =
	{{
		static_cast<float>(m_uiX)/static_cast<float>(m_iStepsPerMM[0]*1000),
		static_cast<float>(m_uiZ)/static_cast<float>(m_iStepsPerMM[2]*1000),
		static_cast<float>(m_uiY)/static_cast<float>(m_iStepsPerMM[1]*1000)
	}};
	if (bExtruding ^ m_bExtruding)
	{
		// Extruding condition has changed. Start a new segment.
		if (bExtruding) // Just started extruding. Update the various pointers.
		{
			//printf("New extrusion %u at index %u\n",m_ivStart.size(),m_ivStart.back());
			// Add a temporary normal vertex
			std::array<float, 3> fCross = {{0,0,0}}, fA = {{0,0,0}}, fB = {{0,-1,0}};
			std::transform(vfPos.begin(), vfPos.end(), fExtrEnd.data(), fA.data(), std::minus<float>());
			CrossProduct(fA,fB,{fCross.data(),3});
			Normalize({fCross.data(),3});
			m_vPath.clear();
			m_fCurZ = vfPos[1];
			if (m_fPrevZ<0)
			{
				m_fPrevZ = m_fCurZ - 0.0002; // first layer height.
			}
			std::lock_guard<std::mutex> lock(m_lock); // Lock out GL while updating vectors
			m_uiExtrStart = m_uiExtrEnd;
			m_ivStart.push_back(m_fvDraw.size()/3); // Index of what we're about to add...
			m_fvDraw.insert(m_fvDraw.end(),fExtrEnd.begin(), fExtrEnd.end());
			m_fvNorms.insert(m_fvNorms.end(), fCross.begin(), fCross.end());

		}
		m_vPath.push_back({m_uiExtrEnd[0], m_uiExtrEnd[2], m_uiExtrEnd[1], std::max(static_cast<uint64_t>(m_uiExtrEnd[3]), m_iEMax)});
		if (!bExtruding)
		{
			{
				std::lock_guard<std::mutex> lock(m_lock);
				m_ivCount.push_back((m_fvDraw.size()/3) - m_ivStart.back());
				m_fCurZ/= m_ivCount.back();
			}
			//printf("Ended extrusion %u (%u vertices)\n", m_ivCount.size(), m_ivCount.back());
			if (m_iVisType>PrintVisualType::LINE)
			{
				if (m_fCurZ>(m_fPrevZ+0.0001))
				{
					m_fZHt = m_fCurZ - m_fPrevZ;
					std::cout << "Est segment Z height: " << m_fZHt*1000.f << '\n';
					m_fPrevZ = m_fCurZ;
				}
				AddSegment();

			}
		}
		m_bExtruding = bExtruding;
	}
	else if (!bColinear)
	{
		// First, update the previous normal with the new vertex info.
		std::array<float, 3> fCross = {{0,0,0}}, fA = {{0,0,0}} ,fB = {{0,-0.002,0}};
		auto itPrev = m_fvNorms.end()-3;
		std::transform(itPrev, itPrev+3, vfPos.data(), fA.data(), std::minus<float>()); // Length from p->curr
		CrossProduct(fA,fB,{fCross.data(),3});
		Normalize({fCross.data(),3});
		auto itCross = fCross.begin();
		for (int i=0; i<3; i++)
		{
			*itPrev += *itCross;
			*itPrev/=2.f;
			itPrev++;
			itCross++;
		}
		// And then append the new temporary end one.
		std::transform(vfPos.begin(), vfPos.end(), fExtrEnd.data(), fA.data(), std::minus<float>());
		CrossProduct(fA,fB,{fCross.data(),3});
		Normalize({fCross.data(),3});
				// New segment, push it onto the vertex list and update the segment count
		//printf("New segment: %d\n",m_vCoords.size());
		m_vPath.push_back({m_uiExtrEnd[0], m_uiExtrEnd[2], m_uiExtrEnd[1], std::max(static_cast<uint64_t>(m_uiExtrEnd[3]), m_iEMax)});
		m_fCurZ+= vfPos[1];
		{
			std::lock_guard<std::mutex> lock(m_lock); // Lock out GL while updating vectors
			m_fvDraw.insert(m_fvDraw.end(),fExtrEnd.begin(), fExtrEnd.end());
			m_fvNorms.insert(m_fvNorms.end(), fCross.begin(), fCross.end());
			m_uiExtrStart = m_uiExtrEnd;
		}


	}
	// Update the end we are tracking.
	m_fLastERate = fERate;
	m_uiExtrEnd[0] = m_uiX;
	m_uiExtrEnd[2] = m_uiY;
	m_uiExtrEnd[1] = m_uiZ;
	m_uiExtrEnd[3] = m_uiE;
	{
		std::lock_guard<std::mutex> lock (m_lock);
		m_fExtrEnd = {{fExtrEnd[0],fExtrEnd[1],fExtrEnd[2]}};
	}

}

// Does the computational geometry and pushes the extrusion:
// NOTE: All math results/positions in mm for sanity; the draw function does a scale by 1/1000.
void GLPrint::AddSegment()
{
	static constexpr float FILAMENT_AREA_COEFF = (.00175f*.00175f)/4.f; // No pi because it factors out later anyway.
	static constexpr float fNarrow[3] = {0,1,1}, fWide[3] = {1,0,0} ;

	const float fLayerZRad = m_fZHt/2; //0.5*layer height. TODO (vintagepc): Sort this out based on guessed z height.

	//std::cout << "Adding segment from: " << extPrev[0] << " " << fZ << " " << fY << " to " << m_fExtrEnd[0] << " " << m_fExtrEnd[1] << " " << m_fExtrEnd[2] << '\n';
	std::array<float, 3> fCross = {{0,0,0}}, fA = {{0,0,0}} ,fB = {{0,-2,0}};

	auto pStart = m_vPath.begin();
	bool bIsSkipping = false;
	for(auto it = m_vPath.begin(); it!=m_vPath.end()-1; it++)
	{
		auto pt = *it;
		if (bIsSkipping)
		{
			pt = *pStart;
		}
		auto ptNext = *std::next(it);
		auto iX = std::get<0>(pt), iY = std::get<1>(pt), iZ = std::get<2>(pt), iE = std::get<3>(pt);
		auto iXN = std::get<0>(ptNext), iYN = std::get<1>(ptNext), iZN = std::get<2>(ptNext), iEN = std::get<3>(ptNext);
		int32_t idE = gsl::narrow<int32_t>(iEN) - iE; // E linear distance.
		if (idE <0)
		{
			continue;
		}
		int32_t dX = gsl::narrow<int32_t>(iXN) - iX;
		int32_t dY = gsl::narrow<int32_t>(iYN) - iY;
		fA[0] = dX;
		fA[2] = dY;
		fA[0]/= static_cast<float>(m_iStepsPerMM[0]*1000);
		fA[2]/= static_cast<float>(m_iStepsPerMM[1]*1000);
		auto fX = static_cast<float>(iX)/static_cast<float>(m_iStepsPerMM[0]*1000);
		auto fXN = static_cast<float>(iXN)/static_cast<float>(m_iStepsPerMM[0]*1000);
		auto fY = static_cast<float>(iY)/static_cast<float>(m_iStepsPerMM[1]*1000);
		auto fYN = static_cast<float>(iYN)/static_cast<float>(m_iStepsPerMM[1]*1000);
		float fZ = (static_cast<float>(iZ)/static_cast<float>(m_iStepsPerMM[2]*1000)) - fLayerZRad;
		float fZN = (static_cast<float>(iZN)/static_cast<float>(m_iStepsPerMM[2]*1000)) - fLayerZRad;

		// Approximate the resulting extrusion width with an ellipse.
		float fdXY = std::sqrt((fA[0]*fA[0])+(fA[2]*fA[2])); // Length of extrusion on print surface.
		if (!m_bHRE && fdXY<0.0004) // Segment length averaging control for non HRE.
		{
			if (!bIsSkipping) pStart = it;
			bIsSkipping = true;
			continue;
		}
		bIsSkipping = false;
		float fExtrVol =  FILAMENT_AREA_COEFF *(static_cast<float>(idE)/static_cast<float>(m_iStepsPerMM[3]*1000));
		float fExtRad = (fExtrVol/(fLayerZRad*fdXY)); // Should give us the XY radius of the extrusion ellipse.
		//std::cout << "Seg: " << fX << " \t" << fY << "\t E:" << idE << "\t R:" << fExtRad << '\n';

		Color3fv colW;
		colorLerp(fNarrow, fWide, fExtRad/0.002, colW);
		CrossProduct(fB,fA,{fCross.data(),3});
		Normalize({fCross.data(),3});
		auto fCrossRev = fCross;
		fCrossRev[0]= -fCross[0];
		fCrossRev[2]= -fCross[2];
		auto iTStart = m_fvTri.size()/3;
		switch (m_iBaseMode)
		{
			case PrintVisualType::TUBE:
			{
				std::lock_guard<std::mutex> lock(m_lock);
				m_fvTri.reserve(m_fvTri.size()+30);
				m_fvTriNorm.reserve(m_fvTri.size());

				m_fvTri.insert(m_fvTri.end(), {fXN+(fCross[0]*fExtRad), fZN, fYN+(fCross[2]*fExtRad)});
				m_fvTriNorm.insert(m_fvTriNorm.end(), fCross.begin(), fCross.end());

				m_fvTri.insert(m_fvTri.end(), {fX+(fCross[0]*fExtRad), fZ, fY+(fCross[2]*fExtRad)});
				m_fvTriNorm.insert(m_fvTriNorm.end(), fCross.begin(), fCross.end());

				m_fvTri.insert(m_fvTri.end(), {fXN, fZN+fLayerZRad, fYN});
				m_fvTriNorm.insert(m_fvTriNorm.end(), {0,1,0});

				m_fvTri.insert(m_fvTri.end(), {fX, fZ+fLayerZRad, fY});
				m_fvTriNorm.insert(m_fvTriNorm.end(), {0,1,0});

				m_fvTri.insert(m_fvTri.end(), {fXN-(fCross[0]*fExtRad), fZN, fYN-(fCross[2]*fExtRad)});
				m_fvTriNorm.insert(m_fvTriNorm.end(), fCrossRev.begin(), fCrossRev.end());

				m_fvTri.insert(m_fvTri.end(), {fX-(fCross[0]*fExtRad), fZ, fY-(fCross[2]*fExtRad)});
				m_fvTriNorm.insert(m_fvTriNorm.end(), fCrossRev.begin(), fCrossRev.end());

				m_fvTri.insert(m_fvTri.end(), {fXN, fZN-fLayerZRad, fYN});
				m_fvTriNorm.insert(m_fvTriNorm.end(), {0,-1,0});

				m_fvTri.insert(m_fvTri.end(), {fX, fZ-fLayerZRad, fY});
				m_fvTriNorm.insert(m_fvTriNorm.end(), {0,-1,0});

				m_fvTri.insert(m_fvTri.end(), {fXN+(fCross[0]*fExtRad), fZN, fYN+(fCross[2]*fExtRad)});
				m_fvTriNorm.insert(m_fvTriNorm.end(), fCross.begin(), fCross.end());

				m_fvTri.insert(m_fvTri.end(), {fX+(fCross[0]*fExtRad), fZ, fY+(fCross[2]*fExtRad)});
				m_fvTriNorm.insert(m_fvTriNorm.end(), fCross.begin(), fCross.end());

				if (m_bColExt)
				{
					m_vfTriColor.reserve(m_fvTri.size());
					for (int i=0; i<10; i++)
					{
						m_vfTriColor.insert(m_vfTriColor.end(), {colW[0], colW[1], colW[2]});
					}
				}

				m_ivTStart.push_back(iTStart);
				m_ivTCount.push_back((m_fvTri.size()/3) - iTStart);
			}
			break;
			case PrintVisualType::QUAD:
			{
				std::lock_guard<std::mutex> lock(m_lock);
				m_fvTri.reserve(m_fvTri.size()+12);
				m_fvTriNorm.reserve(m_fvTri.size());

				m_fvTri.insert(m_fvTri.end(), {fXN+(fCross[0]*fExtRad), fZN, fYN+(fCross[2]*fExtRad)});
				m_fvTriNorm.insert(m_fvTriNorm.end(), fCross.begin(), fCross.end());

				m_fvTri.insert(m_fvTri.end(), {fX+(fCross[0]*fExtRad), fZ, fY+(fCross[2]*fExtRad)});
				m_fvTriNorm.insert(m_fvTriNorm.end(), fCross.begin(), fCross.end());

				m_fvTri.insert(m_fvTri.end(), {fXN-(fCross[0]*fExtRad), fZN, fYN-(fCross[2]*fExtRad)});
				m_fvTriNorm.insert(m_fvTriNorm.end(), fCrossRev.begin(), fCrossRev.end());

				m_fvTri.insert(m_fvTri.end(), {fX-(fCross[0]*fExtRad), fZ, fY-(fCross[2]*fExtRad)});
				m_fvTriNorm.insert(m_fvTriNorm.end(), fCrossRev.begin(), fCrossRev.end());

				if (m_bColExt)
				{
					m_vfTriColor.reserve(m_fvTri.size());
					for (int i=0; i<4; i++)
					{
						m_vfTriColor.insert(m_vfTriColor.end(), {colW[0], colW[1], colW[2]});
					}
				}

				m_ivTStart.push_back(iTStart);
				m_ivTCount.push_back((m_fvTri.size()/3) - iTStart);
			}
		}
	}
}

void GLPrint::Draw()
{
	const std::array<float, 4> fColor = {{m_fColR,m_fColG,m_fColB,1}};
	//std::vector<float> fG[4] = {0,0.5,0,1};
	static const std::array<float, 4> fY = {{1,1,0,1}};
	//static const std::array<float, 4> fK = {0,0,0,1};
	static const std::array<float, 4> fSpec = {{1,1,1,1}};
	glLineWidth(1.0);

	glMaterialfv(GL_FRONT_AND_BACK,GL_SPECULAR,fSpec.data());
	glMaterialf(GL_FRONT_AND_BACK,GL_SHININESS,64);
	glEnableClientState(GL_VERTEX_ARRAY);
	glEnableClientState(GL_NORMAL_ARRAY);
		glMaterialfv(GL_FRONT_AND_BACK,GL_AMBIENT_AND_DIFFUSE,fColor.data());
		{
			std::lock_guard<std::mutex> lock(m_lock);
			if (m_iVisType >= PrintVisualType::LINE)
			{
				glVertexPointer(3, GL_FLOAT, 3*sizeof(float), m_fvTri.data());
				glNormalPointer(GL_FLOAT, 3*sizeof(float), m_fvTriNorm.data());
				if (m_bColExt)
				{
					glEnable(GL_COLOR_MATERIAL);
					glEnableClientState(GL_COLOR_ARRAY);
					glColorPointer(3, GL_FLOAT, 3*sizeof(float), m_vfTriColor.data());
				}
				else
				{
					glColor3fv(fColor.data());
				}
				glMultiDrawArrays(GL_TRIANGLE_STRIP,m_ivTStart.data(),m_ivTCount.data(), m_ivTCount.size());
				if (m_bColExt)
				{
					glDisable(GL_COLOR_MATERIAL);
					glDisableClientState(GL_COLOR_ARRAY);
				}
			}
			glVertexPointer(3, GL_FLOAT, 3*sizeof(float), m_fvDraw.data());
			glNormalPointer(GL_FLOAT, 3*sizeof(float), m_fvNorms.data());
			if (m_iVisType == PrintVisualType::LINE) glMultiDrawArrays(GL_LINE_STRIP,m_ivStart.data(),m_ivCount.data(), m_ivCount.size());


			glMaterialfv(GL_FRONT_AND_BACK,GL_AMBIENT_AND_DIFFUSE,fSpec.data());
			if (m_ivCount.size()>0) // the "In progress" segments
			{
				glDrawArrays(GL_LINE_STRIP,m_ivStart.back(),((m_fvDraw.size()/3)-m_ivStart.back())-1);
			}
			if (m_bExtruding && m_fvDraw.size() >0)
			{
				glMaterialfv(GL_FRONT_AND_BACK,GL_AMBIENT_AND_DIFFUSE,fY.data());
				glBegin(GL_LINES);
					glVertex3fv(&*(m_fvDraw.end()-3));
					glVertex3fv(m_fExtrEnd.data());
				glEnd();
			}
		}
		// Uncomment for vertex debugging.
		 //glMaterialfv(GL_FRONT_AND_BACK,GL_AMBIENT_AND_DIFFUSE,fG);
		// glPointSize(1.0);
		// glDrawArrays(GL_POINTS,0,m_fvDraw.size()/3);
	glDisableClientState(GL_VERTEX_ARRAY);
	glDisableClientState(GL_NORMAL_ARRAY);
	// Normal visualization for debugging, draws the last 10.
	// glBegin(GL_LINES);
	// 	int iStart = 0;
	// 	if (m_fvNorms.size()>30)
	// 		iStart = m_fvNorms.size() - 30;
	// 	for (int i=iStart; i<m_fvNorms.size(); i+=3)
	// 	{
	// 		glVertex3fv(m_fvDraw.data()+i);
	// 		glVertex3fv(m_fvNorms.data()+i);
	// 	}

	// glEnd();
	//glDisable(GL_AUTO_NORMAL);
	//glDisable(GL_NORMALIZE);
}

bool GLPrint::ExportPLY(const std::string& strFN){
    // @vintagepc - this can be improved, probably some incremental naming of saved files etc.
    // Please feel free to incorporate the exporter into the UI as you see fit.
    // I was just looking for the easiest way of calling it.
    return PLYExporter::Export(strFN, m_fvTri, m_fvTriNorm, m_vfTriColor, m_ivTStart, m_ivTCount);
}
