vintagepc/MK404/utility/MK3SGL.h

/*
	MK3SGL.h - Printer visualization for a MK3S, with MMU and print.

	Copyright 2020 VintagePC <https://github.com/vintagepc/>

 	This file is part of MK404.

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
	You should have received a copy of the GNU General Public License
	along with MK404.  If not, see <http://www.gnu.org/licenses/>.
 */
#pragma once

#include "BasePeripheral.h"  // for BasePeripheral
#include "Camera.hpp"        // for Camera
#include "GLHelper.h"
#include "GLObj.h"           // for GLObj
#include "HD44780.h"         // for _IRQ
#include "IKeyClient.h"
#include "IScriptable.h"     // for IScriptable::LineStatus
#include "Scriptable.h"      // for Scriptable
#include "sim_avr.h"         // for avr_t
#include "sim_avr_types.h"
#include "sim_irq.h"         // for avr_irq_t
#include <GL/glew.h>         // NOLINT for glTranslatef
#include <GL/freeglut_std.h> //
#include <GLPrint.h>         // for GLPrint
#include <atomic>            // for atomic, atomic_bool, atomic_int
#include <algorithm>
#include <cstdint>          // for uint32_t
#include <string>            // for string
#include <vector>            // for vector

class HD44780GL;
class OBJCollection;
class Printer;

class MK3SGL: public BasePeripheral, public Scriptable, private IKeyClient
{
    public:
        #define IRQPAIRS    _IRQ(X_IN,"<x.in") _IRQ(Y_IN,"<y.in") _IRQ(Z_IN,"<z.in") \
                            _IRQ(SHEET_IN,"<sheet.in") _IRQ(E_IN, "<e.in") _IRQ(SD_IN,"<SD.in") _IRQ(EFAN_IN,"<EFAN.in") \
                            _IRQ(BED_IN,"<bed.in") _IRQ(PINDA_IN,"<pinda.in") _IRQ(PFAN_IN,"<PFAN.in") _IRQ(SEL_IN,"<Sel.in") \
                            _IRQ(IDL_IN,"<idler.in") _IRQ(MMU_LEDS_IN,"<mmuleds.in") _IRQ(TOOL_IN,"8<TOOL_IN") _IRQ(FINDA_IN,"<finda.in") \
							_IRQ(FEED_IN,"<feed.in") _IRQ(X_STEP_IN,"") _IRQ(Y_STEP_IN,"") _IRQ(Z_STEP_IN,"") _IRQ(E_STEP_IN,"") \
							_IRQ(GENERIC_1,"<generic.1") _IRQ(GENERIC_2,"<generic.2") _IRQ(GENERIC_3,"<generic.3")
        #include "IRQHelper.h"


        // Creates new MK3SGL object, with lite graphics (or full) and an MMU (or not)
        MK3SGL(const std::string &strModel, bool bMMU, Printer *pParent = nullptr);

		~MK3SGL() override
		{
			g_pMK3SGL = nullptr;
			m_pParent = nullptr;
		}

        // IRQ registration helper.
        void Init(avr_t *avr);

        // Draws the visuals within the current GL transformation context.
        void Draw();
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
