vintagepc/MK404/(commit log)

2020-04-10 Add build components for firmware
    [Configuration.h, Configuration_adv.h, Configuration_prusa.h]
2020-04-11 Fix ADC AREF, fix temp calc bug for hotend
2020-04-11 Cleanup the repo a bit (#26), fix #23
    [uart_pty.h]
2020-04-11 Fix encoder state, pulses, reset (#25, #23, #22)
2020-04-11 Wire up the brightness to PWM control
2020-04-11 Define PINDA and ambient temp sensors
2020-04-12 Update Einsy.c
    Remove PWM2 reference as it is not present in the stock SimAVR build.
2020-04-13 Testing submodule setup
    [Configuration.h, Configuration_adv.h, Configuration_prusa.h]
2020-04-13 remove old subfolder
    [Configuration.h, Configuration_adv.h, Configuration_prusa.h]
2020-04-14 Fix timer2 TIMSK for bootloop
2020-04-14 Fans wired in correctly
2020-04-15 w25x20cl: data bus filtering
2020-04-15 #5 - heater hardware implementation
2020-04-16 Crashdetect/DIAG pin working
2020-04-17 TMC endstops triggering, fix some display lag
    [TMC2130.h]
2020-04-18 Barebones TMC simulation w/ endstops.
2020-04-18 Extruder bugfix
2020-04-20 fix function definition, supress printf debugspam.
2020-04-20 Implement voltage readings. (Requires updated simAVR pull)
2020-04-20 Visual for stepper enable/disable
2020-04-23 Fix #45 (bed PWM control)
2020-04-23 Sensor voltage toggle
2020-04-24 Wire up powerpanic again
2020-04-24 UART logger (#78)
2020-04-25 PWM cleanup
2020-04-25 trying to get the motors working
2020-04-25 Add digital wiring for IR sensor
2020-04-26 Cleanup, FINDA LED
2020-04-26 Cleanup IR sensor (Fixes #84)
    [IRSensor.h]
2020-04-26 Wire up IR sensor to MMU feed.
2020-04-29 Fan, additional utility functions, cleanup
2020-04-29 Eeprom rewrite, should also fix #91
    [Einsy.cpp, Einsy_EEPROM.cpp, Einsy_EEPROM.h]
2020-04-29 LED (old one left until MMU is converted to c++)
2020-04-30 TMC2130 (also fixes #93)
    [BasePeripheral.h, Einsy.cpp, TMC2130.cpp, TMC2130.h]
2020-04-30 fix using wrong var for max travel
    [Einsy.cpp, TMC2130.cpp, TMC2130.h]
2020-05-01 Fix a few bugs I introduced
    [Einsy.cpp, HC595.cpp, MMU2.cpp, MMU2.h, TMC2130.cpp, TMC2130.h]
2020-05-02 MMU buttons
2020-05-02 SPI peripheral improvements, xflash conversion
2020-05-03 ADC peripheral cleanup
2020-05-03 a few improvements, bugfixes
    [Einsy.cpp, TMC2130.cpp]
2020-05-03 fixed missing break exposed by SPI changes
    [w25x20cl.cpp]
2020-05-03 Initial UART conversion. Works, needs cleanup
2020-05-04 Remove firmware folder, relocate includes (#96)
    [Configuration.h, Configuration_adv.h, Configuration_prusa.h]
2020-05-05 fixed flash not reading file and dumping contents.
    [w25x20cl.cpp]
2020-05-05 fix fan timer spam
    [Fan.cpp, Fan.h]
2020-05-05 fixed timer registrations
2020-05-10 functional , a few tweaks and bugfixes
    [X_AXIS.obj, Y_AXIS.obj, Z_AXIS.obj]
2020-05-11 Fix missing Temp notify
    [Thermistor.cpp]
2020-05-11 add spinner for E vis
    [Triangles.obj]
2020-05-12 Remove useless "typedef" in c++
    Only the definition is an error (in g++10), but the typedef struct is
    also not needed either since we're clearly in c++ land.
    [Einsy.cpp, TMC2130.h]
2020-05-14 Reset all SPI SS lines to high on reset
    This prevents uninitialized devices to "snoop" on the communication with other devices while they are initialized on firmware startup
    [Einsy.cpp]
2020-05-14 Potential terminate hang fix
    [Einsy.cpp]
2020-05-14 squelch logging
    fix #106
    [w25x20cl.cpp]
2020-05-16 Additional changes needed after fixing #100, some cleanup.
    [ADCPeripheral.h, Einsy.cpp, RotaryEncoder.cpp, RotaryEncoder.h]
2020-05-16 Improve SD behaviour, add and fix indicators
    [Einsy.cpp, LED.cpp, LED.h, TMC2130.cpp]
2020-05-16 Render LCD on LCD, update models, add SD card visual
    [LCD-knobR2.obj, SDCard.obj, Sheet.obj, Triangles.obj, Y_AXIS.obj]
2020-05-16 Sheet fixed, ligthting, MSAA
    [SSSheet.obj, Sheet.obj]
2020-05-16 Fix X
    [E_MMU.obj, E_STD.obj, Triangles.obj]
2020-05-16 Spinning E-fan
    [E_Fan.obj]
2020-05-17 crude heatbed light
2020-05-17 Graceful handling of missing SD image
    [Einsy.cpp]
2020-05-17 pinda, sd wired up
2020-05-17 GL cleanup, fix some errors
    [GLObj.cpp, HD44780GL.cpp, Macros.h]
2020-05-21 Print fan
    [Print-fan_rotor.obj]
2020-05-22 fix PINDA led, evis
    [MK3SGL.cpp]
2020-05-23 Invert PINDA LED behaviour
    [Einsy.cpp, LED.cpp, MK3SGL.cpp]
2020-05-23 tweak Y materials
2020-05-24 crude print visualization (wip)
2020-05-24 Fix reversed factory reset/reset behaviour
    [Einsy.cpp, RotaryEncoder.cpp]
2020-05-25 Fixed filament humidity issues.
    [GLPrint.cpp, GLPrint.h]
2020-05-26 experimenting with colouring, add print clear option
2020-05-27 Mouse input for encoder (Fixes #118)
    [Einsy.cpp, RotaryEncoder.cpp, RotaryEncoder.h]
2020-05-27 Don't load unused models, nozzle cam (fixes #119)
    [Einsy.cpp, GLObj.cpp, GLObj.h, MK3SGL.cpp, MK3SGL.h]
2020-05-28 Update Einsy.cpp
    Missing break
    [Einsy.cpp]
2020-05-28 Fix nozzle cam for fancy mode
    [MK3SGL.cpp]
2020-05-29 Fix #123 (changed to better Arcball control)
    [GLObj.cpp, MK3SGL.cpp, MK3SGL.h]
2020-05-29 Reset camera
2020-06-04 Fix missing return from GetCenteringTransform
    [GLObj.h]
2020-06-04 Add visualization for heaters (bed/hotend)
    Visualize temperature using a color ramp (30-250 for the hotend, 30-100 for the
    bed), show the PWM state using the LED label color.
2020-06-06 Partial - hardware and wiring reorg, board defs. Joined MMU to main Einsy window. (For #117, #49, #95)
2020-06-06 Fix wiring def and pinspecs for einsy
    [Einsy_1_0a.h, Einsy_1_1a.h]
2020-06-07 Cleanup, make flash/eeprom handled in Board
2020-06-08 Tweak to support stock marlin
2020-06-09 Printer factory class
2020-06-09 Fixed printer destruction
2020-06-10 Fix key callback that was removed
    [MK3SGL.cpp, MK3SGL.h, Prusa_MK3S.cpp]
2020-06-11 Multicolor GL prints(#132)
2020-06-11 Fix #137 (serial bridge)
    [Einsy.cpp, PrinterFactory.h]
2020-06-14 Fix '!' display character
    [hd44780_charROM.h]
2020-06-14 Some fan scripting, added auto-increment IDs.
2020-06-14 Thermistor scripting
2020-06-14 button scripting
2020-06-16 TMC stall scripting
2020-06-17 heater scripting, fixed LCD change checking
    [HD44780.cpp, Heater.cpp, Heater.h]
2020-06-18 fixed uninitialized memory issues, added scripts
    [HD44780.cpp, HD44780.h, ScriptHost.cpp, SerialLineMonitor.h, uart_pty.cpp, uart_pty.h, w25x20cl.h]
2020-06-18 fix bug with -b
    [PrinterFactory.h]
2020-06-21 Add soft PWM, fan vis, CTRL-C handling
2020-06-21 Fixed sd card remount bug
    [SDCard.cpp, SDCard.h]
2020-06-21 assorted cleanup, buzzer beginnings
    [BasePeripheral.h, Beeper.cpp, Beeper.h, Einsy.cpp, EinsyRambo.cpp, EinsyRambo.h, Fan.cpp, Fan.h]
2020-06-22 Fixed sound calc error
    [Beeper.cpp, Beeper.h]
2020-06-22 Fixed frequency detection, added mute, scripting
    [Beeper.cpp, Beeper.h, Einsy.cpp, Prusa_MK3S.cpp, SoftPWMable.h]
2020-06-23 fixed a handful of warnings/issues
    [Beeper.cpp, Board.h, Button.cpp, EEPROM.cpp, Einsy.cpp, Fan.cpp, Fan.h, FatImage.cpp]
2020-06-24 LED ctor warn
2020-06-24 fix complaints about unused return values
    [Board.cpp, EEPROM.cpp, FatImage.cpp, SerialPipe.cpp, UART_Logger.cpp, uart_pty.cpp, w25x20cl.cpp]
2020-06-27 PAT9125 framework
2020-06-27 Fixed a memory leak
    [GLObj.h, MK3SGL.h, PrinterFactory.h, Prusa_MK3S.cpp, Prusa_MK3S.h]
2020-06-30 fix beeper if no audio h/w
    [Beeper.cpp, Beeper.h]
2020-06-30 improve trace help output
2020-07-03 add more traces
2020-07-04 Thread safety for GL drawn objects
2020-07-04 more thread safety
2020-07-07 Fix fancy launch
    As the arguments changed it needed a fix.
    ```
    ./MK404 Prusa_MK3SMMU2 --fancy
    PARSE ERROR: Argument: --fancy
    Couldn't find match for argument
    Brief USAGE:
    ./MK404 [--markdown] [-b] [-d] ... [-f <filename>] [-g <none|lite
    |fancy>] [--gdb] [--image-size <128M|1G|256M|2G|32M|512M|64M>]
    [-l] [-m] [-n] [--script <filename.txt>] [--scripthelp] [-s]
    [--sdimage <filename.img>] [-t <string>] ... [--tracerate
    <integer>] [-v] ... [-w] [--] [--version] [-h] <Prusa_MK3
    |Prusa_MK3S|Prusa_MK3SMMU2>
    For complete USAGE and HELP type:
    ./MK404 --help
    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
2020-07-08 fix up glprint threading
    [GLObj.h, GLPrint.cpp, GLPrint.h, MK3SGL.h]
2020-07-14 Replace w25x20cl::m_filepath with std::string
    Fixes a strncpy truncation warning from gcc 10
    [w25x20cl.cpp, w25x20cl.h]
2020-07-14 Fix more warnings
    - Useless return argument qualifiers
    - Deprecated syntesized copy
    - Implicit fallthrough
    [Board.h, FatImage.h, ScriptHost.cpp]
2020-07-15 Fix idler position
2020-07-16 add FINDA LED
2020-07-17 add motor visualizers
2020-07-18 scriptability, set initial sensor state correctly.
    [PAT9125.h, Prusa_MK3.h]
2020-07-18 Move lasersensor to its proper home
2020-07-19 GL error output enabled
    [MK404.cpp, Macros.h]
2020-07-21 fix a few FINDA issues
    [MMU2.cpp, MMU2.h, Prusa_MK3SMMU2.cpp]
2020-07-22 squelch pipe thread message
2020-07-25 Add jam, auto mode
    [PAT9125.h, Prusa_MK3.h, Prusa_MK3MMU2.h, Prusa_MK3S.cpp, Prusa_MK3S.h, Prusa_MK3SMMU2.cpp, Prusa_MK3SMMU2.h]
2020-07-26 fix #122 - IR sensor selectability.
    [Board.h, EinsyRambo.h, IRSensor.cpp, IRSensor.h, IScriptable.h, MK404.cpp, Prusa_MK3S.h, ScriptHost.cpp]
2020-08-02 Add missing key items to menu.
    [Board.h, EinsyRambo.cpp, EinsyRambo.h, MK3SGL.cpp, MK3SGL.h, MK404.cpp, PINDA.cpp, PINDA.h]
2020-08-02 187 bear visual model (#191)
    * Implement a bear 3d model. framework for future #187
    * fix #190, per-face materials.
    [Configuration_prusa.h, E_Fan.obj, E_MMU.obj, E_STD.obj, LCD-knobR2.obj, Print-fan_rotor.obj, SDCard.obj, SSSheet.obj]
2020-08-02 #193 window resizing (#194)
    * primary window handled (#193)
    * Fancy window resize working
    * constrain aspect ratio
    * remove debug output
    * fix window context bug
    [MK3SGL.cpp, MK3SGL.h, MK404.cpp, MMU2.cpp, MMU2.h, Prusa_MK3SMMU2.cpp]
2020-08-02 188 freeglut threading/nVidia GL issues (#197)
    * candidate fix for #188
    * better quit handling
    [MK404.cpp]
2020-08-05 Remove TIMSK hack, sync with simavr, timer fix (#203)
    [EinsyRambo.cpp, MK404.cpp]
2020-08-07 OSX build - thanks to @bozzzzo (#206)
    * Avoid infinite recursion for quaternion *=
    * Include SDL relative to path found by FindSDL
    * use FindOpenGL, FindGLUT, FindGLEW
    * include sys/time.h for timeval
    * Use unsigned instead of linux specific uint
    * IScriptable destructor must be virtual
    * Hack for openpty.
    For a proper fix need to either:
    - rename utils/Util.h to remove the conflict
    - remove utils from include path and change all affected #include statements
    * DECLARE_FIFO and DEFINE_FIFO are not C++
    * Hack: disable glDebugMessageCallback as it coredumps.
    * add missing override
    * OSX clang BUILD_WERROR=0: stop using namespace std
    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
    [Beeper.cpp, Beeper.h, Button.cpp, Fan.cpp, GLObj.cpp, GLObj.h, GLPrint.h, HD44780GL.cpp]
2020-08-09 Fix mmu render (#215)
    * Fix MMU not rendering due to bad draw order
    * A bit of additional cleanup/wiki edits
    * update readme
    * remove stray !
    [Prusa_MK3SMMU2.cpp]
2020-08-13 218 broken visuals (#221)
    * Fix bed LED
    * fix not hiding sheet on standard model
    * increase evis rotation speed
    * fix MMU leds
    * fix #222 - cygwin build
    * fix missing extruder parts.
    * Fix display brightness
    [GLObj.cpp, MK3SGL.cpp, MK3SGL.h, MK3S_Bear.h, MK3S_Full.h, MK3S_Lite.h, OBJCollection.h]
2020-08-24 #225 Automated Tests (#226)
    Add component tests and an automated testing setup with coverage reports
    Fixed a few unpleasant bugs discovered in the process.
    [ADC_Buttons.cpp, ADC_Buttons.h, BasePeripheral.h, Board.h, Button.h, EEPROM.cpp, EEPROM.h, Einsy_1_0a.h]
2020-08-29 More code cleanup (#217)
    * Extensive code cleanup, de-linting and review.
    * Clean clang-tidy build, enabled it.
    * Clean local IWYU build.
2020-08-29 Improve MRES implementation (#228)
    * change MRES to not alter mm positions (#223)
    * fix off-by-one indexing in GLPrint
    [EinsyRambo.cpp, GLPrint.cpp, MMU2.cpp, MM_Control_01.cpp, PINDA.cpp, TMC2130.cpp, TMC2130.h, Test_Board.cpp]
2020-09-11 Fix #234 - serial symlink
    [uart_pty.cpp]
2020-09-13 #230 expand testing (#231)
    * add a GL testing helper
    * add GL test functionality, extensive tests
    * Fix #236
    [Board.h, EinsyRambo.cpp, Fan.cpp, Fan.h, GLHelper.h, HC595.cpp, HC595.h, I2CPeripheral.h]
2020-09-17 #239-Filament presence on startup (#240)
    * #239-Filament presence on startup
    * Update tests
2020-09-19 #238 keyboard control improvement (#241)
    * #238-key-improvements
    * rework tests, cleanup, improve handling
    * Improve doc generation
    [ADC_Buttons.cpp, ADC_Buttons.h, Beeper.cpp, Beeper.h, Board.cpp, Board.h, Button.cpp, Button.h]
2020-09-26 Add miniRambo printers (MK1 and MK2 generation) (#242)
    * miniRAMBo based printers (MK2, MK1 lines) and firmware files
    * Allegro stepper driver
    * MMU v1
    * Component tests
    * .bin files per-printer, don't create 0kb SD files
2020-09-28 #237 - remove all non inline and template code from headers. (#245)
    * fix #237 - remove all non inline and template code from headers.
    * add clean convenience targets (#247)
    [ADCPeripheral.h, Board.cpp, Board.h, EEPROM.cpp, EEPROM.h, FatImage.cpp, FatImage.h, GCodeSniffer.h]
2020-10-01 Fix bed heaters on MK2.5 and SD target names (#254)
    * SD card targets based on printer code files (#249)
    * Fix self-immolating bed on 2.5 series (#252)
    [Heater.h, Prusa_MK25_13.cpp]
2020-10-02 Code Cleanup - Remove templates, add PCH (#255)
    * test de-templating I2C
    * de-template SPIPeripheral
    * add PCH for C STL and 3rdparty
    * cleanup board.h templates
    * expand PCH, disable it if running clang-tidy.
2020-10-06 #114 extrusion visualization take 2 (#244)
    * Work at step resolution
    * enable colour by extrusion width
    * raise FPS cap, keep lines as default extrusion
    * Add averageing for non-highres Evis mode and lines
    * Add a "flat-quad" extrusion vis mode.
    * Add nonlinearity/VFA test print.
    * camera tweak
    * fix a thread violation in the mouse script handler
    [A4982.cpp, Board.h, Config.h, GLPrint.cpp, GLPrint.h, MK3SGL.cpp, MK3SGL.h, MK3S_Lite.h]
2020-10-06 Avoid reallocating vectors with every push_back (#260)
    +avoid using std::vector when not necessary (replace with std::array)
    Constants VectorPrealoc and VectorPrealoc3 serve as initial preallocated
    size of the vectors, may be fine tuned for balanced usage of RAM
    [GLPrint.cpp, GLPrint.h]
2020-10-09 Enable simulation of nonlinear TMC+motor on X,Y,E (#264)
    * Enable simulation of nonlinear TMC+motor on X,Y,Z,E. Can be toggled at runtime.
2020-10-09 #253 - Patch A4982 step-position conversion functions (#267)
    * Patch A4982 step-position conversion functions (#253)
    * Fix test board microstep config.
    [A4982.cpp, Test_Board.cpp]
2020-10-15 Enhance nonlinearity aspects (#270)
    * Fix MBL not affecting 3d print visualization
    * Don't upload coverage reports until all tests complete.
    [GLPrint.cpp, GLPrint.h, MK3SGL.cpp, MK3SGL.h, MK404.cpp]
2020-10-17 #263 klipper support (#274)
    * Fix display E trigger and busy write
    * Add bed SoftPWM to "-n" flag
    * Fix PINDA triggering in klipper
    * Make TMC2130 respect pushpull DIAG config.
    * Tweak heater cooling behaviour
    * Add a clock skew correction option for external interactions that are time-dependent.
    * Add test coverage for TMC DIAG config
    [Board.cpp, Board.h, EinsyRambo.cpp, HD44780.cpp, Heater.cpp, Heater.h, MK404.cpp, PINDA.cpp]
2020-10-18 Fix Z height for MK2.5S
    [Prusa_MK25S_13.cpp, Prusa_MK25S_13.h]
2020-10-18 #246 - Improve LCD, stepper draw routines (#275)
    * Improve LCD, stepper draw routines
2020-10-20 Add option: Export to PLY for HR prints (#276)
    * Add option: Export to PLY for non-line virtual prints
    * Improvements, tests, tweaks
    [AvgT.ply, QuadHR.ply]
2020-10-24 Fix bug with deltaT and the first tick of a print (#278)
    [MK3SGL.cpp]
2020-10-29 #243 - MK2 visuals (#279)
    * MK2x assets and visual code (#243)
    * Visuals for MK2MMU & virtual prints
    [MK2MMU_Base.obj, MK2MMU_E.obj, MK2_Base.obj, MK2_E.obj, MK2_EFan.obj, MK2_Y.obj, MK2_Z.obj]
2020-10-31 #280 - Improve printer graphics tests (#281)
    * Eliminate test idle time for non-boot tests
2020-11-10 Fix IRSensor if ADC isn't running (#283)
    * Fix IRSensor if ADC isn't running
    * Update setup-opengl to v1.1
    [ADCPeripheral.h, IRSensor.cpp, IRSensor.h]
2020-11-11 263 klipper take 2 (#282)
    * Remove display mutex
    * improved timing control
    * Additional handling when in skew mode
2020-11-25 Add UART1 aka RPi port to Einsy and MK3/s (#285)
    * Add UART1 aka RPi port to Einsy and MK3/s + MMU2/s
2021-02-03 Return a flashair IP from the simulated SD (#290)
    * Add support for returning a flashair IP from the SD
    * Add test case to check IP address read.
2021-02-07 Fix #291 Factory reset (#292)
    * Fix #291
    * fix makefile for OSX
    [EinsyRambo.cpp]
2021-02-26 Indicate if axis is stalled (#293)
    * Indicate if axis is stalled
    * Update test images
    [TMC2130.cpp, TMC2130.h]
2021-03-29 Reset SG when writing to GCONF or COOLCONF (#300)
    * Reset SG when writing to GCONF or COOLCONF
    At least on the real TMC2130, SG seems to clear when parameters related
    to SG are updated (GCONF or COOLCONF).
    It is unclear if that's truly the case by the spec, but this seems to
    match the behavior expected by the MK3 FW.
    * Add tests for TMC2130 DIAG clearing behavior
    Instead of checking that the DIAG output gets inverted, check that when
    rewriting the same configuration DIAG is cleared.
    [TMC2130.cpp, test_TMC2130.c]
2021-04-05 TMC2130 DIAG tweaks v2 (#301)
    * Revert "Reset SG when writing to GCONF or COOLCONF (#300)"
    This reverts commit bc56fbaa3c6a7f186be7ab408357823e56b2fc81.
    * Test for "FINISHED" in TMC2130
    This ensures no extra output goes untested
    * TMC2130: handle DIAG correctly when entering STST
    TMC2130 clears DIAG when the overload condition is resolved, not when
    moving off an endstop. This means that when the motor is not moving DIAG
    should be cleared.
    Transition to standstill implies this, so handle this situation by
    adding a couple of helper functions to set/clear DIAG consistently
    and use them when StandStill is detected.
    Add tests to check this condition.
    Also cancel the St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
    [TMC2130.cpp, TMC2130.h, test_TMC2130.c]
2021-04-18 Fix a bug with xflash loads that exceed 64K (#305)
    [Board.cpp, Board.h, EinsyRambo.cpp, EinsyRambo.h, w25x20cl.cpp, w25x20cl.h]
2021-04-18 Color-code stealth mode in the TMC2130 indicator (#306)
    Use a different color ("acid green") for stealth mode, so that we can
    distinguish the driver state.
2021-04-19 298 screenshots lcd (#308)
    * Add key shortcut for LCD snapshot
    [GLHelper.cpp, GLHelper.h, MK3SGL.h]
2021-06-19 Implement #311 - support RO SD images. (#312)
    * Fix #311 - support RO SD images.
    * Add test for RO card in CSD and failure code.
    [SDCard.cpp, SDCard.h, test_SD.c]
2021-06-20 Fix PINDA crash when probing nearby bed margins (#314)
    Clamp probing coordinates to be always inside the mesh.
    This is not correct when probing far away from the bed (PINDA shouldn't
    trigger at all), but for now this will do.
    Fixes #313
    [PINDA.cpp]
2021-06-20 Reduce spamminess of skew-correct's "Lost X us!" messages (#310)
    * Hide skew-correct's "Lost X us!" messages by default
    When enabling skew-correct, the "Lost X us!" messages can overwhelm the
    output. Hide the messages behind the verbosity switch.
    A single -v switch now shows only uncompensated time, which is what
    matters most.
    -vv also shows the existing message as well.
    * Tweak so message prints only once in normal mode
    [Board.cpp, Board.h]
2021-06-27 Update help text to remove outdated info
    Fixes #317
    [MK404.cpp]
2021-07-20 Fix crash if no bootloader given & hex is missing
    [MK404.cpp]
2021-07-21 Suppress GL errorspam in Cygwin
    Closes #318
    [MK404.cpp]
2021-08-10 Cleanup and consolidate IPC, GL objects (#319)
    * Merge IPC work, fix PCH bug
    * Consolidate components with GLIndicator
    * Consolidate motors with GLMotor
    [A4982.cpp, A4982.h, ADC_Buttons.cpp, BasePeripheral.h, Beeper.cpp, Beeper.h, Board.cpp, Board.h]
2021-08-21 Misc fixes (#325)
    * Implement #324
    * Fix SD card state after unmount (Fixes #323)
    [KeyController.cpp, SDCard.cpp]
2021-08-22 321 improved testing (#322)
    * Expand tests to handle boundary/error cases (Closes #321).
    [ADC_Buttons.h, BasePeripheral.h, Beeper.cpp, Board.h, EEPROM.cpp, EEPROM.h, FatImage.cpp, HC595.cpp]
2021-08-24 Implement the TMC2130 IOIN register version (#328)
    The IOIN register contains some read-only state, along with the
    driver version which can be used for IC checking.
    Implement two fields (a fixed one and the version) for this purpose.
    [TMC2130.cpp, TMC2130.h]
2021-08-29 Standalone MMU2 (#326)
    *Standalone MMU2
    * Fix SPI trace for TMC2130
    * Fix HC595 typo in trace name.
    [HC595.h, MK404.cpp, MMU2.cpp, MMU2.h, MM_Control_01.cpp, MM_Control_01.h, PrinterFactory.cpp, Prusa_MMU2.cpp]
2021-10-27 Assorted cleaning (#332)
    * Merge/cleanup USBIP part 1
    * Fix clang-tidy and cleanup errors
    * Cleaning & washing of code
    [74HCT4052.cpp, 74HCT4052.h, Board.cpp, Board.h, Button.cpp, Button.h, CW1S.cpp, CW1S.h]
2021-10-28 Fix terminal/screenshot related bugs (#336)
    * Fix #333 - terminal positioning on scale
    * Fix #335 - GL scaling of hotkey snapshots
    [GLHelper.cpp, MK404.cpp, Prusa_MMU2.cpp]
2021-11-05 More code washing (#337)
    [CW1S_Platform.obj, CW1_HFan.obj, CW1_Knob.obj, CW1_LEDs.obj, CW1_Lid.obj, CW1_RFan.obj, CW1_Tank.obj]
2021-11-25 Fix clang compile errors (#338)
    * Fix clang compile errors
    * Put MAX_USB_ENDPOINST in constant (max usb endpoints is probably 16, which is plenty)
    [I2CPeripheral.cpp, I2CPeripheral.h, TMC2130.h, usbip.c]
2021-11-27 Fix MK2 selftest after an autohome
    [A4982.cpp]
2021-11-27 Fix test broken by endstop tweak
2021-12-06 Support for up/down arrows as lcd control buttons (#348)
    * Support for up/down arrows as lcd control buttons
    * Add arrow keys to scripting and tests
2021-12-06 Update KeyController.cpp
    Fix typo
    [KeyController.cpp]
2022-01-18 Fix heater freeze on power loss/reset (#353)
    [EinsyRambo.cpp, Heater.cpp, Heater.h]
2022-01-25 Fix lack of keys on standalone MMU2 (#354)
    * Fix lack of keys on standalone MMU2
    * Add FINDA control as actions
    [Board.h, MMU2.cpp, MMU2.h, Prusa_MMU2.cpp, Prusa_MMU2.h]
2022-03-04 Always disable UART poll sleep (#357)
2022-04-22 PAT9125 mystery registers (#360)
    * Use more reasonable B/S values for filament presence
    * PAT9125 follow Y axis inversion
    * support extended mystery registers
    * get rid of explicit constructor
    * extend test coverage, lint
    * PAT9125 enable a few more undocumented registers
2022-05-29 Fix #362, suppress 4-bit spam.
    [HD44780.cpp]
2022-06-13 Fix MMU2 qurks (#363)
    * Fix idler travel, add secondary board debug hook
    * Fix bug with inverted motor direction init
    [Config.h, MK404.cpp, MMU2.cpp, MM_Control_01.cpp, TMC2130.cpp]
2022-06-21 Sync with upstream AVR, minor fixes (#365)
    * Fix MMU pulley feed, remove obsolete serial hack
    * Synchronize with upstream simavr
    [MM_Control_01.cpp, Prusa_MK2_13.cpp, Prusa_MK2_13.h, Prusa_MK3S.cpp, Prusa_MK3S.h]
2022-09-10 Fix IR digital not updating if the ADC isn't read (#367)
    [IRSensor.cpp]
2023-08-12 Fix crash when closing LCD window
    [MK404.cpp]
2023-08-13 Fix the deprecated runners (#371)
    * Update images
    * Update workflows
    [MK404.cpp]
2023-10-21 Adjust LCD font to be more "correct" (#373)
    * Adjust LCD font to be more "correct"
    * update test images
    [hd44780_charROM.h]
2024-02-07 Add sideband control PTY for FS and reset lines (#374)
    * Add sideband control PTY for FS and reset lines
    * Add sideband test coverage for MMU2
    [Board.h, Internal_tests.cpp, MMU2.cpp, MMU2.h, MMUSideband.h, MM_Control_01.cpp, MM_Control_01.h, uart_pty.cpp]
2024-11-29 Update simavr submodule (#375)
    * Update simavr submodule
    * Fix clang error
    * libELF fixes
    * fix test bug
    [MK404.cpp, test_w25x20cl.c]
2025-05-31 - Add missing reset handler for MMU2
    [Prusa_MK25SMMU2.cpp, Prusa_MK25SMMU2.h]
2025-06-05 - Fix a few misc issues identified by cppcheck - Suppress false positive
    [HD44780.h, HD44780GL.cpp, HD44780GL.h, IPCPrinter.cpp, Scriptable.cpp, Scriptable.h]
